ngoquytuan/DenDaChien/2019/catalgue DEN DA CHIEN/2.jpg

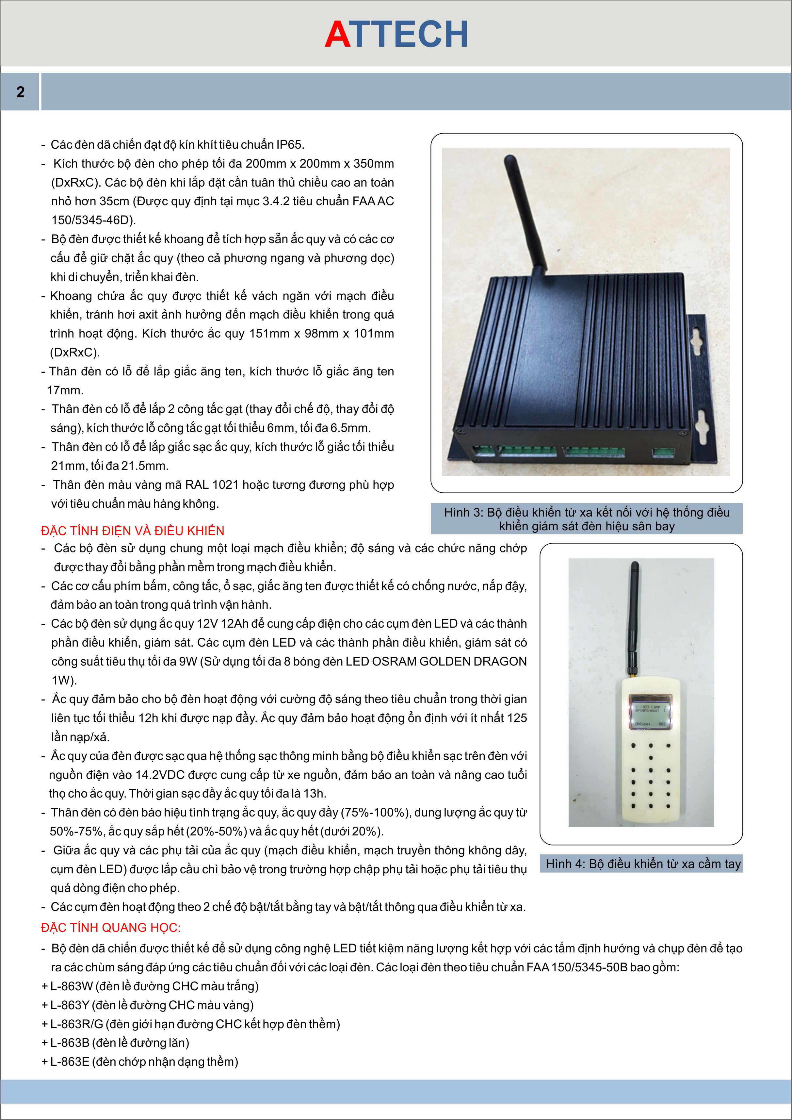
2019/catalgue DEN DA CHIEN/2.jpg
