ngoquytuan/DenDaChien/2019/catalgue DEN DA CHIEN/1.jpg

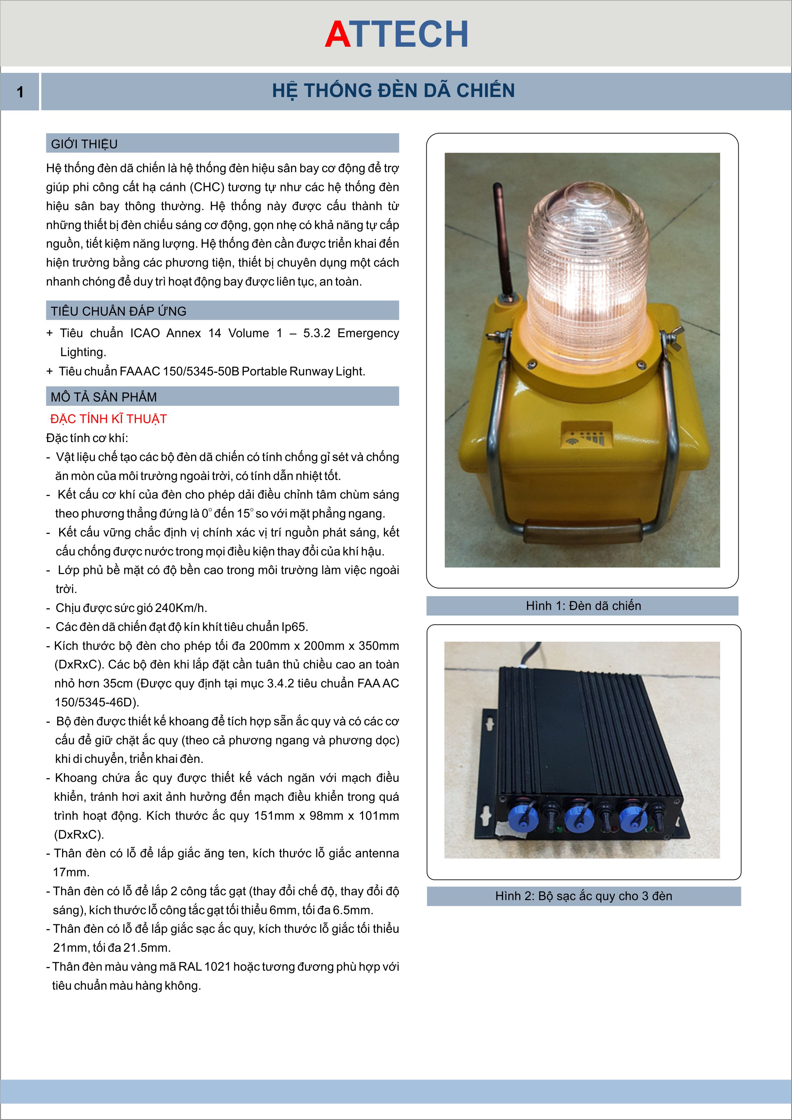
2019/catalgue DEN DA CHIEN/1.jpg
