ngoquytuan/DenDaChien/2019/20May19/BanVeDenDaChien2019 27.03.2019/Co khi/ban ve den da chien, Tien luong/Danh muc ban ve den da chien.docx

STT | Tên bản vẽ cũ | Tên bản vẽ mới | Lý do thay thế | Nội dung thay thế
01 | Đèn CHC (bản vẽ lắp). Mã bản vẽ PL-01-00 | Đèn CHC (bản vẽ lắp). Mã bản vẽ PL-03-00 | Thay đổi phù hợp với điện tử và quang học | Thay đổi chụp kính và điện tử
02 | Đèn CHC (bảng kê). Mã bản vẽ PL-01-00 | Đèn CHC (bảng kê). Mã bản vẽ PL-03-00 | Thay đổi phù hợp với điện tử và quang học | Thay đổi các chi tiết
03 | Tấm đế; gioăng 1; tấm che; bạc. Mã bản vẽ PL-01-01; 03; 09; 11 | Tấm đế; gioăng 1; tấm che; bạc. Mã bản vẽ PL-01-01; PL-01-03; PL-03-12; PL-03-14 | Thay đổi phù hợp với điện tử và cơ khí | Tấm che thay đổi độ dày, bạc thay đổi độ dài phù hợp với tay cầm
04 | Thân. Mã bản vẽ PL-01-02 | Thân. Mã bản vẽ PL-01-02
05 | Nắp. Mã bản vẽ PL-01-04 | Nắp. Mã bản vẽ PL-03-04 | Thay đổi phù hợp với quang học | Thay nắp mới
06 | Mạch báo hiệu. Mã bản vẽ M-01-01 | Mạch báo hiệu. Mã bản vẽ M-01-01
07 | Ống dẫn sáng; Tay cầm; Gioăng 2; Đai kẹp; Bọc tay cầm. . Mã bản vẽ PL-01-05; 06; 07; 10; 12 | Ống dẫn sáng; Tay cầm; Gioăng 2; Đai kẹp; Bọc tay cầm. . Mã bản vẽ PL-03-06; 07; PL-01-05; 13; 16 | Thay đổi phù hợp với quang học và cơ khí | Thay đổi kích thước tay cầm, gioăng 2
08 | Mạch điều khiển. Mã bản vẽ M-02-01 | Mạch điều khiển. Mã bản vẽ M-02-01
09 | | Thân trên. Mã bản vẽ PL-03-08 | Thay đổi phù hợp với quang học và cơ khí | Thiết kế thêm chi tiết thân trên
10 | | Tấm gá. Mã bản vẽ PL-03-09 | Thay đổi phù hợp với điện tử và cơ khí | Thiết kế thêm chi tiết tấm gá
11 | Thân LED; Chân đỡ. Mã bản vẽ M-03-03; PL-01-08 | Thân LED; Chân đỡ. Mã bản vẽ PL-03-11; PL-01-08 | Thay đổi phù hợp với điện tử và quang học | Thiết kế lại chi tiết thân LED
12 | Mạch điều khiển LED. Mã bản vẽ M-03-00 | Mạch điều khiển LED. Mã bản vẽ M-04-00
13 | | Màn che. Mã bản vẽ PL-03-15 | Thay đổi phù hợp với quang học | Thiết kế thêm chi tiết màn che
