ngoquytuan/DenDaChien/2019/20May19/BanVeDenDaChien2019 27.03.2019/Dien tu/PL-LMP-06.pdf

## MẠCH LED ĐƠN -

SƠ ĐỒ NGUYÊN LÝ,

## SƠ ĐỒ MẠCH IN, SƠ ĐỒ LINH KIỆN

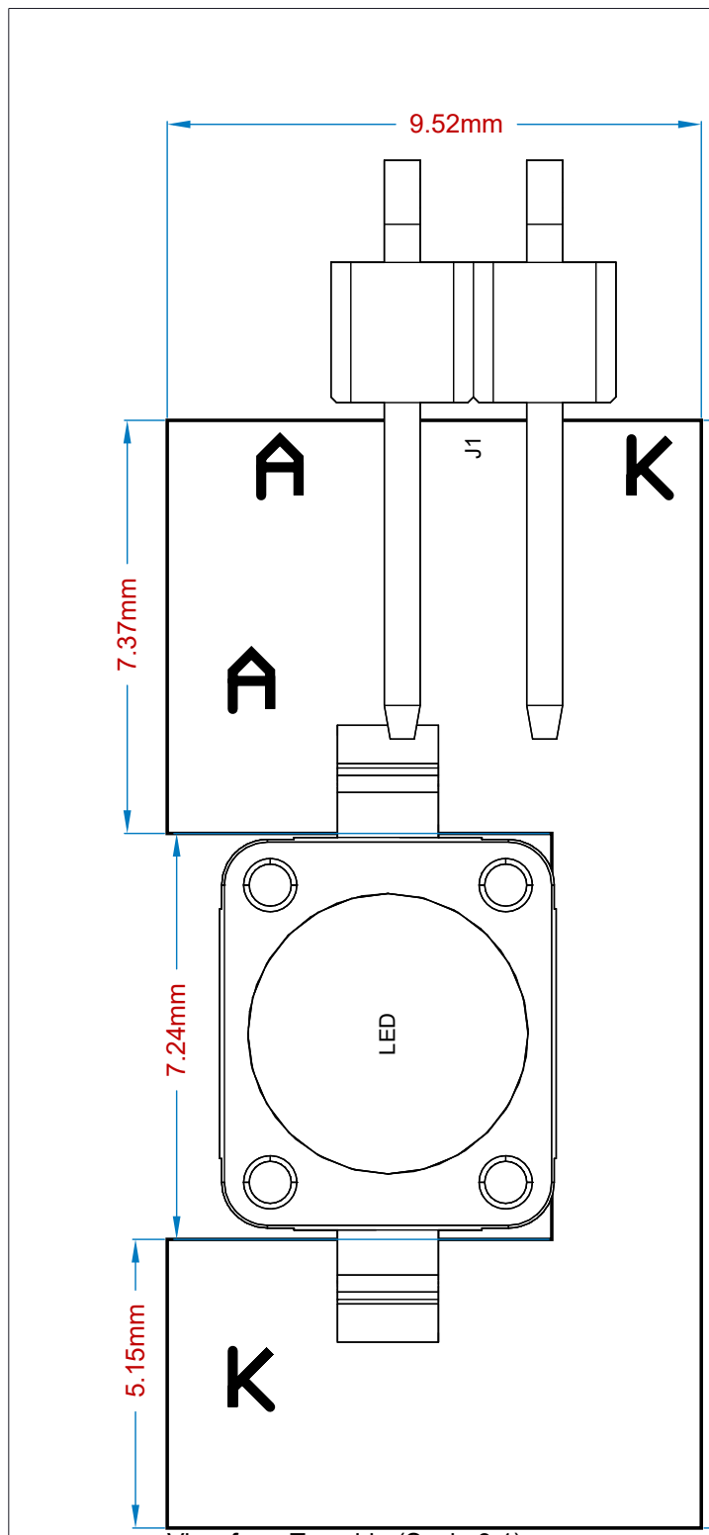
[picture p3: figure]
LED

### View from Top side (Scale 8:1)

### View from Top side (Scale 6)

19.75mm

### 1. Sử dụng phíp thủy tinh loại FR4 1.6mm Mạch in 1 mặt có mạ xuyên lỗ, mạ thiếc, hot air, phủ bảo vệ màu xanh dương (xanh lá, trắng, đen)

2.

### 3. Gia công phay, v-cut chính xác theo các đường bao

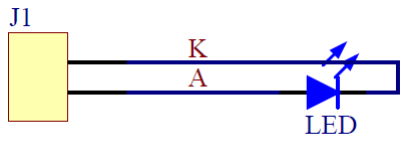
[picture p4: figure]

Màu | Mã LED | Thông tin cơ bản
Đỏ | LR W5SM | Golden DRAGON, red, 1.4 Watt LED, 1000 mA max. current
Trắng ấm | LCW W5SM | Golden DRAGON, warm white, ThinGaN, chip level conversion, 1000 mA max. current
Vàng | LCY W5SM | Golden DRAGON, enhanced thin film LED, yellow (CY), colorless clear silicone
Xanh lá | LT W5SM | Golden DRAGON, true green, 2.0 Watt LED, 1000 mA max. current
Xanh dương | LB W5SM | Golden DRAGON, blue, 2.0 Watt LED, 1000 mA max. current

### Thông tin đèn LED

STT | Ký hiệu linh kiện | Tên gọi, giá trị | Số lượng
1 | J1 | Jump đực loại cong, 2 chân 2.54mm, hàn dán như bản vẽ | 1
2 | LED | LED osram, hàn đúng mã, đúng cực, đáy LED dán silicon truyền nhiệt hoặc bôi keo tản nhiệt | 1

### Linh kiện

### Mạch in (Tỉ lệ 8:1)

### Mạch nguyên lý

| SLSĐ | Họ và tên | Ký | Ngày
Chủ trì | Ngô Quý Tuấn | | | | Số lượng | Khối lượng | Tỷ lệ
Kiểm tra | Ng.Tiến Hùng
Thiết kế | Ngô Quý Tuấn | | | | Tờ số: | Tổng số tờ:
QLKT | Ng.Tiến Hùng | | | Vật liệu: | Công Ty TNHH Kỹ Thuật Quản Lý Bay | | PHÒNG NCPT
Duyệt | Phạm.Q.Tuấn

## PL-LMP-06

Hệ thống Đèn dã chiến
