ngoquytuan/DenDaChien/2019/20May19/TMTK.docx

CÔNG TY TNHH KỸ THUẬT QUẢN LÝ BAY

ATTECH ISO 9001:2015

========= & =========

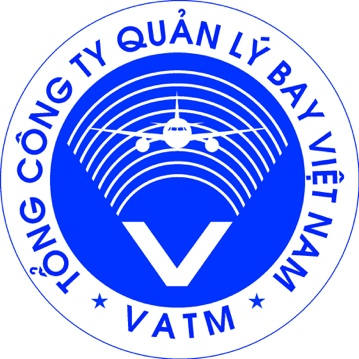
[picture p5: figure]
LOGO QUAN LY BAY MOI

THUYẾT MINH THIẾT KẾ

TÊN SẢN PHẨM: HỆ THỐNG ĐÈN DÃ CHIẾN

MÃ HỒ SƠ : CGCN -

ĐƠN VỊ THIẾT KẾ : PHÒNG NGHIÊN CỨU PHÁT TRIỂN

Hà nội, tháng /2019

CÔNG TY TNHH KỸ THUẬT QUẢN LÝ BAY

ATTECH ISO 9001:2015

========= & =========

THUYẾT MINH THIẾT KẾ

(Ban hành kèm theo Tờ trình số / Ttr- KTCL ngày tháng năm 2019 )

TÊN SẢN PHẨM: HỆ THỐNG ĐÈN DÃ CHIẾN

MÃ HỒ SƠ : CGCN-

ĐƠN VỊ THIẾT KẾ : PHÒNG NGHIÊN CỨU PHÁT TRIỂN

Phê đuyệt | Phòng NCPT | Cán bộ chủ trì

Mục lục

# 1. Căn cứ thiết kế

- Quyết định số 342/QĐ-HĐQLQ ngày 22/07/2016 của Chủ tịch Công ty – Chủ tịch hội đồng Quản lý quỹ về việc phê duyệt báo cáo đề tài nghiên cứu khoa học và công nghệ “ Nghiên cứu, thiết kế hệ thống đèn dã chiến ”.

- Các tài liệu của Hệ thống quản lý chất lượng theo tiêu chuẩn ISO 9001:2015.

- Các tiêu chuẩn kỹ thuật áp dụng:

- Tiêu chuẩn ICAO Annex 14 Volume 1 – 5.3.2 Emergency Lighting.
- Tiêu chuẩn FAA AC 150/5345-50B Portable Runway Light.

- Quyết định số 315/QĐ-CQĐHQ ngày 15/06/2017 về việc phê duyệt hồ sơ thiết kế đề tài “ Nghiên cứu thiết kế chế tạo hệ thống đèn dã chiến ”.

- Quyết định số 181/ QĐ-CQĐHQ ngày 01/03/2018 về việc phê duyệt hồ sơ thiết kế và quy trình sản xuất và hướng dẫn công nghệ chế tạo đề tài “Nghiên cứu thiết kế chế tạo hệ thống đèn dã chiến”.

# 2. Yêu cầu thiết kế

## 2.1 Công năng của sản phẩm

- Hệ thống đèn dã chiến là hệ thống đèn hiệu sân bay cơ động để trợ giúp phi công cất hạ cánh (CHC) tương tự như các hệ thống đèn hiệu sân bay thông thường. Hệ thống đèn hiệu sân bay dã chiến được thiết kế đặc biệt để sử dụng trong các trường hợp sau:

- Hệ thống đèn hiệu sân bay hiện tại không hoạt động do sự cố bất ngờ như thiên tai, sự cố nghiêm trọng với nhà nguồn, bảo dưỡng hệ thống chính…Hệ thống đèn hiệu dã chiến sẽ được triển khai để dự phòng cho hệ thống đèn hiệu chính giúp các phi công hạ cánh an toàn.
- Sử dụng trong các tình huống tác chiến chiến thuật, tìm kiếm, cứu nạn của quân đội để triển khai sân bay dã chiến trợ giúp phi công hạ cánh.

- Hệ thống đèn dã chiến bao gồm các thành phần phục vụ công tác cất hạ cánh cho tàu bay, thông thường, hệ thống này được cấu thành từ những thiết bị đèn chiếu sáng cơ động, gọn nhẹ có khả năng tự cấp nguồn, tiết kiệm năng lượng. Hệ thống đèn cần được triển khai đến hiện trường bằng các phương tiện, thiết bị chuyên dụng một cách nhanh chóng để duy trì hoạt động bay được liên tục, an toàn.

## 2.2 Yêu cầu về lắp đặt khai thác

- Hệ thống đèn dã chiến được thiết kế đơn giản, gọn nhẹ, thuận tiện cho quá trình triển khai, bảo trì, bảo dưỡng, sửa chữa, thời gian khôi phục hệ thống sau sự cố nhanh.

- Đèn dã chiến được vận chuyển và triển khai bởi xe nguồn để đảm bảo tính thuận tiện, nhanh chóng. Xe nguồn được thiết kế các cơ cấu để giữ chặt đèn khi sạc cũng như khi di chuyển. Xe nguồn được thiết kế các cơ cấu để có thể di chuyển bằng cách kéo bởi phương tiện khác hoặc người với vận tốc tối đa 30 Km/h.

- Các bộ đèn khi lắp đặt cần tuân thủ chiều cao an toàn nhỏ hơn 35cm (Được quy định tại mục 3.4.2 tiêu chuẩn FAA AC 150/5345-46D).

- Hệ thống đèn dã chiến được thiết kế để triển khai tại hiện trường và hoạt động trong các điều kiện sau:

- Nhiệt độ môi trường từ 0oC đến 55oC
- Độ ẩm môi trường đến 100% RH
- Chịu được sức gió 240km/h
- Tiêu chuẩn kín khít IP65
- Chịu được các điều kiện thời tiết bình thường, bức xạ mặt trời, sương muối dưới áp suất khí quyển, gió bụi, cát.

- Các thành phần điều khiển đèn dã chiến, điều khiển sạc, điều khiển từ xa có độ tin cậy cao, độ bền cao, đáp ứng nhanh đảm bảo hoạt động ổn định liên tục trong thời gian dài.

- Hệ thống đèn dã chiến được thiết kế có tính linh hoạt cao, có thể triển khai lắp đặt cho các sân bay với mô hình khác nhau.

## 2.3 Yêu cầu về công nghệ chế tạo sản phẩm

- Các vật liệu chế tạo cho hệ thống đèn dã chiến là các vật liệu tiêu chuẩn, có sẵn trên thị trường, phù hợp với các chỉ tiêu kinh tế kỹ thuật của sản phẩm, đảm bảo chi phí đã được phê duyệt.

- Hệ thống đèn dã chiến được thiết kế trên cơ sở ứng dụng các công nghệ mới, hiện đại nhất, phù hợp điều kiện sản xuất trong nước, kế thừa và tận dụng tối đa các chi tiết đã được thiết kế chế tạo cho các sản phẩm đèn hiệu sân bay hiện có của Công ty.

- Kết cấu khung vỏ đèn dã chiến và kết cấu xe nguồn đảm bảo độ cứng vững, an toàn trong suốt quá trình lắp đặt, khai thác và vận hành.

- Các vật tư lắp đặt để liên kết các chi tiết với nhau phải sử dụng các vật tư tiêu chuẩn như: gioăng cao su, bu lông, đệm phẳng, đai ốc, vít.

# 3. Các thông số và đặc tính của sản phẩm

## 3.1 Tiêu chuẩn áp dụng

- Tiêu chuẩn ICAO Annex 14 Volume 1 – 5.3.2 Emergency Lighting.

- Tiêu chuẩn FAA AC 150/5345-50B Portable Runway Light.

## 3.2 Các đặc tính của sản phẩm

- Hệ thống đèn dã chiến được chia thành hai phần riêng biệt bao gồm:

- Các bộ đèn dã chiến:
  - Phân hệ đèn CHC màu trắng và đèn CHC màu vàng
  - Phân hệ đèn lề đường lăn
  - Phân hệ đèn giới hạn đường CHC kết hợp đèn thềm
  - Phân hệ đèn chớp nhận dạng thềm
  - Thiết bị điều khiển từ xa cầm tay và thiết bị điều khiển từ xa kết nối với hệ thống điều khiển
- Xe nguồn phục vụ triển khai hệ thống trong khu bay, đồng thời có các bộ sạc với chức năng nạp điện cho các đèn

## 3.2.1 Đặc tính kĩ thuật của các bộ đèn dã chiến:

- Đặc tính cơ khí:

- Các bộ đèn dã chiến được thiết kế với vật liệu, kích thước, hình dáng thân đèn, cơ cấu gá lắp chụp đèn như nhau. Trong đó, các cơ cấu gá lắp chụp đèn được sử dụng từ vật tư sẵn có của sản phẩm đèn hiệu chế tạo bởi Công ty TNHH kỹ thuật Quản lý bay. Riêng đối với phần chụp kính, tập trung ánh sáng, lọc màu sẽ được sử dụng vật tư có sẵn tương ứng với các phân hệ đèn khác nhau (Xem kí mã hiệu chi tiết của các vật tư này trong hồ sơ bản vẽ thiết kế).

- Vật liệu chế tạo các bộ đèn dã chiến có tính chống gỉ sét và chống ăn mòn của môi trường ngoài trời, có tính dẫn nhiệt tốt.

- Kết cấu cơ khí của đèn cho phép dải điều chỉnh tâm chùm sáng theo phương thẳng đứng là 0o đến 15o so với mặt phẳng ngang.

- Kết cấu vững chắc định vị chính xác vị trí nguồn phát sáng, kết cấu chống được nước trong mọi điều kiện thay đổi của khí hậu.

- Lớp phủ bề mặt có độ bền cao trong môi trường làm việc ngoài trời.

- Chịu được sức gió 240Km/h.

- Các đèn dã chiến đạt độ kín khít tiêu chuẩn IP65.

- Kích thước bộ đèn cho phép tối đa 200mm x 200mm x 350mm (DxRxC). Các bộ đèn khi lắp đặt cần tuân thủ chiều cao an toàn nhỏ hơn 35cm (Được quy định tại mục 3.4.2 tiêu chuẩn FAA AC 150/5345-46D).

- Bộ đèn được thiết kế khoang để tích hợp sẵn ắc quy và có các cơ cấu để giữ chặt ắc quy (theo cả phương ngang và phương dọc) khi di chuyển, triển khai đèn.

- Khoang chứa ắc quy được thiết kế vách ngăn với mạch điều khiển, tránh hơi axit ảnh hưởng đến mạch điều khiển trong quá trình hoạt động. Kích thước ắc quy 151mm x 98mm x 101mm (DxRxC).

- Thân đèn có lỗ để lắp giắc antenna, kích thước lỗ giắc antenna tối thiểu 16mm, tối đa 17mm.

- Thân đèn có lỗ để lắp 2 công tắc gạt (thay đổi chế độ, thay đổi độ sáng), kích thước lỗ công tắc gạt tối thiểu 6mm, tối đa 6.5mm.

- Thân đèn có lỗ để lắp giắc sạc ắc quy, kích thước lỗ giắc tối thiểu 21mm, tối đa 21.5mm.

- Thân đèn màu vàng mã RAL 1021 hoặc tương đương phù hợp với tiêu

chuẩn màu hàng không.

- Đặc tính điện và điều khiển:

- Các bộ đèn sử dụng chung một loại mạch điều khiển; độ sáng và các chức năng chớp được thay đổi bằng phần mềm trong mạch điều khiển.

- Thân đèn được thiết kế vị trí gá lắp mạch điều khiển. Mạch điều khiển được cố định bằng các ốc tiêu chuẩn.

- Các cơ cấu phím bấm, công tắc, ổ sạc, giắc antenna được thiết kế có chống nước, nắp đậy, đảm bảo an toàn trong quá trình vận hành.

- Các bộ đèn sử dụng ắc quy 12V 12Ah để cung cấp điện cho các cụm đèn LED và các thành phần điều khiển, giám sát. Các cụm đèn LED và các thành phần điều khiển, giám sát có công suất tiêu thụ tối đa 9W (Sử dụng tối đa 8 bóng đèn LED OSRAM GOLDEN DRAGON 1W – Xem chi tiết phần thiết kế quang học cụm đèn LED).

- Ắc quy đảm bảo cho bộ đèn hoạt động với cường độ sáng theo tiêu chuẩn trong thời gian liên tục tối thiểu 12h khi được nạp đầy (Theo FAA AC 150/5345-50B mục 3.4.2.a). Ắc quy đảm bảo hoạt động ổn định với ít nhất 125 lần nạp/xả (Theo FAA AC 150/5345-50B mục 3.4.2.b).

- Ắc quy của đèn được sạc qua hệ thống sạc thông minh bằng bộ điều khiển sạc trên đèn với nguồn điện vào 14.2VDC được cung cấp từ xe nguồn, đảm bảo an toàn và nâng cao tuổi thọ cho ắc quy. Thời gian sạc đầy ắc quy tối đa là 13h (Theo FAA AC 150/5345-50B mục 3.4.2.1).

- Thân đèn có đèn báo hiệu tình trạng ắc quy, ắc quy đầy (75%-100%), dung lượng ắc quy từ 50%-75%, ắc quy sắp hết (20%-50%) và ắc quy hết (dưới 20%).

- 100% ắc quy: sáng 4 đèn
- 75% ắc quy: sáng 3 đèn
- 50% ắc quy: sáng 2 đèn
- 20% ắc quy: 1 đèn nhấp nháy

- Giữa ắc quy và các phụ tải của ắc quy (mạch điều khiển, mạch truyền thông không dây, cụm đèn LED) được lắp cầu chì bảo vệ trong trường hợp chập phụ tải hoặc phụ tải tiêu thụ quá dòng điện cho phép (Xem chi tiết vị trí lắp đặt cầu chì (kí hiệu 24) trong bản vẽ lắp của đèn dã chiến).

- Các cụm đèn hoạt động theo 2 chế độ bật/tắt bằng tay và bật/tắt thông qua điều khiển từ xa:

- Chế độ bằng tay (LOCAL) sử dụng các công tắc cơ học trên thân đèn giúp bật/tắt và thay đổi cường độ sáng.
- Chế độ điều khiển từ xa qua sóng vô tuyến (REMOTE) sử dụng bộ điều khiển từ xa cầm tay hoặc bộ điều khiển kết nối đến hệ thống điều khiển (ALCS) để bật/tắt và thay đổi cường độ sáng trên phạm vi bán kính quanh sân bay 3km trong điều kiện tầm nhìn thẳng.

- Các bộ điều khiển từ xa sử dụng sóng vô tuyến đều tuân thủ Luật tần số vô tuyến điện số 42/2009/QH12 và các văn bản hướng dẫn quy định về sử dụng sóng vô tuyến trong điều khiển hệ thống chiếu sáng đèn hiệu sân bay.

- Hệ thống đèn dã chiến sử dụng mô hình truyền thông không dây của đề tài “Nghiên cứu chế tạo bộ nguồn năng lượng mặt trời và bộ truyền thông không dây để ứng dụng cho các sản phẩm đèn hiệu sân bay của công ty”.

- Đặc tính quang học:

- Bộ đèn dã chiến được thiết kế để sử dụng công nghệ LED tiết kiệm năng lượng kết hợp với các tấm định hướng và chụp đèn để tạo ra các chùm sáng đáp ứng các tiêu chuẩn đối với các loại đèn. Các loại đèn theo tiêu chuẩn FAA 150/5345-50B bao gồm:

- L-863W (đèn lề đường CHC màu trắng)
- L-863Y (đèn lề đường CHC màu vàng)
- L-863R/G (đèn giới hạn đường CHC kết hợp đèn thềm)
- L-863B (đèn lề đường lăn)
- L-863E (đèn chớp nhận dạng thềm)

- Bộ đèn phát ra ánh sáng “White”, “Green”, “Yellow”, “Red”, “Blue” theo phương nằm ngang theo góc quay 360o và phương dọc từ góc 0o đến 15o.

- Đặc tính chiếu sáng phù hợp với tiêu chuẩn FAA AC 150/5345-50B (Tham chiếu tại mục 3.3.1 tài liệu AC No: 150/5345-50B đối với loại L-863), đặc tính màu sắc phù hợp với tiêu chuẩn ICAO Annex 14, Volume 1.

- Cường độ tối thiểu theo FAA AC 150/5345-50B 3.3.1 đối với các loại đèn L-863 theo bảng sau (Chú ý: Góc được đo theo chiều dọc):

Loại đèn | Màu sắc | Cường độ sáng tối thiểu (candela) 0-6o | Cường độ sáng tối thiểu (candela) 6-9o | Cường độ sáng tối thiểu (candela) 9-14o
L863 (ngoại trừ L863E) | White | 20 | 10 | 2
| Yellow | 6.2 | 3.1 | 0.62
| Green | 6.2 | 3.1 | 0.62
| Red | 1.8 | 0.9 | 0.18
| Blue | 1.4 | 0.7 | 0.14

Bảng 1: Cường độ chiếu sáng tối thiểu quy định cho các loại đèn L863

- Các bộ đèn có 3 mức sáng, mức sáng nhỏ nhất đáp ứng tiêu chuẩn FAA về cường độ sáng theo mô tả ở bảng 1.

- Đối với loại đèn L-863E phát ra ánh sáng màu trắng với chùm sáng có góc 10o đến 30o theo phương ngang với đèn một hướng hoặc 360o theo phương ngang với đèn đa hướng. Cường độ sáng tối thiểu cần đạt 20cd. Tốc độ chớp đạt từ 60 đến 80 lần mỗi phút (Được quy định tại FAA AC 150/5345-50B mục 3.3.2).

- Các bộ đèn sử dụng bóng đèn có tuổi thọ tối thiểu 1000 giờ (đối với các loại đèn L-863W, L-863W/Y, L-863R/G, L-863Y, L-863R, L-863G, L-863B) và tối thiểu 1500 giờ (đối với loại đèn L-863E hoạt động với tốc độ chớp 60 đến 80 lần mỗi phút), trong điều kiện các đèn đều hoạt động tại điện áp, dòng điện định mức với cường độ sáng vẫn đáp ứng theo các tiêu chuẩn đã nêu trong Bảng 1.

## 3.2.2 Đặc tính kĩ thuật của xe nguồn:

- Đặc tính cơ khí:

- Kết cấu xe nguồn được thiết kế để lắp đặt đơn giản thuận tiện cho quá trình bảo trì, bảo dưỡng, sửa chữa.

- Xe nguồn có khả năng vận chuyển và triển khai được 60 đèn dã chiến, được phân bố đều ở cả hai bên thân xe, mỗi bên chứa 30 đèn được chia làm 3 dãy, mỗi dãy 10 đèn, các đèn được bố trí theo bậc thang.

- Xe nguồn được thiết kế kết cấu cơ khí để đảm bảo tải trọng phù hợp, tối thiểu 1500Kg, đảm bảo vận chuyển đầy đủ 60 đèn dã chiến và các thiết bị phụ trợ đi kèm.

- Bên trong xe nguồn thiết kế các hốc chứa đèn phù hợp với kích thước tối đa của đèn (DxRxC: 200mm x 200mm x 250mm), đảm bảo vững chắc không bị rơi đèn khi xe di chuyển ở vận tốc tối đa 30 Km/h.

- Trên xe nguồn được thiết kế vị trí để gắn 20 bộ sạc ắc quy, mỗi bộ có nhiệm vụ sạc điện cho 3 bộ đèn, các bộ sạc được cố định vào thân xe nguồn bằng các ốc, vít tiêu chuẩn. Kích thước cho 1 bộ sạc tối thiểu 150mm x 87mm x 33mm (DxRxC). Các đèn dã chiến được nối cáp đến các bộ sạc, vị trí lắp các bộ sạc được thiết kế với khoảng cách đến đèn gần nhất.

- Trên xe nguồn thiết kế các hộp kĩ thuật để đặt cáp sạc đèn và tủ điện phân phối đến các bộ sạc ắc quy. Các máng đi dây, hốc, dây cáp được thiết kế đảm bảo tiêu chuẩn an toàn khi sử dụng với điện nguồn 220VAC, 50/60 Hz.

- Trên xe nguồn bố trí các ổ điện đầu vào để lấy nguồn điện 220VAC, 50/60Hz từ bên ngoài cấp vào tủ điện phân phối, từ đó cung cấp điện đến các bộ sạc ắc quy.

- Xe nguồn được trang bị hệ thống giảm xóc để đảm bảo an toàn cho người và thiết bị trên xe trong quá trình di chuyển, triển khai hệ thống tại sân bay.

- Hệ thống di chuyển của xe nguồn là 02 bánh lốp đặt dưới thùng xe (kích thước bánh lốp được lựa chọn, thiết kế phù hợp với tải trọng và tốc độ di chuyển tối đa của xe nguồn), xe nguồn có hệ thống càng (để móc kéo) kết hợp với bánh phụ và phanh tay để cố định xe khi triển khai lắp đặt hệ thống đèn dã chiến tại hiện trường.

- Kích thước xe nguồn phù hợp với các thiết bị lắp trên xe, xe nguồn có thiết kế dạng thùng, kích thước tối đa (DxRxC) 3m x 1.8m x 1.5m (chưa bao gồm càng xe). Chiều cao xe nguồn cũng được thiết kế để đảm bảo phù hợp với chiều cao trung bình của người Việt Nam, đảm bảo khoảng cách để người khai thác lấy đèn trong quá trình triển khai hệ thống.

- Màu sơn của xe nguồn sử dụng các màu sắc phù hợp với tiêu chuẩn hàng không, tương đương mẫu màu RAL 1021.

- Đặc tính điện:

- Xe nguồn thiết kế vị trí lắp đặt tủ điện phân phối điện từ đầu vào đến các đầu ra là các bộ sạc ắc quy. Tủ điện phân phối được lắp đặt attomat tổng và qua các cầu chì (được gắn vào các đế có khả năng cách ly khi cần thiết) phân phối điện đến các bộ sạc ắc quy. Trong các trường hợp một vài bộ sặc ắc quy bị hỏng chỉ cần cách ly cầu chì để sửa chữa mà không làm ảnh hưởng đến hoạt động của các bộ sạc ắc quy khác.

- Tủ điện phân phối được thiết kế để cấp nguồn 220VAC, 50/60Hz cho các bộ sạc, vị trí lắp đặt, dây cáp dẫn điện được thiết kế đảm bảo an toàn cho xe và người sử dụng.

- Xe nguồn cần thiết kế vị trí để đặt được tối thiểu 20 bộ sạc cho đèn, mỗi bộ sạc được cấp nguồn 220VAC từ tủ phân phối và sạc cho 3 đèn cùng lúc. Mỗi bộ sạc được thiết kế bao gồm 3 bộ nguồn 14.2 VDC, dòng điện tối đa 1.5A để sạc điện cho ắc quy trong các bộ đèn.

- Xe nguồn được trang bị các đèn báo phía sau và hai bên thân xe để nhận diện vào cảnh báo nguy hiểm trong quá trình di chuyển, triển khai hệ thống đèn dã chiến. Các đèn báo này được cấp nguồn bằng ắc quy lắp trong tủ điện phân phối trên xe.

# 4. Giải pháp thiết kế

## 4.1 Lựa chọn giải pháp công nghệ

- Hệ thống đèn dã chiến được chế tạo bằng các công nghệ gia công CNC nhằm đảm bảo độ chính xác cao, tính thẩm mỹ cũng như độ bền của sản phẩm.

- Hệ thống đèn dã chiến được thiết kế chế tạo trên cơ sở tích hợp các module chức năng (Được thiết kế chế tạo độc lập) thành một sản phẩm hoàn chỉnh. Các module chức năng chính của hệ thống bao gồm:

- Module điện, điện tử và các thành phần phụ trợ:
    - Cụm đèn sử dụng công nghệ LED tiết kiệm năng lượng.
    - Bộ điều khiển đèn sử dụng công nghệ vi xử lý.
    - Bộ điều khiển sạc ắc quy sử dụng công nghệ nguồn switching hiệu suất cao.
    - Bộ điều khiển từ xa cầm tay và bộ kết nối hệ thống điều khiển xa sử dụng công nghệ truyền thông không dây RF.
- Thân đèn sử dụng công nghệ phay CNC.
- Chụp đèn sử dụng các cơ cấu gá và chụp kính của hệ thống đèn hiệu hiện có chế tạo bởi Công ty TNHH kỹ thuật Quản lý bay.
    - Đối với các loại đèn CHC trắng – trắng, đèn CHC trắng – vàng, đèn giới hạn kết hợp đèn thềm, đèn chớp nhận dạng thềm sử dụng các cơ cấu gá, chụp kính của đèn lề đường CHC hai hướng lắp nổi.
    - Đối với đèn lề đường lăn sử dụng các cơ cấu gá của đèn lề đường CHC hai hướng lắp nổi, riêng đối với chụp kính sử dụng của đèn lề đường lăn lắp nổi màu xanh blue.
- Xe nguồn phục vụ triển khai hệ thống sử dụng các công nghệ phay CNC các chi tiết phi kim loại và các vật tư tiêu chuẩn hiện có trên thị trường.

## 4.2 Giải pháp thiết kế

## 4.2.1 Giải pháp thiết kế các bộ đèn dã chiến:

- Giải pháp thiết kế phần cơ khí:

- Trên cơ sở tham khảo một số kết cấu đèn dã chiến của các hãng sản xuất như Metalite, Holland Aviation, YouYang… để lựa chọn thiết kế kết cấu thân đèn, chụp đèn cho đèn dã chiến. Cụ thể một số kết cấu được thiết kế như sau:

- Thân đèn có kết cấu hình chóp 4 mặt được thiết kế gân tăng cứng và các vách định vị cố định ắc quy. Mặt trên có bậc lắp tấm che tránh hơi axit bốc lên ảnh hưởng tới mạch điều khiển.
- Gia công phay CNC trong trường hợp sản xuất số lượng nhỏ, sản phẩm mẫu, sản phẩm thử nghiệm.
- Thân đèn được lắp kín khít với nắp đèn bằng các vít M4x16, giữa thân và nắp đèn có gioăng cao su làm kín.
- Nắp đèn được thiết kế phù hợp với công nghệ phay CNC, trên nắp đèn được thiết kế các vị trí bắt mạch điều khiển, antenna, các công tắc gạt và giắc sạc. Trên nắp đèn có vị trí lắp tay cầm đảm bảo thao tác thuận tiện.
- Chụp đèn được thiết kế với các cơ cấu gá lắp phụ để sử dụng các chi tiết hiện có của các loại đèn hiệu sẵn có do Công ty TNHH Kỹ thuật Quản lý bay sản xuất, mặt lắp chụp đèn với nắp đèn có rãnh gắn gioăng làm kín.
- Tay cầm được chấn uốn bằng thép không gỉ để đảm bảo độ bền cũng như tính thẩm mỹ cho sản phẩm, có vị trí lắp vào nắp đèn.

- Thân đèn màu vàng mã RAL 1021 hoặc tương đương phù hợp với tiêu chuẩn màu hàng không.

- Đèn dã chiến trong quá trình khai thác chịu tải trọng gió với tốc độ lên đến 240km/h gây ra khả năng trượt và lật quanh cạnh đèn. Do đó, để đảm bảo an toàn trong quá trình khai thác cần thực hiện tính toán chống trượt, lật cho đèn.

a. Tính toán khả năng lật của đèn:

- Đặt vấn đề:

- Đèn trong quá trình làm việc chịu tác dụng của gió bão với tốc độ gió cao, kết cấu đèn có dạng hộp, lực tác dụng vào thành hộp sẽ làm lật đèn nên mô hình bài toán có dạng vật rắn lật như hình 1.

Hình 1: Mô hình tính toán bài toán lật cho đèn

- Lực tác dụng lên đèn trong quá trình khai thác chủ yếu là áp lực gió tại khu vực, hướng và phương của lực tác dụng lên mỗi bề mặt của đèn là khác nhau và trị số chênh lệch là rất lớn, do đó để tính toán kiểm tra lật cho từng vị trí rất phức tạp, vì vậy dưới đây chọn mô hình tính toán với điều kiện nguy hiểm nhất.
- Lực tác dụng lên mặt đèn chính là lực tác dụng lên mặt phẳng vuông góc với mặt đáy (gọi là mặt phẳng C) là nguy hiểm nhất nên việc tính toán ta tập trung tính toán khả năng vật lật tại mặt này. Ta có phương của lực tác dụng vuông góc với mặt phẳng (C), chiều của lực hướng vào bề mặt đó, điểm đặt lực là trọng tâm của vật (điểm B).

- Nội dung tính toán:

- Theo sách giáo trình Cơ học tập 1 của GS.TSKH. Đỗ Sanh (chủ biên) Tĩnh học và động học nhà xuất bản giáo dục năm 2005.
- Điều kiện cân bằng của vật rắn là:

>

Trong đó: : Momen giữ

: Momen lật

- Đèn chịu tác dụng của các lực sau: Lực gió làm lật đèn Fgió ; Trọng lực giữ đèn không lật P
- Công thức mômen giữ là:

= P x R

Trong đó: P: Trọng lực của vật (N)

R: Khoảng cách từ trọng tâm (điểm B) của vật đến điểm lật (điểm A) (m)

- Ta có:

P = m x g

Trong đó: m: Khối lượng của vật (Kg)

g: gia tốc trọng trường (m/s²); g =10 m/s²

- Sử dụng phần mềm Solidwork để đo cân nặng; các kích thước L và R của đèn.

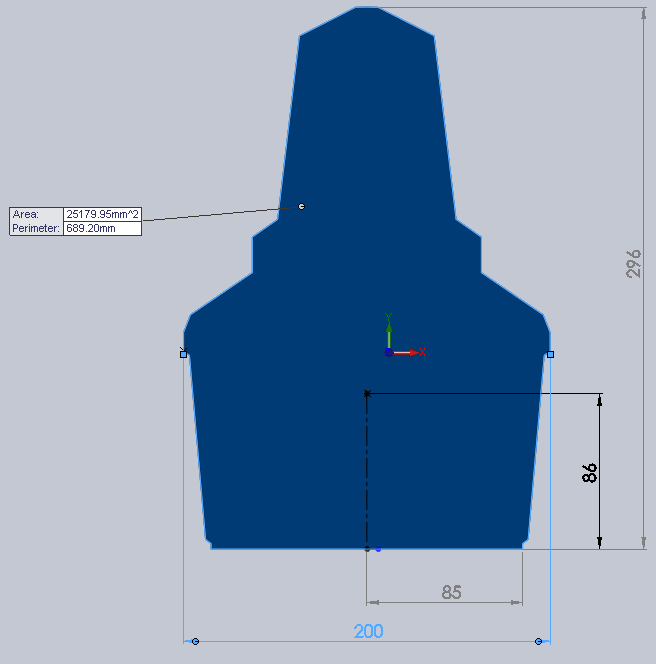
[picture p6: figure]

Hình 2: Tọa độ trọng tâm và điểm lật của đèn

- Ta có:

m = 7.5kg; R = 85mm = 0.085m; L = 86mm = 0.086m; S=0.025m²

- Từ đó suy ra:

= P x R = m x g x R = 7.5 x 10 x 0.085 = 6.375 (N.m)

- Công thức mômen lật là:

= F x L

Trong đó: F: Lực gió (N)

L: Khoảng cách từ trọng tâm (điểm B) của vật đến điểm lật (điểm A) (m)

- Tra bảng với sức gió 240 (km/h)

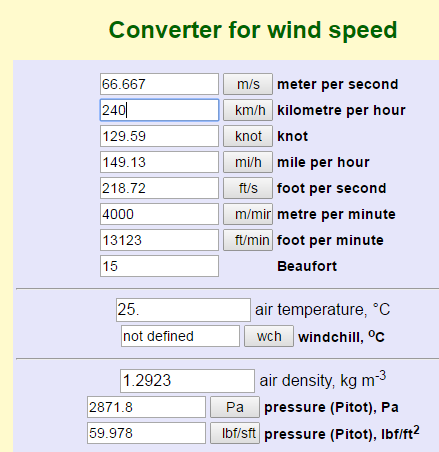
[picture p7: figure]
Anh toc do gio

Hình 3: Bảng thông số sức gió 240km/h

- Ta có:

Pgió = 2871.8 (Pa) = 2871.8 (N/m²)

- Từ đó suy ra:

Fgió = Pgió x S = 2871.8 x 0.025 = 71.80 (N)

- Từ đó suy ra:

= Fgió x L = 71.80 x 0.086 = 6.18 (N.m)

- Ta thấy:

= 6.375 (N.m) > = 6.18 (N.m)

- Kết luận:

- Đèn không bị lật dưới tải trọng gió trong điều kiện khai thác.

b. Tính toán khả năng trượt của đèn:

- Đặt vấn đề:

- Đèn trong quá trình làm việc chịu tác dụng của gió bão với tốc độ gió cao, kết cấu đèn có dạng hộp, lực tác dụng vào thành hộp sẽ làm đèn trượt nên mô hình bài toán có dạng vật rắn trượt như hình 4.

Hình 4: Mô hình tính toán bài toán trượt cho đèn

- Lực tác dụng lên đèn trong quá trình khai thác chủ yếu là áp lực gió tại khu vực, hướng và phương của lực tác dụng lên mỗi bề mặt của đèn là khác nhau và trị số chênh lệch là rất lớn, do đó để tính toán kiểm tra trượt cho từng vị trí rất phức tạp, vì vậy dưới đây chọn mô hình tính toán với điều kiện nguy hiểm nhất.
- Lực tác dụng lên mặt đèn chính là lực tác dụng lên mặt phẳng vuông góc với mặt đáy (gọi là mặt phẳng C) là nguy hiểm nhất. Do đó, việc tính toán tập trung tính toán khả năng vật trượt khi lực gió tác động tại mặt này. Ta có phương của lực tác dụng vuông góc với mặt phẳng (C), chiều của lực hướng vào bề mặt đó, điểm đặt lực là trọng tâm của vật (điểm B).

- Nội dung tính toán:

- Đèn trong quá trình khai thác sử dụng chịu tác dụng của gió tốc độ 240km/h. Điều kiện để đèn không bị trượt khi Fms ≥ Fgió
- Trong đó:

Fms: là lực ma sát giữa đế đèn và mặt sàn (N)

Fgió: là Lực gió làm trượt đèn (N); Fgió = 86.1 (N)

- Ta có:

Fms = P x k

- Trong đó:

P: Trọng lực của vật (N)

k: hệ số ma sát giữa vật và mặt sàn; lấy k=0.9

- Ta có:

Fms = P x k = m x g x k = 10 x 10 x 0.9 = 90 (N)

- Kết luận:

- Ta thấy, Fms = 90 (N) > Fgió = 86.1 (N) nên đèn không bị trượt dưới tác động của gió trong điều kiện khai thác.
- Giải pháp thiết kế phần điện và điều khiển:

- Hệ thống điện và điều khiển đèn dã chiến bao gồm các mạch điện với các chức năng riêng biệt được kết nối với nhau và kết nối với các thành phần điều khiển ngoại vi thông qua các chuẩn truyền thông nối tiếp, song song phổ biến.

- Phần điện của mỗi đèn dã chiến được tích hợp từ: Mạch điều khiển đèn dã chiến, mạch truyền thông không dây, mạch cụm đèn LED.

- Các thành phần phụ trợ hỗ trợ điều khiển và giám sát từ xa, triển khai hệ thống đèn dã chiến bao gồm:

+ Bộ điều khiển từ xa cầm tay được cấu thành từ: 01 mạch điều khiển từ xa cầm tay và 01 mạch truyền thông không dây.

+ Bộ kết nối với hệ thống điều khiển đèn hiệu được tích hợp từ: 01 mạch kết nối hệ thống điều khiển xa, 01 mạch truyền thông không dây và 01 mạch cấp nguồn AC-DC 14.2V/1.5A.

+ Bộ sạc ắc quy lắp đặt tại xe nguồn được tích hợp từ: 03 mạch giám sát trạng thái sạc ắc quy, 03 mạch cấp nguồn AC-DC 14.2V/1.5A.

- Hệ thống đèn dã chiến và các thành phần phụ trợ được kết nối, truyền thông, điều khiển, giám sát theo sơ đồ khối dưới đây:

Đèn dã chiến

Hệ thống điều khiển xa

Mạch điều khiển đèn dã chiến

Bộ kết nối hệ thống điều khiển xa tích hợp bộ thu phát RF

Bộ điều khiển từ xa cầm tay tích hợp bộ thu phát RF

Xe nguồn

Đèn CHC trắng – trắng

Đèn CHC trắng – vàng

Đèn Taxiway

Đèn giới hạn kết hợp thềm

Đèn chớp nhận dạng thềm

Bộ sạc ắc quy lắp trên xe nguồn

Bộ thu phát RF

Hình 5: Sơ đồ khối tổng thể hệ thống đèn dã chiến

- Giải pháp thiết kế các mạch điện và các thành phần điều khiển được thể hiện chi tiết trong các mục dưới đây:

a) Mạch điều khiển đèn dã chiến:

Vi xử lý trung tâm

ATMEL

Ắc quy 12V

Bộ biến đổi điện áp 5V, 3V3

Module truyền thông không dây RF

Bộ bảo vệ điện áp

Bộ giám sát điện áp, dòng điện

Cụm đèn LED

Điều khiển PWM

Giao diện sử dụng: nút bấm, LED báo

Hình 6: Sơ đồ khối mạch điều khiển đèn dã chiến

* Chức năng:

- Mạch điều khiển đèn được thiết kế để thực hiện các chức năng sau:

- Lựa chọn chế độ hoạt động của đèn: bật/tắt bằng điều khiển tại chỗ (LOCAL) hoặc bật/tắt bằng điều khiển từ xa (REMOTE) bằng cách sử dụng công tắc chuyển mạch 3 trạng thái LOCAL/OFF/REMOTE.
- Thay đổi các mức sáng của đèn trong chế độ điều khiển tại chỗ: thấp (LOW), trung bình (MED), cao (HIGH) bằng cách sử dụng công tắc chuyển mạch 3 trạng thái LOW/MID/HIGH.

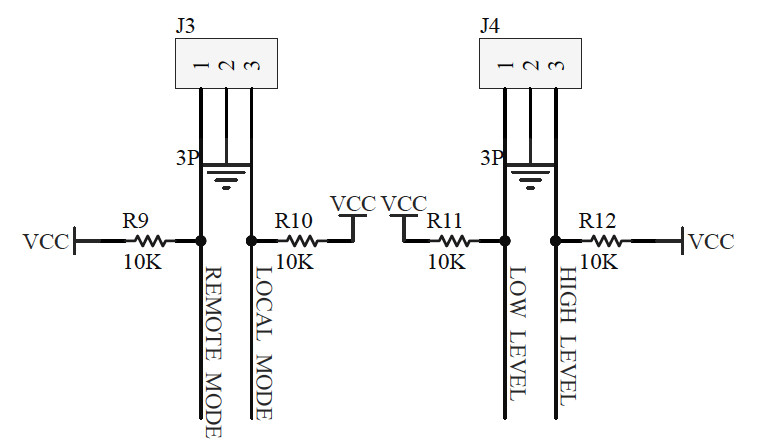
[picture p8: figure]

Hình 7: Công tắc chuyển mạch chế độ hoạt động và mức sáng

- Độ sáng của cụm đèn được điều khiển PWM bằng MOSFET cấp nguồn đến cụm đèn.
- Điều khiển sạc ắc quy, giám sát trạng thái sạc ắc quy, tự ngắt khi ắc quy đầy, bảo vệ quá điện áp và dòng nạp ắc quy sử dụng rơ le chuyển mạch.
- Hiển thị các trạng thái hoạt động, trạng thái sạc ắc quy, dung lượng ắc quy còn lại bằng cách sử dụng các đèn LED:
  - Đèn LED xanh dương báo chế độ hoạt động của bộ đèn (LOCAL (đèn tắt) hoặc REMOTE (đèn sáng)).
  - Đèn LED xanh lá cây báo trạng thái đầy dung lượng của ắc quy 75% - 100%.
  - Đèn LED vàng báo trạng thái dung lượng trung bình của ắc quy 50%-75%.
  - Đèn LED đỏ báo trạng thái dung lượng thấp của ắc quy 20% - 50%.
  - Các đèn LED báo trạng thái ắc quy tắt toàn bộ khi dung lượng ắc quy thấp dưới 20%.

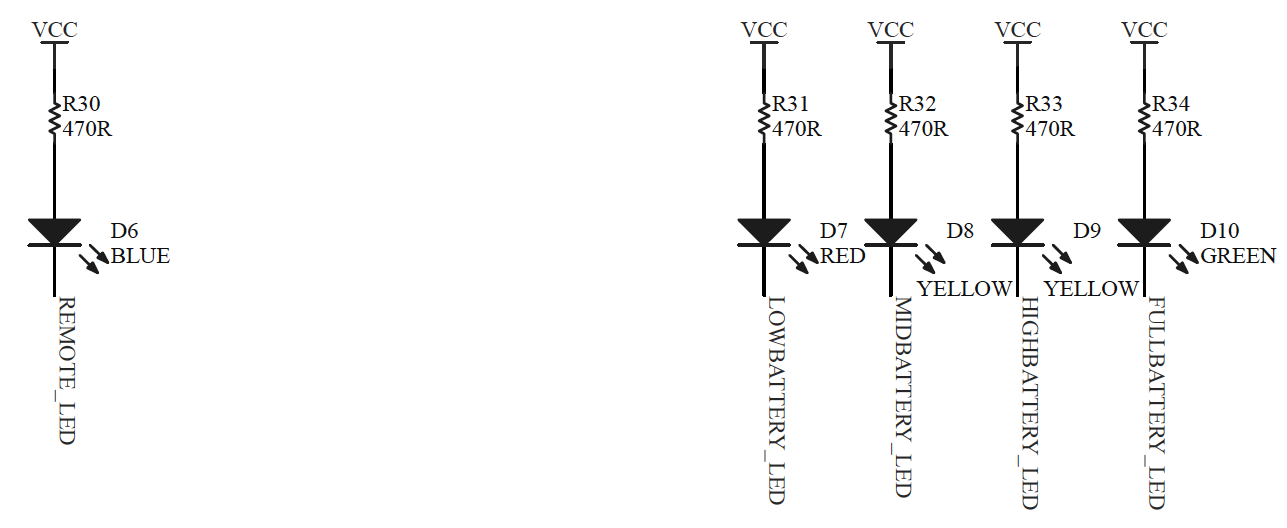
[picture p9: figure]

Hình 8: LED báo trạng thái đèn và ắc quy

* Nguyên lý hoạt động:

- Mạch điều khiển đèn được thiết kế sử dụng vi xử lý của ATMEL bởi ưu điểm hỗ trợ nhiều kết nối với các thiết bị ngoại vi, hỗ trợ biến đổi tương tự - số, hỗ trợ nhiều chuẩn truyền thông (I2C, SPI, UART).

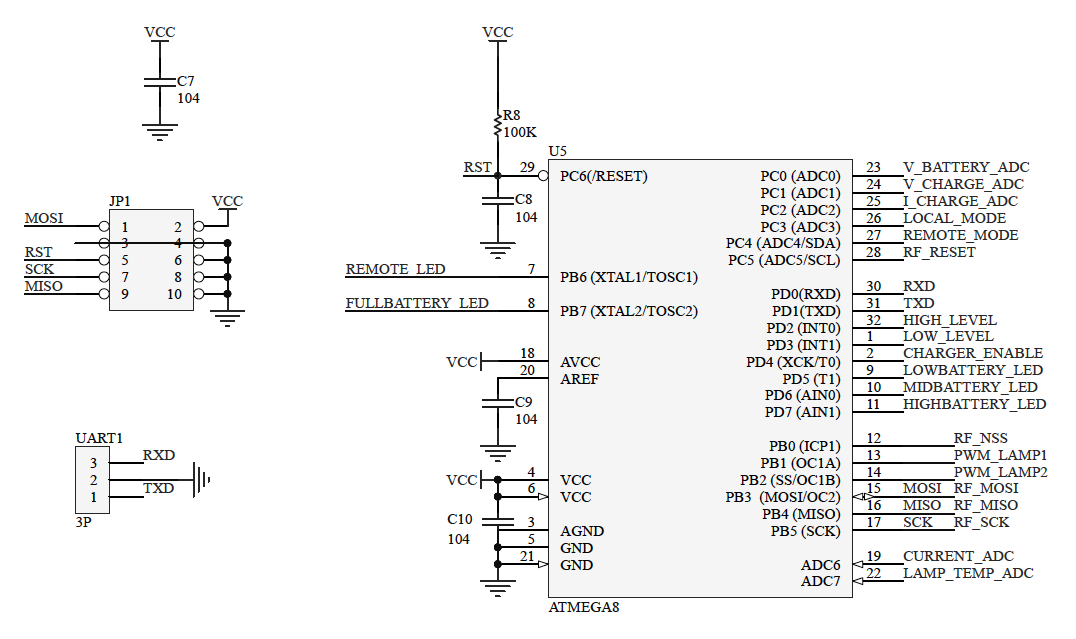
[picture p10: figure]

Hình 9: Chip điều khiển trung tâm cho đèn dã chiến

- Nguồn cấp cho mạch điều khiển đèn được lấy trực tiếp từ ắc quy 12VDC gắn trong đèn, sau khi được đưa qua bộ bảo vệ điện áp (nhỏ nhất 10VDC, lớn nhất 24VDC) được đưa qua các bộ hạ áp là các IC cấp nguồn U1 LM2576 ADJ để cung cấp nguồn điện 5VDC cho các linh kiện trong mạch điều khiển.

- Các cụm đèn LED được cấp nguồn và điều khiển bật/tắt, thay đổi mức sáng trực tiếp từ vi xử lý ATMEGA8 thông qua các transistor trường MOSFET IRFR3709 Q6, Q7. Các cụm đèn LED sẽ được cấp nguồn dòng ổn định để đảm bảo độ sáng không đổi trong suốt thời gian hoạt động. Dòng điện chạy qua các cụm đèn LED được đo đạc và giám sát thông qua các điện trở công suất R23, R26 đưa tới lối CURRENT_ADC của vi xử lý ATMEGA8. Căn cứ theo dòng điện đo được và mức sáng được yêu cầu, vi xử lý sẽ điều chỉnh độ rộng xung mở các transistor trường MOSFET Q6, Q7 để cung cấp dòng điện tương ứng tới các cụm đèn LED.

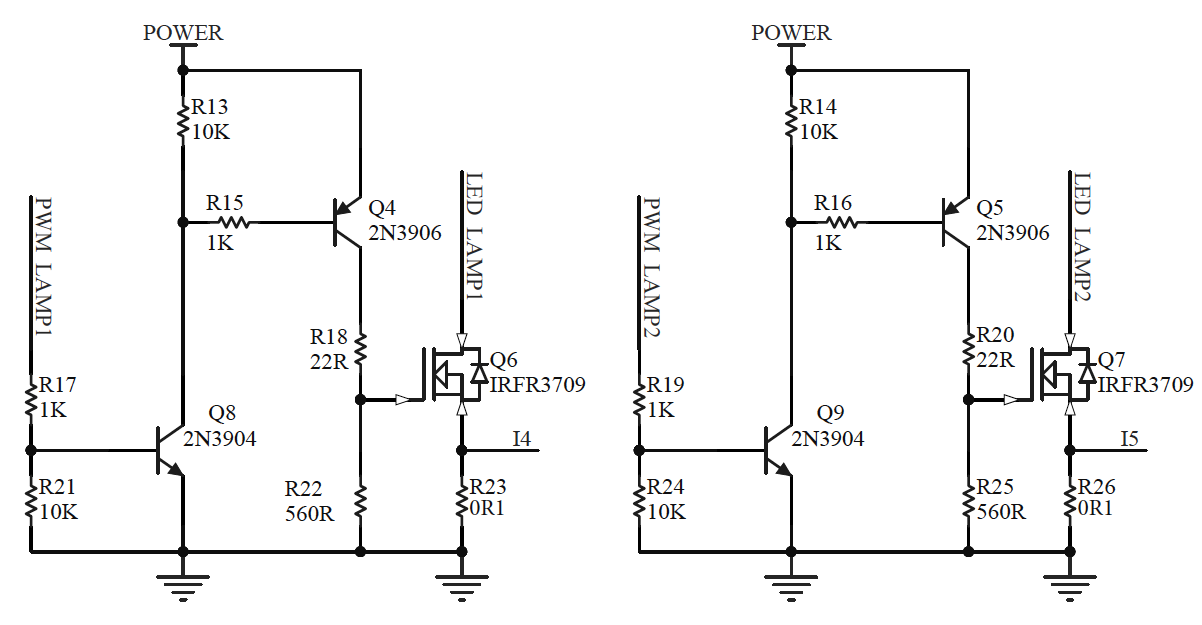
[picture p11: figure]

Hình 10: Khóa điều khiển bật/tắt và mức sáng cho đèn dã chiến

- Mạch điều khiển đèn cho phép giám sát các trạng thái của ắc quy lắp trong đèn dã chiến bằng cách sử dụng các bộ biến đổi tương tự - số ADC, các thông số giám sát bao gồm:

* Chức năng giám sát:

  - Điện áp hiện tại của ắc quy, điện áp sử dụng để sạc ắc quy (được đo bằng các cầu chia điện áp sử dụng các điện trở).
  - Dòng điện tiêu thụ trong quá trình nạp ắc quy (được đo bằng các điện trở công suất).
  - Dòng điện cung cấp cho các đèn LED hoạt động (được đo bằng các điện trở công suất như trình bày ở trên), dòng tiêu thụ cho phép bộ điều khiển giám sát được hoạt động các bóng đèn của cụm đèn, trong trường hợp một vài bóng đèn bị cháy, hỏng (vượt quá 25% tổng số bóng đèn LED của cụm đèn) bộ đèn dã chiến được tắt để đảm bảo an toàn khi vận hành, khai thác.
  - Trạng thái của đèn hiện tại được đồng bộ liên tục thông qua các bộ truyền thông không dây đến các bộ điều khiển từ xa cầm tay và bộ kết nối hệ thống điều khiển đèn hiệu. Do đó, trong quá trình hoạt động nếu đèn gặp sự cố (không sáng đèn, hết ắc quy, mất kết nối hoàn toàn), các bộ điều khiển từ xa cầm tay và bộ kết nối hệ thống điều khiển đèn hiệu sẽ đưa các cảnh báo đến người vận hành, khai thác để đưa ra các quyết định xử lý kịp thời, đảm bảo tính tin cậy của hệ thống.

* Chức năng điều khiển:

- Mạch điều khiển thông qua các bộ đo và giám sát điện áp, dòng điện vào, ra ắc quy để đưa ra các lệnh điều khiển nạp, xả ắc quy theo các trạng thái thực tế của ắc quy và bảo vệ quá áp, quá dòng, chập tải, cụ thể như sau:

- Chức năng điều khiển chế độ nạp: Điện áp thực tế của ắc quy sẽ được chia qua cầu điện trở R35, R40 và được đo bằng cổng vào tín hiệu V_BATTERY_ADC của vi xử lý ATMEGA8. Từ điện áp đo được này vi xử lý sẽ quyết định lựa chọn chế độ nạp giới hạn điện áp hay giới hạn dòng điện cho ắc quy. Việc cho phép hoặc không cho phép nạp ắc quy được điều khiển thông qua rơ le K1.

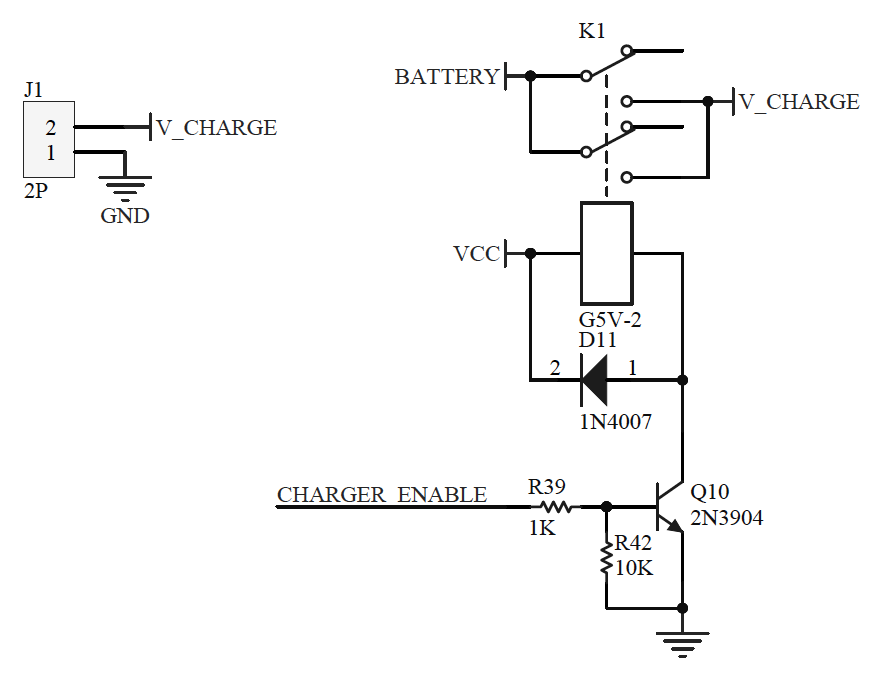
[picture p12: figure]

Hình 11: Khóa điều khiển sạc ắc quy

    - Khi điện áp ắc quy từ 10.6VDC – 13.6VDC, vi xử lý điều khiển nạp ắc quy theo chế độ giới hạn dòng tối đa 1.5A (±20%).
    - Khi điện áp ắc quy từ 13.6VDC – 14.2VDC, vi xử lý điều khiển nạp ắc quy theo chế độ thả nổi giới hạn điện áp 14.2VDC, dòng điện giảm dần từ 1.5A đến vài chục mA khi ắc quy đầy dần lên.
  - Chức năng bảo vệ quá điện áp, quá dòng điện, chập tải: Điện áp từ bộ nguồn được chia qua cầu điện trở R36, R41 và được đo bằng cổng vào tín hiệu V_CHARGE_ADC của vi xử lý ATMEGA8. Trong các trường hợp điện áp này quá thấp (<13.6VDC) hoặc quá cao (>14.2VDC), vi xử lý sẽ ngắt rơ le ngăn không cho nạp ắc quy và đưa ra cảnh báo lỗi nguồn nạp ắc quy.

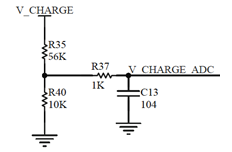
[picture p13: figure]

Hình 12: Mạch giám sát trạng thái điện áp sạc ắc quy

  - Dòng điện nạp, xả ắc quy được biến đổi thành điện áp thông qua điện trở R29 và được đo bằng cổng vào tín hiệu I_CHARGE_ADC của vi xử lý ATMEGA8. Trong các trường hợp vượt quá dòng điện cho phép (hoặc chập tải) vi xử lý sẽ ngắt rơ le để bảo vệ ắc quy và đưa ra cảnh báo lỗi nạp ắc quy. Trong trường hợp nạp ắc quy ở chế độ thả nổi, khi dòng điện nạp ắc quy xuống đến vài chục mA, vi xử lý sẽ ngắt rơ le và báo ắc quy đã được nạp đầy.

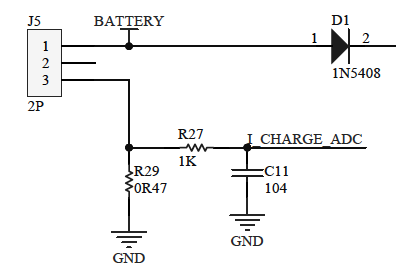
[picture p14: figure]

Hình 13: Mạch giám sát trạng thái dòng điện sạc ắc quy

- Mạch điều khiển đối với các loại đèn CHC trắng – trắng, đèn CHC trắng – vàng, đèn giới hạn kết hợp đèn thềm, đèn lề đường lăn sử dụng chung phần mềm nhúng, riêng đối với đèn chớp nhận dạng thềm sử dụng phần mềm riêng với các chức năng thay đổi tần số chớp cũng như độ sáng của đèn chớp.

* Chức năng báo hiệu tình trạng ắc quy:

MCU dùng bộ đo ADC để xác định điện áp của acquy từ đó xác định được mức độ đầy của acquy và đưa ra tín hiệu báo trên thân đèn qua các đèn chỉ thị.

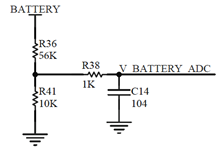
[picture p15: figure]

Hình 14: Mạch đo điện áp ắc quy

b) Mạch truyền thông không dây:

- Bộ truyền thông không dây được thiết kế chế tạo trên cơ sở sử dụng kết quả của một đề tài NCKH cấp Công ty. Tuy nhiên, để đáp ứng yêu cầu độ chính xác và tin cậy của hệ thống, đèn dã chiến sử dụng chip thế hệ mới hơn được thiết kế để truyền tín hiệu không dây với khoảng cách xa hơn và tốc độ cao hơn.

- Cấu trúc một hệ thống truyền thông không dây RF bao gồm các thành phần:

Bộ phát > Antenna phát > Môi trường > Antenna thu > Bộ thu

- Khoảng cách truyền phụ thuộc vào các thông số kỹ thuật của các bộ thu, phát và các tổn hao trên môi trường.
- Ta sử dụng công thức Link budget để tính toán mối liên hệ giữa khoảng cách và các đại lượng khác:

PRX = PTX + GTX – LTX – LFS – LM + GRX - LRX (1)

Trong đó:

+ PRX (dBm) Năng lượng nhận được tại bộ thu

+ PTX (dBm) Năng lượng phát đi của bộ phát

+ GTX (dBi) Độ lợi của antenna phát, PA

+ LTX (dB) Tổn hao trên dây cáp, giắc nối… tại bộ phát

+ LFS (dB) Tổn hao trên đường truyền, suy hao do khoảng cách

+ LM (dB) Tổn hao do phân cực, nhiễu, vật cản, Fresnel zone…

+ GRX (dBi) Độ lợi của antenna thu, LNA

+ LRX (dB) Tổn hao trên dây cáp, giắc nối… tại bộ thu

- Các yếu tố đã được xác định bao gồm: công suất phát, độ lợi anten, độ nhạy thu đã được cung cấp bởi nhà sản xuất.
- Tổn hao trên đường truyền có thể tính toán theo công thức sau:

L_(FS) (dB) = 20log10 4 π(Distance)/(Wavelength) (2)

- Tùy theo đơn vị, ta có các công thức tương đương như sau:

LFS (dB) = 32.45 (dB) + 20log[frequency(MHz)] + 20log[distance(km)]

LFS (dB) = -27.55 (dB) + 20log[frequency(MHz)] + 20log[distance(km)]

LFS (dB) = 36.6 (dB) + 20log[frequency(MHz)] + 20log[distance(miles)]

- Tổn hao trong môi trường không gian là thông số phụ thuộc môi trường truyền sóng, do đó cần thực hiện khảo sát để xác định giá trị tổn hao trong môi trường.
- PNCPT đã khảo sát thực tế trên bộ thu phát RFM98W được sử dụng trong thiết kế cũ của đề tài với các môi trường khác nhau.
- Thông tin bộ thu phát:
  - Công suất phát: 20dBm
  - Tần số: 433MHz
  - Anten phát: 3dBi
  - Anten thu: 3dBi
  - Độ nhạy thu: -130dBm
  - Module phát kết nối trực tiếp với anten không thông qua dây dẫn, tổn hao phát 1dBi
  - Module thu kết nối trực tiếp với anten thu, do đó tổn hao thu không đáng kể.
- Kết quả khảo sát:

Yếu tố ảnh hưởng | Môi trường thoáng | Môi trường đô thị
Tổn hao bộ phát (dB) | 1 | 1
Tổn hao bộ thu (dB) | 1 | 1
Năng lượng nhận được (dBm) | -129.8 | -129.8
Khoảng cách truyền (km) | 2.7 | 1.2

- Từ các kết quả trên, tính toán được tổn hao môi trường trong các trường hợp như sau:
  - Môi trường đô thị nhiều vật cản: 67 (dB)
  - Môi trường ngoại thành ít vật cản, tầm nhìn thẳng: 60 (dB)
- Để đảm bảo khả thi đối với việc chọn lựa module truyền thông, việc tính toán sẽ sử dụng thông số tổn hao môi trường trong trường hợp có nhiều vật cản (67dB).
- Dựa trên công thức tính toán và các kết quả khảo sát, để tăng khoảng cách truyền thông, cần tăng các thông số: công suất của bộ phát, độ lợi của antenna, độ nhạy của bộ thu.
- Trên thực tế, các module thu phát ở tần số 433MHz thường giới hạn độ nhạy thu ở mức -130dBm, do đó việc lựa chọn module có độ nhạy tốt hơn rất khó khăn.
- Để nâng cao độ lợi của antenna, cần sử dụng anten có kích thước lớn hơn nhưng việc áp dụng các loại antenna này cho các sản phẩm hàng không bị hạn chế bởi các tiêu chuẩn (kích thước, độ cao sản phẩm).
- Qua tìm hiểu trên thị trường, hiện tại có thể lựa chọn module truyền thông có công suất lớn hơn (từ 30dBm đến 36dBm). Khoảng cách truyền thông tương ứng với công suất phát được mô tả trong bảng sau:

STT | Công suất bộ phát | Độ nhạy bộ thu | Khoảng cách truyền thông
1 | 20dBm (100mW) | -130 dBm | 1.1 km
2 | 23dBm (200mW) | -130 dBm | 1.6 km
3 | 26dBm (400mW) | -130 dBm | 2.3 km
4 | 30dBm (1W) | -130 dBm | 3.7km
5 | 33dBm (2W) | -130 dBm | 5.2 km
6 | 36 dBm (4W) | -130 dBm | 7.5 km

- Như vậy, để đảm bảo khoảng cách truyền thông 3km ta cần lựa chọn các bộ truyền thông không dây có công suất phát ít nhất là 30dBm và độ nhạy thu -130dBm.
- Module truyền thông không dây theo thiết kế cũ thiết kế dạng IC hàn trên mạch in, trong khi đó, module truyền thông không dây E32-TTL-1W với công suất phát 30dBM hiện có trên thị trường được thiết kế dưới dạng chân cắm lên các giắc hàn trên mạch in.

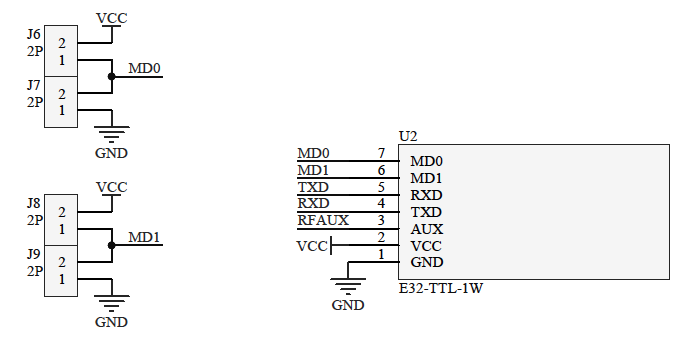
[picture p16: figure]

Hình 15: Module truyền thông không dây RF

- Bộ truyền thông không dây được thiết kế đảm bảo tích hợp được vào cả 3 mạch: mạch điều khiển đèn, mạch điều khiển từ xa cầm tay và mạch kết nối với hệ thống điều khiển đèn hiệu.

- Chip truyền thông không dây kết nối đến vi xử lý bằng chuẩn truyền thông nối tiếp UART.

- Chip truyền thông không dây được cấp nguồn 5VDC hoặc 3.6-4.2VDC từ IC nguồn LM2576 hoặc nguồn pin.

- Để đảm bảo khoảng cách và độ tin cậy của dữ liệu truyền thông không dây, chip truyền thông sử dụng antenna gắn ngoài, độ dài antenna tối đa 12cm vẫn đảm bảo tính thuận tiện và thẩm mỹ cho sản phẩm. Antenna này là loại gập, xoay linh động được kết nối đến các giắc SMA gắn trên vỏ hộp (vỏ đèn dã chiến, vỏ bộ điều khiển từ xa cầm tay, vỏ bộ kết nối hệ thống điều khiển đèn hiệu), với các gioăng chống nước tiêu chuẩn khi sử dụng ngoài trời.

Một số thông số kỹ thuật của IC truyền thông không dây E32-TTL-1W tham khảo:

+ Sử dụng công nghệ truyền thông hiện đại LoRa với khoảng cách truyền nhận thông tin lên đến 8km.

+ Thiết kế dạng module có khả năng truyền nhận thông tin 2 chiều qua sóng vô tuyến, kích thước nhỏ gọn (Dài x Rộng) 43x24mm.

+ Tần số sóng vô tuyến sử dụng: (410 – 441MHz) Mặc định 433MHz

+ Độ nhạy thu: -130dBm

+ Tốc độ truyền thông tối đa: 115.2 kbps

+ Điện áp, dòng điện hoạt động: 2.8V – 5.5V, 670mA

+ Điều kiện làm việc: -40oC đến 85oC

c) Mạch cấp nguồn AC-DC 14.2V/1.5A:

Điện lưới 220VAC/50Hz

Cầu chì, tụ lọc, EMI Filter

Cầu chỉnh lưu Diode

Biến áp Flyback

IC điều khiển KA3843

Transitor MOSFET 7N60B

Bảo vệ quá áp, quá dòng, chập tải

Đầu ra 14.2VDC/1.5A

Cách ly quang TLP521-1

Hình 16: Sơ đồ khối mạch cấp nguồn AC-DC 14.2V/1.5A

* Chức năng:

- Mạch cấp nguồn AC-DC 14.2V/1.5A cho hệ thống đèn dã chiến được thiết kế để thực hiện 2 chức năng chính:

+ Chức năng cấp nguồn cho bộ kết nối với hệ thống điều khiển đèn hiệu.

+ Chức năng cấp nguồn cho các bộ nạp ắc quy lắp trên xe nguồn.

* Nguyên lý hoạt động:

- Bộ nguồn được thiết kế theo nguyên lý Flyback là kiểu nguồn có điện áp đầu ra được cách ly so với điện áp đầu vào. Công suất được truyền gián tiếp thông qua các cuộn dây của biến áp. Điện áp đầu ra có thể cao hơn hoặc thấp hơn điện áp đầu vào tùy thuộc vào tỉ lệ các cuộn dây và tỉ số truyền của lõi biến áp.

        - Điện áp xoay chiều 220VAC sau khi được chỉnh lưu thành điện một chiều bằng cầu diode D1 sẽ được điều khiển để hạ xuống điện áp 14.2VDC bằng IC điều khiển JP1 KA3843.

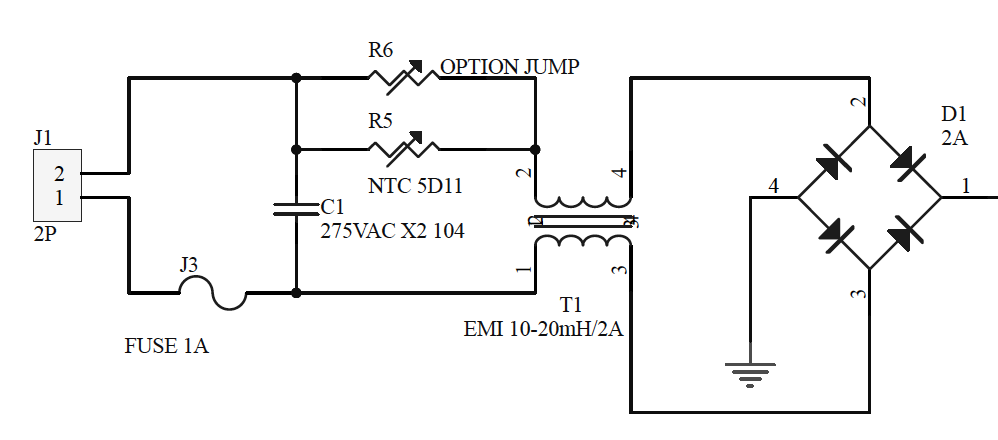
[picture p17: figure]

Hình 17: Mạch cấp nguồn đầu vào cho bộ nguồn

        - Thông qua transistor trường MOSFET Q1 7N60B đóng vai trò như một khóa đóng mở tạo ra dòng điện biến thiên trên cuộn sơ cấp của biến áp Flyback Transformer T2. Năng lượng biến thiên này được truyền đến cuộn thứ cấp của biến áp T2 và được chỉnh lưu thành điện áp một chiều bằng diode xung D4 FR307 và tụ điện C10.

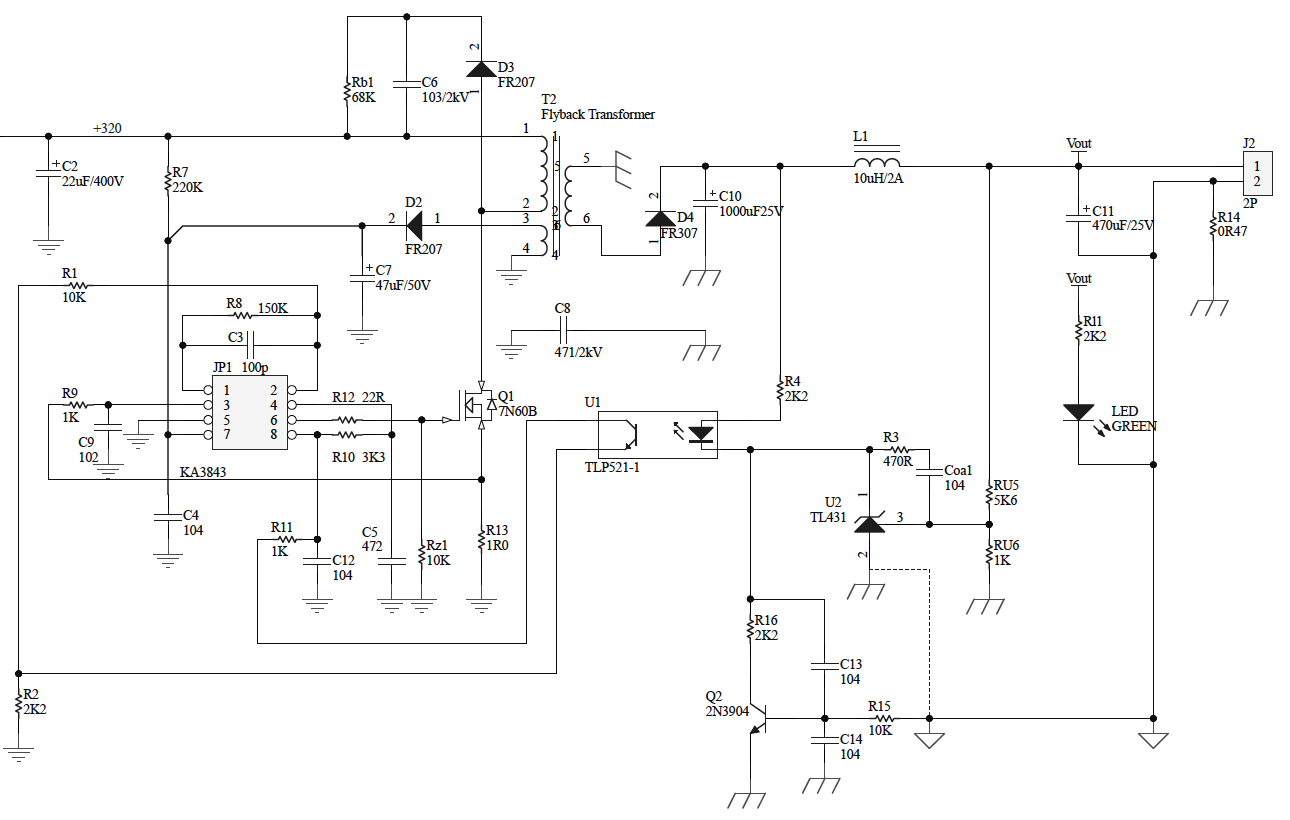
[picture p18: figure]

Hình 18: Mạch điều khiển ổn áp, ổn dòng, bảo vệ bộ nguồn

        - Các bộ bảo vệ quá điện áp, bảo vệ quá dòng điện, chập tải đầu ra sẽ được phản hồi tín hiệu bảo vệ qua cách ly quang U1 TLP521-1 bằng các cầu chia điện áp RU5, RU6, điện trở phản hồi dòng R14 về IC điều khiển KA3843 để ngắt hoạt động của bộ nguồn khi có bất cứ sự cố nào kể trên xảy ra.
        - Các điện trở chia điện áp RU5, RU6 đảm bảo điện áp ra ổn định ở 14.2VDC (±5%).
        - Điện trở phản hồi dòng R14 được tính toán để đảm bảo dòng điện đầu ra tối đa 1.5A (±20%). Transistor Q2 2N3904 đóng vai trò như tín hiệu cảnh báo vượt quá dòng điện. Như ta đã biết điện áp nhỏ nhất để transistor mở là Utr = 0.7V, bằng cách chọn R14 = 0.47 Ohm, ta tính được dòng điện tối đa của đầu ra là:

Ir = Utr/R14 = 0.7/0.47 ≈ 1.49 (A)

- Căn cứ vào yêu cầu của bộ nguồn có thể tính toán được các thông số hoạt động của mạch nguồn và lựa chọn các linh kiện công suất cho mạch nguồn như sau:

- Dải điện áp đầu vào: Vin = 85 (VAC) đến 250 (VAC)
- Tần số điện áp đầu vào: f = 50 (Hz)
- Điện áp đầu ra yêu cầu: Ur = 14.2 (VDC)
- Dòng điện đầu ra tối đa: Ir = 1.5 (A)
- Hiệu suất chuyển đổi yêu cầu: 80% (ŋ = 0.8)

- Từ các thông số trên ta tính được các tham số hoạt động của mạch nguồn như sau:

        - Điện áp sau chỉnh lưu nhỏ nhất:

Vmin = Vin_min*1.4142 = 120(VDC)

        - Điện áp sau chỉnh lưu lớn nhất:

Vmax = Vin_max*1.4142 = 354(VDC)

        - Công suất đầu ra tối đa:

Po = Ur*Ir = 14.2*1.5 = 21.3(W)

        - Công suất đầu vào tối đa:

Pin_max = Po/ ŋ = 21.3/0.8 = 26.6(W)

        - Dòng điện đầu vào tối đa:

Iin_max = Pin_max/Vin_min = 26.6/120 = 0.22(A)

        - Dòng đỉnh đầu vào theo cấu hình của nhà sản xuất IC KA3843:

Ipk = 5.5*(Po/Vin_min) = 5.5*(21.3/120) = 0.98(A)

        - Độ tự cảm yêu cầu đối với cuộn sơ cấp của biến áp Flyback, với δmax = 0.45 là độ rộng xung tối đa mà IC KA3843 có thể ra điều khiển và tần số điều khiển fPWM = 50kHz:

Lp = (Vin_min*δmax)/(Ipk*fPWM)

= (120*0.45)/(0.98*50000)

= 1.1(mH) = 1100(μH)

        - Với hệ số điện cảm tiêu chuẩn của lõi biến áp Flyback:

AL = 1012 (nH/N²)

        - Ta tính được số vòng dây tương ứng với các cuộn sơ cấp (Np) và hai cuộn thứ cấp (Ns) của biến áp Flyback như sau:

Np = 3*Sqrt(Lp/AL)

= Sqrt(1100*10³/1012) = 100 (vòng)

Ns = Np*(Ur-Ud)*(1-δmax)/(Vin_min*δmax)

= 100*(14.2-1)*(1-0.45)/(120*0.45) = 15 (vòng)

        - Trong đo: Ud = 1 (VDC) là điện áp rơi lớn nhất trên diode đầu ra của mạch nguồn
        - Căn cứ vào dòng điện đầu vào tối đa và đầu ra tối đa đã tính toán ở trên kết hợp với hệ số an toàn (ϭ = 1.2) ta lựa chọn đường kính dây đầu vào là 0.4mm và dây đầu ra là 0.8mm.
d) Mạch giám sát trạng thái sạc ắc quy:

- Mạch giám sát trạng thái ắc quy sử dụng IC tạo điện áp chuẩn TL431 để giám sát mức điện áp thực tế của ắc quy và thông báo khi ắc quy đang được nạp điện hoặc khi ắc quy đầy bằng các đèn LED.

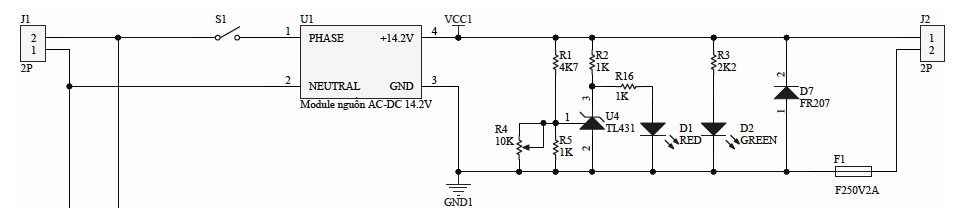
[picture p19: figure]

Hình 19A: Mạch hiển thị trạng thái sạc ắc quy

- Mạch giám sát trạng thái ắc quy được lắp ráp, đóng gói trong vỏ nhôm đúc định hình sẵn có trên thị trường thành dạng module hoàn chỉnh để đảm bảo tính thẩm mỹ và độ đồng đều cho sản phẩm. Module sạc ắc quy được thiết kế để có thể lắp đặt trực tiếp lên xe nguồn bằng các ốc, vít tiêu chuẩn, mỗi module sạc ắc quy cho phép sạc cùng lúc 3 đèn dã chiến.

- Phần bảo vệ các mạch nguồn trong bộ sạc ắc quy trong trường hợp chập tải, ngược tải sử dụng các diode, cầu chì được lắp theo sơ đồ sau:

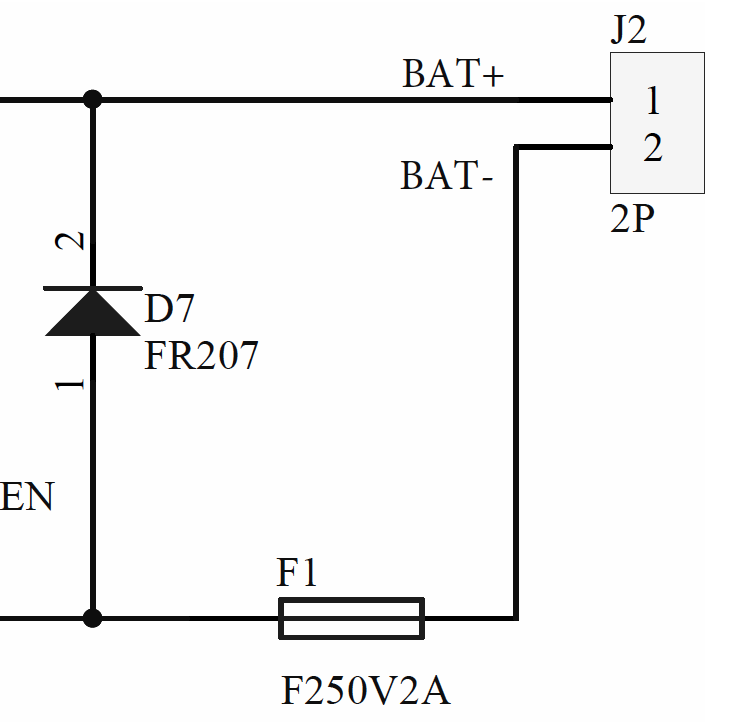
[picture p20: figure]

Hình 19B: Mạch bảo vệ sạc ắc quy

- Trong đó, cầu chì F1 đóng vai trò bảo vệ mạch nguồn trong trường hợp chập tải ắc quy, khi chập tải đầu ra J2 gây ra dòng điện tăng đột ngột sẽ làm đứt cầu chì F1 để cách ly mạch nguồn khỏi tải, tránh hỏng hóc cho mạch nguồn.

- Bên cạnh đó, cầu chì F1 khi kết hợp với diode D7 còn đóng vai trò như một bộ bảo vệ ngược tải:

+ Trong trường hợp đầu ra J2 được mắc đúng cực, đầu ra BAT+ đấu với cực dương ắc quy, đầu ra BAT- đấu với cực âm ắc quy, mạch nguồn sẽ cung cấp điện áp dương BAT+ cho cực dương của ắc quy và điện áp âm BAT- cho cực âm của ắc quy, diode D7 phân cực ngược nên không dẫn dòng điện chạy qua, mạch nguồn hoạt động bình thường.

+ Trong trường hợp đầu ra J2 bị mắc ngược cực (vô tình khi lắp ráp hoặc thi công), đầu ra BAT+ đấu với âm của ắc quy và đầu ra BAT- đấu với dương ắc quy, nếu không được bảo vệ mạch nguồn sẽ bị đánh thủng các linh kiện bán dẫn do các điện áp và dòng điện ngược gây ra. Lúc này diode D7 bị phân cực thuận và nhanh chóng mở cho dòng điện chạy qua làm dòng điện tăng đột ngột làm đứt cầu chì F1 cách ly mạch nguồn khỏi tải, bảo vệ mạch nguồn khỏi các hỏng hóc.

- Module sạc ắc quy được kết nối đến đèn dã chiến bằng các dây cáp và giắc nối chống nước.

- Module sạc ắc quy thiết kế để sử dụng 3 mạch cấp nguồn AC-DC theo thiết kế đã nêu ở trên kết hợp với các công tắc bật tắt từng bộ nguồn và các đèn LED báo trạng thái (đang sạc màu đỏ và đã sạc đầy màu xanh).

- Với điện áp ra và dòng điện của mạch cấp nguồn AC-DC đã nêu ở trên, điện áp đầu ra 14.2VDC (±5%), dòng điện đầu ra tối đa 1.5A (±20%) khi sử dụng để nạp điện cho ắc quy 12V12Ah ta có thể tính toán thời gian nạp đầy cho ắc quy theo lý thuyết như sau:

        - Dòng điện nạp cho ắc quy ở chế độ nạp giới hạn dòng điện:

Ic_max = 1.8A, Ic_min = 1.2A

        - Thời gian nạp đầy cho ắc quy 12Ah ở chế độ giới hạn dòng điện:

Tf_avg = 12Ah/1.5A = 8h

Tf_max = 12Ah/1.2A = 10h

Tf_min = 12Ah/1.8A = 6.7h

        - Tuy nhiên chế độ giới hạn dòng điện không duy trì liên tục trong suốt quá trình nạp ắc quy, khi ắc quy đầy dần, điện áp ắc quy tăng lên, dòng điện nạp vào ắc quy giảm đi, lúc này, ắc quy được nạp ở chế độ thả nổi ổn định điện áp 14.2VDC. Tùy thuộc vào chất lượng ắc quy và tuổi thọ của ắc quy mà quá trình này chiếm từ 10-20% cả quá trình nạp ắc quy. Ắc quy càng tốt, càng mới thì quá trình này chiếm tỉ lệ càng ít trong cả quá trình nạp ắc quy. Với các ắc quy có quá trình này lớn hơn 20% cả quá trình nạp cần phải thay thế mới. Khi đó, thời gian tối đa để nạp ắc quy có thể tính như sau:

Tmax = Tf_max * 120% = 12h

- Thời gian tối đa để nạp đầy ắc quy theo tính toán như trên (12h) hoàn toàn đáp ứng được tiêu chuẩn được quy định trong FAA AC150/5345-50B về thời gian tối đa cho việc nạp ắc quy (13h).

- Một số thông số cơ bản của ắc quy (tham khảo loại ắc quy Vision mã CP12120, có thể sử dụng các loại ắc quy có thông số tương đương):

+ Chủng loại: Ắc quy chì kín khí, vỏ nhựa

+ Điện áp danh định, dung lượng: 12V, 12Ah

+ Kích thước (Dài x Rộng x Cao): 151x98x95(101) mm.

+ Khối lượng (sai số cho phép 5%): 3.67 Kg

+ Số cell thiết kế: 6 cell

+ Nội trở khi sạc đầy (đo tại 25oC): Nhỏ hơn 19 mOhms

+ Dòng xả lớn nhất (thời gian 5s): 180A

+ Dòng ngắn mạch lớn nhất: 600A

+ Dòng nạp lớn nhất (Sạc ổn định điện áp, tại 25oC): 4.8A

+ Khả năng tự xả trung bình (tại 20oC): 3% dung lượng mỗi tháng

+ Điều kiện hoạt động (Sạc, Xả, Bảo quản): -20oC đến 60oC

+ Thời gian sử dụng theo thiết kế: 5 năm

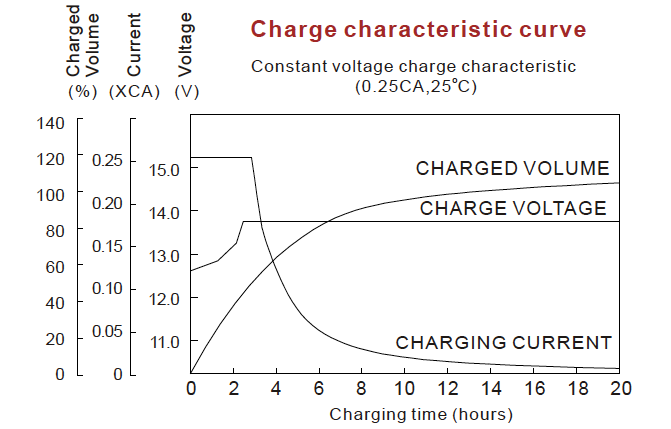
[picture p21: figure]

Lược đồ 1: Đặc tính nạp của ắc quy Vision CP12120

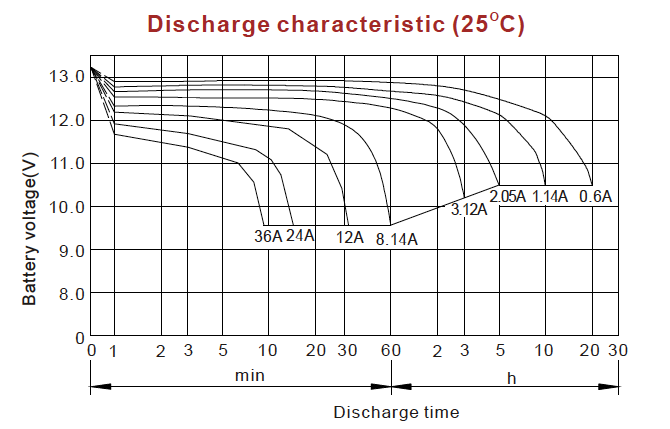
[picture p22: figure]

Lược đồ 2: Đặc tính xả của ắc quy Vision CP12120

e) Mạch điều khiển từ xa cầm tay:

Pin Lithium-ion 3.6VDC

IC nguồn LM1117-3.3

Module truyền thông không dây RF

Vi xử lý ATMEL ATMEGA8

Graphic LCD 84x48 pixel

Nút bấm

Hình 20: Sơ đồ khối mạch điều khiển từ xa cầm tay

- Bộ điều khiển từ xa cầm tay được thiết kế trên cơ sở sử dụng chip vi xử lý của ATMEL kết hợp với module truyền thông không dây để truyền các tín hiệu bật tắt, thay đổi trạng thái đèn dã chiến ở khoảng cách xa từ bất kì vị trí nào ở sân bay.

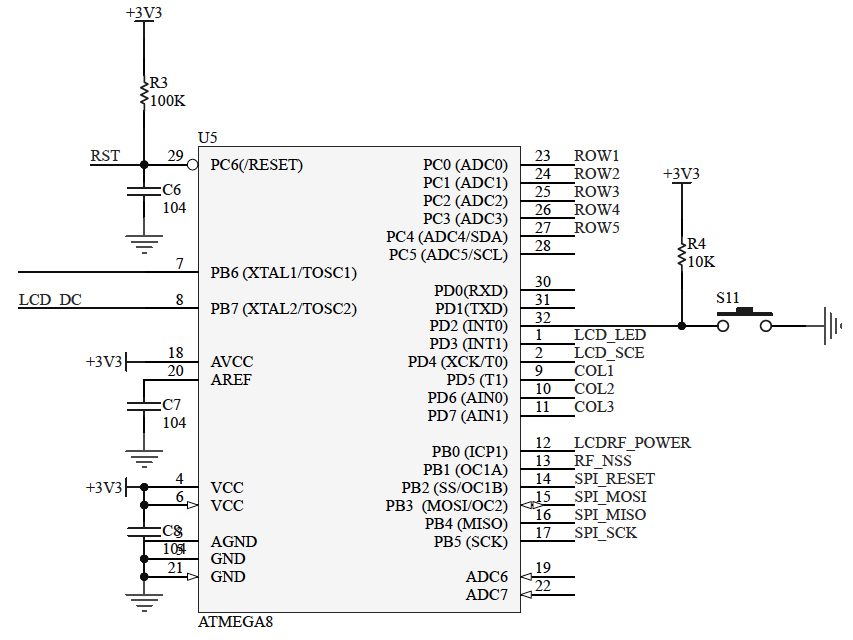
[picture p23: figure]

Hình 21: Chip vi xử lý trung tâm mạch điều khiển từ xa cầm tay

- Mạch điều khiển từ xa cầm tay được cấp nguồn từ các pin lithium-ion 3.6VDC.

- Chíp vi xử lý U5 ATMEL ATMEGA8 được kết nối đến module truyền thông không dây U1 E32-TTL-1W bằng chuẩn truyền thông nối tiếp UART.

- Bộ điều khiển từ xa cầm tay được thiết kế với các nút bấm thuận tiện cho phép thao tác các lệnh điều khiển nhanh chóng.

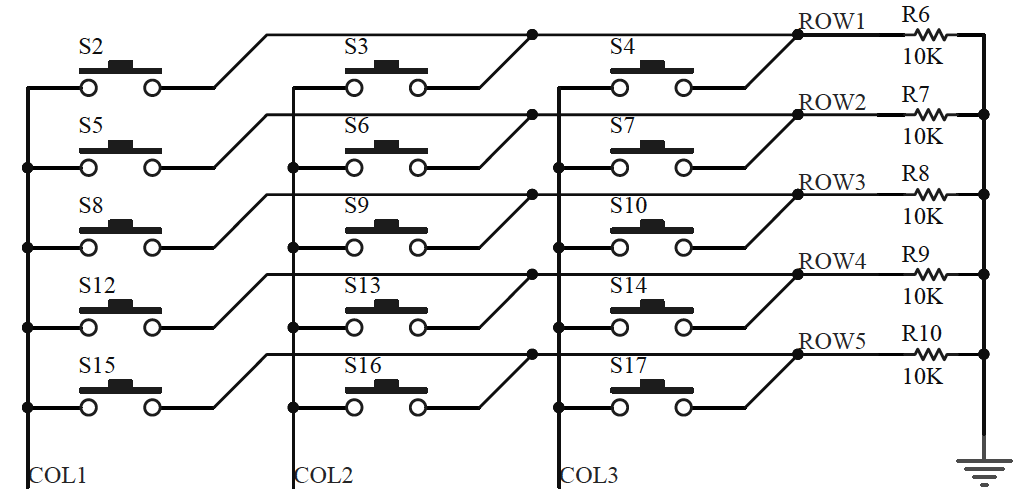
[picture p24: figure]

Hình 22: Mạch nút bấm bộ điều khiển từ xa cầm tay

- Màn hình đồ họa LCD U4 84x48 pixel lắp trên điều khiển cho phép người sử dụng lựa chọn các chế độ hoạt động, mức sáng cho đèn, lựa chọn mạch đèn một cách trực quan.

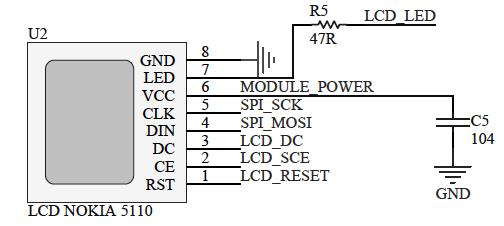
[picture p25: figure]

Hình 23: Mạch hiển thị bộ điều khiển từ xa cầm tay

- Bộ điều khiển từ xa cầm tay được đóng gói sử dụng vỏ hộp mua sẵn trên thị trường để đảm bảo tính thẩm mỹ cho sản phẩm.

f) Mạch kết nối hệ thống điều khiển xa:

Vi xử lý trung tâm ATMEL

Module cấp nguồn 220VAC – 14.2VDC

Bộ truyền thông không dây RF

Kết nối MULTIWIRE

Kết nối MODBUS

Bộ tạo nguồn 5V, 3V3

Hệ thống điều khiển

Hình 24: Sơ đồ khối bộ kết nối hệ thống điều khiển

- Mạch kết nối hệ thống điều khiển xa được thiết kế sử dụng vi xử lý của ATMEL U6 ATMEGA128 cho phép truyền nhận tín hiệu điều khiển, giám sát từ hệ thống điều khiển đèn hiệu thông qua giao thức truyền thông song song (MULTIWIRE) hoặc giao thức truyền thông nối tiếp (MODBUS). Các tín hiệu này sau khi được xử lý sẽ được truyền thông đến các bộ đèn thông qua module truyền thông không dây RF.

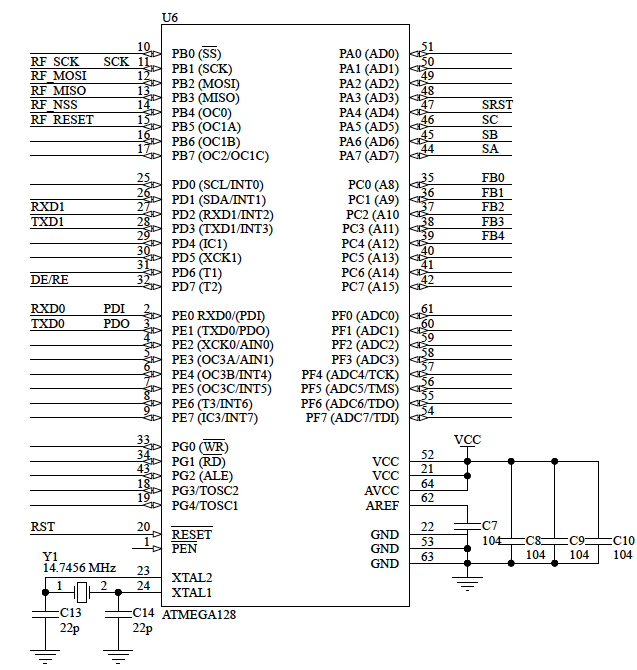
[picture p26: figure]

Hình 25: Chip vi xử lý trung tâm bộ kết nối hệ thống điều khiển từ xa

- Mạch kết nối hệ thống điều khiển xa được cấp nguồn bằng mạch cấp nguồn AC-DC theo thiết kế đã nêu ở trên, kết hợp với các bộ hạ áp U2 LM2576 tạo ra các điện áp 5VDC cung cấp cho các linh kiện của mạch.

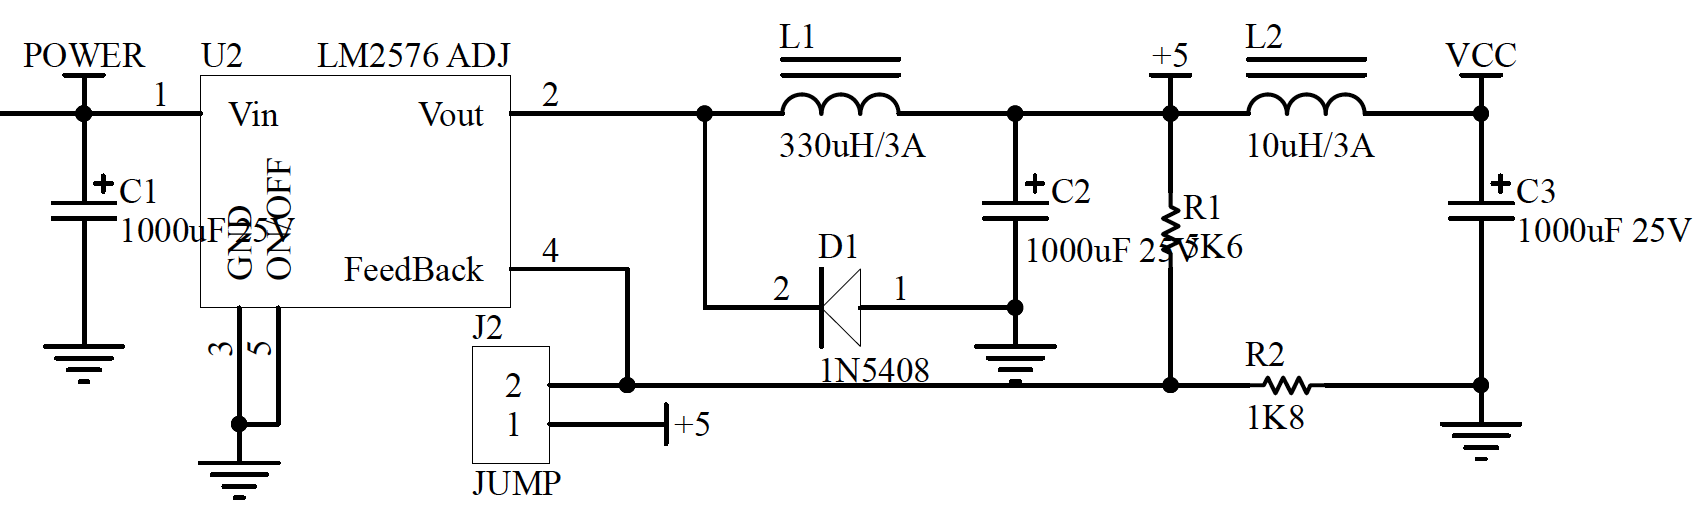
[picture p27: figure]

Hình 26: Mạch cấp nguồn bộ kết nối hệ thống điều khiển từ xa

- Mạch kết nối hệ thống điều khiển xa khi hoạt động ở chế độ MULTIWIRE nhận các tín hiệu điều khiển từ hệ thống điều khiển (ALCS) thông qua các IC cách ly quang TLP521-1 U7, U8, U9, U10 và truyền các tín hiệu trạng thái giám sát với hệ thống điều khiển (ALCS) thông qua các rơ le K1, K2, K3, K4, K5.

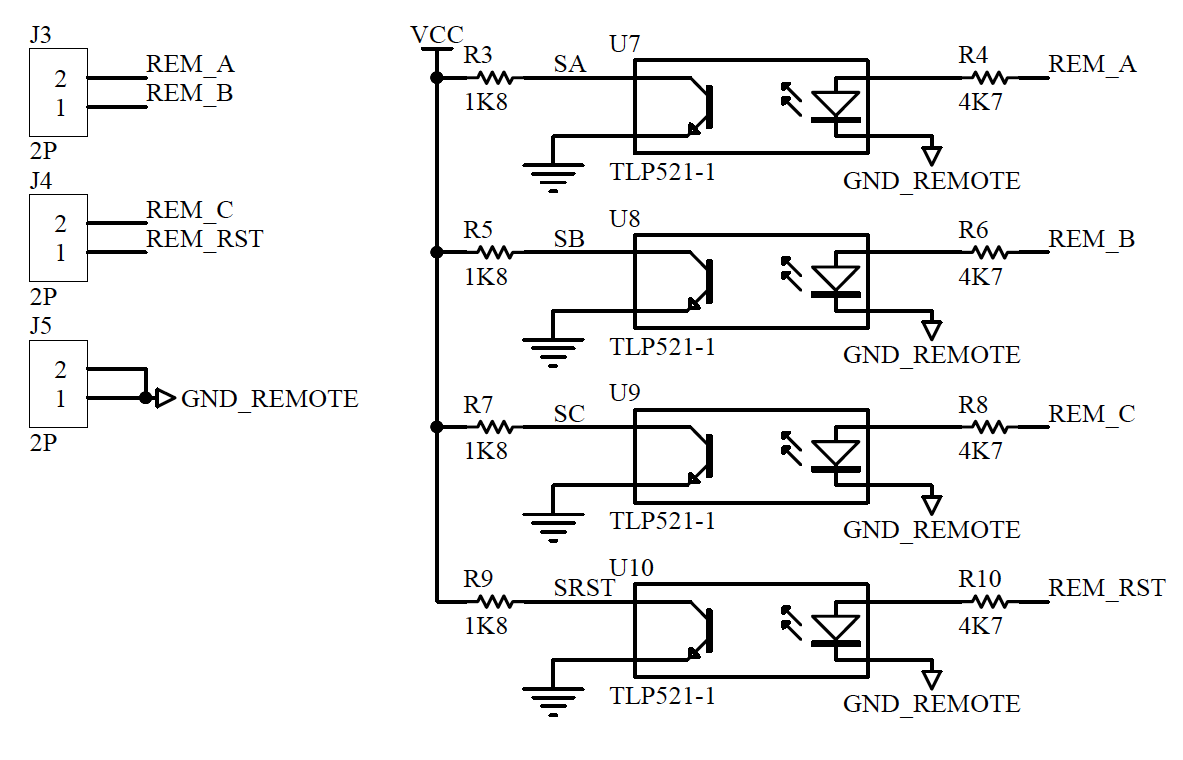
[picture p28: figure]

Hình 27: Mạch nhận tín hiệu điều khiển dùng cách ly quang

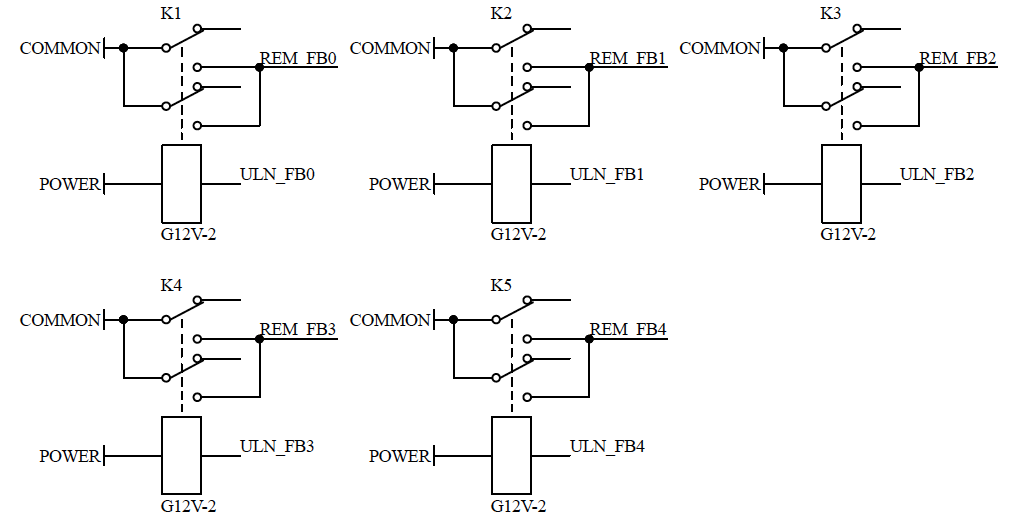
[picture p29: figure]

Hình 28: Mạch phản hồi trạng thái dùng rơ le

- Mạch kết nối hệ thống điều khiển xa khi hoạt động ở chế độ MODBUS nhận các tín hiệu điều khiển và truyền thông các trạng thái giám sát với hệ thống điều khiển (ALCS) thông qua chuẩn truyền thông nối tiếp RS485 sử dụng IC truyền thông MAX485 U12.

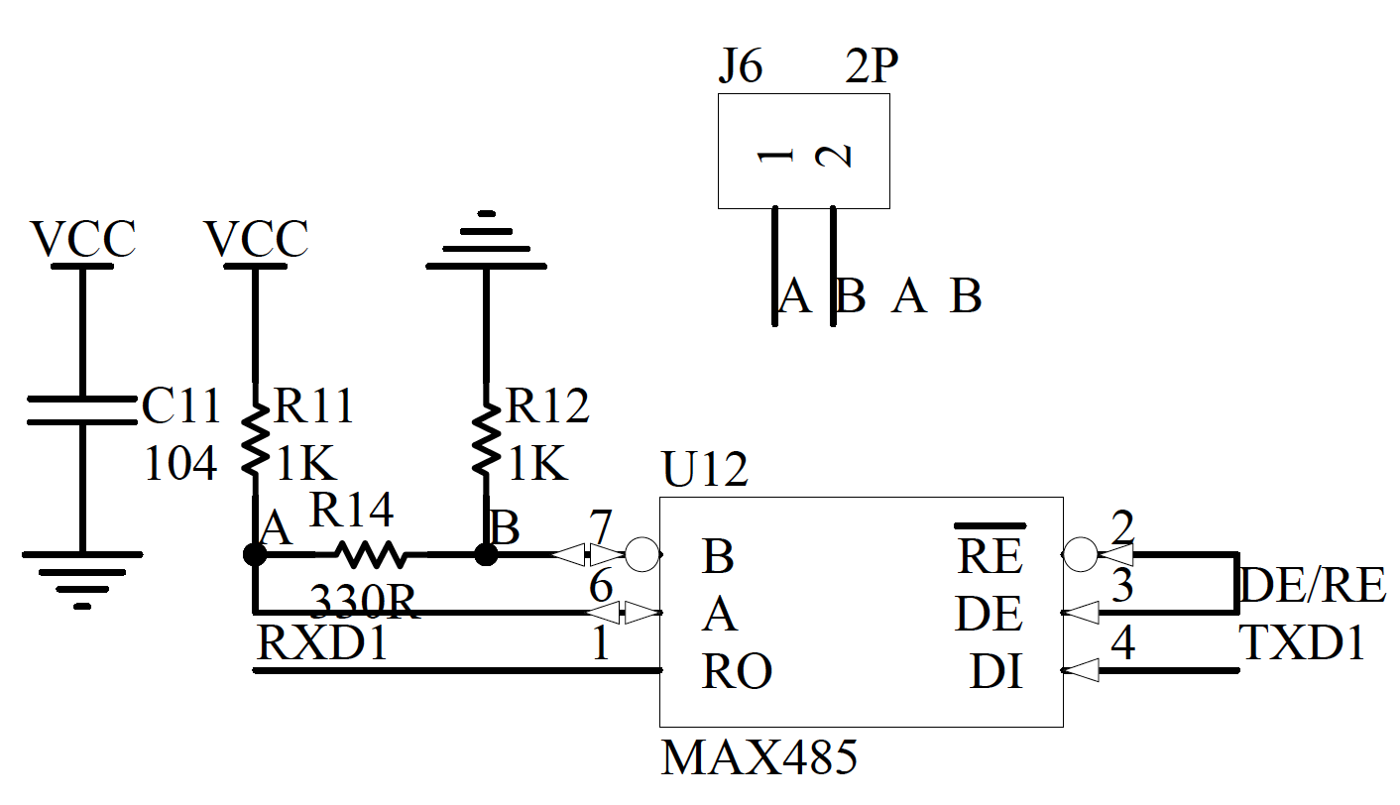
[picture p30: figure]

Hình 29: Mạch truyền thông MODBUS sử dụng MAX485

- Mạch kết nối hệ thống điều khiển xa được đóng gói trong vỏ nhôm đúc định hình sẵn có trên thị trường để đảm bảo tính thẩm mỹ và độ đồng đều cho sản phẩm.

- Phần quang học:

- Phần cụm đèn dã chiến được thiết kế trên cơ sở công nghệ LED tiết kiệm điện và sử dụng chung thiết kế áp dụng cho tất cả các chủng loại đèn bao gồm: đèn CHC trắng-trắng, đèn CHC trắng-vàng, đèn Taxiway, đèn giới hạn kết hợp đèn thềm, đèn chớp nhận dạng thềm.

- Thiết kế quang học của các bộ đèn dã chiến được xây dựng dựa trên bộ hồ sơ thiết kế đèn dã chiến được phê duyệt theo Quyết định số 315/QĐ-CQĐHQ ngày 15/06/2017, bộ hồ sơ thiết kế cải tiến đèn dã chiến được phê duyệt theo Quyết định số 181/QĐ-CQĐHQ ngày 01/03/2018 và các kết quả đo đạc, thử nghiệm các đèn lề đường lăn led lắp nổi và đèn cao không cấu trúc kép trong hệ thống đèn hiệu sân bay của công ty.

- Các cụm LED theo thiết kế của đề tài được khảo sát với chụp kính GB6625 đang được sử dụng cho đèn cao không cấu trúc kép và chụp kính GB6565 đang được sử dụng cho đèn lề đường lăn để đánh giá độ đồng đều ánh sáng theo phương ngang. Các cụm LED đều được khảo sát tại góc đứng 0⁰ và góc ngang ±90⁰, đối với các đèn dã chiến kết hợp 2 màu được ngăn cách bằng một tấm nhôm phản quang và che sáng khi đo từng màu riêng biệt. Kết quả đo đạc được so sánh với cụm LED đang được sử dụng cho đèn lề đường lăn LED lắp nổi. Độ đồng đều ánh sáng và cường độ ánh sáng tương ứng cới các màu sắc riêng biệt đều đạt các tiêu chuẩn.

- Sau khi xem xét kết quả đo, đánh giá sự phù hợp của cấu trúc quang học đèn cao không LED và đèn lề đường lăn LED của công ty, căn cứ đặc tính kĩ thuật của các loại LED OSRAM W5SM, đánh giá yếu tố sử dụng lẫn nhau của các cụm LED, chụp kính, cần cải tiến thiết kế phần quang học như sau:

* Cấu trúc quang học:

- Giải pháp cải tiến thiết kế cấu trúc quang học căn cứ trên đánh giá Đèn cao không LED ánh sáng đỏ và đèn lề đường lăn LED ánh sáng xanh dương của công ty, các đèn này có các đặc tính ánh sáng tương tự như đèn dã chiến ánh sáng đỏ và đèn dã chiến ánh sáng xanh dương. Các kết quả đánh giá cho thấy đặc tính góc chiếu sáng, cường độ ánh sáng và độ đồng đều ánh sáng đều phù hợp với yêu cầu được nêu trong tiêu chuẩn. Qua đó có thể thấy cấu trúc quang học và các đặc tính quang học của đèn cao không LED và đèn lề đường lăn LED của công ty phù hợp để ứng dụng vào đèn dã chiến.

- Để đảm bảo giữ nguyên các đặc tính quang học của đèn cao không LED và đèn lề đường lăn LED, khi thiết kế các bộ đèn dã chiến ta sử dụng toàn bộ cơ cấu gá LED, chủng loại chụp kính GB6625, chủng loại LED, kích thước cụm tản nhiệt, vị trí đặt LED, mạch hàn LED, tâm chụp kính lọc sáng được giữ nguyên như thiết kế của đèn cao không cấu trúc kép LED. Chi tiết đặc tính kĩ thuật của LED sử dụng trong thiết kế các bộ đèn dã chiến được mô tả trong bảng dưới đây:

STT | Màu sắc ánh sáng | Ký mã hiệu linh kiện | Bước sóng ánh sáng (nm) | Tọa độ màu | | Công suất (W) | Hiệu suất phát quang (lm/W) | Góc mở (độ)
| | | | x | y
1 | Red | OSRAM LR W5SM | 624-632 | - | - | 1 | 65 | 120
2 | White | OSRAM LCW W5SM | - | 0,42 | 0,40 | 1 | 87 | 120
3 | Yellow | OSRAM LCY W5SM | - | 0,56 | 0,42 | 1 | 50 | 120
4 | Green | OSRAM LT W5SM | 513-527 | - | - | 1 | 129 | 120
5 | Blue | OSRAM LB W5SM | 464-475 | - | - | 1 | 28 | 120

* Thiết kế cấp nguồn, điều khiển công suất:

- Theo kết quả thử nghiệm quang học của đèn cao không LED cấu trúc kép được thể hiện trong bảng sau:

Màu sắc, chủng loại LED | Dòng điện tiêu thụ (mA) | Hiệu suất quang (lm/W) | Quang thông (lm) | Độ đồng đều nhỏ nhất thiết kế (%) | Cường độ sáng nhỏ nhất 0⁰-6⁰ (cd) | Cường độ sáng yêu cầu 0⁰-6⁰ (cd) | Công suất tiêu thụ (W)
Đỏ (OSRAM LR W5SM) | 300 | 68 | 342,72 | 85% | 33,3 | 32 | 5,04

- Dựa trên thông số kĩ thuật của các loại LED OSRAM, tính chất tương đồng, tỉ lệ thuận của các đại lượng quang học bao gồm quang thông, cường độ sáng, độ đồng đều ánh sáng, có thể xây dựng các thành phần điều khiển công suất và thiết kế cấp nguồn cho các bộ đèn dã chiến.

- Dựa trên màu sắc ánh sáng của các bộ đèn dã chiến có thể phân chia thành hai loại:

  - Đèn dã chiến một màu: Đèn lề đường lăn, đèn lề đường CHC trắng – trắng
  - Đèn dã chiến hai màu: Đèn lề đường CHC trắng – vàng, đèn giới hạn đường CHC kết hợp đèn thềm.

Đèn dã chiến một màu:

- Đối với đèn dã chiến có ánh sáng góc ngang 360⁰, cùng màu, cường độ sáng tỷ lệ thuận với quang thông sử dụng của LED.
- Do cường độ sáng tỷ lệ thuận với quang thông:

(Ii)/(I1)=(Qi)/(Q1)hayQi=Q1(Ii)/(I1)(1)

- Trong đó:

+ Q1 = 342.72 (lm) và I1 = 33.3 (cd) lần lượt là quang thông và cường độ sáng nhỏ nhất của đèn cao không cấu trúc kép LED

+ Qi, Ii lần lượt là quang thông và cường độ sáng yêu cầu của đèn dã chiến.

- Theo công thức (1):
  - Quang thông cần thiết cho đèn lề đường CHC dã chiến trắng – trắng với cường độ sáng yêu cầu nhỏ nhất 20cd (Theo tiêu chuẩn FAA AC150/5345-50B) là:

Qi=342.72(20/33.3)=205.32(lm)(1')

  - Công suất cần thiết của cụm LED cho đèn dã chiến trắng – trắng với hiệu suất quang 87 (lm/W) là:

P_W =205.32/87=2.36(W)(1'')

  - Quang thông cần thiết cho đèn lề đường lăn dã chiến với cường độ sáng yêu cầu nhỏ nhất 1.4cd (Theo tiêu chuẩn FAA AC150/5345-50B) tính theo công thức (1’) là:

Qi=342.72(1.4/33.3)=14.28(lm)

  - Công suất cần thiết của cụm LED cho đèn dã chiến với hiệu suất quang 87 (lm/W) tính theo công thức (1’’) là:

P_B =14.28/28=0.51(W)

- Căn cứ vào hiệu suất quang được nêu trong tài liệu kỹ thuật của từng loại LED OSRAM W5SM, ta tính được công suất cần dùng của đèn lề đường CHC dã chiến trắng – trắng và đèn lề đường lăn dã chiến như bảng sau:

TT | Loại Đèn dã chiến | Hiệu suất LED (lm/W) | Quang thông (lm) | Độ đồng đều thiết kế (%) | Cường độ sáng nhỏ nhất thiết kế 0⁰-6⁰ (cd) | Cường độ sáng nhỏ nhất 0⁰-6⁰ (cd) | Cường độ sáng yêu cầu 0⁰-6⁰ (cd) | Công suất LED (W)
1 | Đèn cao không LED | 68 | 342,72 | 85,0% | 39,20 | 33,3 | 32 | 5,04
2 | Đèn lề đường lăn dã chiến | 28 | 14,28 | 85% | | 1,4 | 1,4 | 0,51
3 | Đèn lề đường cất hạ cánh trắng – trắng | 87 | 205,32 | 85% | | 20 | 20 | 2,36

Đèn dã chiến hai màu:

- Đối với đèn dã chiến có hai màu ánh sáng, cường độ sáng tỷ lệ thuận với quang thông sử dụng của LED và tỷ lệ thuận với độ đồng đều của chụp kính, do đó:

Ii=I1((Qi)/(Q1))((Hi)/(H1))hayQi=Q1((Ii)/(I1))((H1)/(Hi))(2)

- Trong đó:

Q1, I1 là quang thông và cường độ sáng đèn cao không cấu trúc kép LED.

Qi, Ii lần lượt là quang thông và cường độ sáng yêu cầu của đèn dã chiến.

Hi là độ đồng đều ánh sáng theo thiết kế cho đèn dã chiến.

H1 là độ đồng đều ánh áng của đèn cao không cấu trúc kép LED.

- Như ta đã biết, cường độ sáng của mỗi góc sẽ được cộng đại số từ cường độ sáng của các nguồn sáng trong cụm LED. Với cụm LED có 8 đèn (360⁰), độ đồng đều là 85% theo các kết quả thực nghiệm.
- Tức là: I(min)/Itb = 85%
- Với cụm LED có 8 đèn được chia làm 2 màu (mỗi màu có góc phát sáng ngang 180⁰ và được thiết kế thêm vách ngăn giữa hai màu) thì cường độ sáng nhỏ nhất sẽ ở vùng giao giữa hai màu ánh sáng. Tại khu vực này, cường độ sáng sẽ giảm xuống 1/2 so với loại không vách ngăn. Khi đó cường độ sáng nhỏ nhất sẽ giảm và kéo theo độ đồng đều của cả vùng 180⁰ cũng sẽ giảm đi 42,5% (1/2 của 85%). Với sai số của đầu đo độ rọi cho phép 10% (TCVN 5176-1990) thì độ đồng đều tối thiểu phải đạt 32,5%.
- Áp dụng công thức (1) ta tính được quang thông cần thiết cho các đèn dã chiến màu đỏ, trắng, vàng và xanh lá cây lần lượt là: 50.7lm, 562.02lm, 174lm và 175.44lm.
- Áp dụng công thức (1’) và (1’’) ta tính được công suất của các cụm đèn LED tương ứng với các LED màu đỏ, trắng, vàng và xanh lá cây lần lượt là: 0.78W, 6.46W, 3.48W và 1.36W.
- Áp dụng công thức (2) với các tham số:

H1 = 85% (độ đồng đều ánh áng của đèn cao không cấu trúc kép LED).

Hi = 32,5% (độ đồng đều tối thiểu của đèn dã chiến theo thiết kế).

I2 = 1.9 (cd) (đèn dã chiến màu đỏ).

I3 = 20.9 (cd) (với đèn dã chiến màu trắng).

I4 = 6.5 (cd) (với đèn dã chiến màu vàng).

I5 = 6,5 (cd) (với đèn dã chiến màu xanh lá cây)

Hiệu suất của các đèn LED màu đỏ, trắng, vàng, xanh lá cây được nêu trong tài liệu kĩ thuật của các loại LED.

- Ta được bảng giá trị cường độ sáng tương ứng với công suất đèn LED đối với các màu đèn dã chiến khác nhau như sau:

TT | Loại Đèn dã chiến | Hiệu suất LED (lm/W) | Quang thông (lm) | Độ đồng đều thiết kế (%) | Cường độ sáng nhỏ nhất thiết kế 0⁰-6⁰ (cd) | Cường độ sáng nhỏ nhất 0⁰-6⁰ (cd) | Cường độ sáng yêu cầu 0⁰-6⁰ (cd) | Công suất LED (W)
1 | Đèn cao không LED | 68 | 342,72 | 85,0% | 39,20 | 33,3 | 32 | 5,04
2 | Đèn dã chiến màu đỏ | 65 | 50,70 | 32,5% | | 1,9 | 1,8 | 0,78
3 | Đèn dã chiến màu trắng | 87 | 562,02 | 32,5% | | 20,9 | 20 | 6,46
4 | Đèn dã chiến màu vàng | 50 | 174,00 | 32,5% | | 6,5 | 6,2 | 3,48
5 | Đèn dã chiến màu xanh lá cây | 129 | 175,44 | 32,5% | | 6,5 | 6,2 | 1,36

- Đối với các đèn dã chiến hai màu, công suất tổng cộng của đèn sẽ là tổng công suất của từng màu, do đó công suất cụm LED của từng màu tương ứng sẽ bằng một nửa công suất trong bảng trên, cụ thể như sau:

TT | Loại đèn dã chiến | Màu sắc | Độ đồng đều nhỏ nhất thiết kế (%) | Cường độ sáng thiết kế (cd) | Cường độ sáng yêu cầu (cd) | Công suất cụm LED (W)
1 | Đèn lề đường CHC Trắng - Vàng | White | 32.5% | 20.9 | 20 | 3.23
| | Yellow | 32.5% | 6.5 | 6.2 | 1.74
2 | Đèn giới hạn đường CHC kết hợp đèn thềm | Red | 32.5% | 1.9 | 1.8 | 0.39
| | Green | 32.5% | 6.5 | 6.2 | 0.68

- Từ những tính toán ở trên, ta thấy việc sử dụng cấu trúc quang học của đèn cao không cấu trúc kép LED (màu đỏ) khi thay thế bằng các chủng loại LED với các màu sắc khác (trắng, vàng, xanh lá, xanh dương) kết hợp với việc điều chỉnh công suất mỗi loại sẽ cho cường độ sáng của từng loại đèn dã chiến phù hợp với yêu cầu.

- Cụm đèn LED cũng được thiết kế để lắp vào khối tản nhiệt nhôm (được chế tạo và lắp trực tiếp với mạch điều khiển theo bản vẽ thiết kế) nhằm nâng cao hiệu suất, tuổi thọ cho LED.

- Với việc sử dụng các chụp kính hiện có được thiết kế với các kết cấu quang học giúp hội tụ chùm sáng, cường độ ánh sáng trong các góc -15o đến 15o theo phương dọc và ngang được tăng lên đáng kể từ 2-3 lần so với cường độ sáng danh định của các cụm đèn. Do đó, thiết kế các cụm đèn LED như trên sẽ đáp ứng hoàn toàn các tiêu chuẩn của ICAO, FAA.

- Với thiết kế cụm LED như trên ta dễ dàng tính được công suất tối đa của mỗi cụm LED khoảng 8W (8 bóng LED 1W), khi sử dụng với ắc quy 12V12Ah thời gian sử dụng liên tục theo lý thuyết được tính như sau (Coi các mạch điều khiển, mạch truyền thông không dây và các mạch phụ trợ chỉ là các mạch tín hiệu nhỏ, năng lượng tiêu tán không đáng kể):

t = (12V*12Ah)/8W = 18 (h)

- Với các mức sáng thấp hơn, công suất tiêu thụ của mỗi cụm LED giảm đi, thời gian sử dụng tăng lên, do đó, thời gian sử dụng ắc quy hoàn toàn đáp ứng thời gian sáng tiêu chuẩn 12h đã quy định trong FAA AC150/5345-50B.

## 4.2.2 Giải pháp thiết kế xe nguồn:

- Phần cơ khí:

- Trên cơ sở tham khảo một số kết cấu xe rơ mooc loại nhỏ tải trọng từ 750kg – 1500kg và các loại xe dã chiến của các hãng sản xuất như Metalite, Holland Aviation, YouYang… để lựa chọn thiết kế kết cấu xe nguồn cho đèn dã chiến. Xe nguồn được thiết kế trên cơ sở tận dụng tối đa các chi tiết, vật tư tiêu chuẩn có sẵn trên thị trường (lốp, nhíp, phanh, bánh dẫn hướng…) kết hợp với các kết cấu khung sàn, giá, thùng… do Công ty TNHH kỹ thuật Quản lý bay sản xuất.

- Cụ thể một số kết cấu chịu lực được thiết kế như sau:

- Khung xe được làm bằng thép U120, U80, thép hộp 120x60 hàn liên kết thành khung cứng vững, mạ kẽm nhúng nóng bảo vệ bề mặt.
- Thùng xe làm bằng thép tấm chấn tạo hình, hàn liên kết; sơn hoàn thiện màu vàng hàng không.
- Giá để đèn được thiết kế bậc thang thuận tiện cho việc triển khai đèn tại hiện trường.
- Thùng xe thiết kế mở theo kiểu cánh dơi, có tay đẩy hơi trợ lực khi mở thùng xe thao tác với các đèn. Sử dụng các loại ty nâng nắp thùng kết hợp với các phụ kiện gá lắp (Gas Spring, Lmax = 281mm; Lmin = 181mm; tải trọng ≥20kg; Misumi hoặc tương đương). Để tiện cho việc đóng mở, nắp thùng xe được lắp các tay nắm (USAN 160, Misumi hoặc tương đương), khóa nắp thùng (mã PKWSAJ1 hoặc tương đương).
- Thùng xe được bắt chặt vào khung sàn xe bằng liên kết bulông, đai ốc, đệm.
- Tủ nguồn và tủ đựng cáp sạc được đặt phía sau xe, cung cấp nguồn từ tủ nguồn qua hệ thống hộp chứa cáp đến các sạc. Tủ nguồn và tủ đựng cáp có kích thước 600x200x200mm, dày 1mm, sơn tĩnh điện màu ghi.
- Xe nguồn được thiết kế với 2 bánh lốp đặt dưới thùng xe, liên kết với khung sàn xe bằng hệ thống nhíp giảm sóc. Bánh xe sử dụng loại 5.00-13 (đường kính lốp 596mm; chiều rộng lốp 157mm) kết hợp với vành xe 4.00BX13.
- Trục xe bao gồm cả hệ thống may ơ, kết hợp hệ thống phanh kiểu tang trống. Trục xe có tải trọng 1500 Kg sử dụng trục RIGID GBR PLUS BS 1500, OHF 150mm, Rear axle (20058160) hoặc tương đương.
- Chọn bộ đôi nhíp kết cấu ba lá có tải trọng mỗi bên 750 kg (Leaf spring for Rigid axle 750 Kg – Part No. 1368092) hoặc tương đương, bao gồm cả các phụ kiện lắp đặt nhíp (Mounting material for leaf spring 750 kg – Part No. 1225345).
- Bánh phụ dẫn hướng được thiết kế lắp đặt tại càng xe đường kính bánh xe 200mm (Plus Jockey wheel – Part No. 1222437) kết hợp với bộ kẹp bánh dẫn hướng (Clamp Ø48 rigid T Bar - Part No. 20531810).
- Bộ khóa móc với xe kéo được đặt tại vị trí cuối của càng kết hợp với tay phanh (Overrun hitch V with AK 160 - Part No. 1250 147).
- Hệ thống phanh hãm tác động đồng thời lên hai bánh sau để đảm bảo an toàn khi khai thác, tay phanh được đặt tại càng xe.
- Các đèn báo được bố trí phía sau thân xe, hai bên thành xe bố trí các đèn phản quang để dễ nhận biết vào ban đêm.

- Màu sơn của xe nguồn sử dụng các màu sắc phù hợp với tiêu chuẩn hàng không, tương đương mẫu màu RAL 1021.

- Xe nguồn trong quá trình làm việc chủ yếu chịu tải trọng của Thùng xe và hệ thống đèn nên ta tính toán độ bền của khung sàn. Mặt khác trên xe, đèn được đặt vào hốc trên thùng xe, tại hai mặt của hốc chặn đèn theo chiều chuyển động của xe nguồn có chiều cao lớn hơn trọng tâm của đèn, nên đảm bảo đèn không bị lật do tác động của lực quán tính khi dừng xe. Xe nguồn di chuyển với vận tốc nhỏ, tuy nhiên, trong quá trình khai thác xe nguồn di chuyển không tránh được các rung xóc, nên tại các mặt xung quanh của hốc đặt đèn và mặt trong của cánh khoang chứa đèn được gắn các xốp, mút để giảm xóc và đảm bảo an toàn cho đèn.

- Tính toán kiểm tra độ bền của khung sàn:
a. Đặt vấn đề:

- Tổng tải trọng của thùng xe và các đèn dã chiến khoảng 900kg. Lấy hệ số an toàn k=1,3 ta có tải trọng tính toán cho hệ khung sàn là 1200kg. Vì vậy khung sàn chịu được tải trọng là 1200 Kg, kết cấu của khung sàn có dạng tấm bắt với khung, lực tác dụng vào tấm sẽ làm uốn cong, vì vậy bài toán có dạng uốn cong thuần túy .

Hình 32: Dạng bài toán uốn cong

- Tải trọng tác dụng lên sàn trong quá trình khai thác chủ yếu là khối lượng của xe và đèn, hướng và phương của lực tác dụng vuông góc lên mặt sàn của xe nguồn. Ta tập chung tính độ uốn của tấm sàn này.

b. Nội dung tính toán:

- Theo sách Sức bền vật liệu của các tác giả Thái Thế Hùng, Đặng Việt Cương, Nguyễn Nhật Thăng, Nhữ Phương Mai, Hoàng Thị Bích Thủy và Trần Đình Long - Nhà xuất bản khoa học kỹ thuật - Hà Nội 2005.

- Ta có điều kiện bền như sau:

- Trong đó:

σmax - là ứng suất sinh ra trong sàn xe (N/mm²)

| σ | - là ứng suất cho phép của vật liệu chế tạo sàn xe (N/mm²);

- Tra sách sổ tay thiết kế cơ khí tập 1 của PGS. Hà Văn Vui, Nhà xuất bản khoa học và kỹ thuật năm 2006. Tra bảng ứng suất cho phép của thép cacbon SS400 ta có: | σ | = 2400 (kg/cm2) = 235 (Mpa).

- Sử dụng phần mềm Solidwork tính toán ứng suất sinh ra trong sàn xe khi chịu tải trọng P = 1200kg ta được giá trị như hình 33:

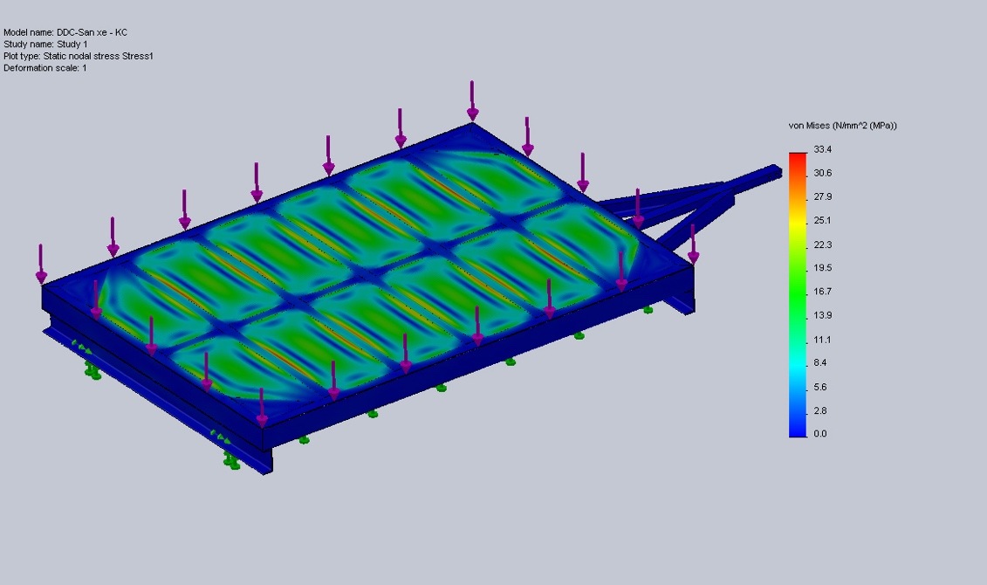
[picture p31: figure]
DDC-San xe - KC-Study 1-Stress-Stress1

Hình 33: Ứng suất sinh ra trong khung sàn xe

- Ta thu được kết quả:

σmax = 30.4 (Mpa)

c. Kết luận:

- Ta có σmax = 30.4 (Mpa) < | σ |= 235 (N/mm² ) như vậy khung sàn xe đảm bảo bền trong quá trình khai thác.

- Phần điện:

- Xe nguồn thiết kế vị trí lắp đặt tủ điện phân phối điện từ đầu vào 220VAC, 50/60Hz đến các bộ sạc ắc quy, vị trí lắp đặt tủ điện, dây cáp dẫn điện đảm bảo an toàn cho xe và người sử dụng khi cung cấp nguồn 220VAC, 50/60 Hz. Tủ điện phân phối được lắp đặt attomat tổng và qua các cầu chì (được gắn vào các đế có khả năng cách ly khi cần thiết) phân phối điện đến các bộ sạc ắc quy. Trong các trường hợp một vài bộ sặc ắc quy bị hỏng chỉ cần cách ly cầu chì để sửa chữa mà không làm ảnh hưởng đến hoạt động của các bộ sạc ắc quy khác.

- Xe nguồn thiết kế vị trí để đặt được tối thiểu 20 bộ sạc cho đèn, mỗi bộ sạc được cấp nguồn 220VAC từ tủ phân phối và sạc cho 3 đèn cùng lúc. Mỗi bộ sạc được thiết kế bao gồm 3 bộ nguồn 14.2 VDC, dòng điện tối đa 1.5A để sạc điện cho ắc quy trong các bộ đèn.

- Công suất tối đa theo lý thuyết đối với các thiết bị điện (ổ cắm, dây điện, attomat) được tính toán theo lý thuyết dựa trên công suất tối đa của các bộ sạc ắc quy:

- Công suất tối đa mỗi bộ sạc ắc quy (Hiệu suất các bộ sạc là 80%, mỗi bộ sạc ắc quy cho 3 đèn):

Pcharge_max = 3 * (14.2VDC * 1.5A) / 80% = 79.875 (W)

- Tổng công suất tối đa khi sử dụng 20 bộ sạc ắc quy đồng thời:

Ptotal = 79.875W * 20 = 1597.5 (W)

- Xe nguồn được trang bị các đèn báo phía sau và hai bên thân xe để nhận diện vào cảnh báo nguy hiểm trong quá trình di chuyển, triển khai hệ thống đèn dã chiến. Các đèn báo này được cấp nguồn bằng ắc quy lắp trong tủ điện phân phối trên xe nguồn.

# 5. Giải pháp công nghệ chế tạo

- Thực hiện chế tạo sản phẩm theo phương án chế tạo độc lập các module cấu thành hệ thống.

- Phương án chế tạo phần điện, điện tử và các thành phần phụ trợ:

- Mua các thiết bị, vật tư phần cứng.
- Lắp ráp cụm đèn, bộ điều khiển đèn, bộ điều khiển sạc ắc quy, bộ điều khiển từ xa cầm tay và bộ kết nối hệ thống điều khiển xa.
- Viết, Nạp phần mềm nhúng
- Chạy thử và hiệu chỉnh thông số kỹ thuật.

- Phương án chế tạo phần thân và chụp đèn:

- Mua các thiết bị, vật tư phần cứng.
- Sản xuất các bộ phận cơ khí
- Gia công khuôn thép phục vụ đúc áp lực các chi tiết gioăng
- Đúc áp lực các chi tiết gioăng phục vụ lắp ráp thân và chụp đèn
- Lắp ráp các chi tiết chế tạo với các chi tiết sẵn có (chụp kính, bộ gá…)

- Phương án chế tạo phần xe nguồn:

- Mua các thiết bị, vật tư phần cứng.
- Sản xuất các bộ phận cơ khí
- Lắp ráp các chi tiết

- Các module sau khi được chế tạo sẽ được tích hợp thành một sản phẩm hoàn chỉnh.

- Lắp ráp các chi tiết phần điện, phần thân và chụp đèn, phần xe nguồn.
- Hiệu chỉnh các thành phần và thử nghiệm sản phẩm
- Hoàn thiện sản phẩm.

# 6. Danh mục bản vẽ thiết kế

TT | Tên bản vẽ | Kí hiệu bản vẽ
I | PHẦN ĐIỆN TỬ
1 | Danh mục bản vẽ hệ thống | PL-00
2 | Sơ đồ khối hệ thống | PL-01
3 | Sơ đồ khối đèn dã chiến | PL-LMP-01
4 | Cụm đèn LED - Sơ đồ nguyên lý | PL-LMP-04
5 | Cụm đèn LED - Sơ đồ mạch in | PL-LMP-05
6 | Cụm đèn LED - Sơ đồ linh kiện | PL-LMP-03
7 | Mạch LED đơn - Sơ đồ nguyên lý, mạch in, linh kiện | PL-LMP-06
8 | Mạch hiển thị trạng thái - Sơ đồ nguyên lý | PL-LMP-07
9 | Mạch hiển thị trạng thái - Sơ đồ mạch in | PL-LMP-08
10 | Mạch hiển thị trạng thái - Sơ đồ linh kiện | PL-LMP-09
11 | Mạch điều khiển - Sơ đồ nguyên lý | PL-LMP-10
12 | Mạch điều khiển - Sơ đồ mạch in | PL-LMP-11
13 | Mạch điều khiển - Sơ đồ linh kiện | PL-LMP-12
14 | Bộ điều khiển cầm tay - Sơ đồ khối | PL-HRU-01
15 | Bộ điều khiển cầm tay - Sơ đồ nguyên lý | PL-HRU-02
16 | Bộ điều khiển cầm tay - Sơ đồ mạch in | PL-HRU-03
17 | Bộ điều khiển cầm tay - Sơ đồ linh kiện | PL-HRU-04
18 | Bộ kết nối hệ thống điều khiển đèn hiệu - Sơ đồ khối | PL-RU-01
19 | Bộ kết nối hệ thống điều khiển đèn hiệu - Sơ đồ nguyên lý | PL-RU-02
20 | Bộ kết nối hệ thống điều khiển đèn hiệu - Sơ đồ mạch in | PL-RU-03
21 | Bộ kết nối hệ thống điều khiển đèn hiệu - Sơ đồ linh kiện | PL-RU-04
22 | Mạch main bộ sạc ắc quy - Sơ đồ nguyên lý | PL-CU-01
23 | Mạch main bộ sạc ắc quy - Sơ đồ mạch in | PL-CU-02
24 | Mạch main bộ sạc ắc quy - Sơ đồ linh kiện | PL-CU-03
25 | Mạch module cấp nguồn 14V - Sơ đồ nguyên lý | PL-CU-04
26 | Mạch module cấp nguồn 14V - Sơ đồ mạch in | PL-CU-05
27 | Mạch module cấp nguồn 14V - Sơ đồ linh kiện | PL-CU-06
II | PHẦN CƠ KHÍ ĐÈN DÃ CHIẾN
1 | Đèn dã chiến (bản vẽ lắp) | PL-LMP-12-00
2 | Đèn dã chiến (bản vẽ lắp) | PL-LMP-12-00
3 | Tấm đế, gioăng 1, tấm che, bạc | PL-LMP-12-01; PL-LMP-12-03; PL-LMP-12-12; PL-LMP-12-14
4 | Thân | PL-LMP-12-02
5 | Nắp | PL-LMP-12-04
6 | Bọc tay cầm, tay cầm, gioăng 2, đai kẹp | PL-LMP-12-05; PL-LMP-12-06; PL-LMP-12-07; PL-LMP-12-13
7 | Thân trên | PL-LMP-12-08
8 | Tấm gá | PL-LMP-12-09
9 | Chân đỡ | PL-LMP-12-10
10 | Cụm LED | PL-LMP-12-11
11 | Thân cụm LED | PL-LMP-12-11
12 | Màn che | PL-LMP-12-15
13 | Bộ điều khiển cầm tay - Hộp chứa | PL-HRU-05-00
14 | Bộ điều khiển cầm tay - Thân | PL-HRU-05-01
15 | Bộ điều khiển cầm tay - Nắp sau | PL-HRU-05-02
16 | Bộ kết nối hệ thống điều khiển đèn hiệu - Hộp chứa | PL-RU-05-00
17 | Bộ kết nối hệ thống điều khiển đèn hiệu - Thân | PL-RU-05-01
18 | Bộ kết nối hệ thống điều khiển đèn hiệu - Nắp dưới, nắp trên | PL-RU-05-02, PL-RU-05-03
19 | Bộ kết nối hệ thống điều khiển đèn hiệu - Tem thông số | PL-RU-05-04
20 | Bộ sạc ắc quy - Hộp chứa | PL-CU-07-00
21 | Bộ sạc ắc quy - Thân | PL-CU-07-01
22 | Bộ sạc ắc quy - Nắp dưới, nắp trước | PL-CU-07-02, PL-CU-07-03
23 | Bộ sạc ắc quy - Tem thông số | PL-CU-07-04
III | PHẦN CƠ KHÍ XE NGUỒN
1 | Xe nguồn (Bản vẽ 3D) | PL-XN-01-00
2 | Xe nguồn (hình chiếu đứng) | PL-XN-01-00
3 | Xe nguồn (Mặt cắt A-A) | PL-XN-01-00
4 | Xe nguồn (hình chiếu bằng) | PL-XN-01-00
5 | Xe nguồn (bảng kê) | PL-XN-01-00
6 | Khung | PL-XN-01-01
7 | Cánh | PL-XN-01-02
8 | Chắn bùn | PL-XN-01-03
9 | Thùng xe (hình chiếu đứng) | PL-XN-01-04
10 | Thùng xe (mặt cắt A-A) | PL-XN-01-04
11 | Thùng xe (mặt cắt B-B) | PL-XN-01-04
12 | Thùng xe (mặt cắt C-C) | PL-XN-01-04
13 | Thùng xe (Bảng kê) | PL-XN-01-04
14 | Tủ nguồn, tủ đựng cáp | PL-XN-01-05, PL-XN-01-06
15 | Bộ sạc | PL-XN-01-07
16 | Sơ đồ đấu nối hệ thống điện trên xe nguồn | PL-XN-02
IV | PHẦN ĐÓNG GÓI
1 | Hộp đèn dã chiến | DG-PL-LMP-12-00
2 | Hộp carton | DG-PL-LMP-12-01
3 | Tem thông số | DG-PL-LMP-12-02

# 7. Tiêu chí lựa chọn nhà cung ứng sản phẩm dịch vụ để mua linh kiện, thiết bị

- Đảm bảo tính pháp lý.

- Đảm bảo chất lượng sản phẩm.

- Có khả năng cung ứng lâu dài, ổn định.

- Có kinh nghiệm trong lĩnh vực điện, điện tử, tự động hóa.

- Có dịch vụ sau bán hàng tốt.

- Nhà cung ứng có áp dụng hệ thống quản lý chất lượng ISO 9001:2015 là một yếu tố ưu tiên.

Hà nội, ngày tháng năm

Người lập

Ngô Quý Tuấn
