ngoquytuan/DenDaChien/2019/20May19/BanVeDenDaChien2019 27.03.2019/Dien tu/PL-HRU-01.pdf

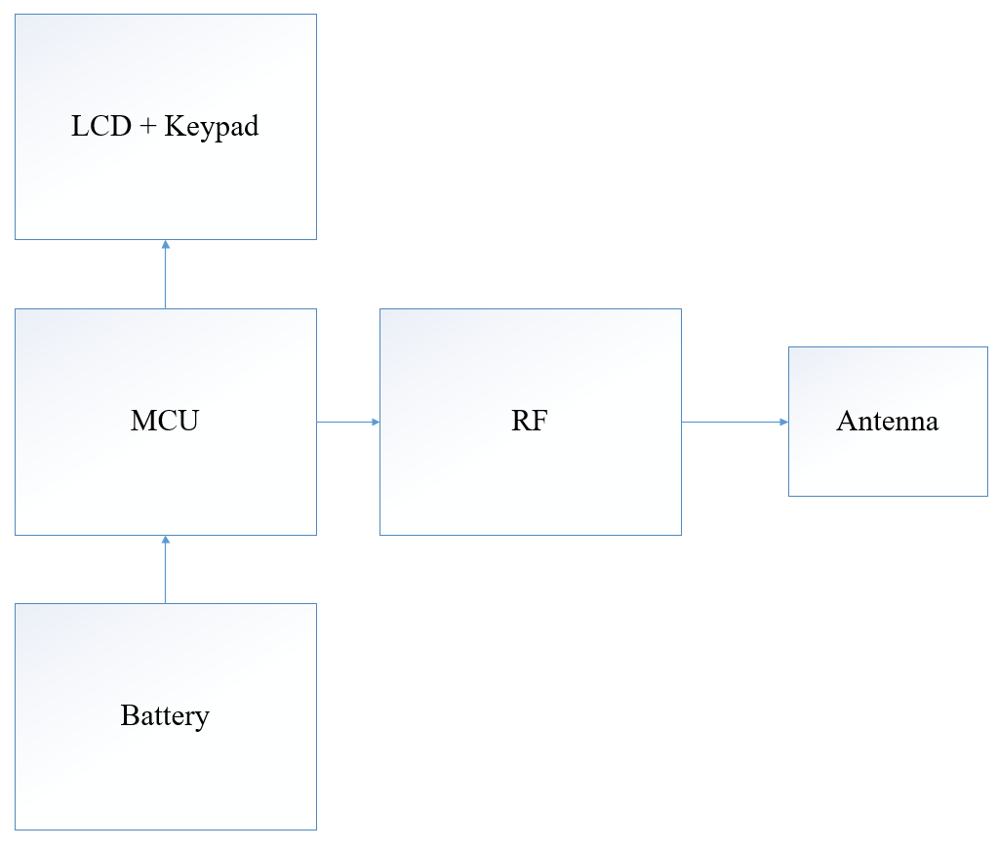
[picture p67: figure]

## SƠ ĐỒ KHỐI BỘ ĐIỀU KHIỂN CẦM TAY

| SLSĐ | Họ và tên | Ký | Ngà y
Chủ trì | Ngô Quý Tuấn | | | | Số lượng | Khối lượng | Tỷ lệ
Kiểm tra | Ng.Tiến Hùng
Thiết kế | Ngô Quý Tuấn | | | | Tờ số: | Tổng số tờ:
QLKT | Ng.Tiến Hùng | | | | Công Ty TNHH Kỹ Thuật Quản Lý Bay Vật liệu: | | PHÒNG NCPT
Duyệt | Phạm.Q.Tuấn

## PL-HRU-01

Hệ thống Đèn dã chiến
