ngoquytuan/DenDaChien/2019/20May19/BanVeDenDaChien2019 27.03.2019/Co khi/ban ve den da chien, Tien luong/02 PL-LMP-12-00 Den CHC (bang ke).pdf

37 | PL-LMP-12-05 | Bọc tay cầm | Cái | 1 | Cao su silicon | TK chế tạo | Loại trong suốt
36 | | Giắc sạc | Bộ | 1
35 | | Công tắc | Bộ | 2
34 | | Vít M4x16 | Bộ | 2 | | Mua TC | Vít (ISO 7045) + Đệm vênh (DIN 128) + Đệm phẳng (DIN 125)
33 | | Vít M4x25 | Bộ | 4 | | Mua TC | Vít (ISO 7045) + Đệm vênh (DIN 128)
32 | PL-LMP-12-15 | Màn che | Cái | 1 | A1100 | TK chế tạo | Anodizing màu trắng
31 | | Vít tai chuồn M6x20 | Bộ | 2 | | Mua TC | Vít (DIN 316) + Đệm vuông (DIN 557)
30 | PL-LMP-12-14 | Bạc | Cái | 2 | SUS304 | TK chế tạo
29 | | Đệm phẳng 6.3 | Cái | 2 | SUS304 | Mua TC | DIN 125
28 | | Vít M4x10 | Cái | 4 | | Mua TC | Vít (ISO 7046)
27 | | Vít M4x16 | Cái | 4 | | Mua TC | Vít (ISO 7046)
26 | | Vít M4x10 | Bộ | 4 | | Mua TC | Vít (ISO 7045) + Đệm vênh (DIN 125)
25 | PL-LMP-12-13 | Đai kẹp | Cái | 1 | SUS304 | TK chế tạo
24 | | Vít M3x10 | Bộ | 4 | | Mua TC | Vít (ISO 7045) + Đệm phẳng (DIN 125)
23 | | Ống luồn dây | Bộ | 1 | | Mua TC | PG7
22 | PL-LMP-12-12 | Tấm che | Cái | 1 | PC | TK chế tạo | Loại màu trong
21 | | Cầu chì | Cái | 1
20 | | Ăng ten | Cái | 1
19 | | Đệm phẳng 6.3 | Cái | 1 | | Mua TC | DIN 125
18 | | Đệm vênh 6 | Cái | 1 | | Mua TC | DIN 128
17 | | Vít M6x16 | Cái | 1 | | Mua TC | Vít (ISO 7045)
16 | PL-LMP-12-11 | Cụm LED | Cái | 1 | A6063 | TK chế tạo | Anodizing màu trắng
15 | PL-LMP-12-10 | Chân đỡ | Cái | 1 | A6063 | TK chế tạo | Anodizing màu trắng
14 | | Kính chụp ngoài | Cái | 1 | Thuỷ tinh | Mua TC | G6625, màu xanh dương (blue) cho đèn lề đường lăn dã chiến
14 | | Kính chụp ngoài | Cái | 1 | Thuỷ tinh | Mua TC | G6625, trong suốt (clear) cho các loại đèn dã chiến trừ đèn lề đường lăn dã chiến
13 | PL-LMP-12-09 | Tấm gá | Cái | 1 | A5052 | TK chế tạo | Anodizing màu trắng
12 | PL-LMP-12-08 | Thân trên | Cái | 1 | A5052 | TK chế tạo | Sơn tĩnh điện mã màu RAL1021
11 | PL-LMP-12-07 | Gioăng 2 | Cái | 1 | EPDM | TK chế tạo | Cao su màu trắng
10 | PL-LMP-12-06 | Tay cầm | Cái | 1 | SUS304 | TK chế tạo
9 | | Mạch điều khiển | Cái | 1
8 | | Vít M3x6 | Bộ | 12 | SUS304 | Mua TC | Vít (ISO 7045) + Đệm vênh (DIN 128) + Đệm phẳng (DIN 125) | ĐÈN DÃ CHIẾN (bảng kê) | HỆ THỐNG ĐÈN DÃ CHIẾN
7 | | Ống dẫn sáng | Cái | 5 | Silicon | | Mua TC | Silicon loại trong mã SN-501
6 | | Mạch báo hiệu | Cái | 1 | | | | | DH | SL | Họ và tên | Ký | Ngày
5 | PL-LMP-12-04 | Nắp | Cái | 1 | PP | | TK chế tạo | Nhựa màu vàng mã RAL1021 | Duyệt | Phạm.Q.Tuấn | | | | Số lượng | Khối lượng | Tỷ lệ
4 | PL-LMP-12-03 | Gioăng 1 | Cái | 1 | EPDM | | TK chế tạo | Cao su màu trắng
3 | | Ắc quy | Cái | 1 | | | Mua TC | mã VT1212
2 | PL-LMP-12-02 | Thân | Cái | 1 | PA | | TK chế tạo | Nhựa màu vàng mã RAL1021
1 | PL-LMP-12-01 | Tấm đế | Cái | 1 | SS400 | | TK chế tạo | Sơn tĩnh điện mã màu RAL1021
| | | | | | | | | Vẽ | Phạm M. Linh
Stt | Mã hiệu | Tên gọi | Đ.Vị | Số lượng | Vật liệu | Kích thước | PA đáp ứng | Ghi chú
Chủ trì | Ngô Quý Tuấn | | | | 1:3
Kiểm tra | Ng.Tiến Hùng | | Tờ số: 02 | Tổng số tờ: 02
Thiết kế | Phạm M. Linh | Vật liệu: | Công Ty TNHH Kỹ Thuật Quản Lý Bay | | Xí nghiệp CTTBHK

# PL-LMP-12-00
