ngoquytuan/DenDaChien/2019/20May19/BanVeDenDaChien2019 27.03.2019/Co khi/ban ve dong goi/03 DG-PL-LMP-12-02 Tem thong so.pdf

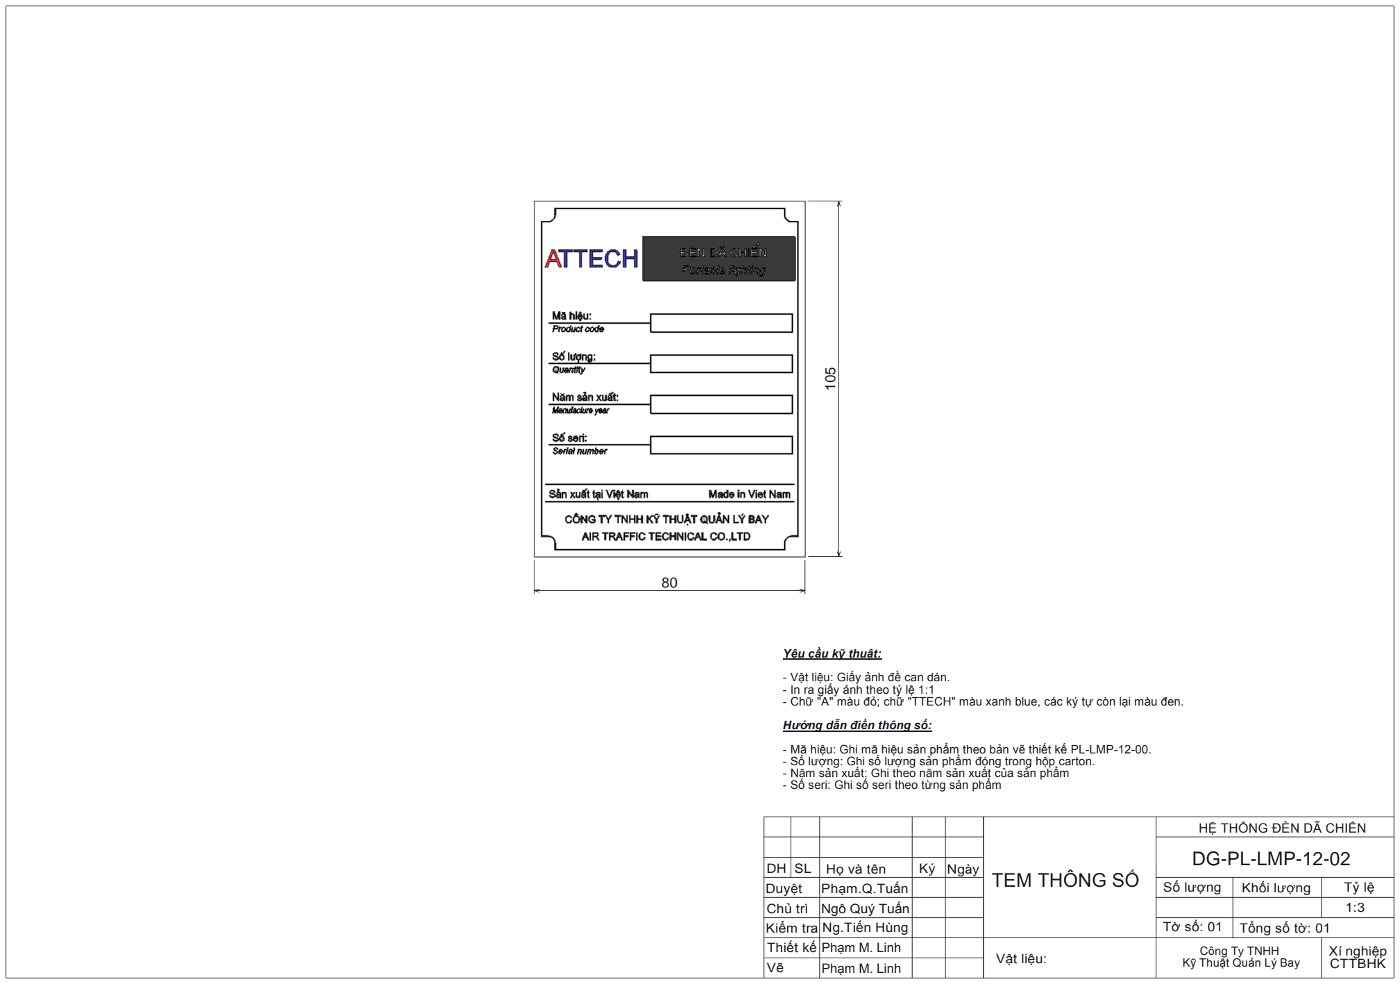
[picture p68: page 1]

80

105

Yêu cầu kỹ thuật:

- Vật liệu: Giấy ảnh đề can dán.
- In ra giấy ảnh theo tỷ lệ 1:1
- Chữ "A" màu đỏ; chữ "TTECH" màu xanh blue, các ký tự còn lại màu đen.

Hướng dẫn điền thông số:

- Mã hiệu: Ghi mã hiệu sản phẩm theo bản vẽ thiết kế PL-LMP-12-00.
- Số lượng: Ghi số lượng sản phẩm đóng trong hộp carton.
- Năm sản xuất: Ghi theo năm sản xuất của sản phẩm
- Số seri: Ghi số seri theo từng sản phẩm

## TEM THÔNG SỐ

## DG-PL-LMP-12-02

DH | SL | Họ và tên | Ký | Ngày
Duyệt | Phạm.Q.Tuấn | | | | Số lượng | Khối lượng | Tỷ lệ
Chủ trì | Ngô Quý Tuấn | | | | | | 1:3
Kiểm tra | Ng.Tiến Hùng | | | | Tờ số: 01 | Tổng số tờ: 01
Thiết kế | Phạm M. Linh | | | Vật liệu: | Công Ty TNHH Kỹ Thuật Quản Lý Bay | | Xí nghiệp CTTBHK
Vẽ | Phạm M. Linh

HỆ THỐNG ĐÈN DÃ CHIẾN
