ngoquytuan/DenDaChien/2019/20May19/BanVeDenDaChien2019 27.03.2019/Co khi/ban ve dong goi/danh muc DG.pdf

3 | DG-PL-LMP-12-02 | Tem thông số | Cái | 1 | | | TK chế tạo
2 | DG-PL-CK-03-01 | Hộp carton | Cái | 1 | | | Mua tiêu chuẩn
1 | DG-PL-LMP-12-00 | Hộp đèn dã chiến | Cái | 1 | | | TK chế tạo
Stt | Mã hiệu | Tên gọi | Đơn vị | Số lượng | Vật liệu | Kích thước | PA đáp ứng | Ghi chú
| | | | | DANH MỤC BẢN VẼ ĐÓNG GÓI | HỆ THỐNG ĐÈN DÃ CHIẾN

# DMDGPLCK-03-00

| SLDH | Họ và tên | Ký | Ngày
Duyệt | Phạm.Q.Tuấn | | | | Số lượng | Khối lượng | Tỷ lệ
Chủ trì | Ngô Quý Tuấn
Kiểm tra | Ng.Tiến Hùng | | | | Tờ số: 01 | Tổng số tờ: 01
Thiết kế | Phạm M. Linh | | | Vật liệu: | Công Ty TNHH Kỹ Thuật Quản Lý Bay | | Phòng NCPT
Vẽ | Phạm M. Linh
