ngoquytuan/DenDaChien/2019/20May19/BanVeDenDaChien2019 27.03.2019/Co khi/ban ve xe nguon/XN-LR-01.pdf

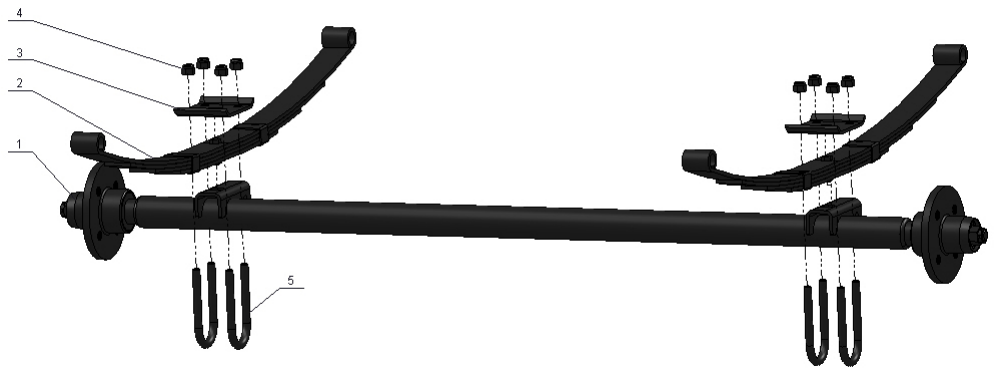
[picture p69: figure]

4 | XN-LR-01-04 | Bulông+ Đai ốc M12 | Bộ | 8 | | | Mua TC
3 | XN-LR-01-03 | Tấm kẹp | Cái | 2 | | | Mua TC
2 | XN-LR-01-02 | Bộ Nhíp | Cái | 2 | | | Mua TC
1 | XN-LR-01-01 | Trục xe và may rơ | Cái | 1 | | | Mua TC
Stt | Mã hiệu | Tên gọi | Đ.Vị | Số lượng | Vật liệu | Kích thước | PA đáp ứng | Ghi chú
| | | | | CỤM LẮP RÁP SỐ 1 | HỆ THỐNG ĐÈN DÃ CHIẾN
DH | SL | Họ và tên | Ký | Ngày
Duyệt | Phạm.Q.Tuấn | | | | Số lượng | Khối lượng | Tỷ lệ
Chủ trì | Ngô Quý Tuấn | | | | | | 1:10
Kiểm tra | Ng.Tiến Hùng | | | | Tờ số: | Tổng số tờ:
Thiết kế | Phạm M. Linh | | | Vật liệu: | Công Ty TNHH Kỹ Thuật Quản Lý Bay | | NCPT
Vẽ | Phạm M. Linh

# XN-LR-01
