ngoquytuan/DenDaChien/2019/20May19/BanVeDenDaChien2019 27.03.2019/Co khi/ban ve xe nguon/XN-LR-02.pdf

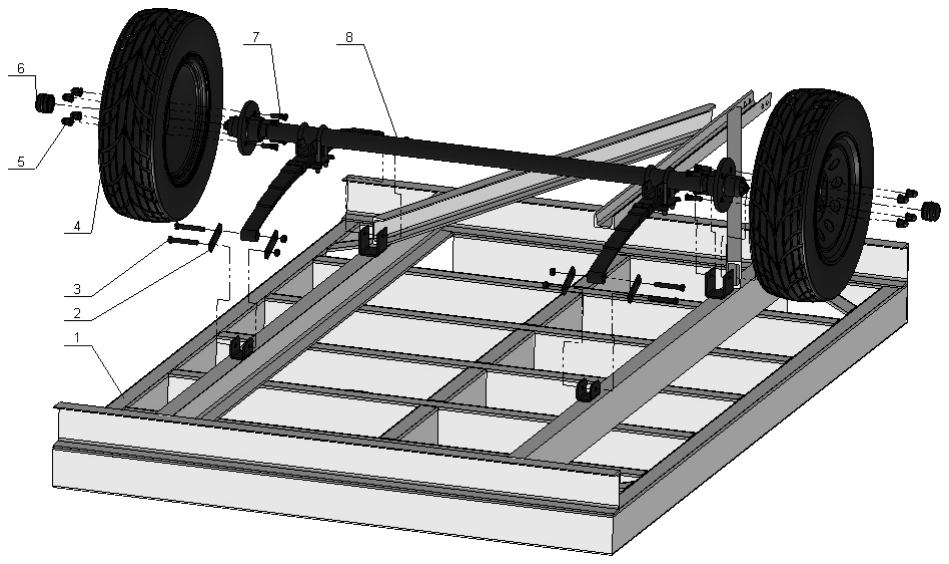
[picture p70: figure]

8 | XN-LR-01 | Cụm lắp ráp số 1 | Bộ | 1 | | | Mua TC
7 | XN-LR-02-07 | Bulông M12x50 | Bộ | 8 | | | Mua TC
6 | XN-LR-02-06 | Nắp trục | Cái | 2 | | | Mua TC
5 | XN-LR-02-05 | Đai ốc mũ | Cái | 8 | | | Mua TC
4 | XN-LR-02-04 | Bánh xe + vành | Bộ | 2 | | | Mua TC
3 | XN-LR-02-03 | Bulông M12x80 | Bộ | 6 | | | Mua TC
2 | XN-LR-02-02 | Khẹp nhíp | Cái | 4 | | | Mua TC
1 | XN-LR-02-01 | Khung xe | Bộ | 1 | | | TK chế tạo
Stt | Mã hiệu | Tên gọi | Đ.Vị | Số lượng | Vật liệu | Kích thước | PA đáp ứng | Ghi chú
| | | | | CỤM LẮP RÁP SỐ 2 | HỆ THỐNG ĐÈN DÃ CHIẾN
DH | SL | Họ và tên | Ký | Ngày
Duyệt | Phạm.Q.Tuấn | | | | Số lượng | Khối lượng | Tỷ lệ
Chủ trì | Ngô Quý Tuấn | | | | | | 1:10
Kiểm tra | Ng.Tiến Hùng | | | | Tờ số: | Tổng số tờ:
Thiết kế | Phạm M. Linh | | | Vật liệu: | Công Ty TNHH Kỹ Thuật Quản Lý Bay | | NCPT
Vẽ | Phạm M. Linh

# XN-LR-02
