ngoquytuan/DenDaChien/2019/20May19/BanVeDenDaChien2019 27.03.2019/Co khi/ban ve xe nguon/XN-LR-03.pdf

3 | PL-XN-01-02 | Chốt khóa | Cái | 1 | | | Mua TC
2 | PL-XN-01-02 | Bộ bánh dẫn hướng | Bộ | 1 | | | Mua TC
1 | PL-XN-01-01 | Cụm 2 | Bộ | 1 | | | TK chế tạo
Stt | Mã hiệu | Tên gọi | Đ.Vị | Số lượng | Vật liệu | Kích thước | PA đáp ứng | Ghi chú
| | | | | CỤM LẮP RÁP SỐ 3 | HỆ THỐNG ĐÈN DÃ CHIẾN
DH | SL | Họ và tên | Ký | Ngày
Duyệt | Phạm.Q.Tuấn | | | | Số lượng | Khối lượng | Tỷ lệ
Chủ trì | Ngô Quý Tuấn | | | | | | 1:10
Kiểm tra | Ng.Tiến Hùng | | | | Tờ số: | Tổng số tờ:
Thiết kế | Phạm M. Linh | | | Vật liệu: | Công Ty TNHH Kỹ Thuật Quản Lý Bay | | NCPT
Vẽ | Phạm M. Linh

# XN-LR-03
