ngoquytuan/DenDaChien/2019/20May19/BanVeDenDaChien2019 27.03.2019/Co khi/ban ve xe nguon/XN-LR-04.pdf

3 | XN-LR-04-02 | Bulông 10x30 | Bộ | 6 | | | Mua TC
2 | XN-LR-04-01 | Thùng xe | Bộ | 1 | | | TK chế tạo
1 | XN-LR-03 | Cụm 3 | Bộ | 1 | | | TK chế tạo
Stt | Mã hiệu | Tên gọi | Đ.Vị | Số lượng | Vật liệu | Kích thước | PA đáp ứng | Ghi chú
| | | | | CỤM LẮP RÁP SỐ 4 | HỆ THỐNG ĐÈN DÃ CHIẾN
DH | SL | Họ và tên | Ký | Ngày
Duyệt | Phạm.Q.Tuấn | | | | Số lượng | Khối lượng | Tỷ lệ
Chủ trì | Ngô Quý Tuấn | | | | | | 1:10
Kiểm tra | Ng.Tiến Hùng | | | | Tờ số: | Tổng số tờ:
Thiết kế | Phạm M. Linh | | | Vật liệu: | Công Ty TNHH Kỹ Thuật Quản Lý Bay | | NCPT
Vẽ | Phạm M. Linh

# XN-LR-04
