ngoquytuan/DenDaChien/2019/20May19/BanVeDenDaChien2019 27.03.2019/Co khi/ban ve xe nguon/XN-LR-05.pdf

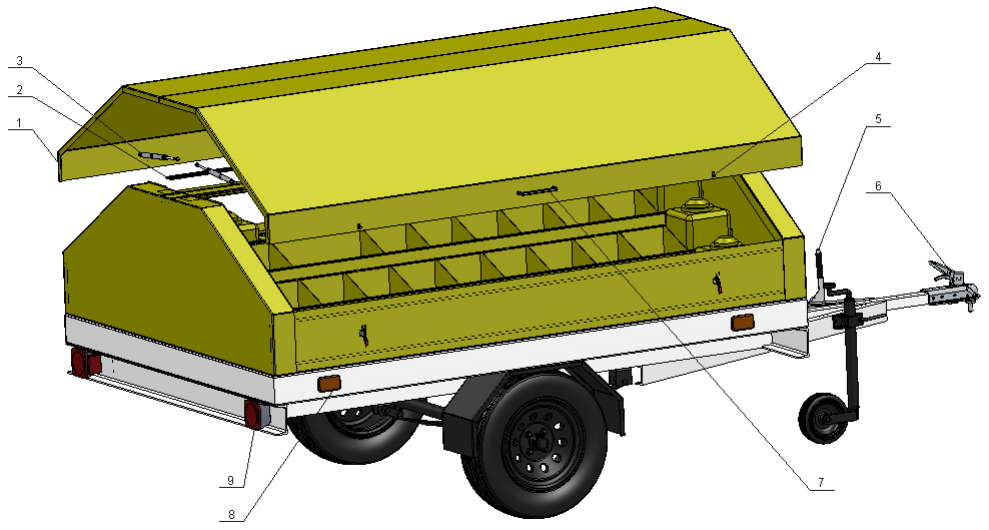
[picture p71: figure]

9 | XN-LR-05-09 | Đèn signal | Bộ | 2 | | | Mua TC
8 | XN-LR-05-08 | Đèn phản quang | Cái | 4 | | | Mua TC
7 | XN-LR-05-07 | Tay cầm | Bộ | 2 | | | Mua TC
6 | XN-LR-05-06 | Bộ khớp nối | Bộ | 1 | | | Mua TC
5 | XN-LR-05-05 | Tay phanh | Bộ | 1 | | | Mua TC
4 | XN-LR-05-04 | Khóa nắp thùng | Bộ | 4 | | | Mua TC
3 | XN-LR-05-03 | Ty nâng | Bộ | 4 | | | Mua TC | mã USAN160 hoặc tương đương
2 | XN-LR-05-02 | Bản lề | Bộ | 2 | | | TK chế tạo | Sơn tĩnh điện mã màu RAL1021
1 | XN-LR-05-01 | Nắp | Bộ | 2 | | | TK chế tạo | Mạ kẽm nhúng nóng ASTM123A
Stt | Mã hiệu | Tên gọi | Đ.Vị | Số lượng | Vật liệu | Kích thước | PA đáp ứng | Ghi chú
| | | | | CỤM LẮP RÁP SỐ 5 | HỆ THỐNG ĐÈN DÃ CHIẾN
DH | SL | Họ và tên | Ký | Ngày
Duyệt | Phạm.Q.Tuấn | | | | Số lượng | Khối lượng | Tỷ lệ
Chủ trì | Ngô Quý Tuấn | | | | | | 1:10
Kiểm tra | Ng.Tiến Hùng | | | | Tờ số: | Tổng số tờ:
Thiết kế | Phạm M. Linh | | | Vật liệu: | Công Ty TNHH Kỹ Thuật Quản Lý Bay | | NCPT
Vẽ | Phạm M. Linh

# XN-LR-05
