ngoquytuan/DenDaChien/2019/20May19/BanVeDenDaChien2019 27.03.2019/Co khi/Cac hop dieu khien/Hop DK DDC/Mach KN HTDH/PL-RU-05-04.pdf

Yêu cầu kỹ thuật

- Chữ "ATTECH" có chữ "A" màu đỏ, chữ "TTECH" màu xanh Blue font arial 20 thường (chiều cao chữ 5.1).
- Chữ "BỘ KẾT NỐI HTĐKGS" font arial 11 hoa (chiều cao chữ 2.75) và "Remote unit" font arial 10 nghiêng (chiều cao chữ 2.5) chữ sơnmàu trắng, nền màu đen.
- Chữ "Mã hiệu:"; "Nguồn vào:"; "Tín hiệu điều khiển:"; "Số xuất xưởng:";"Năm sản xuất:"; "Sản xuất tại Việt Nam"; "Made in Viet Nam" chữ màu đen font arial 10 thường (chiều cao chữ 2.5).
- Các ký tự chữ,số khác màu đen font arial 8 nghiêng (chiều cao chữ 2.2).

Hướng dẫn đóng số

- Điền các thông số Số xuất xưởng, Năm sản xuất Xí nghiệp CTTBHK cung cấp.

HỆ THỐNG ĐÈN DÃ CHIẾN

## PL-RU-05-04 BỘ KẾT NỐI HỆ

# THỐNG ĐIỀU KHIỂN ĐÈN HIỆU-TEM

## THÔNG SỐ

| SLDH | Họ và tên | Ký | Ngày
Duyệt | Phạm.Q.Tuấn | | | | Số lượng | Khối lượng | Tỷ lệ
Chủ trì | Ngô Quý Tuấn | | | | | | 1:1
Kiểm tra | Ng.Tiến Hùng | | | | Tờ số: 01 | Tổng số tờ: 01
Thiết kế | Phạm M. Linh | | | Nhôm mặt xước Vật liệu: dày 0.3 | Công Ty TNHH Kỹ Thuật Quản Lý Bay | | Xí nghiệp CTTBHK
Vẽ | Phạm M. Linh

67

72

80

75
