ngoquytuan/DenDaChien/2019/20May19/BanVeDenDaChien2019 27.03.2019/Co khi/Tem den da chien/catalogue den da chien/2.jpg

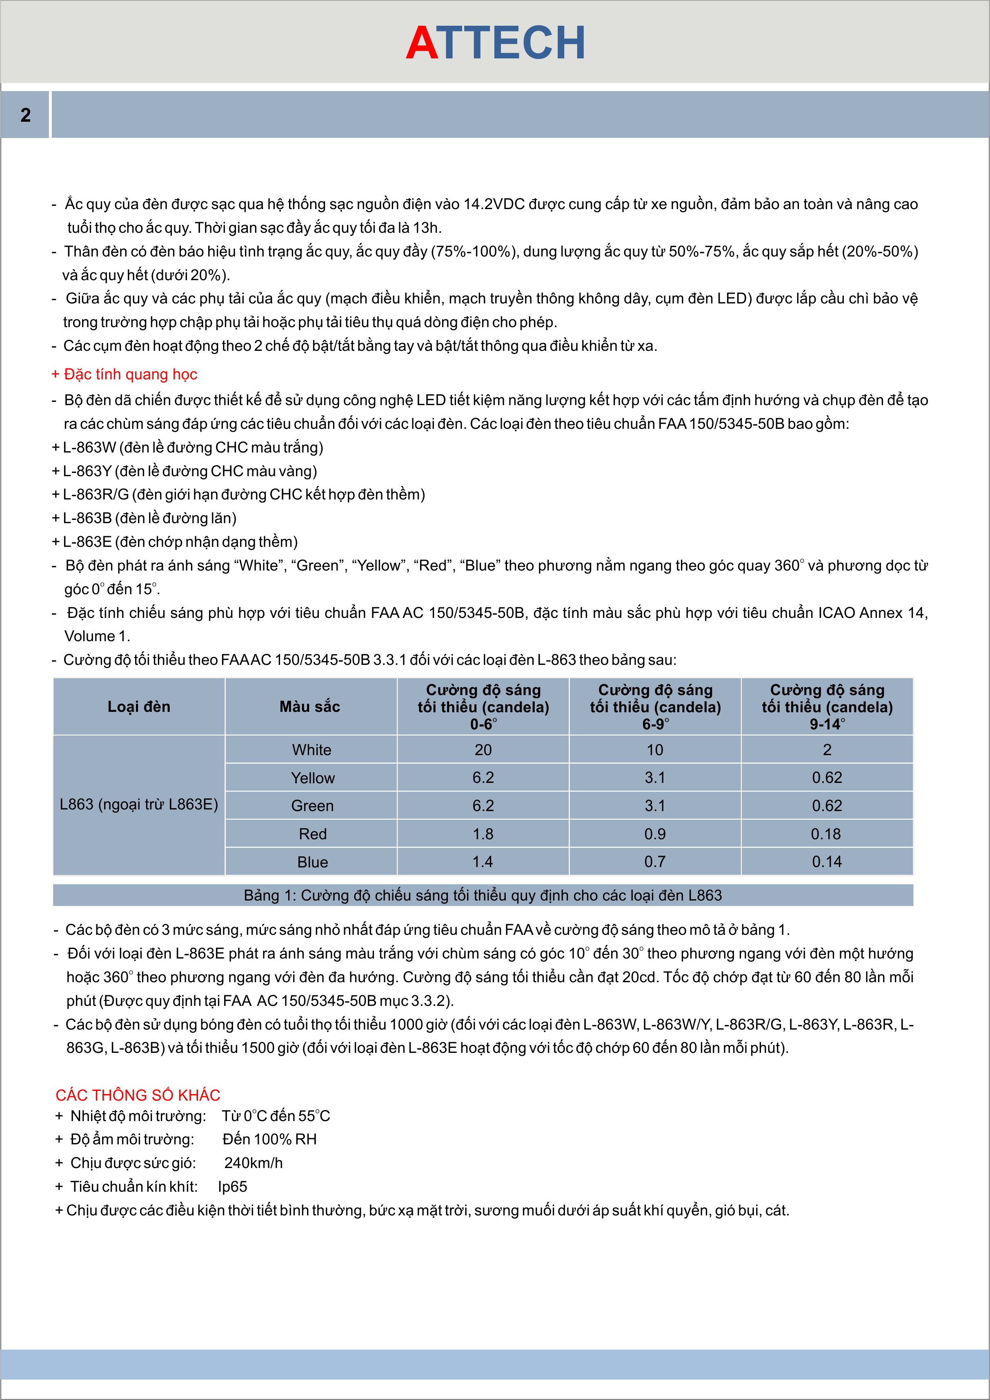
2019/20May19/BanVeDenDaChien2019 27.03.2019/Co khi/Tem den da chien/catalogue den da chien/2.jpg
