ngoquytuan/DenDaChien/2019/catalgue DEN DA CHIEN/3.jpg

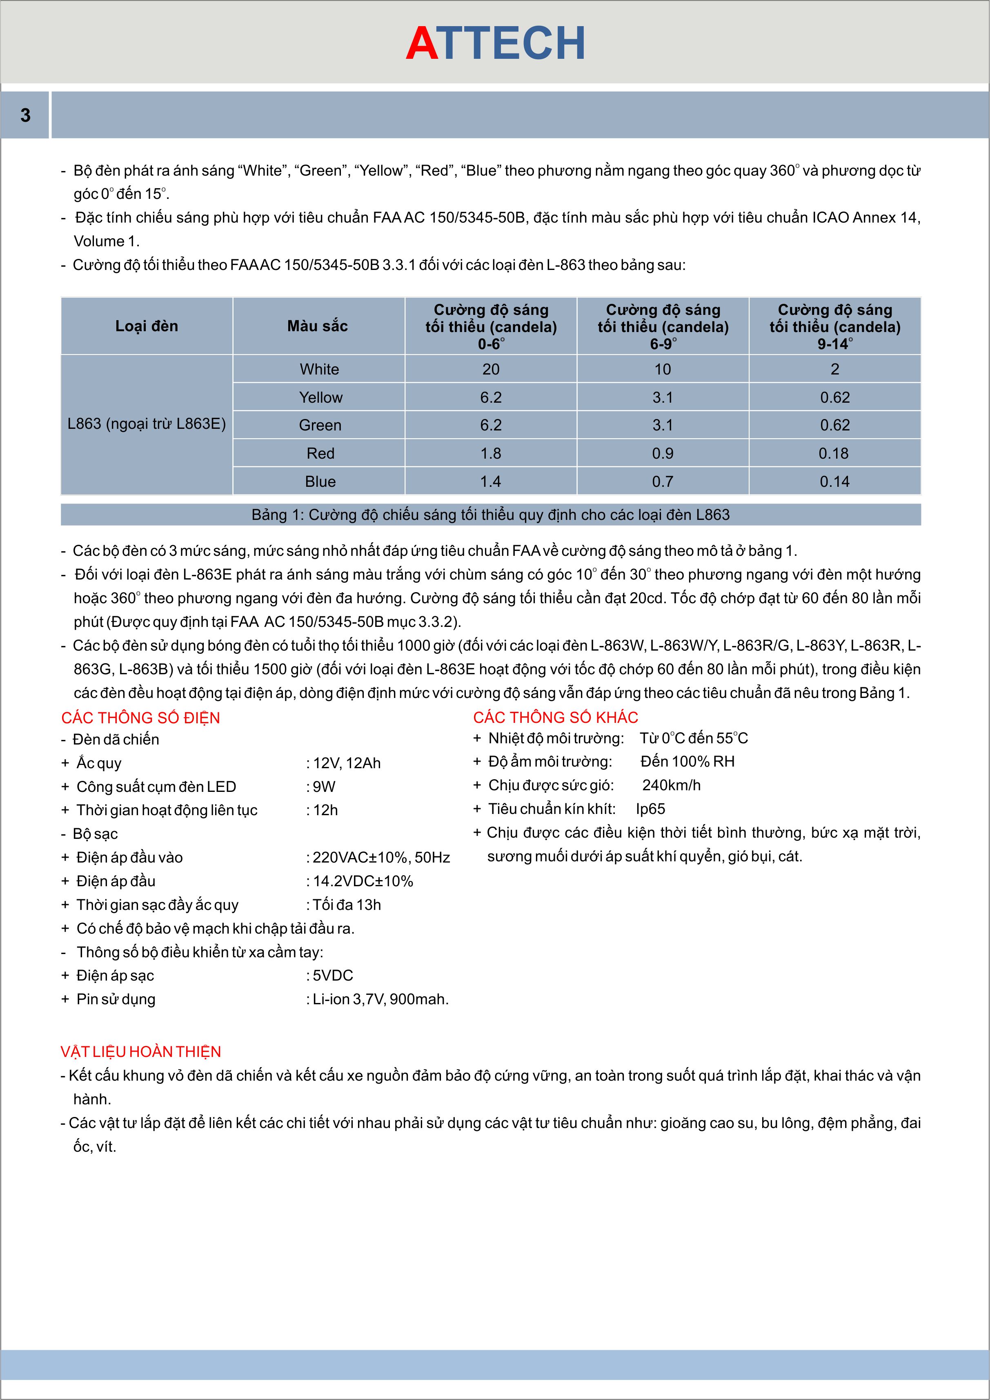
2019/catalgue DEN DA CHIEN/3.jpg
