ngoquytuan/DenDaChien/2019/catalgue DEN DA CHIEN/4.jpg

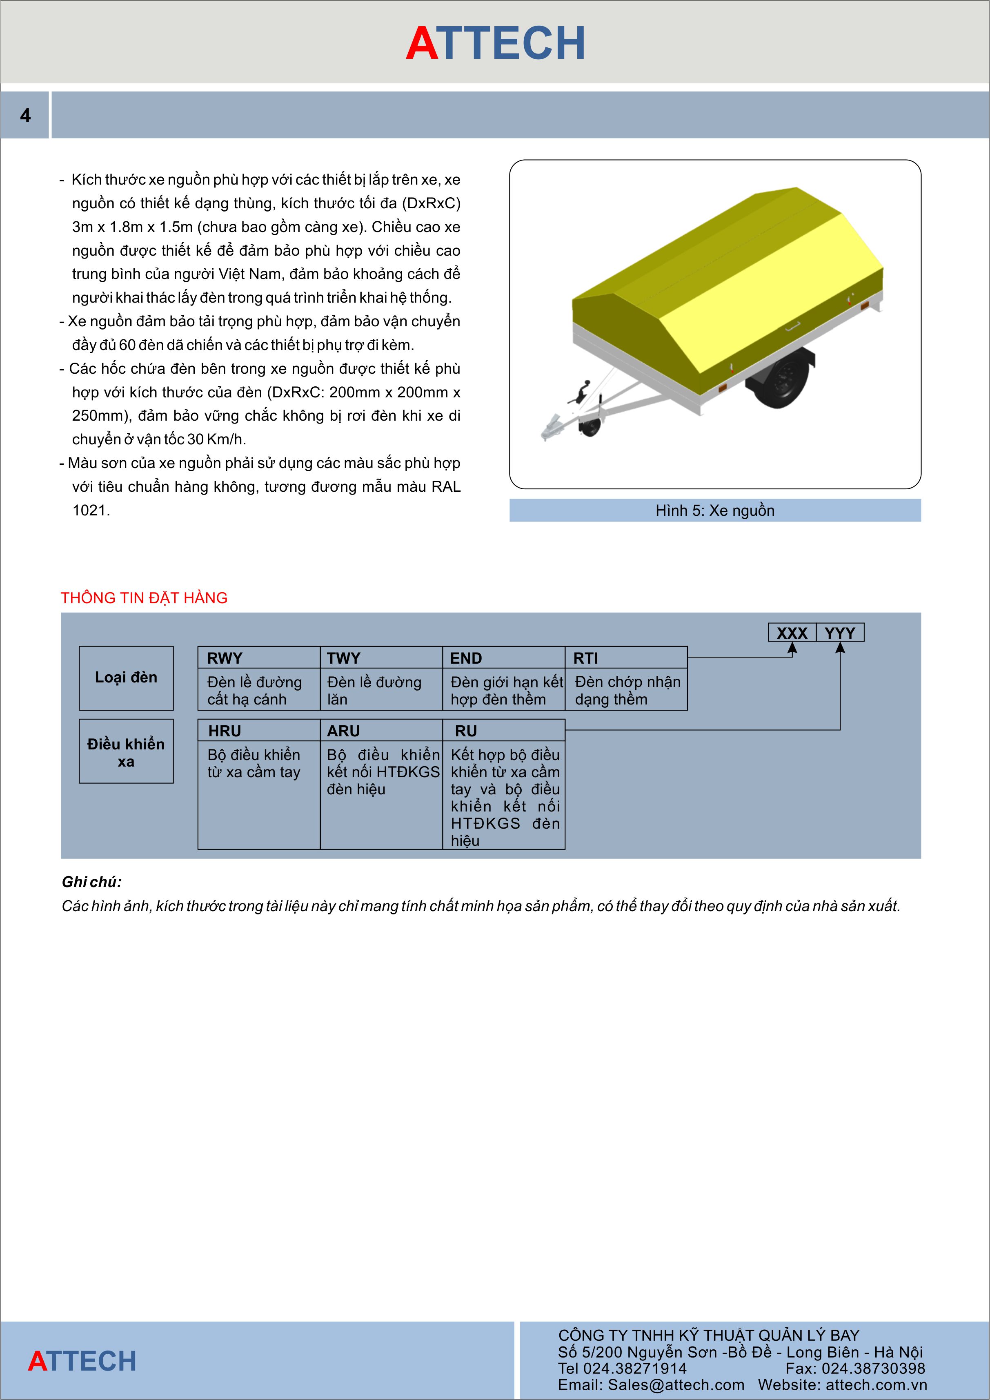
2019/catalgue DEN DA CHIEN/4.jpg
