ngoquytuan/DenDaChien/Code/PL_REMOTE/PL_REMOTE/Fonts/519527626.bmp

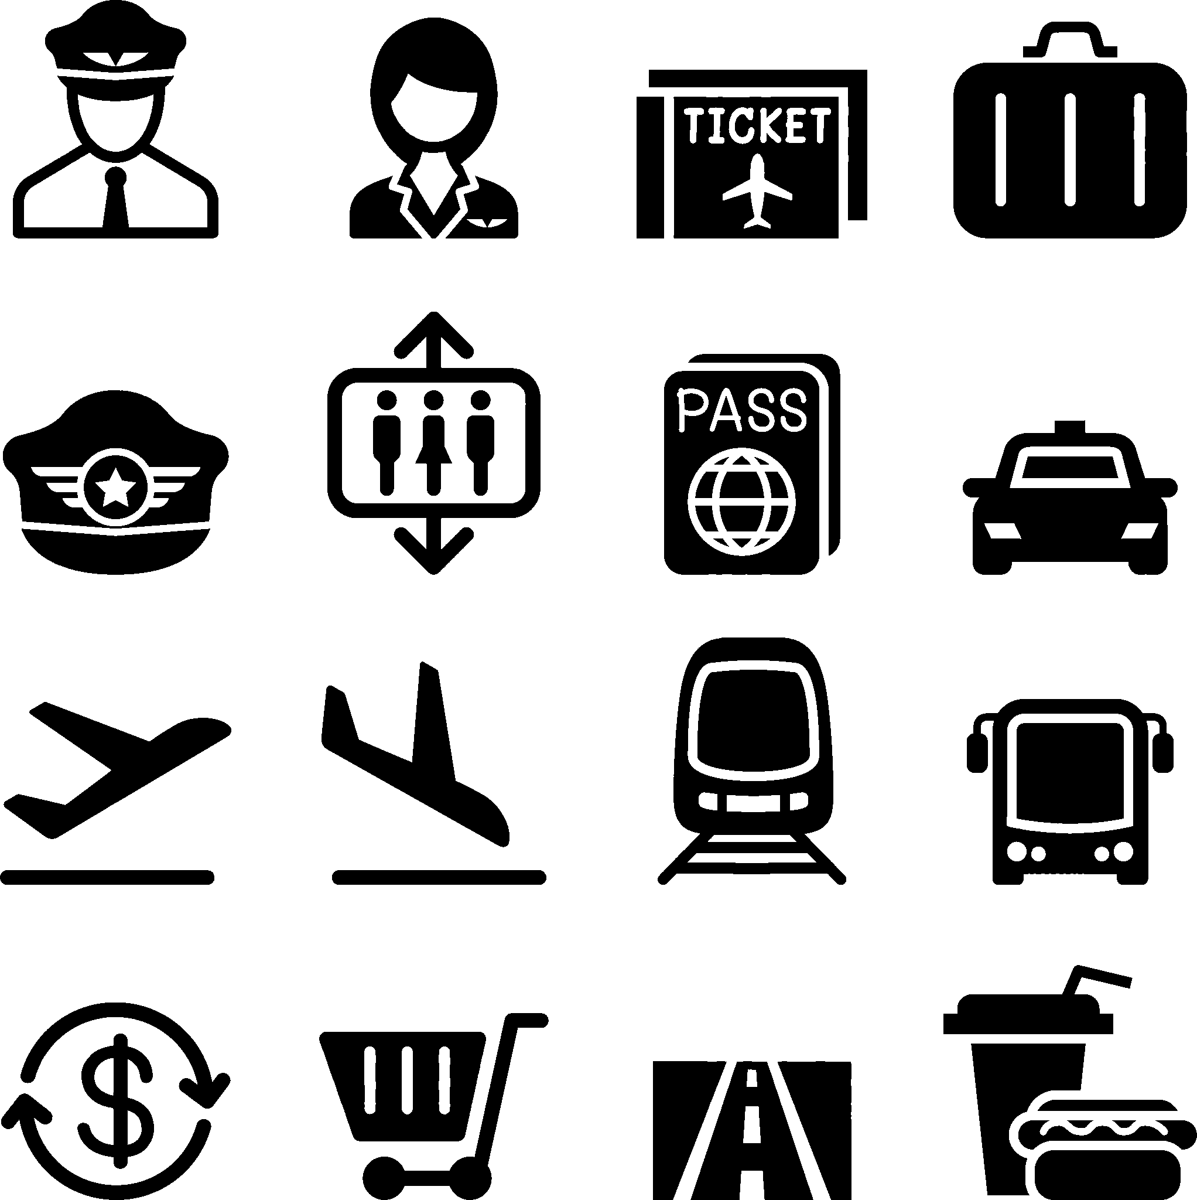
Code/PL_REMOTE/PL_REMOTE/Fonts/519527626.bmp
