ngoquytuan/DenDaChien/Code/PL_REMOTE/PL_REMOTE/Fonts/698153396.bmp

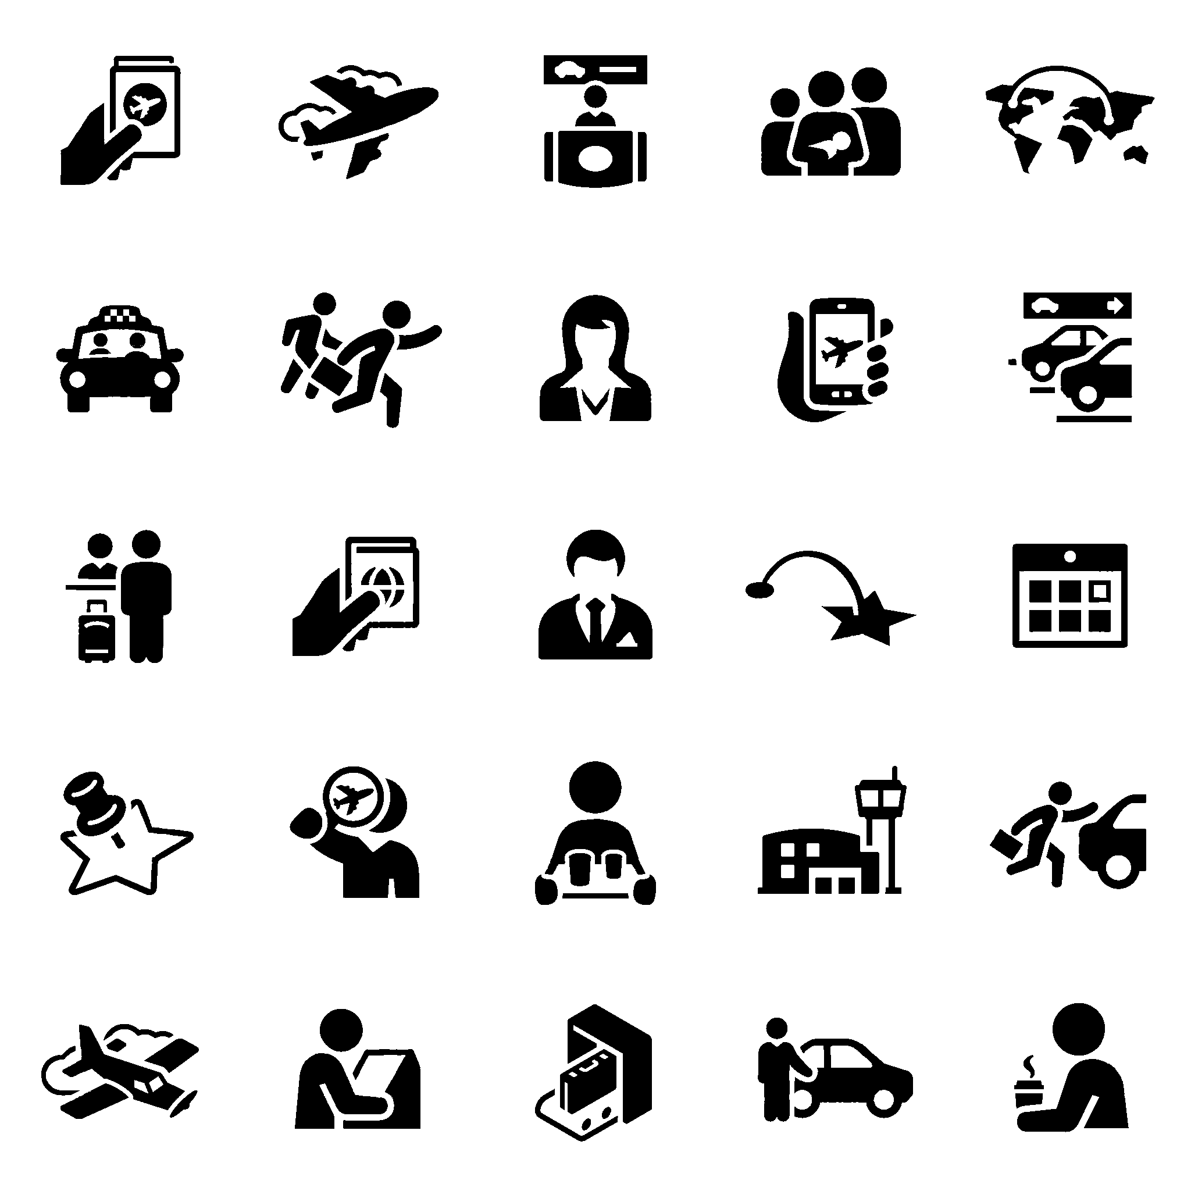
Code/PL_REMOTE/PL_REMOTE/Fonts/698153396.bmp
