ngoquytuan/DenDaChien/Code/PL_REMOTE/PL_REMOTE/Fonts/images.png

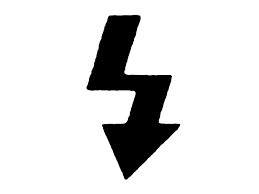
Code/PL_REMOTE/PL_REMOTE/Fonts/images.png
