ngoquytuan/DenDaChien/Code/PL_REMOTE/PL_REMOTE/Fonts/light_automation1600.bmp

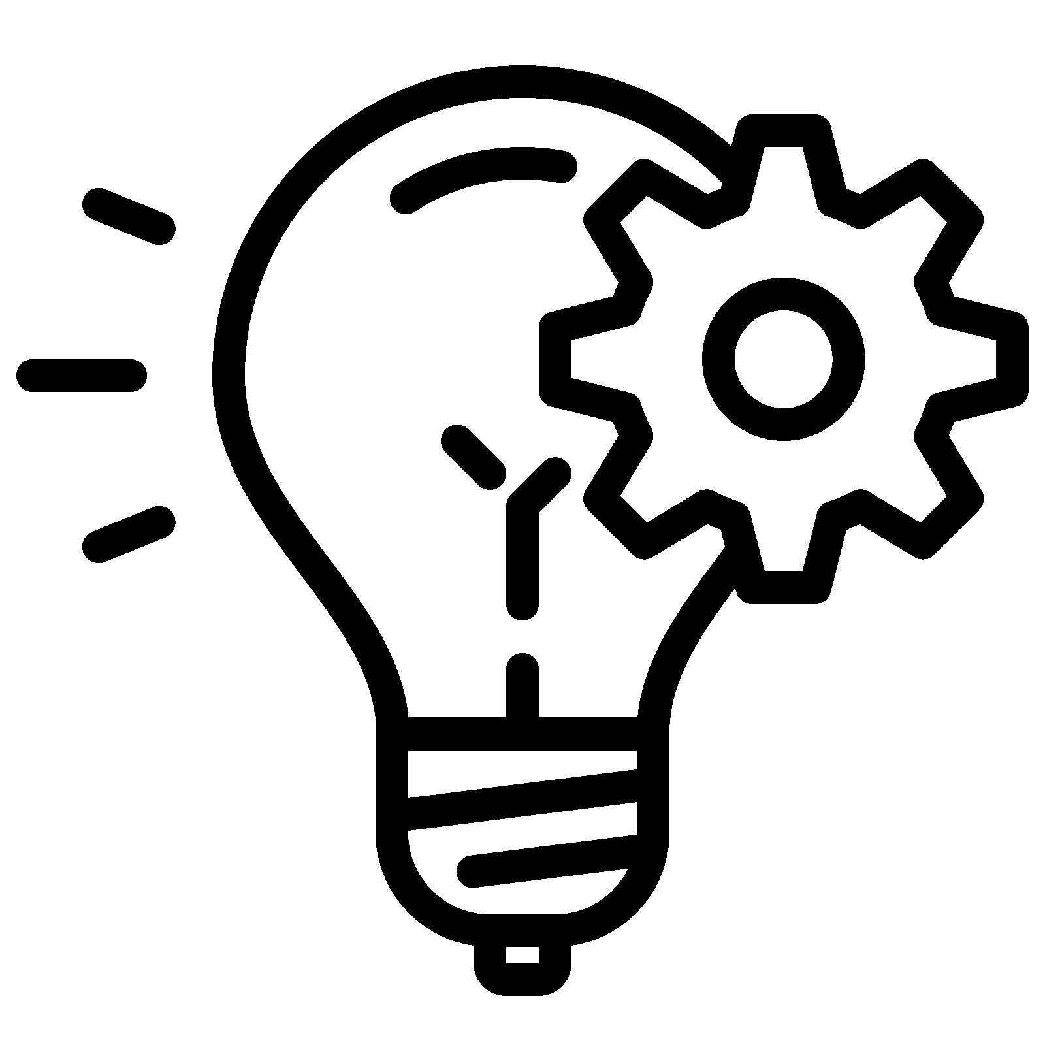
Code/PL_REMOTE/PL_REMOTE/Fonts/light_automation1600.bmp
