ngoquytuan/DenDaChien/2019/todo.docx

- BM 07 : có lỗi chính tả đầu và cuối
- HDKT lắp đặt : Chưa làm theo yêu cầu của biên bản : Đề nghị nêu chi tiết các bước hướng dẫn khai thác, lắp đặt và bảo dưỡng với từng mục thiết bị cụ thể như: đèn, bộ sạc, xe nguồn, bộ điều khiển đèn, bộ điều khiển sạc ac-quy, bộ điều khiển từ xa cầm tay, từng loại đèn như đèn CHC, đèn đường lăn, đèn giới hạn, đèn chớp thềm…
- SX và HD công nghệ : Bậc nhân viên K2, I2
- BV điện ok
- BV cơ khí ok
- TL điện tử ok
- TL cơ khí ok

TMTK : chưa chỉnh : Phần Giải pháp thiết kế nêu cụ thể kết cấu thân đèn, nắp đèn dùng công nghệ đúc nhựa hay gia công phay CNC. Trong trường hợp nêu cả 2 cách thì phần QTSX và HDCNCT phải nêu chi tiết cả 2 công nghệ.

Và danh mục bản vẽ chưa cập nhật tên mới
