ngoquytuan/DenDaChien/2019/20May19/BanVeDenDaChien2019 27.03.2019/Dien tu/PL-CU-04,05,06.pdf

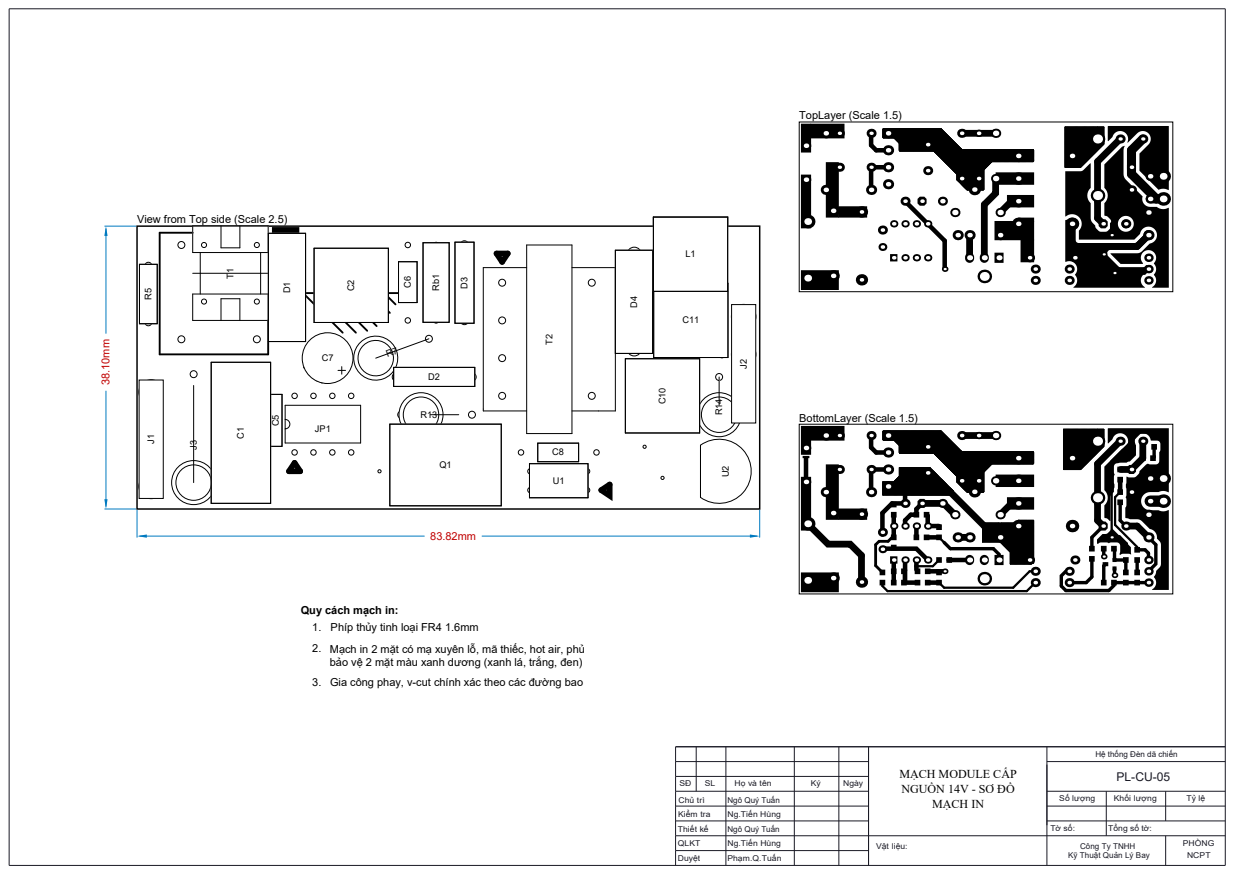
[picture p82: page 1]

View from Top side (Scale 2.5)

Quy cách mạch in:
1. Phíp thủy tinh loại FR4 1.6mm
Mạch in 2 mặt có mạ xuyên lỗ, mã thiếc, hot air, phủ
bảo vệ 2 mặt màu xanh dương (xanh lá, trắng, đen)
3. Gia công phay, v-cut chính xác theo các đường bao

Hệ thống Đèn dã chiến

SLSĐ | Họ và tên | Ký | Ngày
Chủ trì | Ngô Quý Tuấn | | | | Số lượng | Khối lượng | Tỷ lệ
Kiểm tra
Thiết kế | Ngô Quý Tuấn | | | | Tờ số: | Tổng số tờ:
QLKT | Ng.Tiến Hùng | | | | Công Ty TNHH Kỹ Thuật Quản Lý Bay | | PHÒNG NCPT
Duyệt | Phạm.Q.Tuấn

STT 23456789 | C10 | Tụ hóa chân cắm 1000uF25V

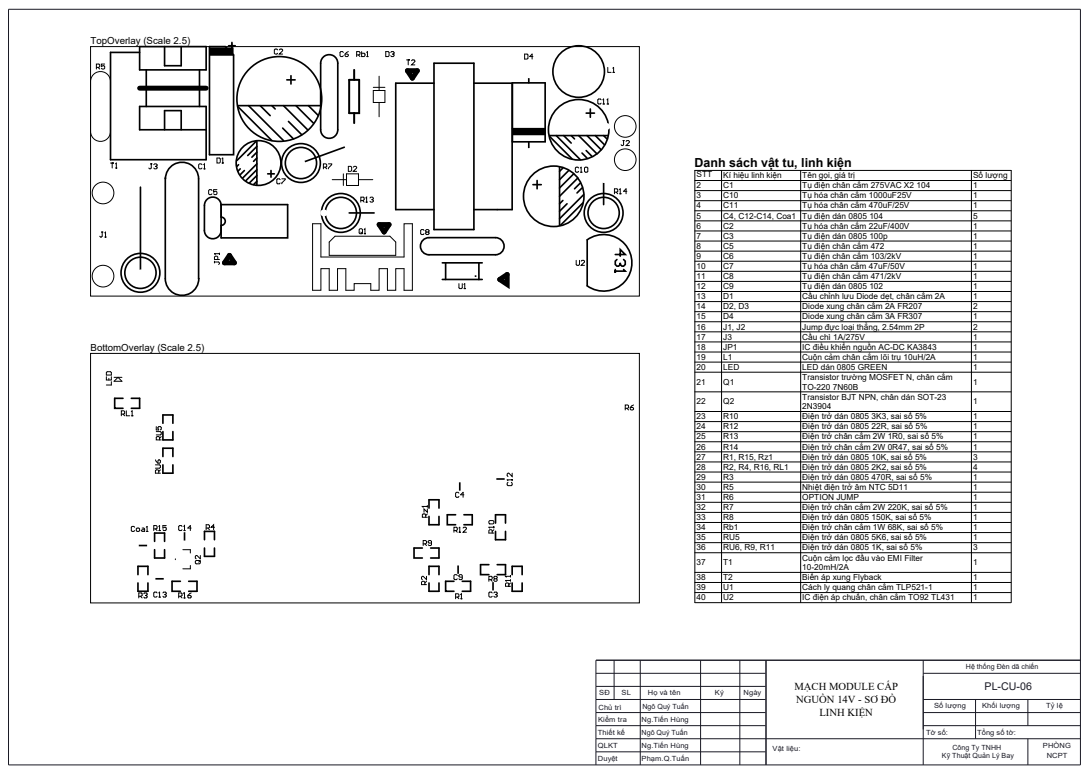
[picture p83: page 2]

Danh sách vật tu, linh kiện

Kí hiệu linh kiện | Tên gọi, giá trị
15 | D4 | Diode xung chân cắm 3A FR307 | Số lượng 111511111111212111111111134111111131111
C1 | Tụ điện chân cắm 275VAC X2 104
C11 | Tụ hóa chân cắm 470uF/25V
C4, C12-C14, Coa1 | Tụ điện dán 0805 104
C2 | Tụ hóa chân cắm 22uF/400V
C3 | Tụ điện dán 0805 100p
C5 | Tụ điện chân cắm 472
C6 | Tụ điện chân cắm 103/2kV
10 | C7 | Tụ hóa chân cắm 47uF/50V
11 | C8 | Tụ điện chân cắm 471/2kV
12 | C9 | Tụ điện dán 0805 102
13 | D1 | Cầu chỉnh lưu Diode dẹt, chân cắm 2A
14 | D2, D3 | Diode xung chân cắm 2A FR207
16 | J1, J2 | Jump đực loại thẳng, 2.54mm 2P
17 | J3 | Cầu chì 1A/275V
18 | JP1 | IC điều khiển nguồn AC-DC KA3843
19 | L1 | Cuộn cảm chân cắm lõi trụ 10uH/2A
20 | LED | LED dán 0805 GREEN
21 | Q1 | Transistor trường MOSFET N, chân cắm TO-220 7N60B
22 | Q2 | Transistor BJT NPN, chân dán SOT-23 2N3904
23 | R10 | Điện trở dán 0805 3K3, sai số 5%
24 | R12 | Điện trở dán 0805 22R, sai số 5%
25 | R13 | Điện trở chân cắm 2W 1R0, sai số 5%
26 | R14 | Điện trở chân cắm 2W 0R47, sai số 5%
27 | R1, R15, Rz1 | Điện trở dán 0805 10K, sai số 5%
28 | R2, R4, R16, RL1 | Điện trở dán 0805 2K2, sai số 5%
29 | R3 | Điện trở dán 0805 470R, sai số 5%
30 | R5 | Nhiệt điện trở âm NTC 5D11
31 | R6 | OPTION JUMP
32 | R7 | Điện trở chân cắm 2W 220K, sai số 5%
33 | R8 | Điện trở dán 0805 150K, sai số 5%
34 | Rb1 | Điện trở chân cắm 1W 68K, sai số 5%
35 | RU5 | Điện trở dán 0805 5K6, sai số 5%
36 | RU6, R9, R11 | Điện trở dán 0805 1K, sai số 5%
37 | T1 | Cuộn cảm lọc đầu vào EMI Filter 10-20mH/2A
38 | T2 | Biến áp xung Flyback
39 | U1 | Cách ly quang chân cắm TLP521-1
40 | U2 | IC điện áp chuẩn, chân cắm TO92 TL431

Hệ thống Đèn dã chiến

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

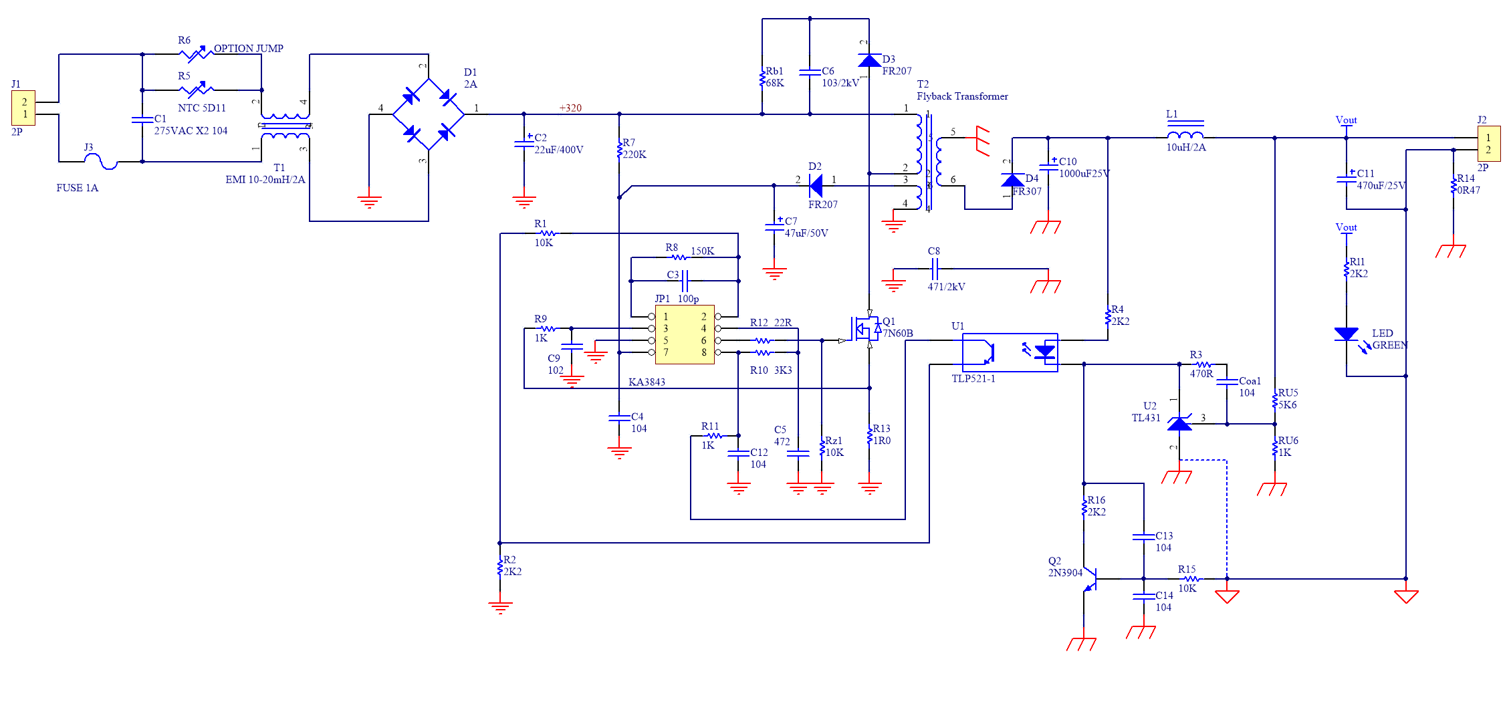
[picture p84: figure]

### MẠCH MODULE CẤP NGUỒN 14V - SƠ ĐỒ NGUYÊN LÝ

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

### PL-CU-04

Hệ thống Đèn dã chiến
