ngoquytuan/DenDaChien/2019/20May19/BanVeDenDaChien2019 27.03.2019/Dien tu/PL-LMP-03,04,05.pdf

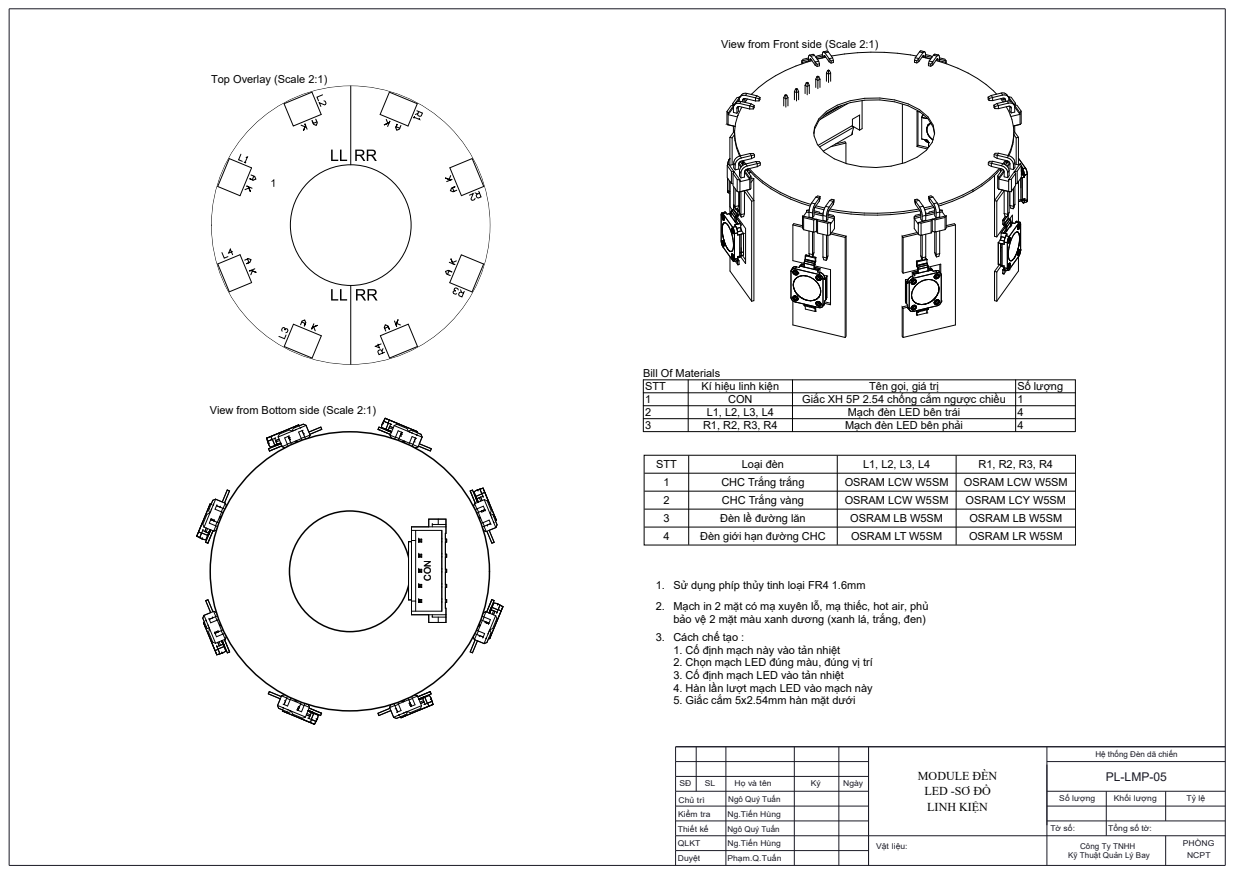
[picture p85: page 1]
CON; STT 1 2 3; Kí hiệu linh kiện CON L1, L2, L3, L4 R1, R2, R3, R4; Số lượng 1 4 4; Bill Of Materials; STT; Loại đèn; CHC Trắng trắng; OSRAM LCW W5SM; CHC Trắng vàng; OSRAM LCY W5SM; Đèn lề đường lăn; OSRAM LB W5SM; Đèn giới hạn đường CHC; OSRAM LT W5SM; OSRAM LR W5SM; Số lượng; Chủ trì Kiểm tra; NCPT; PHÒNG; Vật liệu:; Ngày; Thiết kế QLKT; SLSĐ; Họ và tên; Khối lượng; Duyệt

View from Front side (Scale 2:1)

Top Overlay (Scale 2:1)

Tên gọi, giá trị
Mạch đèn LED bên trái
Mạch đèn LED bên phải

Giắc XH 5P 2.54 chống cắm ngược chiều

View from Bottom side (Scale 2:1)

1. Sử dụng phíp thủy tinh loại FR4 1.6mm
2. Mạch in 2 mặt có mạ xuyên lỗ, mạ thiếc, hot air, phủ
bảo vệ 2 mặt màu xanh dương (xanh lá, trắng, đen)
Cách chế tạo :
1. Cố định mạch này vào tản nhiệt
2. Chọn mạch LED đúng màu, đúng vị trí
3. Cố định mạch LED vào tản nhiệt
4. Hàn lần lượt mạch LED vào mạch này
5. Giắc cắm 5x2.54mm hàn mặt dưới

Hệ thống Đèn dã chiến
PL-LMP-05

MODULE ĐÈN
LED -SƠ ĐỒ
LINH KIỆN

Ngô Quý Tuấn

Ng.Tiến Hùng
Phạm.Q.Tuấn

Tổng số tờ:
Công Ty TNHH
Kỹ Thuật Quản Lý Bay

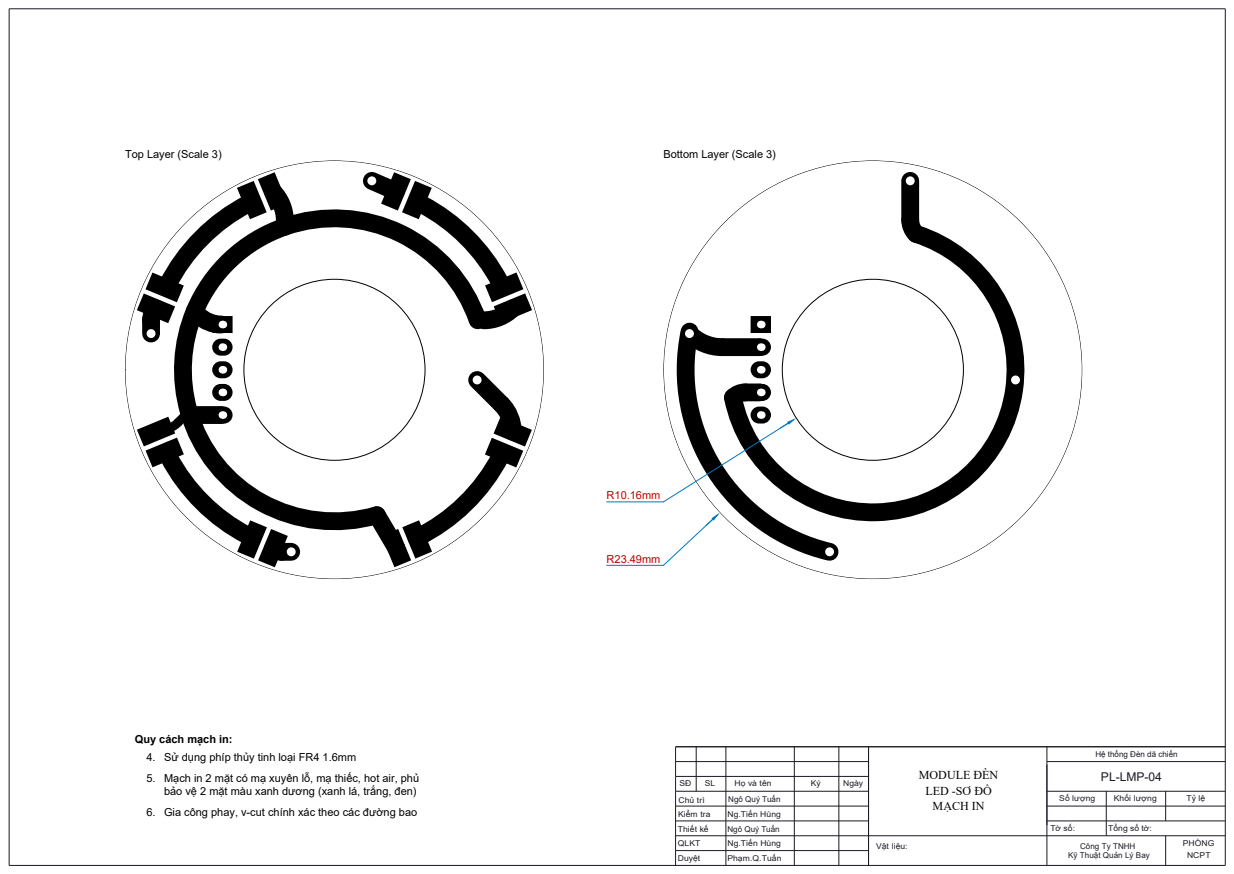
[picture p86: page 2]
Top Layer (Scale 3); Bottom Layer (Scale 3)

Quy cách mạch in:
4. Sử dụng phíp thủy tinh loại FR4 1.6mm
Mạch in 2 mặt có mạ xuyên lỗ, mạ thiếc, hot air, phủ
bảo vệ 2 mặt màu xanh dương (xanh lá, trắng, đen)
6. Gia công phay, v-cut chính xác theo các đường bao

Hệ thống Đèn dã chiến
PL-LMP-04

MODULE ĐÈN
LED -SƠ ĐỒ
MẠCH IN

SLSĐ | Họ và tên | Ký | Ngày
Chủ trì | Ngô Quý Tuấn | | | | Số lượng | Khối lượng | Tỷ lệ

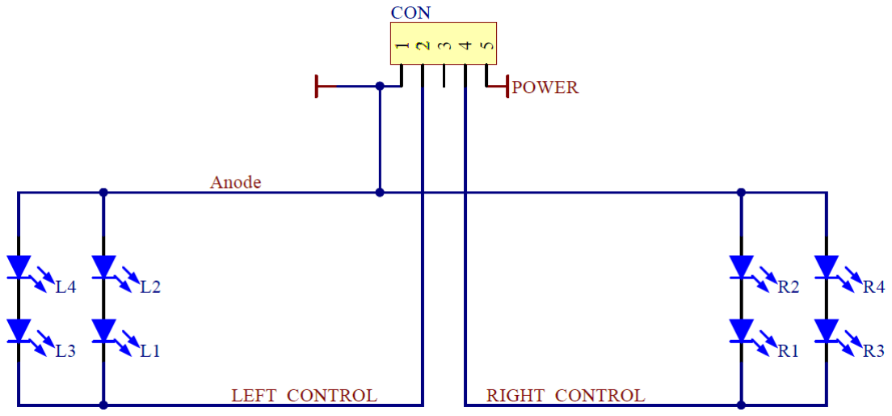
[picture p87: figure]

MODULE ĐÈN
LED -SƠ ĐỒ
NGUYÊN LÝ
| SLSĐ | Họ và tên | Ký | Ngày
Chủ trì | Ngô Quý Tuấn | | | | Số lượng | Khối lượng | Tỷ lệ

PL-LMP-03

Hệ thống Đèn dã chiến
