ngoquytuan/DenDaChien/2019/20May19/BanVeDenDaChien2019 27.03.2019/Dien tu/PL-LMP-07,08,09.pdf

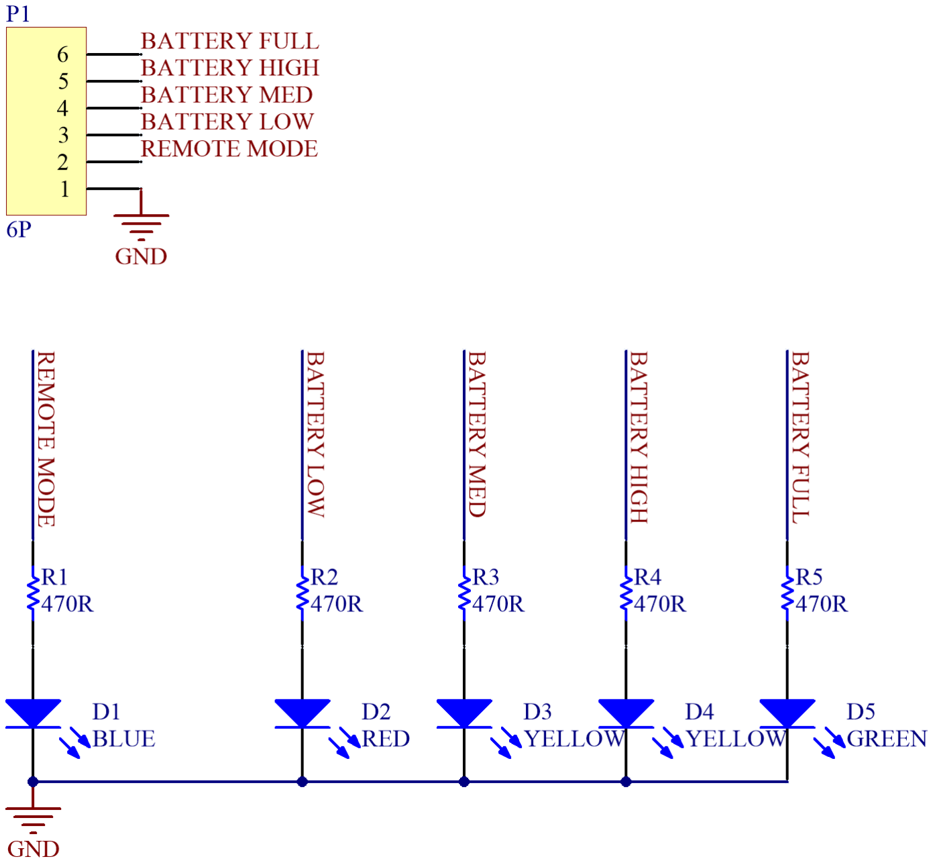
[picture p88: figure]

## MẠCH HIỂN THỊ TRẠNG THÁI - SƠ

### ĐỒ NGUYÊN LÝ

| SLSĐ | Họ và tên | Ký | Ngày
Chủ trì | Ngô Quý Tuấn | | | | Số lượng | Khối lượng | Tỷ lệ
Kiểm tra
Thiết kế | Ngô Quý Tuấn | | | | Tờ số: | Tổng số tờ:
QLKT | Ng.Tiến Hùng | | | Vật liệu: | Công Ty TNHH Kỹ Thuật Quản Lý Bay | | PHÒNG NCPT
Duyệt | Phạm.Q.Tuấn

## PL-LMP-07

Hệ thống Đèn dã chiến

## Top Layer (Scale 3)

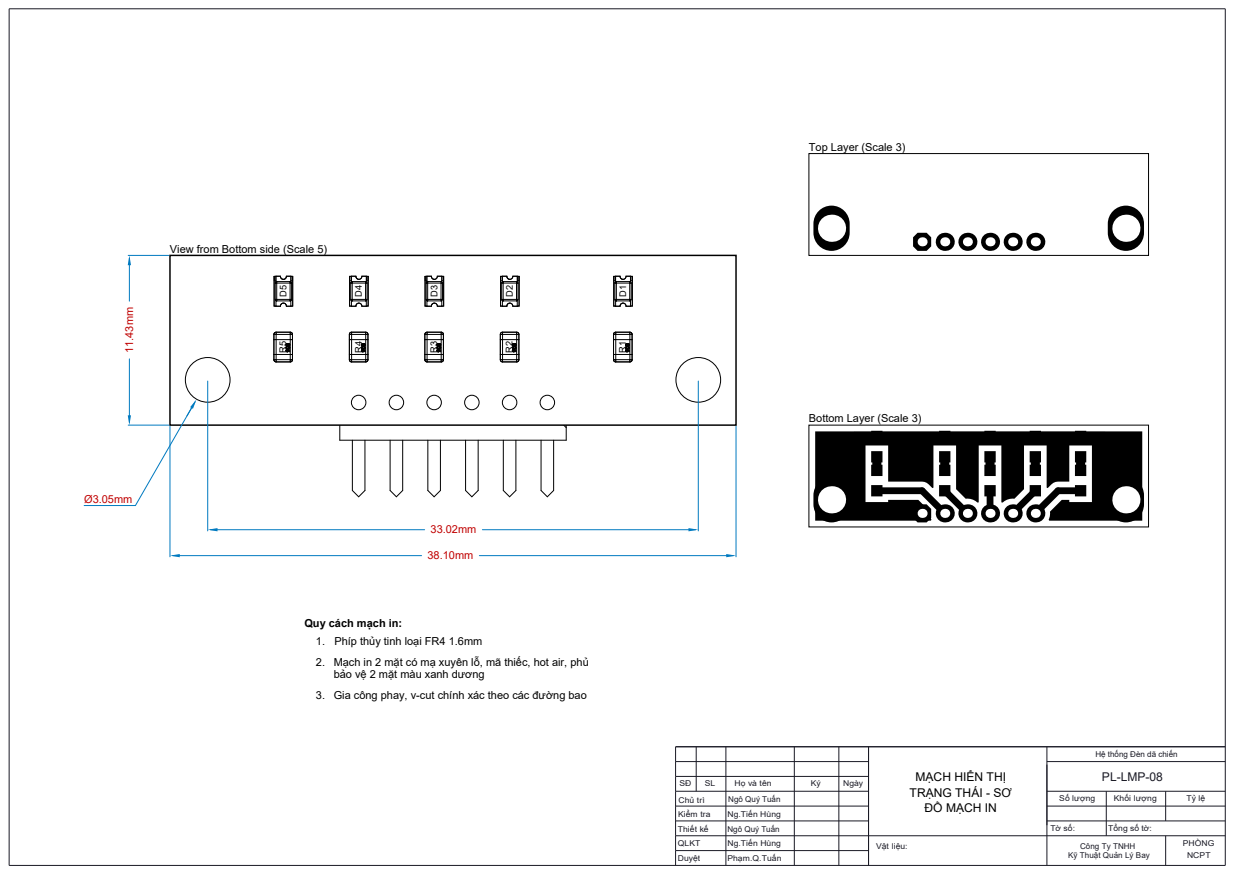
[picture p89: page 2]

View from Bottom side (Scale 5)

Quy cách mạch in:
1. Phíp thủy tinh loại FR4 1.6mm
Mạch in 2 mặt có mạ xuyên lỗ, mã thiếc, hot air, phủ
bảo vệ 2 mặt màu xanh dương
3. Gia công phay, v-cut chính xác theo các đường bao

Hệ thống Đèn dã chiến
PL-LMP-08

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

## Top Overlay (Scale 4)

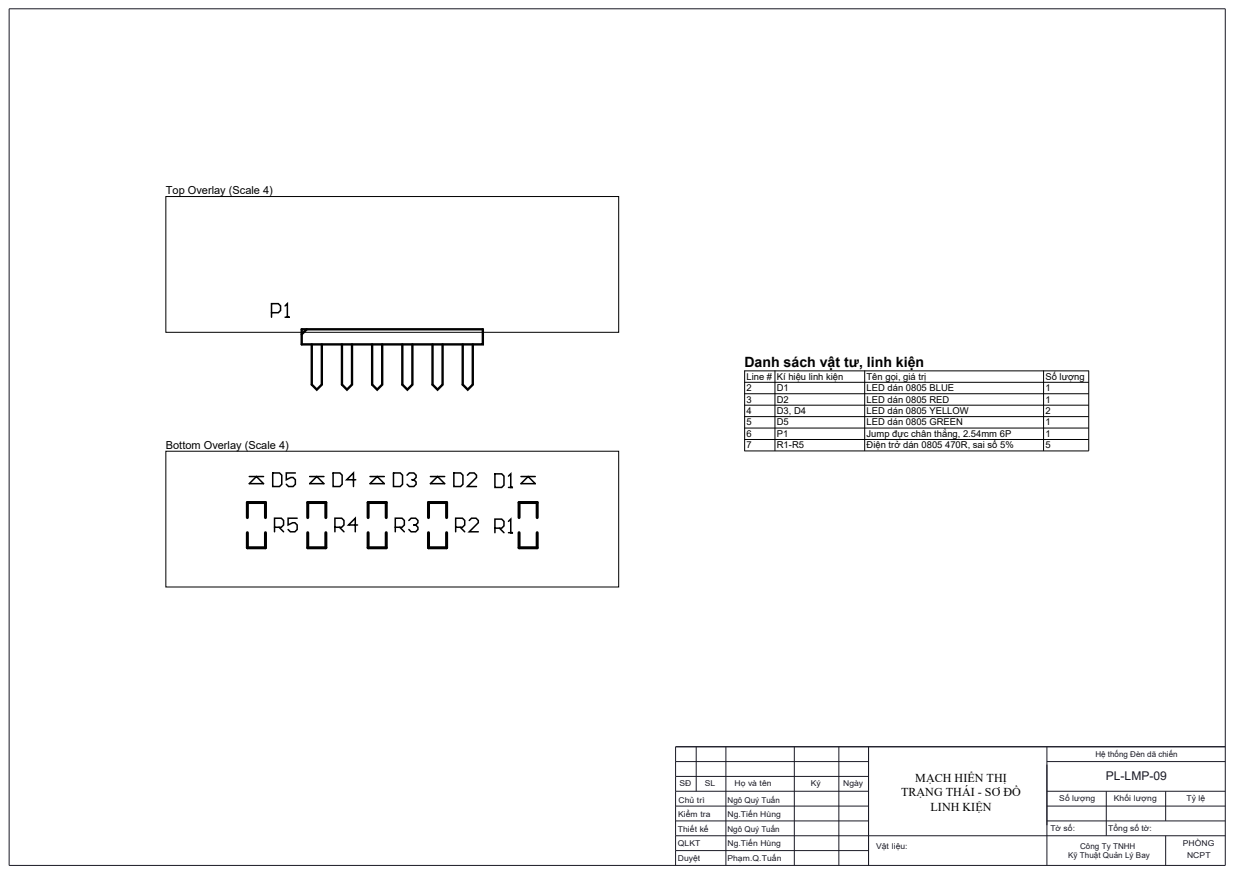
[picture p90: page 3]

Danh sách vật tư, linh kiện

Line # | Kí hiệu linh kiện | Tên gọi, giá trị | Số lượng
2 | D1 | LED dán 0805 BLUE | 1
3 | D2 | LED dán 0805 RED | 1
4 | D3, D4 | LED dán 0805 YELLOW | 2
5 | D5 | LED dán 0805 GREEN | 1
6 | P1 | Jump đực chân thẳng, 2.54mm 6P | 1
7 | R1-R5 | Điện trở dán 0805 470R, sai số 5% | 5

Bottom Overlay (Scale 4)

Hệ thống Đèn dã chiến
PL-LMP-09

MẠCH HIỂN THỊ
TRẠNG THÁI - SƠ ĐỒ
LINH KIỆN

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
