ngoquytuan/DenDaChien/2019/20May19/BanVeDenDaChien2019 27.03.2019/Dien tu/PL-LMP-10,11,12.pdf

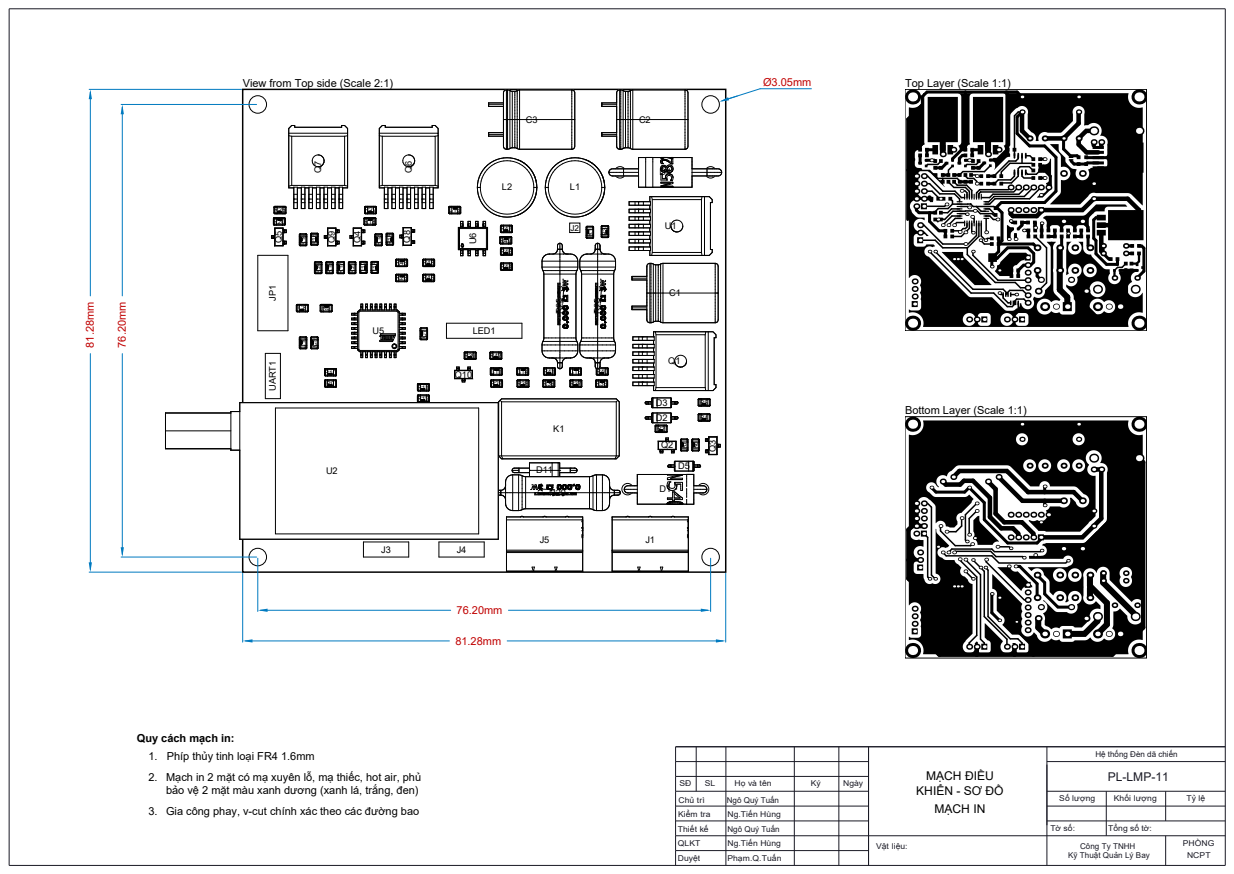
[picture p91: page 1]

View from Top side (Scale 2:1)

Quy cách mạch in:
1. Phíp thủy tinh loại FR4 1.6mm
Mạch in 2 mặt có mạ xuyên lỗ, mạ thiếc, hot air, phủ
bảo vệ 2 mặt màu xanh dương (xanh lá, trắng, đen)
3. Gia công phay, v-cut chính xác theo các đường bao

Hệ thống Đèn dã chiến
PL-LMP-11

Tổng số tờ:
Công Ty TNHH
Kỹ Thuật Quản Lý Bay

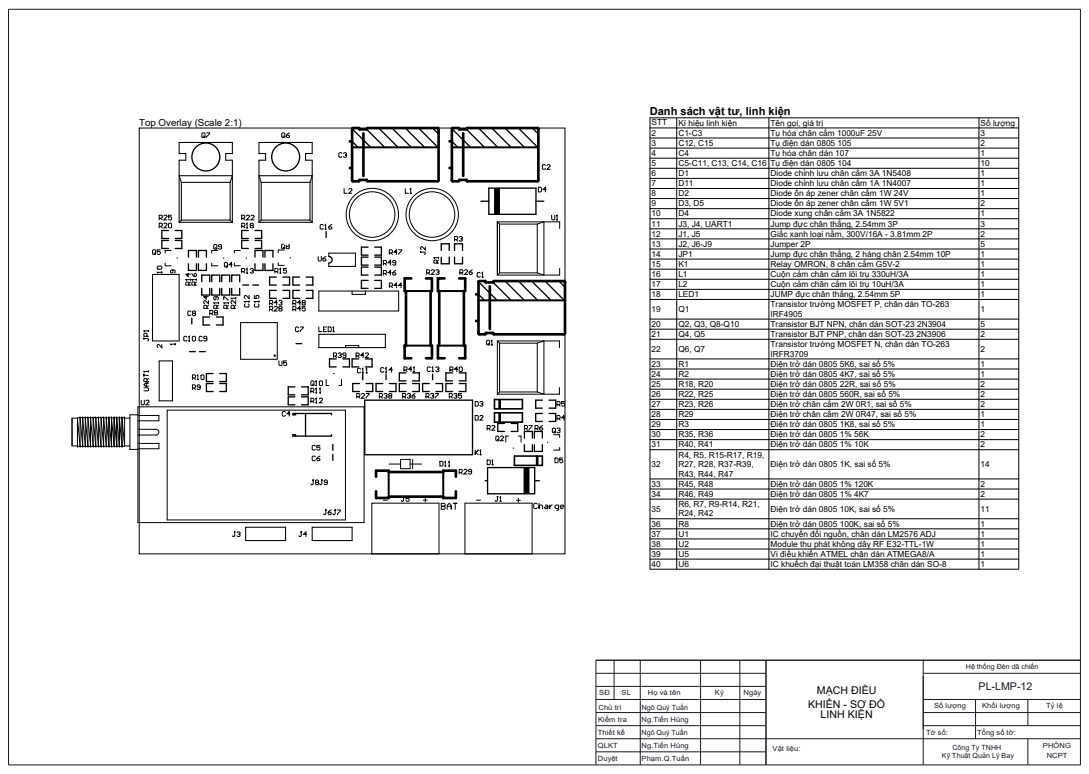
[picture p92: page 2]

Danh sách vật tư, linh kiện

Kí hiệu linh kiện | Tên gọi, giá trị
C1-C3 | Tụ hóa chân cắm 1000uF 25V | Số lượng 321
C12, C15 | Tụ điện dán 0805 105
C4 | Tụ hóa chân dán 107
C5-C11, C13, C14, C16 | Tụ điện dán 0805 104
14 | JP1 | Jump đực chân thẳng, 2 hàng chân 2.54mm 10P | 1011121325111111522112221122
D1 | Diode chỉnh lưu chân cắm 3A 1N5408
D11 | Diode chỉnh lưu chân cắm 1A 1N4007
D2 | Diode ổn áp zener chân cắm 1W 24V
D3, D5 | Diode ổn áp zener chân cắm 1W 5V1
10 | D4 | Diode xung chân cắm 3A 1N5822
11 | J3, J4, UART1 | Jump đực chân thẳng, 2.54mm 3P
12 | J1, J5 | Giắc xanh loại nằm, 300V/16A - 3.81mm 2P
13 | J2, J6-J9 | Jumper 2P
15 | K1 | Relay OMRON, 8 chân cắm G5V-2
16 | L1 | Cuộn cảm chân cắm lõi trụ 330uH/3A
17 | L2 | Cuộn cảm chân cắm lõi trụ 10uH/3A
18 | LED1 | JUMP đực chân thẳng, 2.54mm 5P
19 | Q1 | Transistor trường MOSFET P, chân dán TO-263 IRF4905
20 | Q2, Q3, Q8-Q10 | Transistor BJT NPN, chân dán SOT-23 2N3904
21 | Q4, Q5 | Transistor BJT PNP, chân dán SOT-23 2N3906
22 | Q6, Q7 | Transistor trường MOSFET N, chân dán TO-263 IRFR3709
23 | R1 | Điện trở dán 0805 5K6, sai số 5%
24 | R2 | Điện trở dán 0805 4K7, sai số 5%
25 | R18, R20 | Điện trở dán 0805 22R, sai số 5%
26 | R22, R25 | Điện trở dán 0805 560R, sai số 5%
27 | R23, R26 | Điện trở chân cắm 2W 0R1, sai số 5%
28 | R29 | Điện trở chân cắm 2W 0R47, sai số 5%
29 | R3 | Điện trở dán 0805 1K8, sai số 5%
30 | R35, R36 | Điện trở dán 0805 1% 56K
31 | R40, R41 | Điện trở dán 0805 1% 10K
32 | R4, R5, R15-R17, R19, R27, R28, R37-R39, R43, R44, R47 | Điện trở dán 0805 1K, sai số 5% | 1422

33 | R45, R48 | Điện trở dán 0805 1% 120K
34 | R46, R49 | Điện trở dán 0805 1% 4K7
35 | R6, R7, R9-R14, R21, R24, R42 | Điện trở dán 0805 10K, sai số 5%
36 | R8 | Điện trở dán 0805 100K, sai số 5% | 1111111

37 | U1 | IC chuyển đổi nguồn, chân dán LM2576 ADJ
38 | U2 | Module thu phát không dây RF E32-TTL-1W
39 | U5 | Vi điều khiển ATMEL chân dán ATMEGA8/A
40 | U6 | IC khuếch đại thuật toán LM358 chân dán SO-8

Hệ thống Đèn dã chiến
PL-LMP-12

SLSĐ | Họ và tên | Ký | Ngày
Chủ trì | Ngô Quý Tuấn | | | | Số lượng | Khối lượng | Tỷ lệ

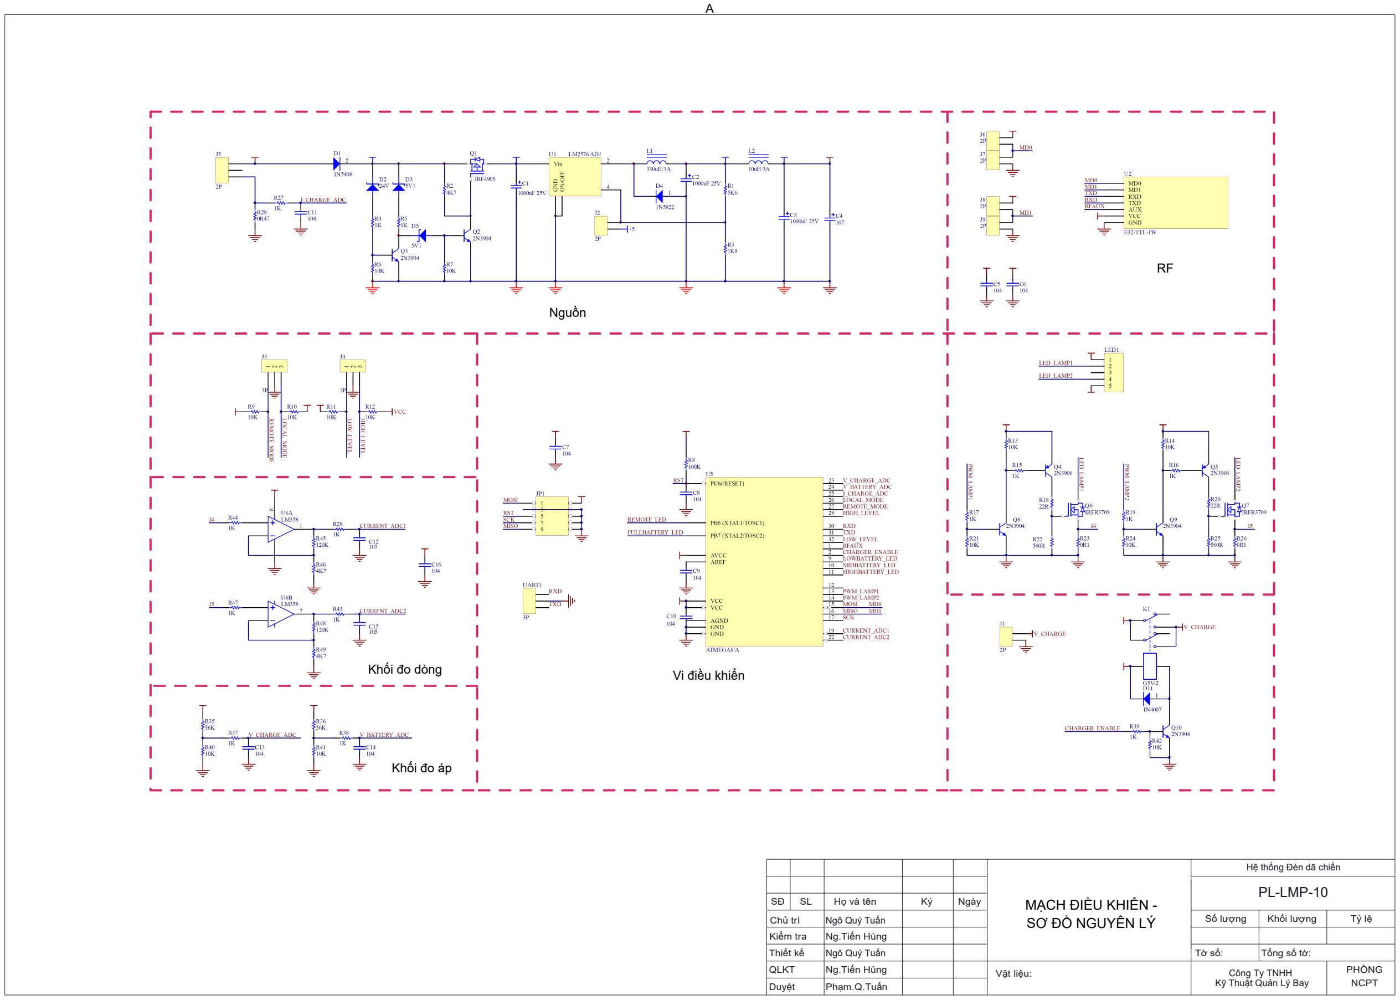
[picture p93: page 3]

A

### MẠCH ĐIỀU KHIỂN -

SƠ ĐỒ NGUYÊN LÝ

Nguồn

Vi ÿiều khiển

RF

Khối đo dòng

Khối đo áp

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

### PL-LMP-10

Hệ thống Đèn dã chiến
