ngoquytuan/DenDaChien/2019/20May19/BanVeDenDaChien2019 27.03.2019/Co khi/ban ve den da chien, Tien luong/10 PL-LMP-12-11 Cum LED.pdf

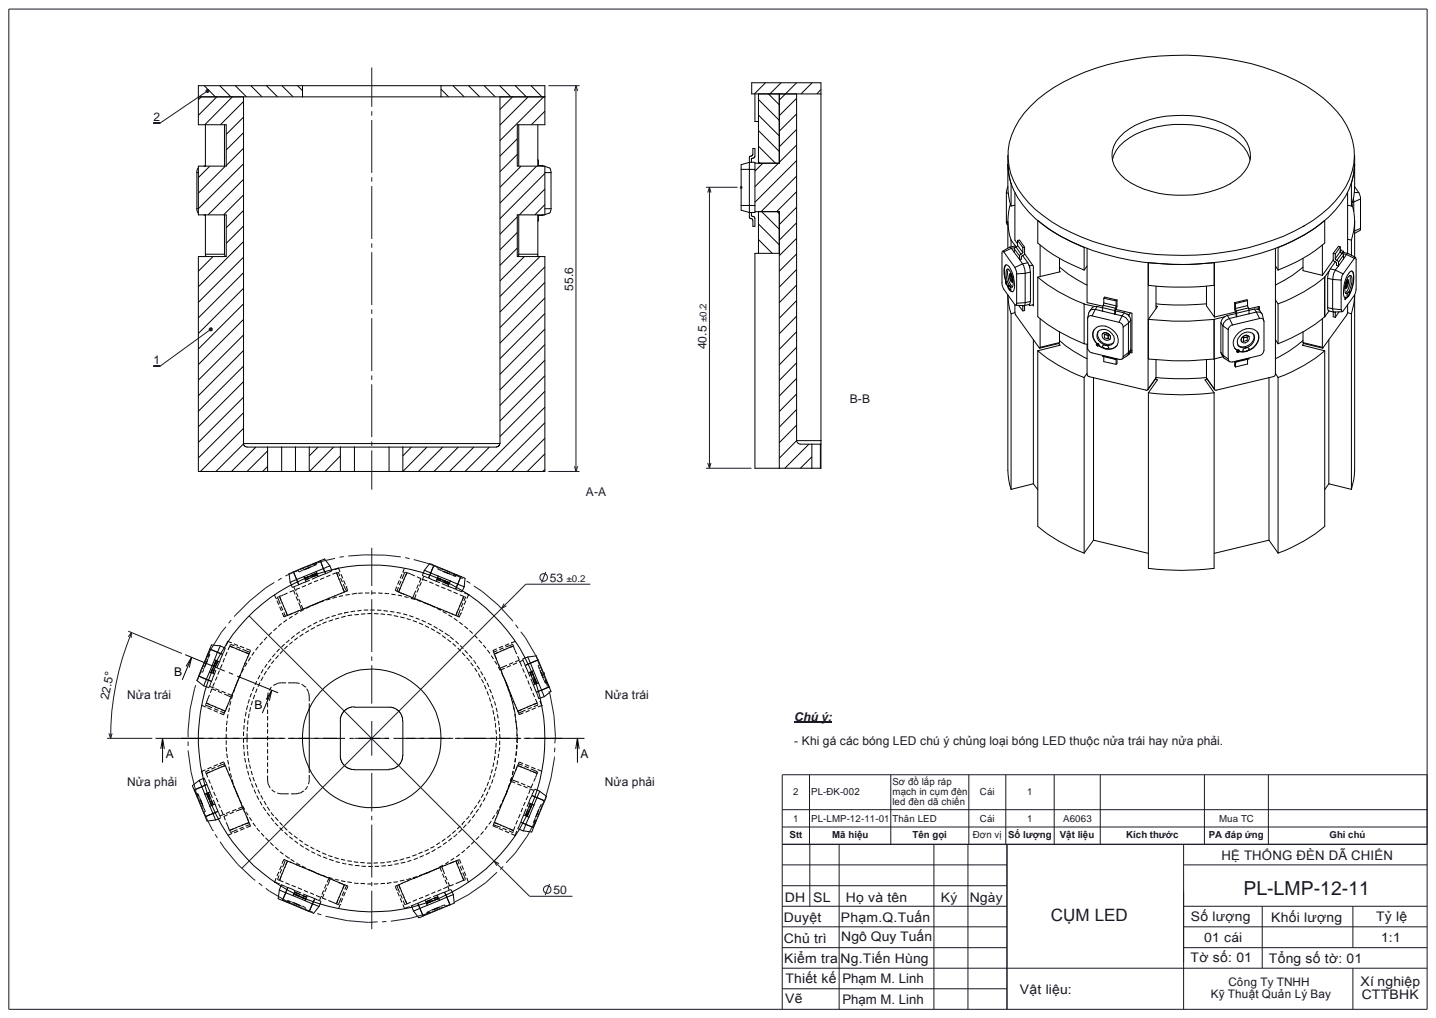
[picture p95: page 1]
Nửa phải; Chú ý:; Nửa trái; PL-LMP-12-11

- Khi gá các bóng LED chú ý chủng loại bóng LED thuộc nửa trái hay nửa phải.

2 | PL-ĐK-002 | Sơ đồ lắp ráp mạch in cụm đèn led đèn dã chiến | Cái | 1

1 | PL-LMP-12-11-01 | Thân LED | Cái | 1 | A6063 | | Mua TC
Stt | Mã hiệu | Tên gọi | Đơn vị | Số lượng | Vật liệu | Kích thước | PA đáp ứng | Ghi chú

CỤM LED | HỆ THỐNG ĐÈN DÃ CHIẾN

DH | SL | Họ và tên | Ký | Ngày
Duyệt | Phạm.Q.Tuấn | | | | Số lượng | Khối lượng | Tỷ lệ
Chủ trì | Ngô Quy Tuấn | | | | 01 cái | | 1:1
Kiểm tra | Ng.Tiến Hùng | | | | Tờ số: 01 | Tổng số tờ: 01
Thiết kế | Phạm M. Linh | | | Vật liệu: | Công Ty TNHH Kỹ Thuật Quản Lý Bay | | Xí nghiệp CTTBHK
Vẽ | Phạm M. Linh
