ngoquytuan/DenDaChien/2019/20May19/BanVeDenDaChien2019 27.03.2019/Co khi/Tem den da chien/DA CHIEN TT.pdf

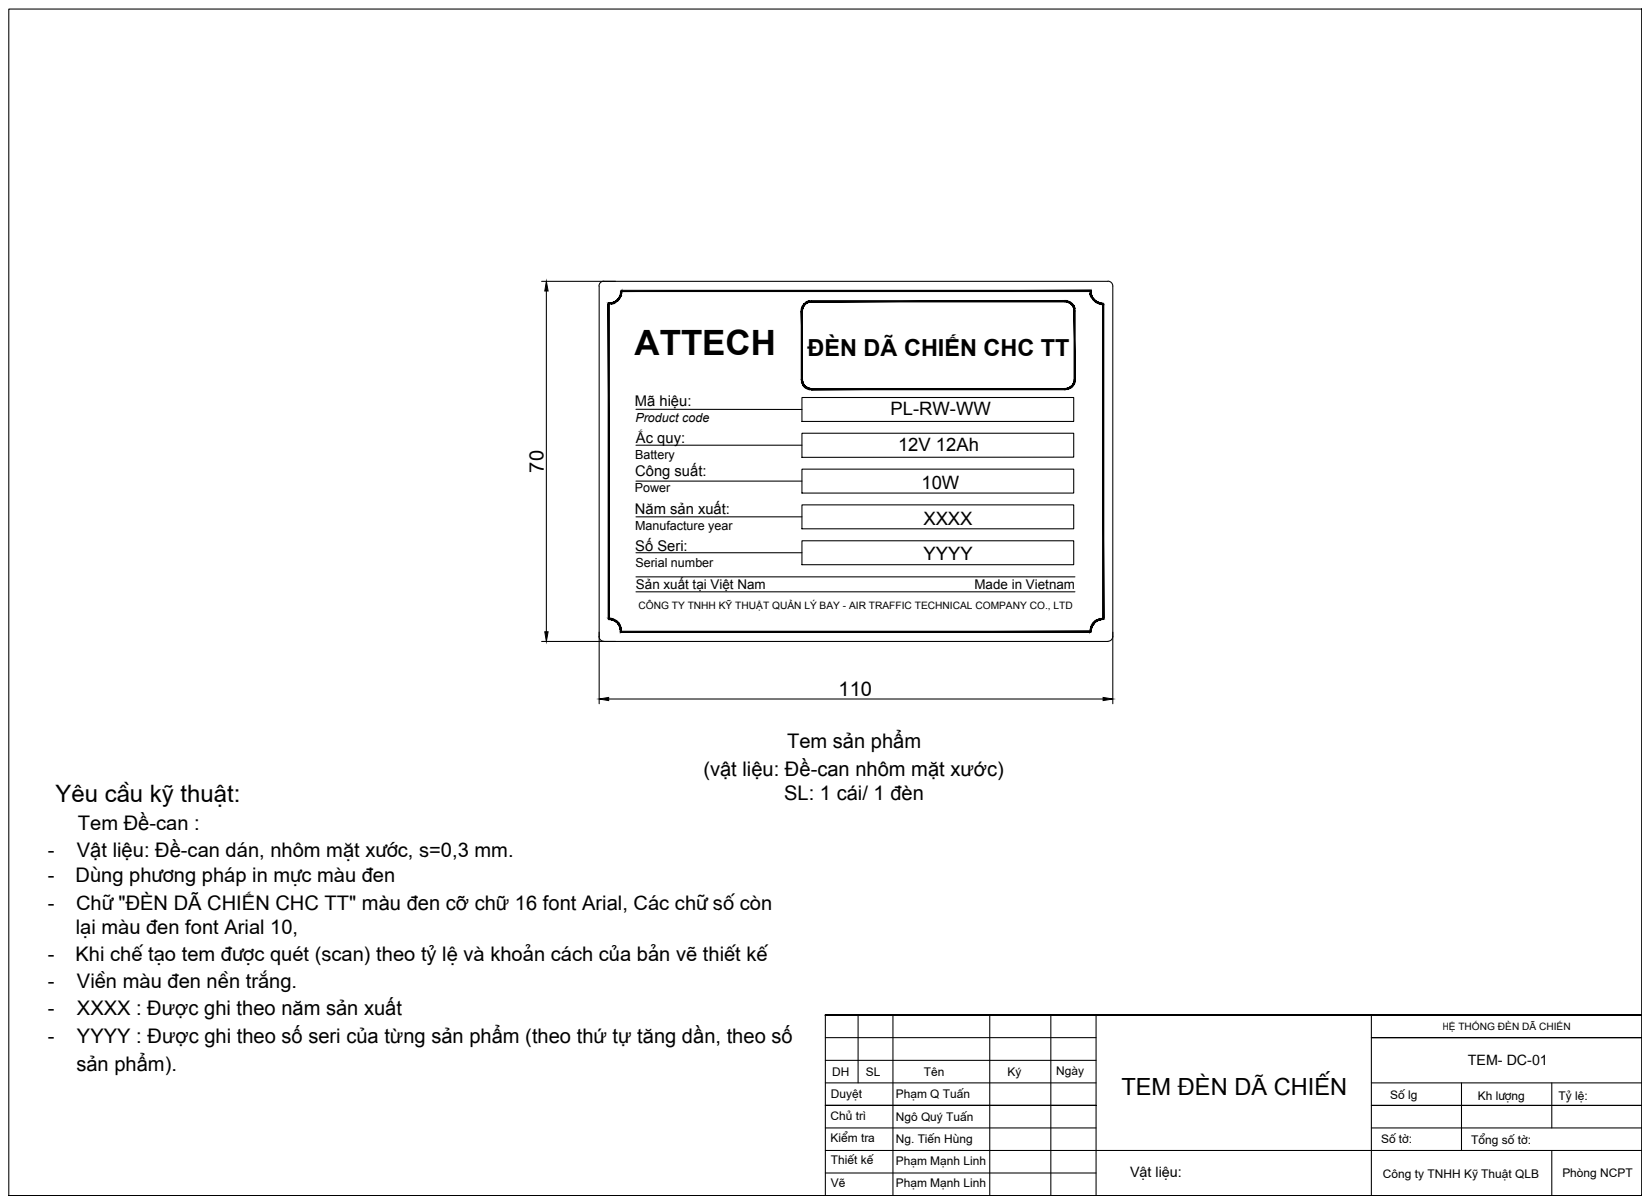
[picture p96: page 1]
VËt liÖu:; sản phẩm).; Mã hiệu: Product code; PL-RW-WW Công suất: Power; 10W Ắc quy: Battery; 12V 12Ah Năm sản xuất:; Manufacture year; XXXX Số Seri: Serial number; YYYY CÔNG TY TNHH KỸ THUẬT QUẢN LÝ BAY - AIR TRAFFIC TECHNICAL COMPANY CO., LTD Sản xuất tại Việt Nam; Made in Vietnam

70 110 Tem sản phẩm

(vật liệu: Đề-can nhôm mặt xước) SL: 1 cái/ 1 đèn - Vật liệu: Đề-can d¸n, nh«m mÆt xíc, s=0,3 mm. - Dïng ph¬ng ph¸p in mùc mµu ®en - Ch÷ "ĐÈN DÃ CHIẾN CHC TT" màu đen cỡ chữ 16 font Arial, C¸c ch÷ sè cßn

l¹i mµu ®en font Arial 10, - Khi chÕ t¹o tem ®îc quÐt (scan) theo tû lÖ vµ kho¶n c¸ch cña b¶n vÏ thiÕt kÕ - ViÒn mµu ®en nÒn tr¾ng. - XXXX : Được ghi theo năm sản xuất - YYYY : Được ghi theo số seri của từng sản phẩm (theo thứ tự tăng dần, theo số

DH | SL | Tªn | Ký | Ngµy

tem §ÌN D· CHIÕN

Sè lg | Kh lîng

Sè tê: | Tæng sè tê:

ThiÕt kÕ | Ph¹m M¹nh Linh

C«ng ty TNHH Kü ThuËt QLB
