ngoquytuan/DenDaChien/2019/20May19/BanVeDenDaChien2019 27.03.2019/Co khi/ban ve den da chien, Tien luong/03 PL-LMP-12-01_ 03_ 12_ 14.pdf

2.5 9.4
12.5 x 45 85

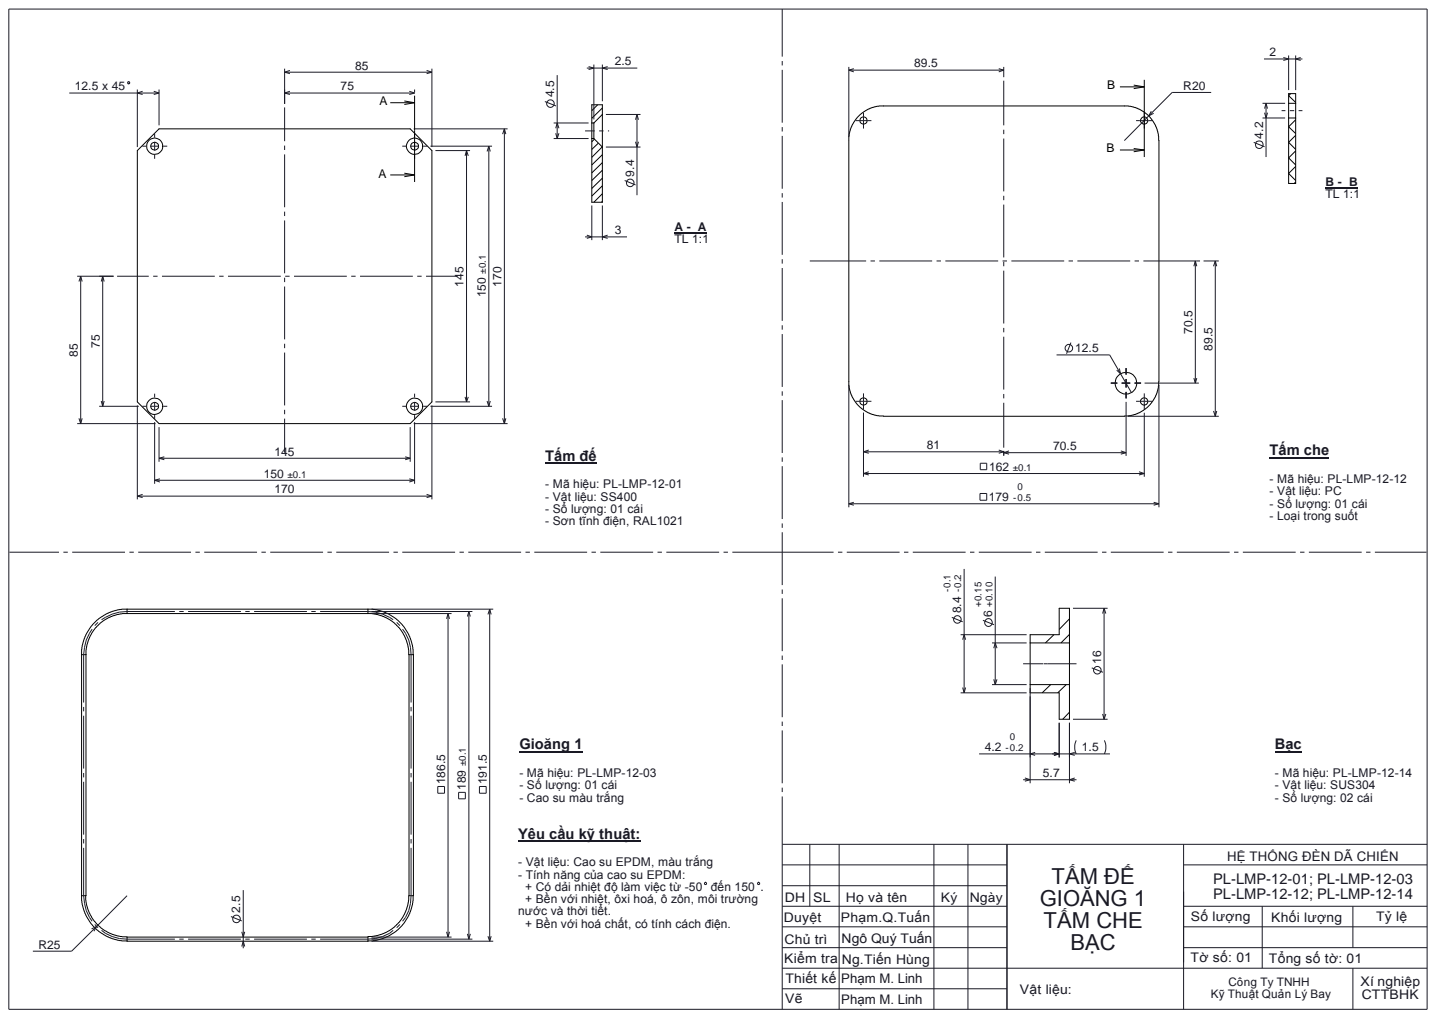
[picture p97: page 1]
Tấm che; Tấm đế; Gioăng 1; Bạc; BẠC; TẤM CHE; TẤM ĐẾ GIOĂNG 1

- Mã hiệu: PL-LMP-12-12
- Vật liệu: PC
- Số lượng: 01 cái
- Loại trong suốt

- Mã hiệu: PL-LMP-12-01
- Vật liệu: SS400
- Sơn tĩnh điện, RAL1021

- Mã hiệu: PL-LMP-12-03
- Cao su màu trắng

- Mã hiệu: PL-LMP-12-14
- Vật liệu: SUS304
- Số lượng: 02 cái

Yêu cầu kỹ thuật:

HỆ THỐNG ĐÈN DÃ CHIẾN
PL-LMP-12-01; PL-LMP-12-03
PL-LMP-12-12; PL-LMP-12-14

- Vật liệu: Cao su EPDM, màu trắng
- Tính năng của cao su EPDM:
+ Có dải nhiệt độ làm việc từ -50 đến 150
+ Bền với nhiệt, ôxi hoá, ô zôn, môi trường
nước và thời tiết.
+ Bền với hoá chất, có tính cách điện.

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
