ngoquytuan/DenDaChien/2019/20May19/BanVeDenDaChien2019 27.03.2019/Co khi/ban ve den da chien, Tien luong/04 PL-LMP-12-02 Than.pdf

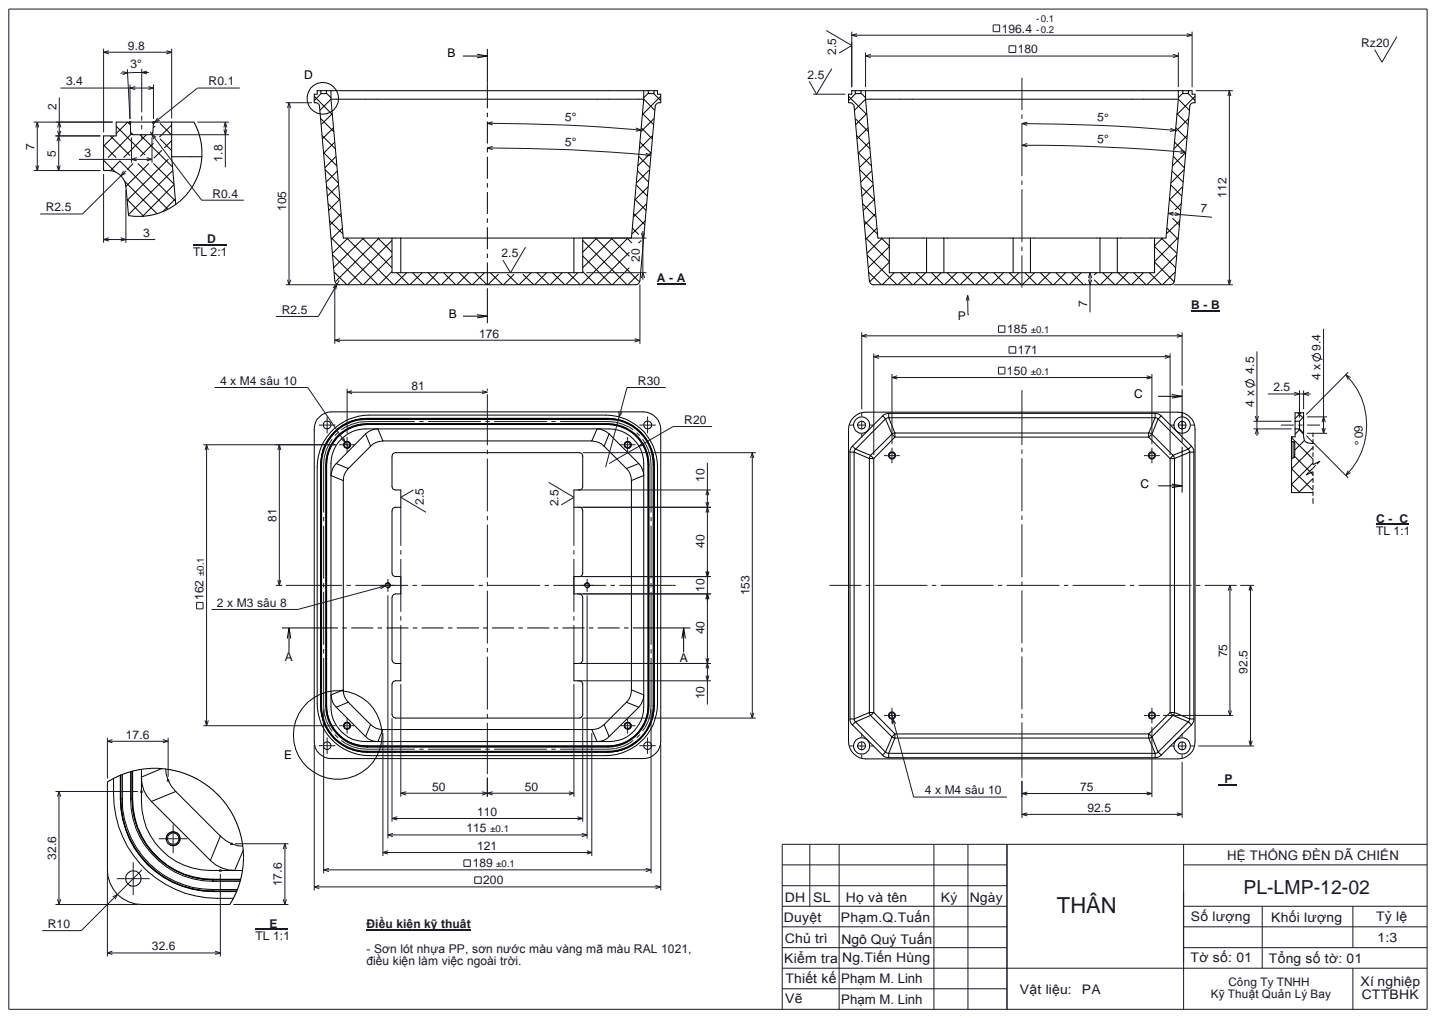
[picture p98: page 1]
4 x M4 sâu 10; 2 x M3 sâu 8; THÂN; Họ và tên; Ngày

HỆ THỐNG ĐÈN DÃ CHIẾN
PL-LMP-12-02

Duyệt | Phạm.Q.Tuấn | | Số lượng | Khối lượng | Tỷ lệ
Chủ trì | Ngô Quý Tuấn | | | | 1:3
Kiểm tra | Ng.Tiến Hùng | | Tờ số: 01 | Tổng số tờ: 01
Thiết kế | Phạm M. Linh | Vật liệu: PA | Công Ty TNHH Kỹ Thuật Quản Lý Bay | | Xí nghiệp CTTBHK
Vẽ | Phạm M. Linh

Điều kiện kỹ thuật

- Sơn lót nhựa PP, sơn nước màu vàng mã màu RAL 1021,
điều kiện làm việc ngoài trời.
