ngoquytuan/DenDaChien/2019/20May19/BanVeDenDaChien2019 27.03.2019/Co khi/ban ve den da chien, Tien luong/05 PL-LMP-12-04 Nap.pdf

12.416.5

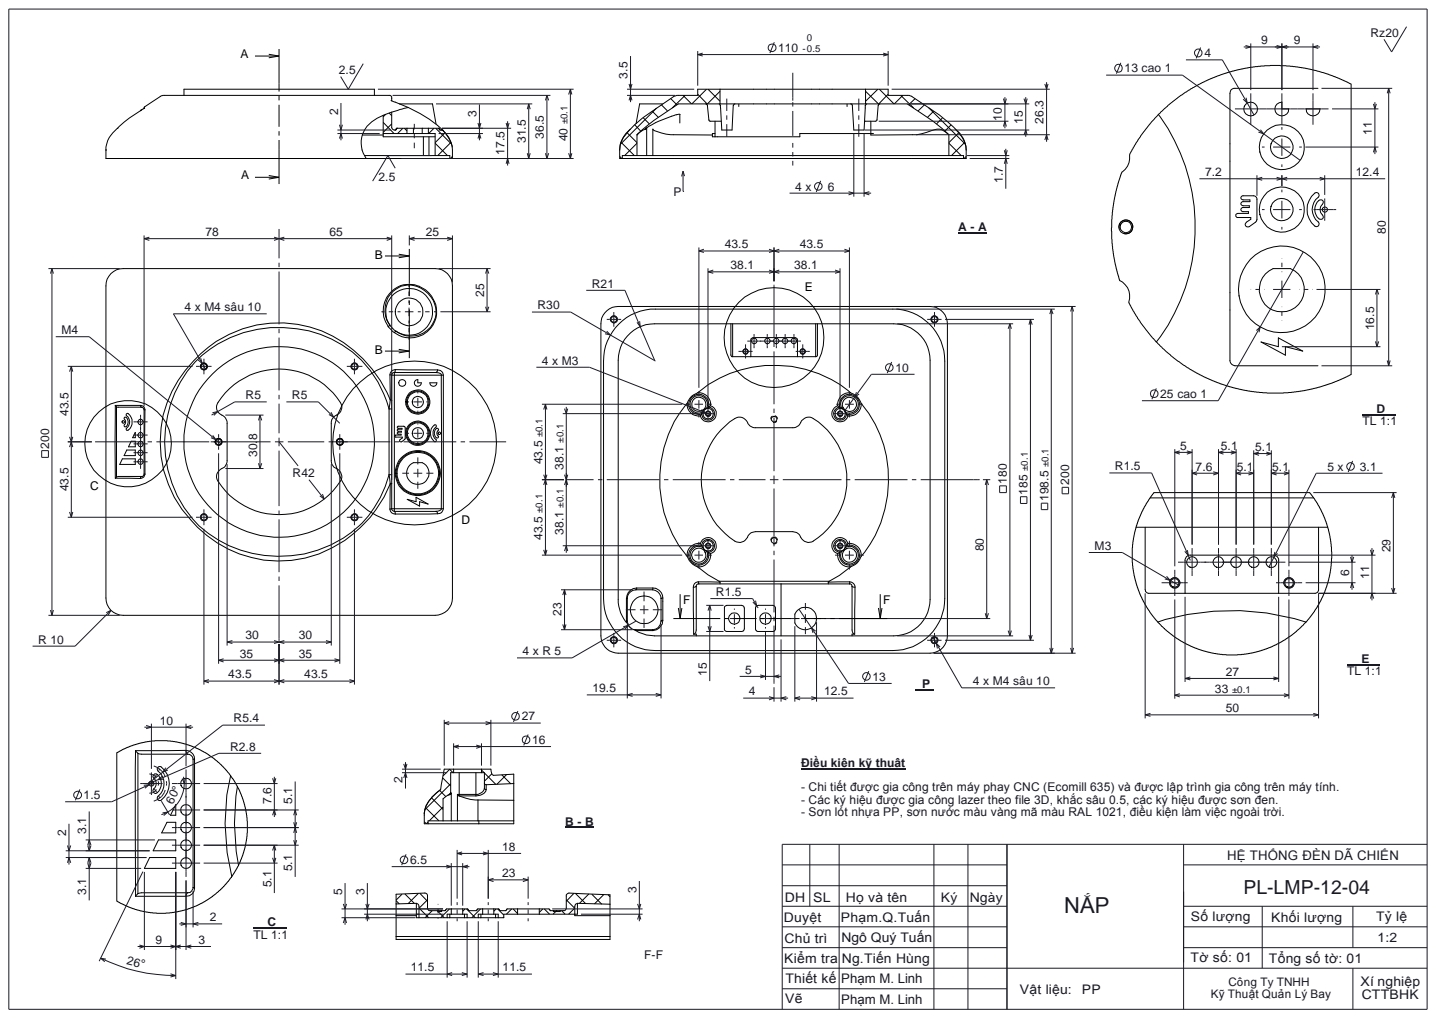
[picture p99: page 1]
4 x M4 sâu 10; NẮP; 13 cao 1; 25 cao 1

Điều kiện kỹ thuật

- Chi tiết được gia công trên máy phay CNC (Ecomill 635) và được lập trình gia công trên máy tính.
- Các ký hiệu được gia công lazer theo file 3D, khắc sâu 0.5, các ký hiệu được sơn đen.
- Sơn lót nhựa PP, sơn nước màu vàng mã màu RAL 1021, điều kiện làm việc ngoài trời.

HỆ THỐNG ĐÈN DÃ CHIẾN
PL-LMP-12-04

DH | SL | Họ và tên | Ký | Ngày
Duyệt | Phạm.Q.Tuấn | | | | Số lượng | Khối lượng | Tỷ lệ
Chủ trì | Ngô Quý Tuấn | | | | | | 1:2
Kiểm tra | Ng.Tiến Hùng | | | | Tờ số: 01 | Tổng số tờ: 01
Thiết kế | Phạm M. Linh | | | Vật liệu: PP | Công Ty TNHH Kỹ Thuật Quản Lý Bay | | Xí nghiệp CTTBHK
Vẽ | Phạm M. Linh
