ngoquytuan/DenDaChien/2019/20May19/BanVeDenDaChien2019 27.03.2019/Co khi/ban ve den da chien, Tien luong/06 PL-LMP-12-05_ 06_ 07_ 13 Boc tay cam.pdf

110 ±0.1 20

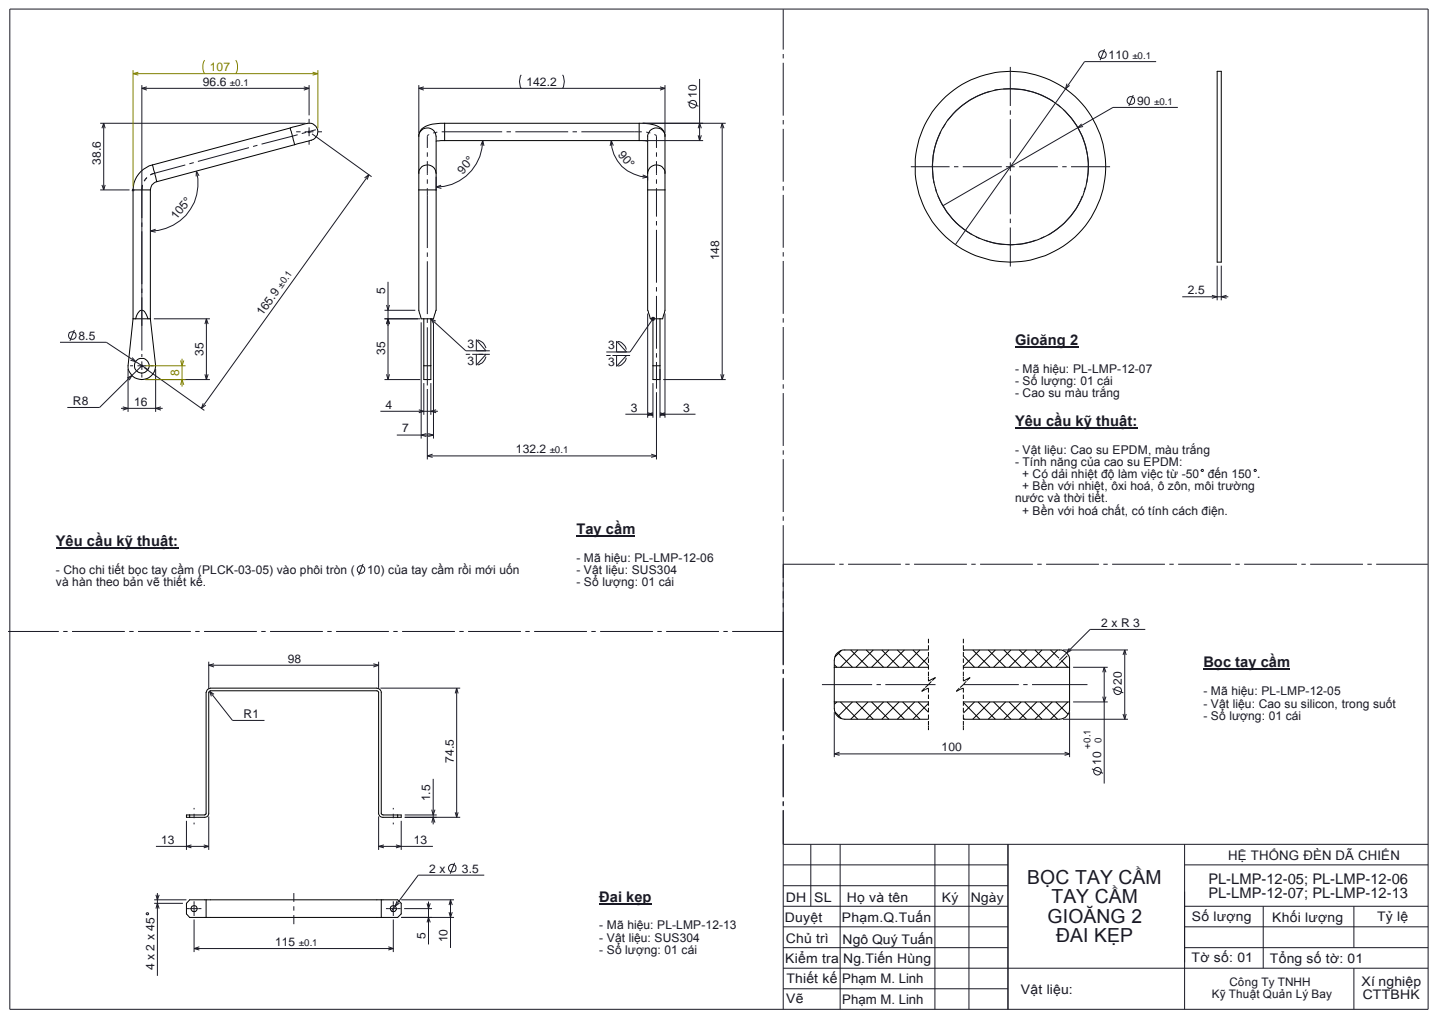
[picture p100: page 1]
đến 150; Tay cầm; Đai kẹp; Gioăng 2

- Mã hiệu: PL-LMP-12-07
- Số lượng: 01 cái
- Cao su màu trắng
Yêu cầu kỹ thuật:

- Vật liệu: Cao su EPDM, màu trắng
- Tính năng của cao su EPDM:
+ Có dải nhiệt độ làm việc từ -50
+ Bền với nhiệt, ôxi hoá, ô zôn, môi trường
nước và thời tiết.
+ Bền với hoá chất, có tính cách điện.

- Mã hiệu: PL-LMP-12-06
- Vật liệu: SUS304

- Cho chi tiết bọc tay cầm (PLCK-03-05) vào phôi tròn ( 10) của tay cầm rồi mới uốn
và hàn theo bản vẽ thiết kế.

Bọc tay cầm

- Mã hiệu: PL-LMP-12-05
- Vật liệu: Cao su silicon, trong suốt

HỆ THỐNG ĐÈN DÃ CHIẾN
PL-LMP-12-05; PL-LMP-12-06
PL-LMP-12-07; PL-LMP-12-13

BỌC TAY CẦM
TAY CẦM
GIOĂNG 2
ĐAI KẸP

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

- Mã hiệu: PL-LMP-12-13
