ngoquytuan/DenDaChien/2019/20May19/BanVeDenDaChien2019 27.03.2019/Co khi/ban ve den da chien, Tien luong/07 PL-LMP-12-08 Than tren.pdf

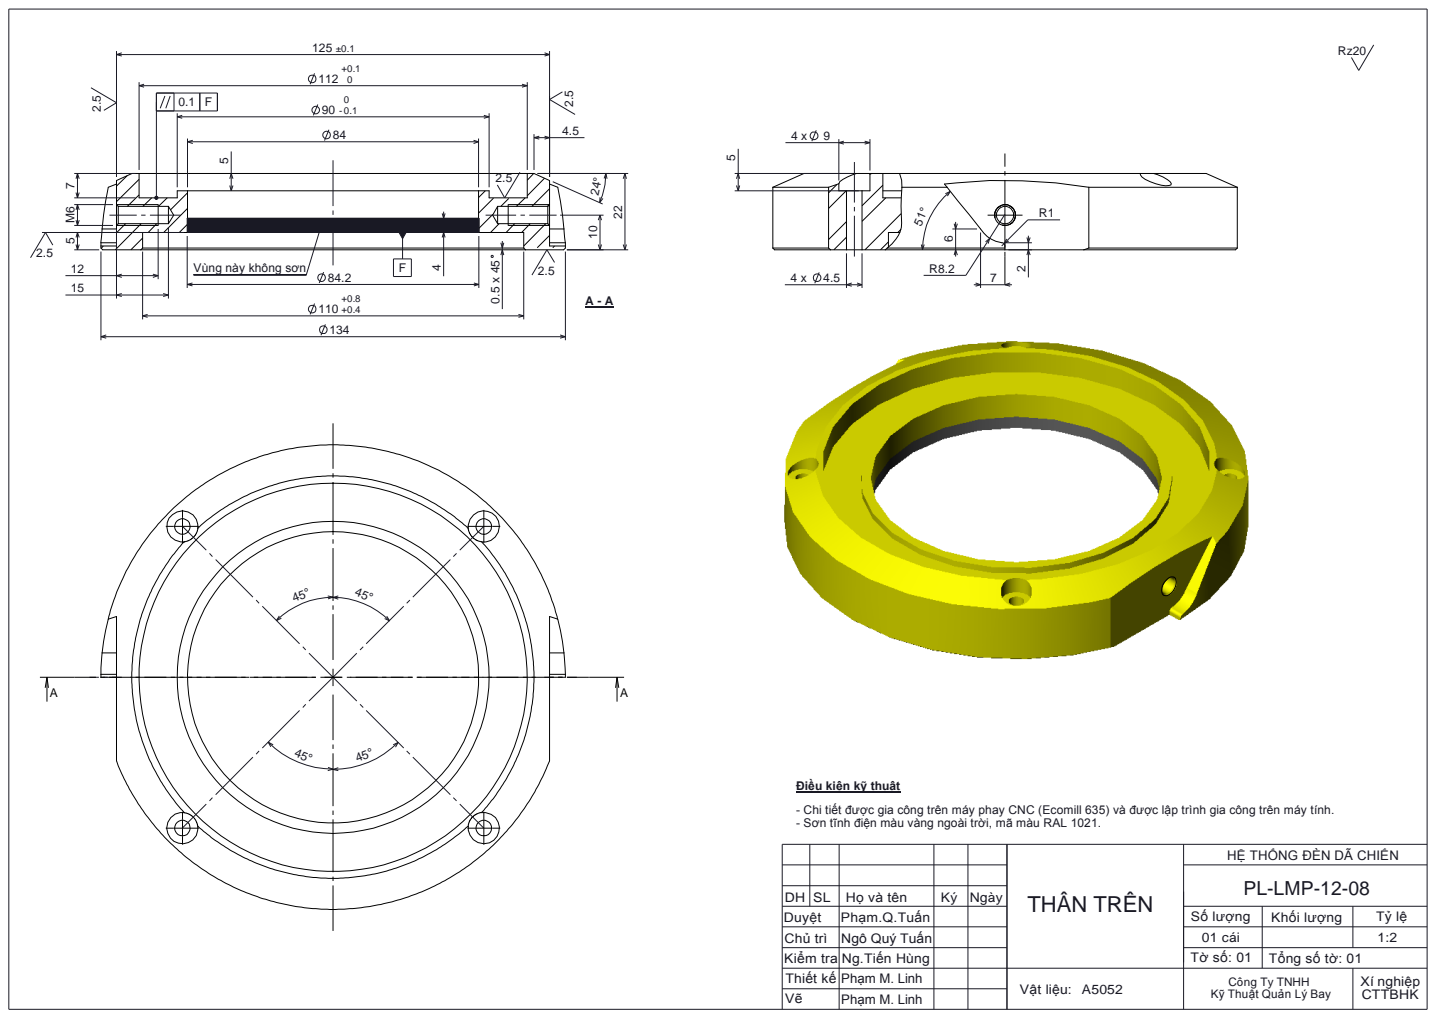
[picture p101: page 1]
THÂN TRÊN; Vùng này không sơn

Điều kiện kỹ thuật

- Chi tiết được gia công trên máy phay CNC (Ecomill 635) và được lập trình gia công trên máy tính.
- Sơn tĩnh điện màu vàng ngoài trời, mã màu RAL 1021.

HỆ THỐNG ĐÈN DÃ CHIẾN
PL-LMP-12-08

DH | SL | Họ và tên | Ký | Ngày
Duyệt | Phạm.Q.Tuấn | | | | Số lượng | Khối lượng | Tỷ lệ
Chủ trì | Ngô Quý Tuấn | | | | 01 cái | | 1:2
Kiểm tra | Ng.Tiến Hùng | | | | Tờ số: 01 | Tổng số tờ: 01
Thiết kế | Phạm M. Linh | | | Vật liệu: A5052 | Công Ty TNHH Kỹ Thuật Quản Lý Bay | | Xí nghiệp CTTBHK
Vẽ | Phạm M. Linh
