ngoquytuan/DenDaChien/2019/20May19/BanVeDenDaChien2019 27.03.2019/Co khi/ban ve dong goi/01 DG-PL-LMP-12-00 Den da chien.pdf

02

90

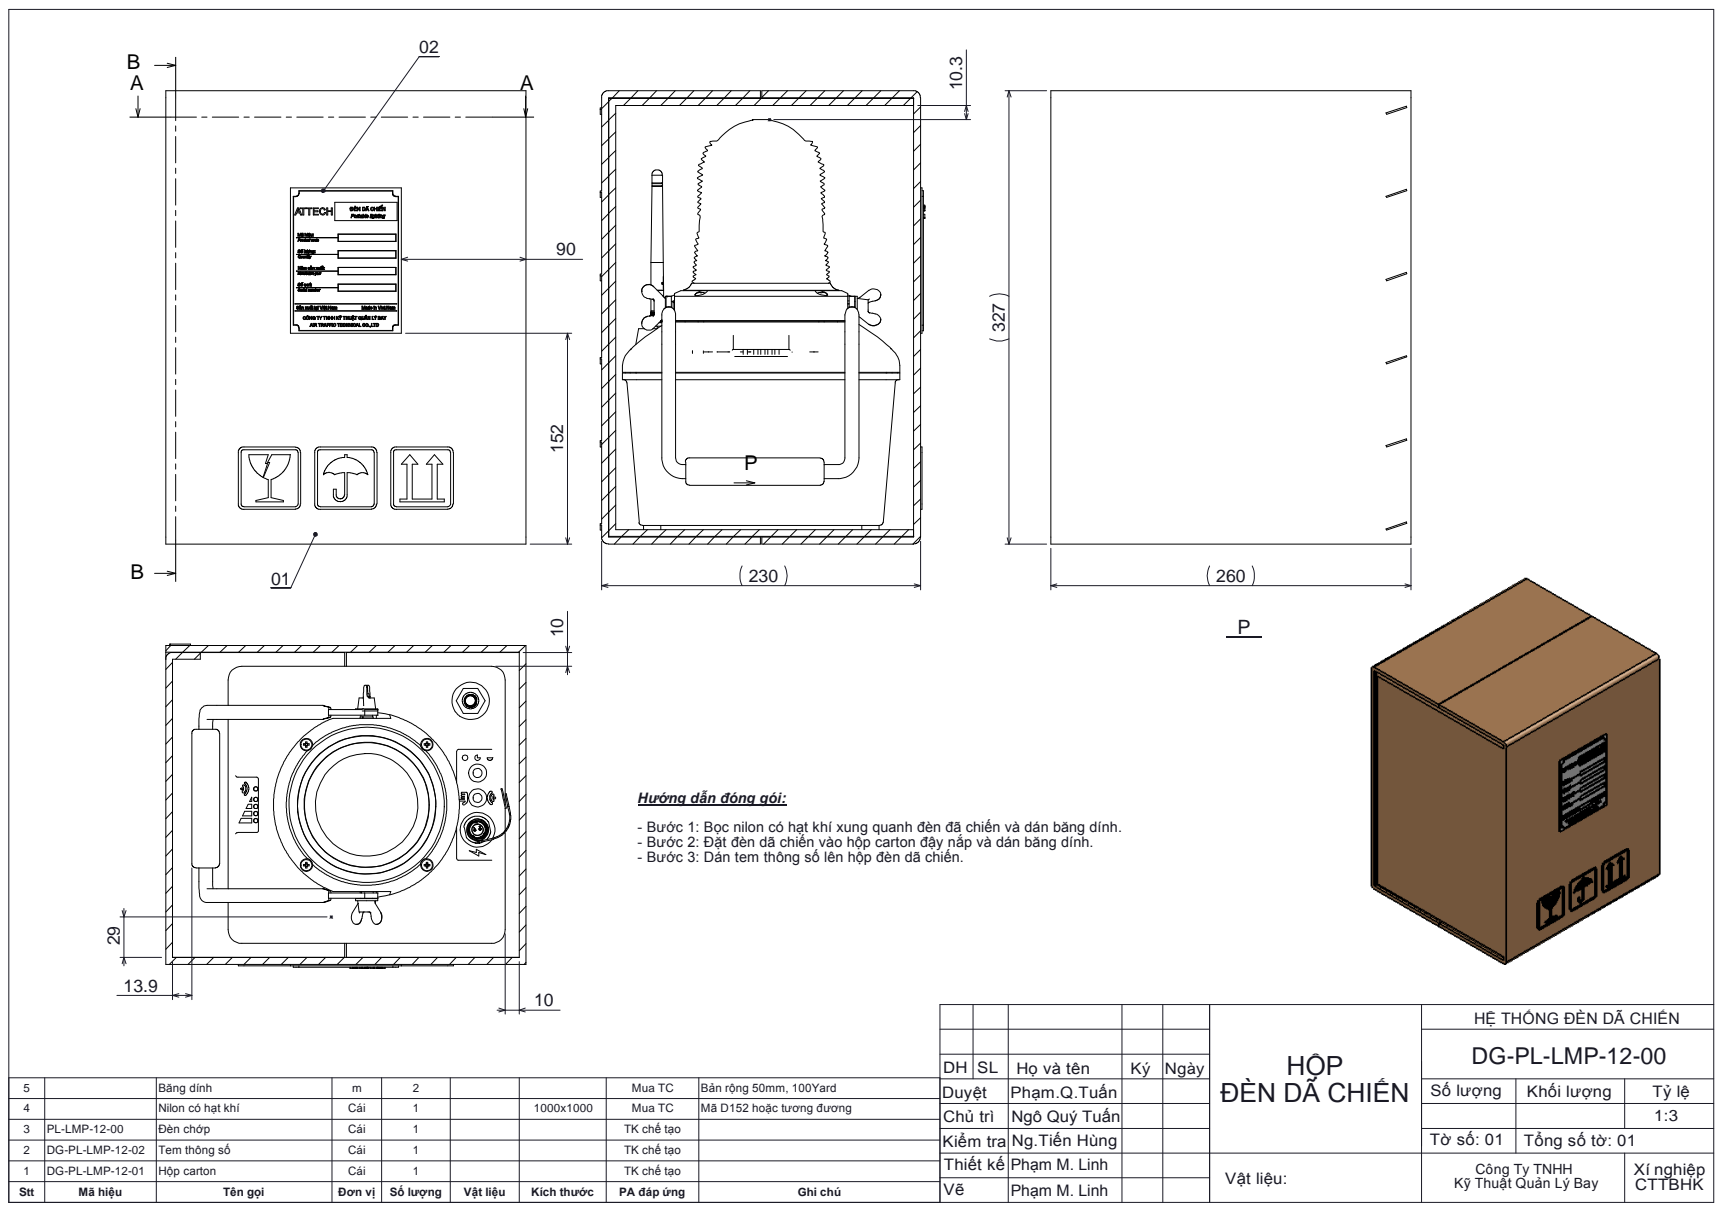
[picture p103: page 1]
Băng dính; Mua TC; Bản rộng 50mm, 100Yard; Nilon có hạt khí; Cái; Mã D152 hoặc tương đương; PL-LMP-12-00; Đèn chớp; TK chế tạo; DG-PL-LMP-12-02; Tem thông số; DG-PL-LMP-12-01; Hộp carton; Stt; Mã hiệu; Tên gọi; Đơn vị; Số lượng; Vật liệu; Kích thước; PA đáp ứng; Ghi chú

Hướng dẫn đóng gói:

- Bước 1: Bọc nilon có hạt khí xung quanh đèn đã chiến và dán băng dính.
- Bước 2: Đặt đèn dã chiến vào hộp carton đậy nắp và dán băng dính.
- Bước 3: Dán tem thông số lên hộp đèn dã chiến.

HỆ THỐNG ĐÈN DÃ CHIẾN
DG-PL-LMP-12-00

HỘP
ĐÈN DÃ CHIẾN

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
