ngoquytuan/DenDaChien/2019/20May19/BanVeDenDaChien2019 27.03.2019/Co khi/ban ve dong goi/02 DG-PL-LMP-12-01 Hop carton.pdf

A

A

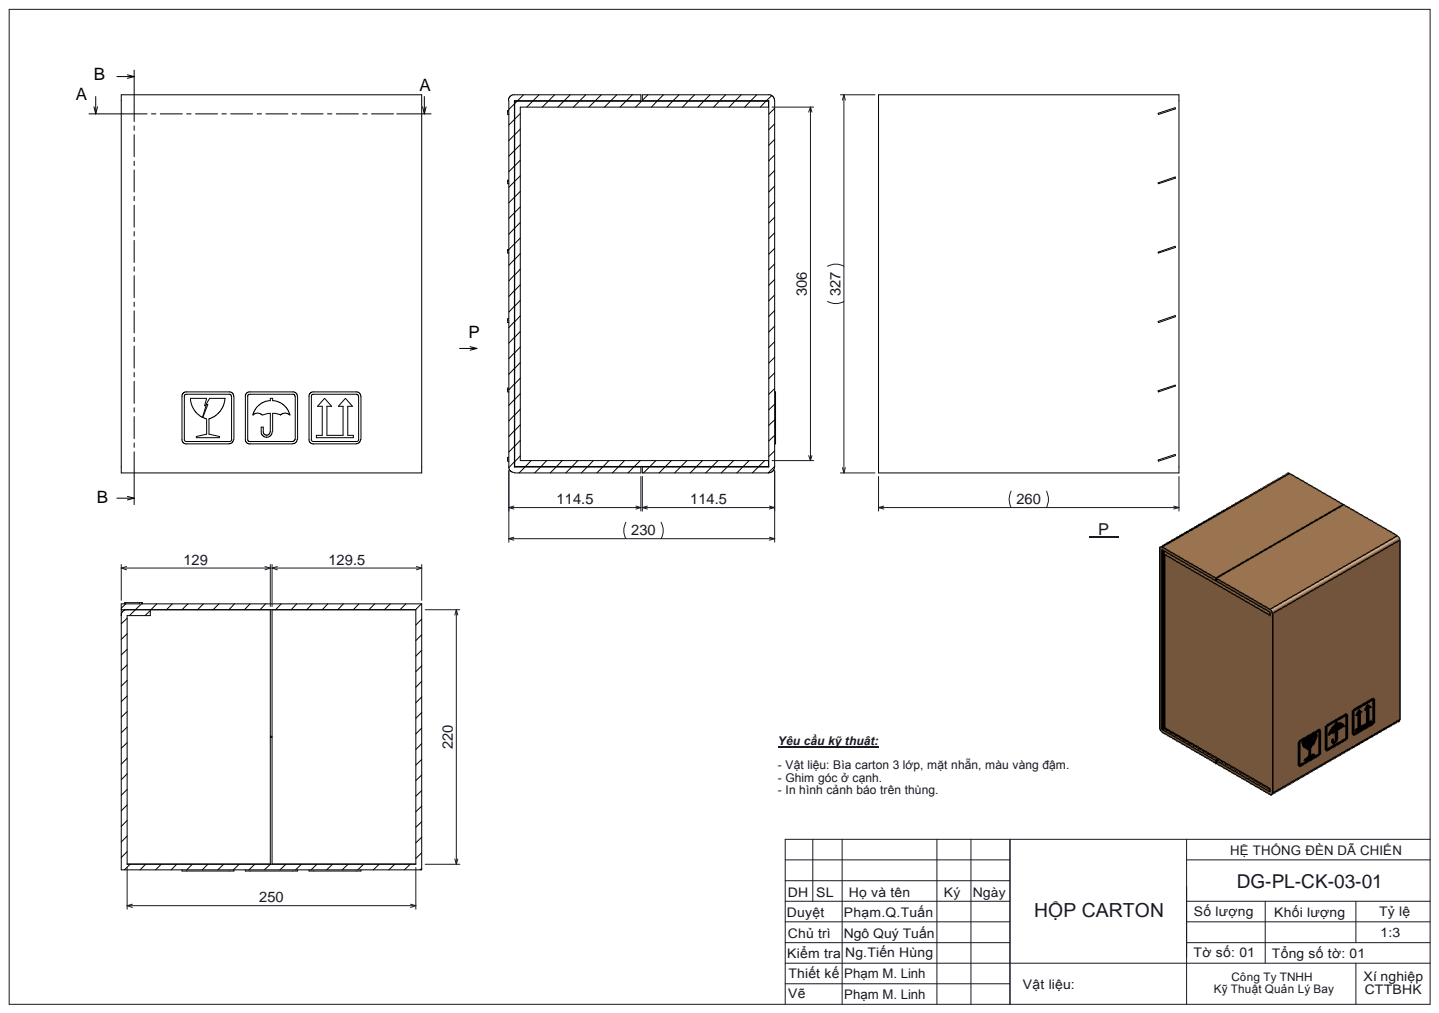
[picture p104: page 1]
HỘP CARTON

Yêu cầu kỹ thuật:

- Vật liệu: Bìa carton 3 lớp, mặt nhẵn, màu vàng đậm.
- Ghim góc ở cạnh.
- In hình cảnh báo trên thùng.

HỆ THỐNG ĐÈN DÃ CHIẾN

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
