ngoquytuan/DenDaChien/2019/20May19/BanVeDenDaChien2019 27.03.2019/Co khi/ban ve xe nguon/PL-XN....pdf

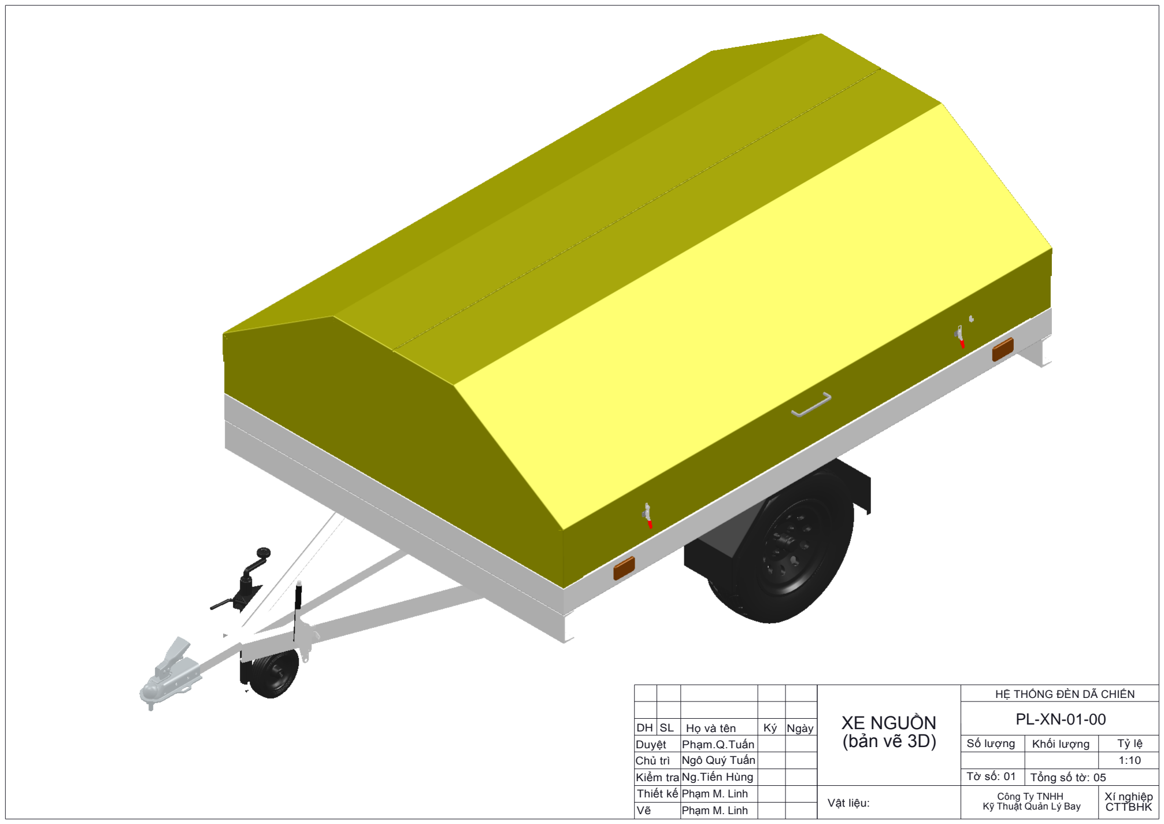
[picture p105: page 1]

# (bản vẽ 3D)

# PL-XN-01-00

DH | SL | Họ và tên | Ký | Ngày
Duyệt | Phạm.Q.Tuấn | | | | Số lượng | Khối lượng | Tỷ lệ
Chủ trì | Ngô Quý Tuấn
Kiểm tra | Ng.Tiến Hùng | | | | Tờ số: 01 | Tổng số tờ: 05
Thiết kế | Phạm M. Linh | | | Vật liệu: | Công Ty TNHH Kỹ Thuật Quản Lý Bay | | Xí nghiệp CTTBHK
Vẽ | Phạm M. Linh

## HỆ THỐNG ĐÈN DÃ CHIẾN

# XE NGUỒN

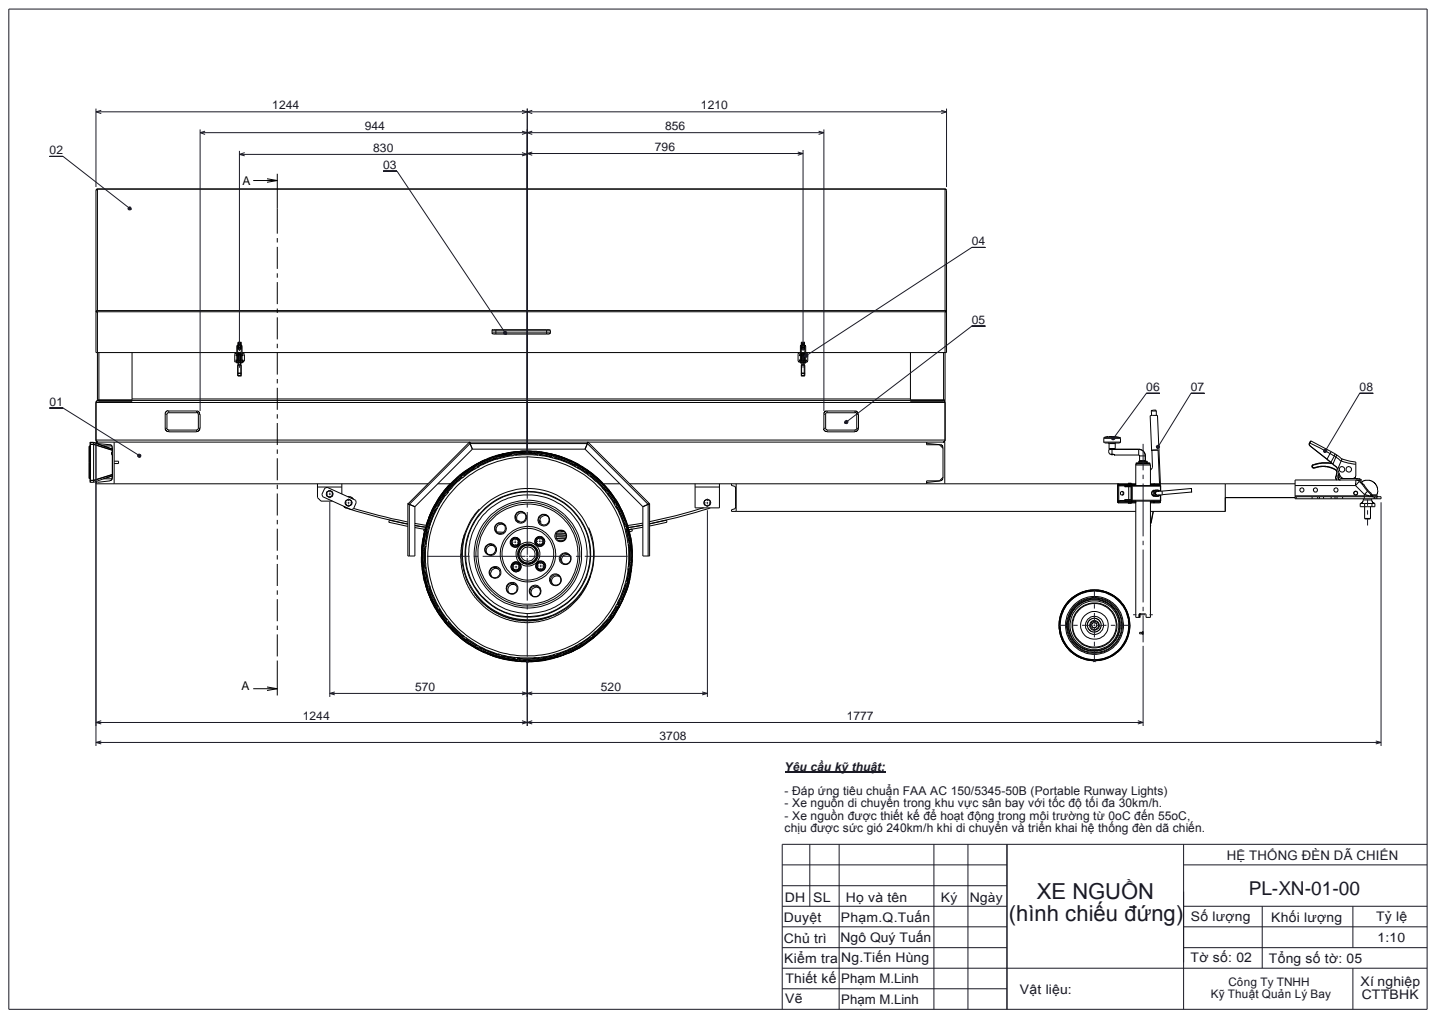
[picture p106: page 2]

944 | 856
830 | 796

Yêu cầu kỹ thuật:

- Đáp ứng tiêu chuẩn FAA AC 150/5345-50B (Portable Runway Lights)
- Xe nguồn di chuyển trong khu vực sân bay với tốc độ tối đa 30km/h.
- Xe nguồn được thiết kế để hoạt động trong môi trường từ 0oC đến 55oC,
chịu được sức gió 240km/h khi di chuyển và triển khai hệ thống đèn dã chiến.

HỆ THỐNG ĐÈN DÃ CHIẾN

XE NGUỒN
(hình chiếu đứng)

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

Ngô Quý Tuấn

Tờ số: 02 | Tổng số tờ: 05

Phạm M.Linh | | | | | | Xí nghiệp
Phạm M.Linh

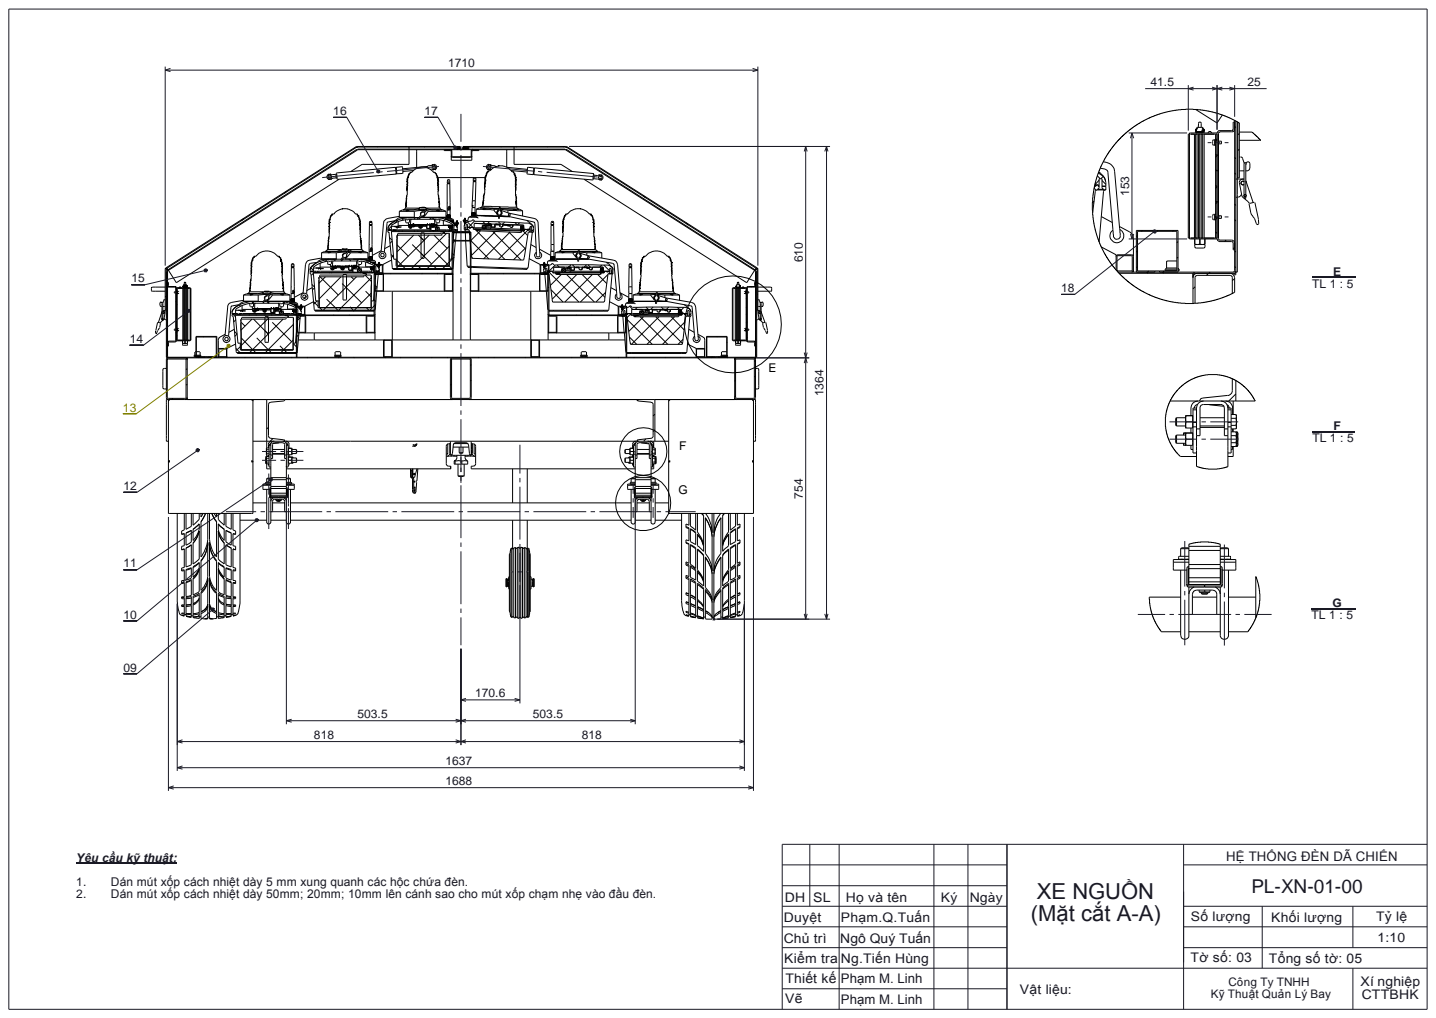
[picture p107: page 3]
(Mặt cắt A-A); XE NGUỒN

HỆ THỐNG ĐÈN DÃ CHIẾN

Yêu cầu kỹ thuật:

1. Dán mút xốp cách nhiệt dày 5 mm xung quanh các hộc chứa đèn.
2. Dán mút xốp cách nhiệt dày 50mm; 20mm; 10mm lên cánh sao cho mút xốp chạm nhẹ vào đầu đèn.

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

Ngô Quý Tuấn

Tờ số: 03 | Tổng số tờ: 05

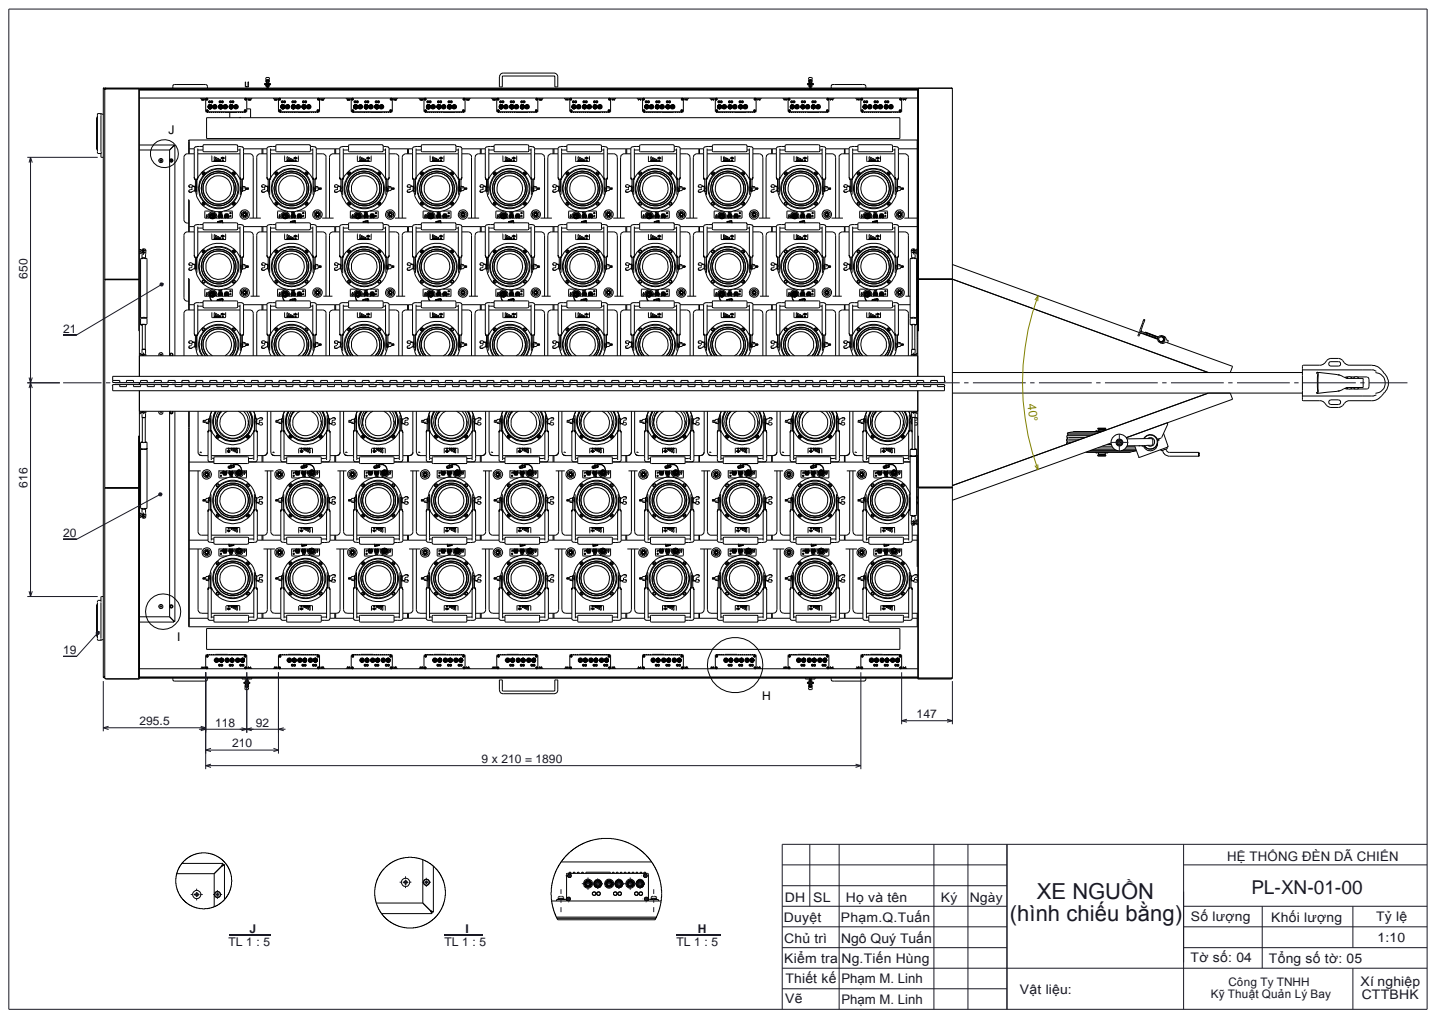
[picture p108: page 4]

HỆ THỐNG ĐÈN DÃ CHIẾN

XE NGUỒN
(hình chiếu bằng)

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

Ngô Quý Tuấn

Tờ số: 04 | Tổng số tờ: 05

21 | PL-XN-01-06 | Tủ đựng cáp | Cái | 1 | | | TK chế tạo | Sơn tĩnh điện mã màu RAL1021
20 | PL-XN-01-05 | Tủ nguồn | Cái | 1 | | | TK chế tạo | Sơn tĩnh điện mã màu RAL1021
19 | | Đèn sau | Cái | 2 | | | Mua TC
18 | | Máng nhựa W60xH60 | m | 6 | | | Mua TC | Màu xám, mã HVDR6060 theo thế giới điện hoặc tương đương
17 | | Bản lề pianô | Bộ | 2 | | | Mua TC
16 | | Pittông đẩy | Bộ | 4 | | | Mua TC
15 | PL-XN-01-04 | Thùng xe | Cái | 1 | | | TK chế tạo | Sơn tĩnh điện mã màu RAL1021
14 | PL-XN-01-07 | Bộ sạc | Bộ | 20 | | | Mua TC
13 | | Đèn dã chiến | Bộ | 60 | | | TK chế tạo
12 | PL-XN-01-03 | Chắn bùn | Cái | 2 | | | TK chế tạo | Sơn tĩnh điện mã màu RAL1021
11 | | Nhíp xe (tải trọng 750kg) | Bộ | 2 | | | Mua TC | Mã: 1 225 345 công ty AL-KO Kober hoặc tương đương
10 | | Trục xe (trục + may ơ + tang phanh); tải trọng 1500kg. Mã RIGID GBR PLUS BS 1500; OHF=1600mm hoặc tương đương. | Bộ | 1 | | | Mua TC | Mã: 200 583 08 công ty AL-KO Kober hoặc tương đương
9 | | Bánh xe | Bộ | 2 | | | Mua TC | Bánh xe 5.00-13 (đường kính 596mm; chiều rộng lốp 157mm) + Vành xe 4.00BX13; Mã: SRC 5.00 - 13 - 12PR hoặc tương đương
8 | | Khóa khớp | Bộ | 1 | | | Mua TC | Mã: 1 224 106 công ty AL-KO Kober hoặc tương đương
7 | | Hệ thống phanh cơ kéo tay kiểu tang trống | Bộ | 1 | | | Mua TC | Mã: 249 775 cho tay phanh; Mã: 1 730 026 cho tang trống; Mã: 200 581 09 cho Đây phanh công ty AL-KO Kober hoặc tương đương.
6 | | Hệ thống bánh dẫn hướng | Bộ | 1 | | | Mua TC | Mã: 242 061 công ty AL-KO Kober hoặc tương đương
5 | | Đèn hồi | Cái | 4 | | | Mua TC
4 | | Khóa | Cái | 4 | | | Mua TC
3 | | Tay cầm | Cái | 2 | | | Mua TC | mã USAN160 hoặc tương đương
2 | PL-XN-01-02 | Cánh | Cái | 2 | | | TK chế tạo | Sơn tĩnh điện mã màu RAL1021
1 | PL-XN-01-01 | Khung | Cái | 1 | | | TK chế tạo | Mạ kẽm nhúng nóng ASTM123A
Stt | Mã hiệu | Tên gọi | Đ.Vị | Số lượng | Vật liệu | Kích thước | PA đáp ứng | Ghi chú
| | | | | XE NGUỒN (bảng kê) | HỆ THỐNG ĐÈN DÃ CHIẾN
SĐ | SL | Họ và tên | Ký | Ngày
Chủ trì | Ngô Quý Tuấn | | | | Số lượng | Khối lượng | Tỷ lệ
| Trần Đức
| | | | | Tờ số: 05 | Tổng số tờ: 05
QLKT | | | | | | | PHÒNG NCPT
Duyệt | Phạm.Q.Tuấn

## PL-XN-01-00

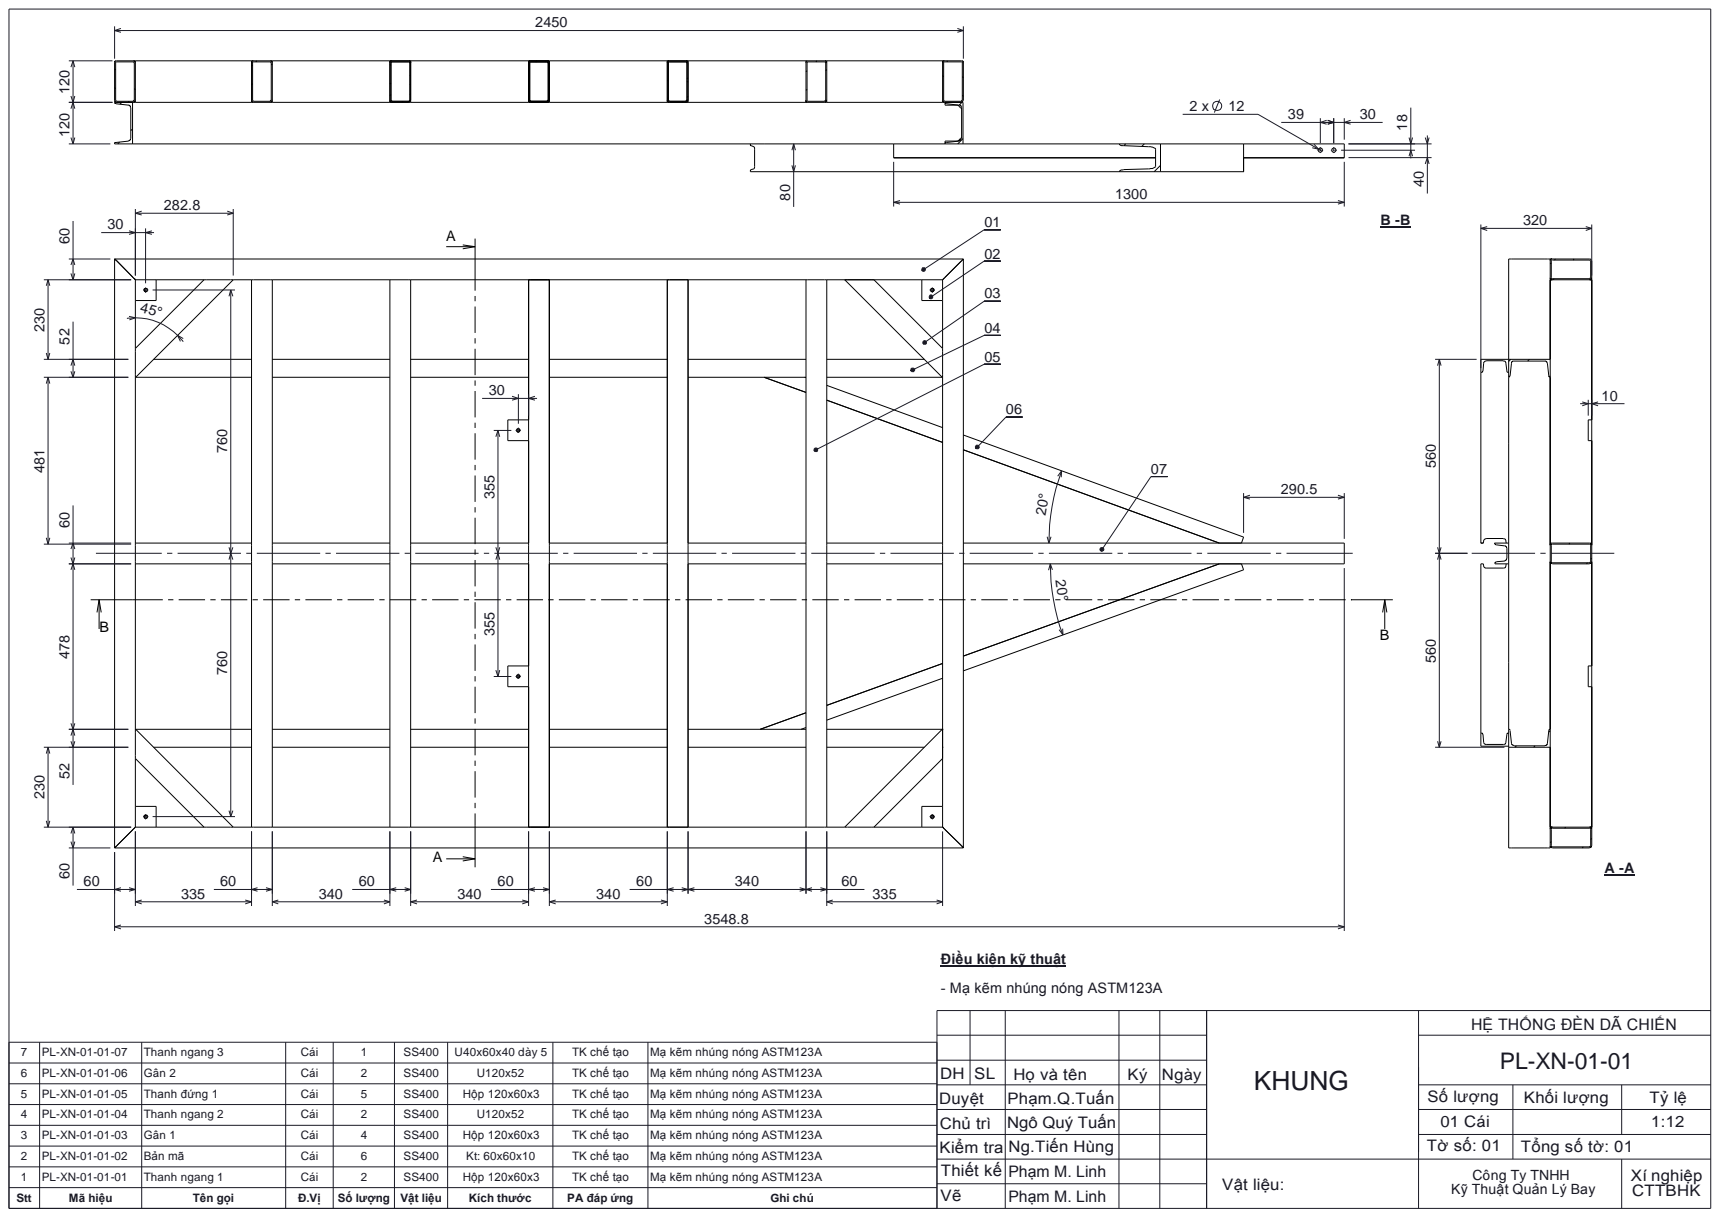
[picture p109: page 6]
KHUNG; Chủ trì; 01 Cái

Điều kiện kỹ thuật

- Mạ kẽm nhúng nóng ASTM123A

HỆ THỐNG ĐÈN DÃ CHIẾN

7 | PL-XN-01-01-07 | Thanh ngang 3 | Cái | 1 | SS400 | U40x60x40 dày 5 | TK chế tạo | Mạ kẽm nhúng nóng ASTM123A
6 | PL-XN-01-01-06 | Gân 2 | Cái | 2 | SS400 | U120x52 | TK chế tạo | Mạ kẽm nhúng nóng ASTM123A | DH | SL | Họ và tên | Ký | Ngày
5 | PL-XN-01-01-05 | Thanh đứng 1 | Cái | 5 | SS400 | Hộp 120x60x3 | TK chế tạo | Mạ kẽm nhúng nóng ASTM123A | Duyệt | Phạm.Q.Tuấn | | | | Số lượng | Khối lượng | Tỷ lệ
4 | PL-XN-01-01-04 | Thanh ngang 2 | Cái | 2 | SS400 | U120x52 | TK chế tạo | Mạ kẽm nhúng nóng ASTM123A
3 | PL-XN-01-01-03 | Gân 1 | Cái | 4 | SS400 | Hộp 120x60x3 | TK chế tạo | Mạ kẽm nhúng nóng ASTM123A
2 | PL-XN-01-01-02 | Bản mã | Cái | 6 | SS400 | Kt: 60x60x10 | TK chế tạo | Mạ kẽm nhúng nóng ASTM123A
1 | PL-XN-01-01-01 | Thanh ngang 1 | Cái | 2 | SS400 | Hộp 120x60x3 | TK chế tạo | Mạ kẽm nhúng nóng ASTM123A

Ngô Quý Tuấn

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

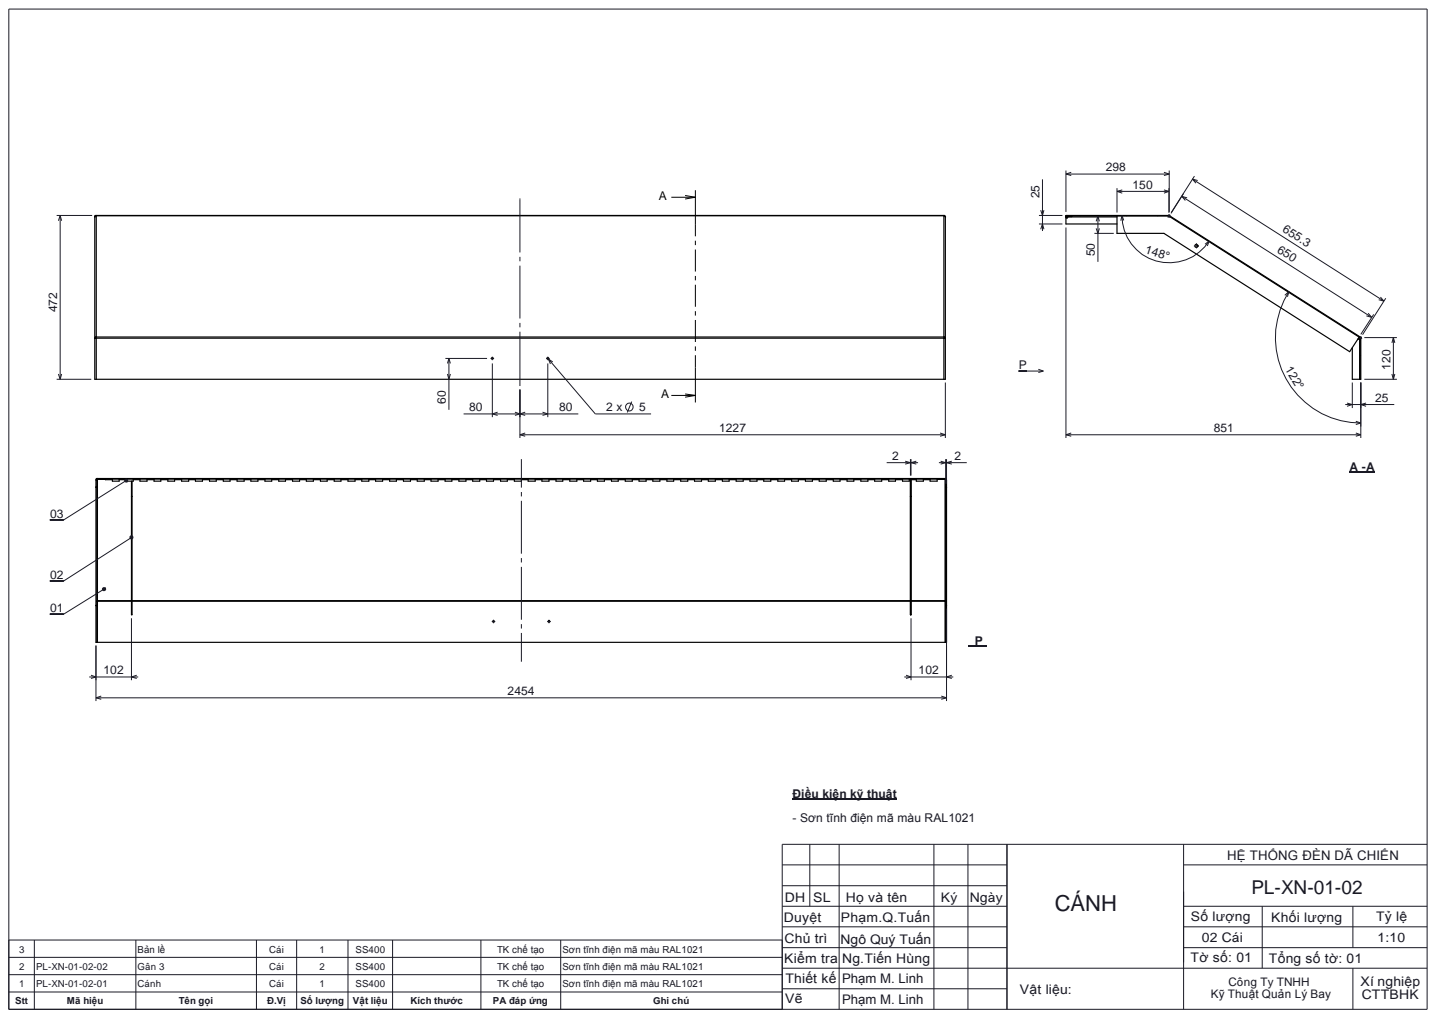
[picture p110: page 7]
CÁNH

Điều kiện kỹ thuật

- Sơn tĩnh điện mã màu RAL1021

HỆ THỐNG ĐÈN DÃ CHIẾN

DH | SL | Họ và tên | Ký | Ngày
Duyệt | Phạm.Q.Tuấn | | | | Số lượng | Khối lượng | Tỷ lệ
Chủ trì | Ngô Quý Tuấn | | | | 02 Cái

3 | | Bản lề | Cái | 1 | SS400 | | TK chế tạo | Sơn tĩnh điện mã màu RAL1021
2 | PL-XN-01-02-02 | Gân 3 | Cái | 2 | SS400 | | TK chế tạo | Sơn tĩnh điện mã màu RAL1021
1 | PL-XN-01-02-01 | Cánh | Cái | 1 | SS400 | | TK chế tạo | Sơn tĩnh điện mã màu RAL1021
Stt | Mã hiệu | Tên gọi | Đ.Vị | Số lượng | Vật liệu | Kích thước | PA đáp ứng | Ghi chú

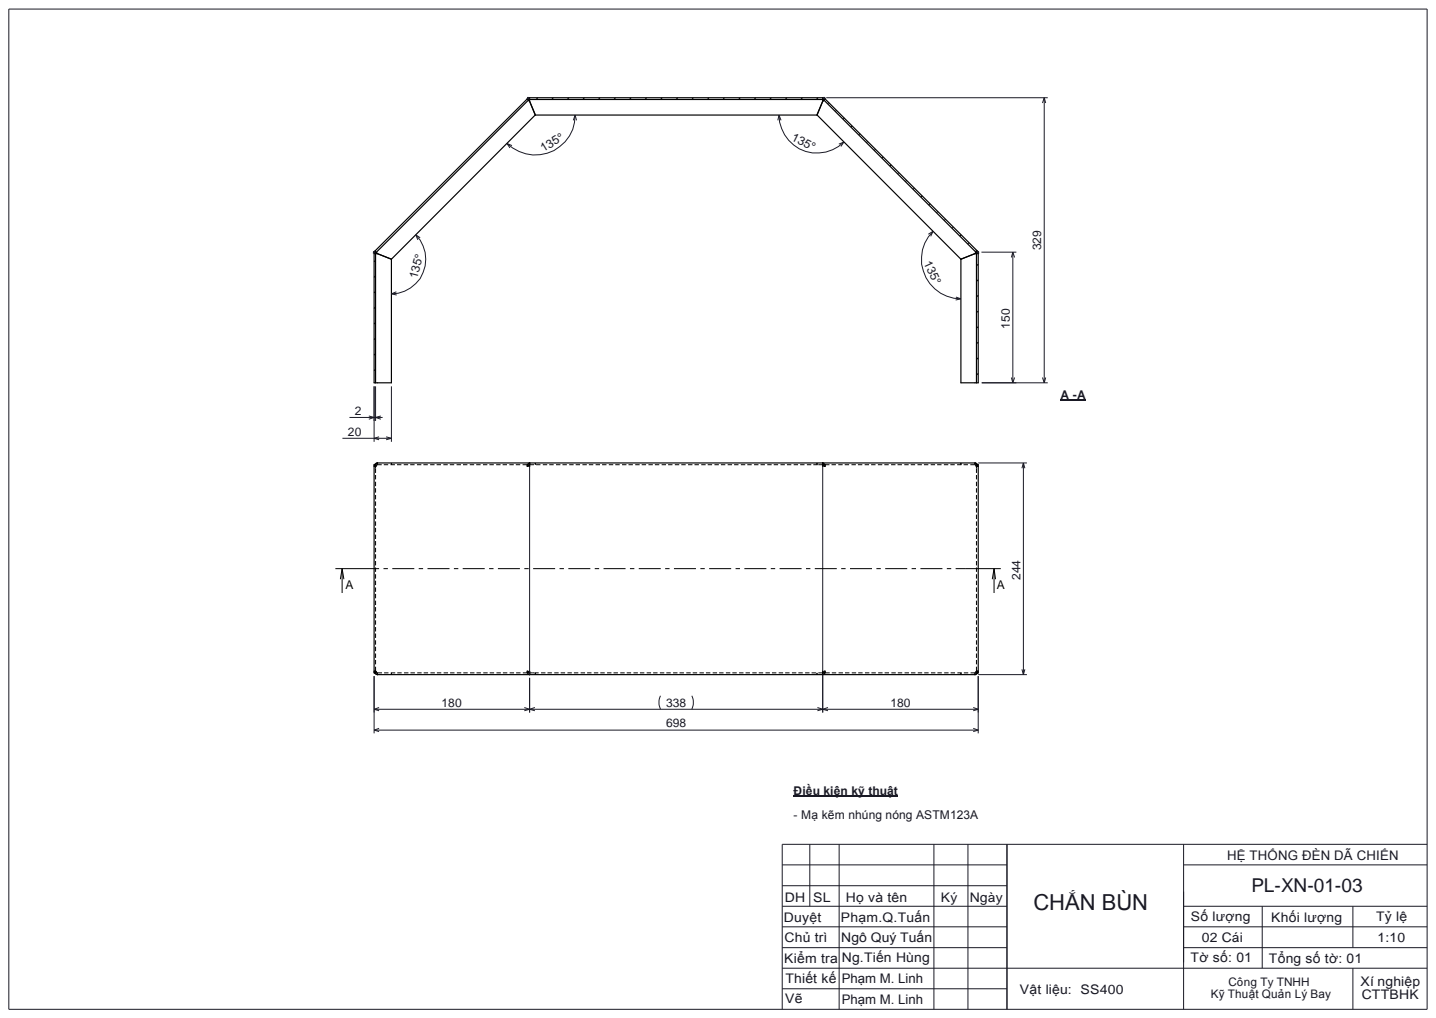
[picture p111: page 8]
CHẮN BÙN

Điều kiện kỹ thuật

- Mạ kẽm nhúng nóng ASTM123A

HỆ THỐNG ĐÈN DÃ CHIẾN

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

Ngô Quý Tuấn | | | | 02 Cái

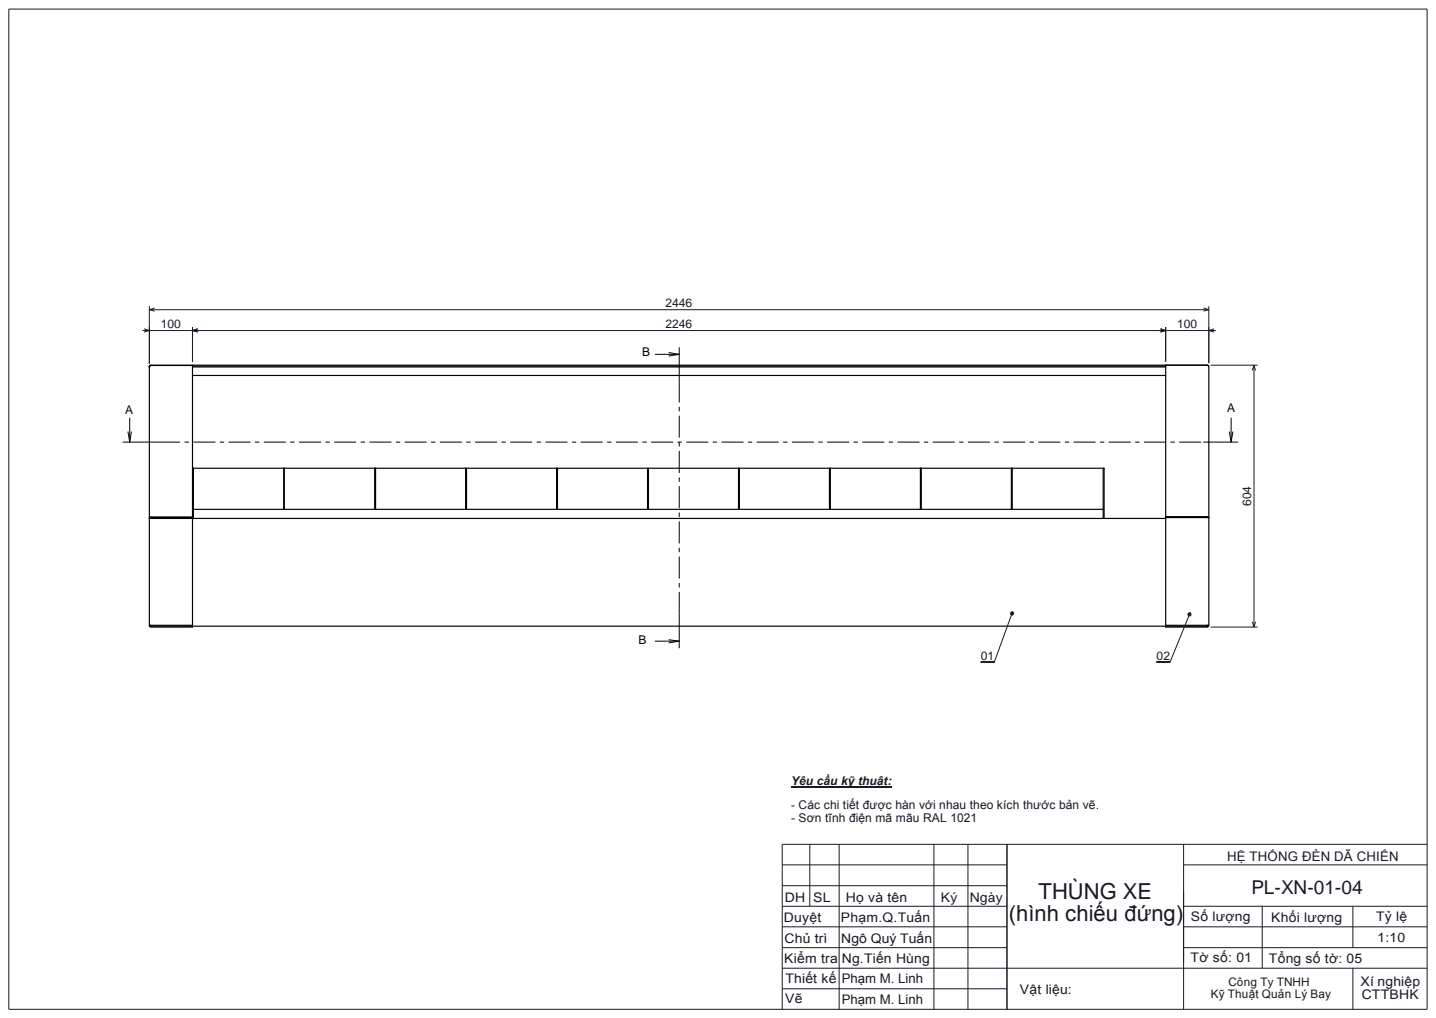
[picture p112: page 9]

Yêu cầu kỹ thuật:

- Các chi tiết được hàn với nhau theo kích thước bản vẽ.
- Sơn tĩnh điện mã mãu RAL 1021

HỆ THỐNG ĐÈN DÃ CHIẾN

THÙNG XE
(hình chiếu đứng)

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

Ngô Quý Tuấn

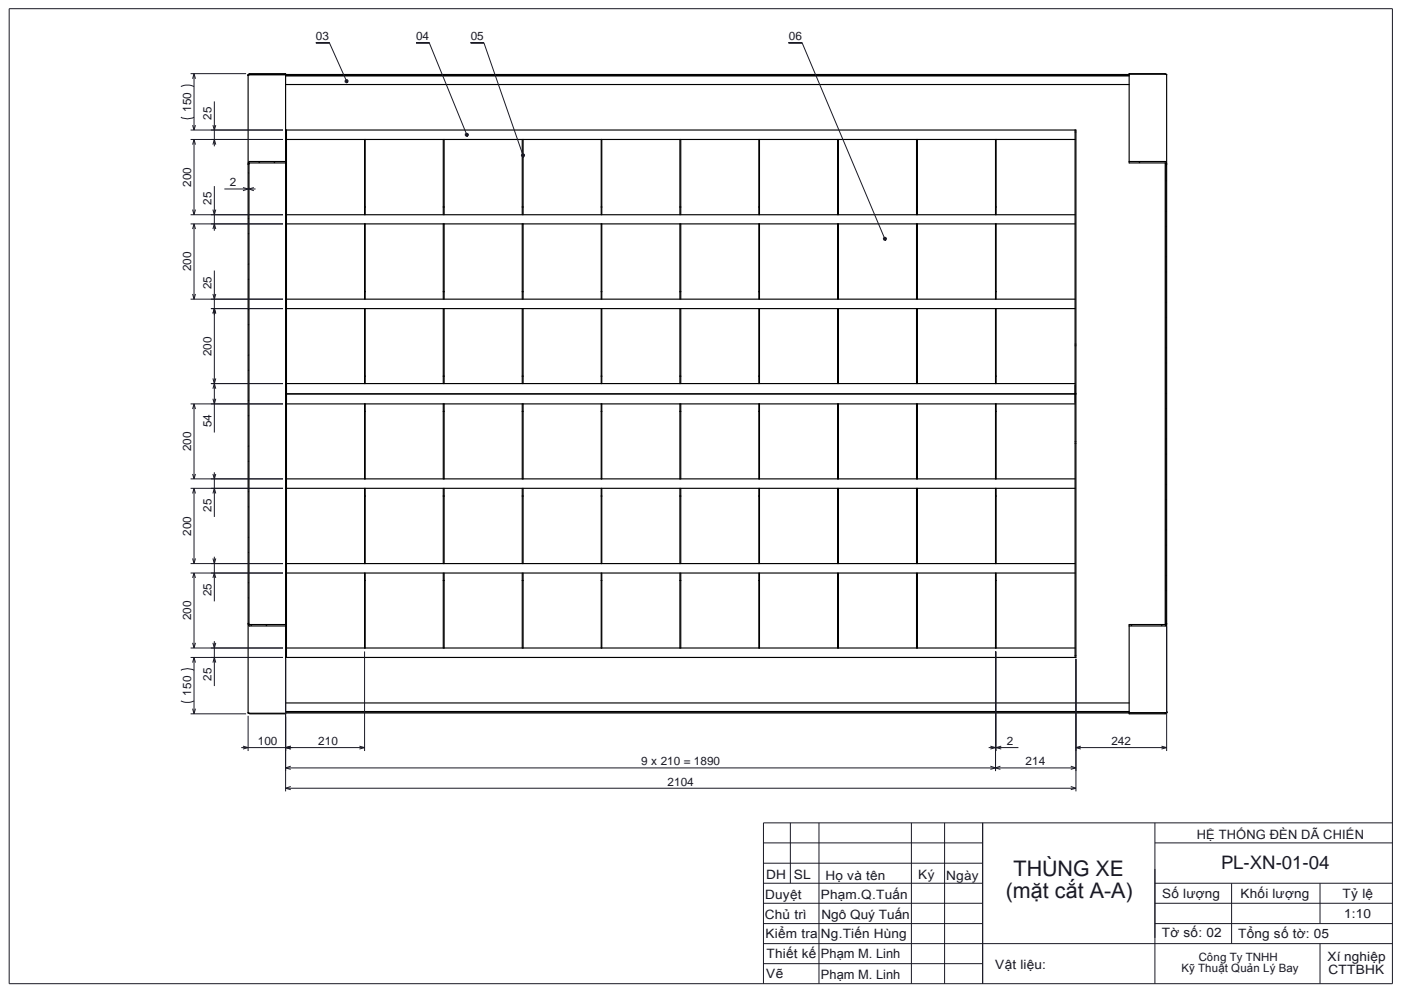
[picture p113: page 10]
(mặt cắt A-A); THÙNG XE

HỆ THỐNG ĐÈN DÃ CHIẾN

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

Ngô Quý Tuấn

Tờ số: 02 | Tổng số tờ: 05

C

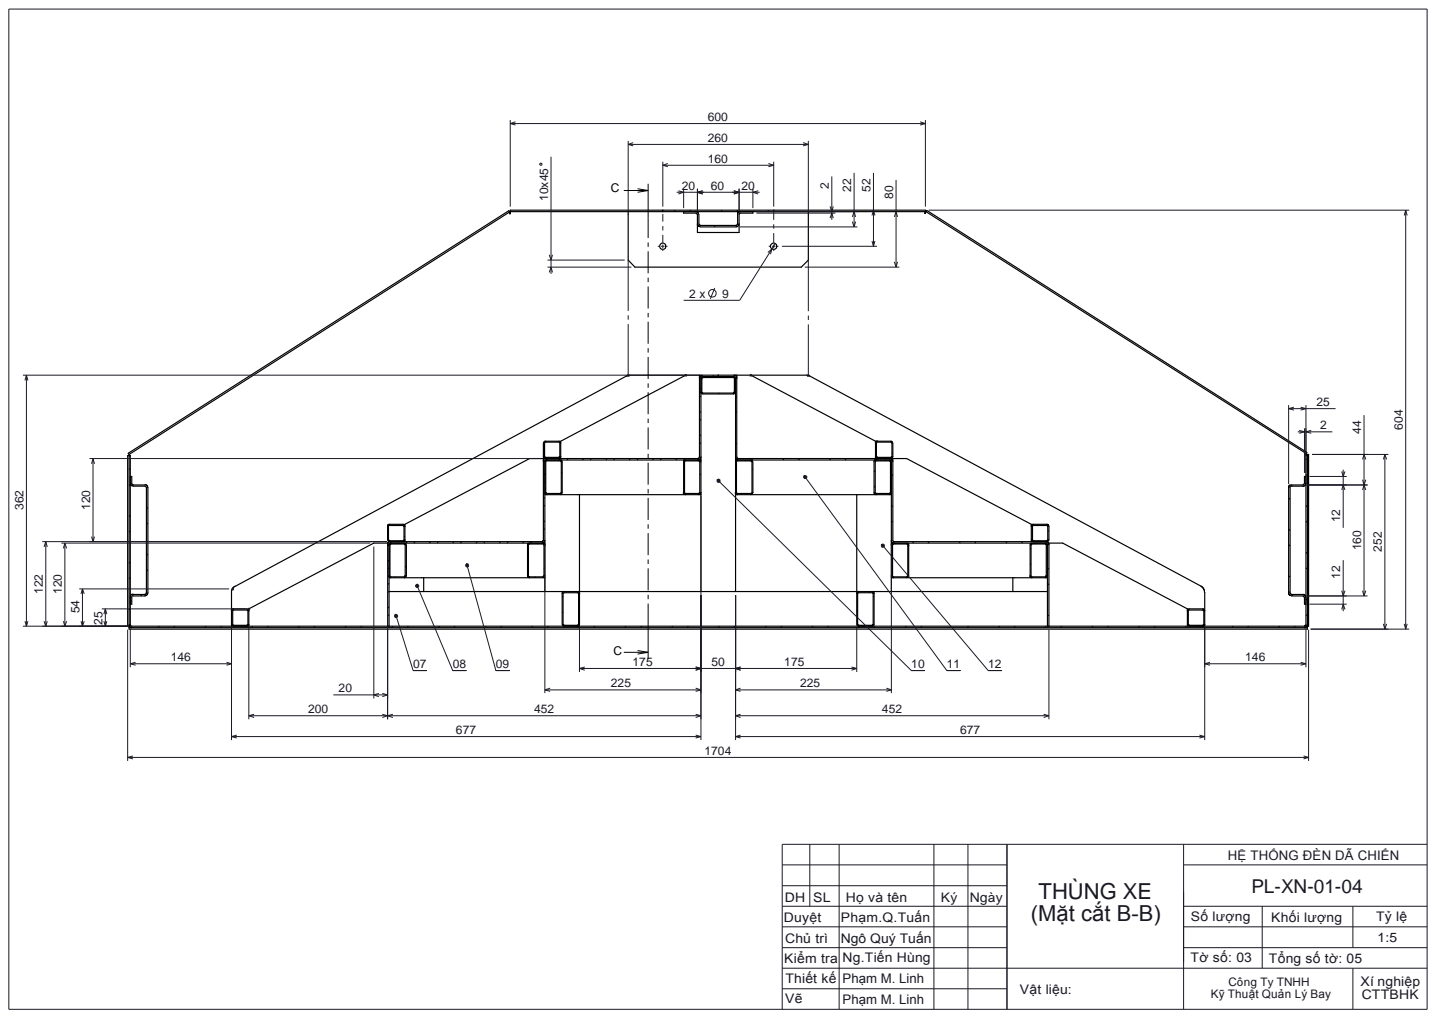
[picture p114: page 11]
452 ¹⁰x45; (Mặt cắt B-B); THÙNG XE

HỆ THỐNG ĐÈN DÃ CHIẾN

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

Ngô Quý Tuấn

Tờ số: 03 | Tổng số tờ: 05

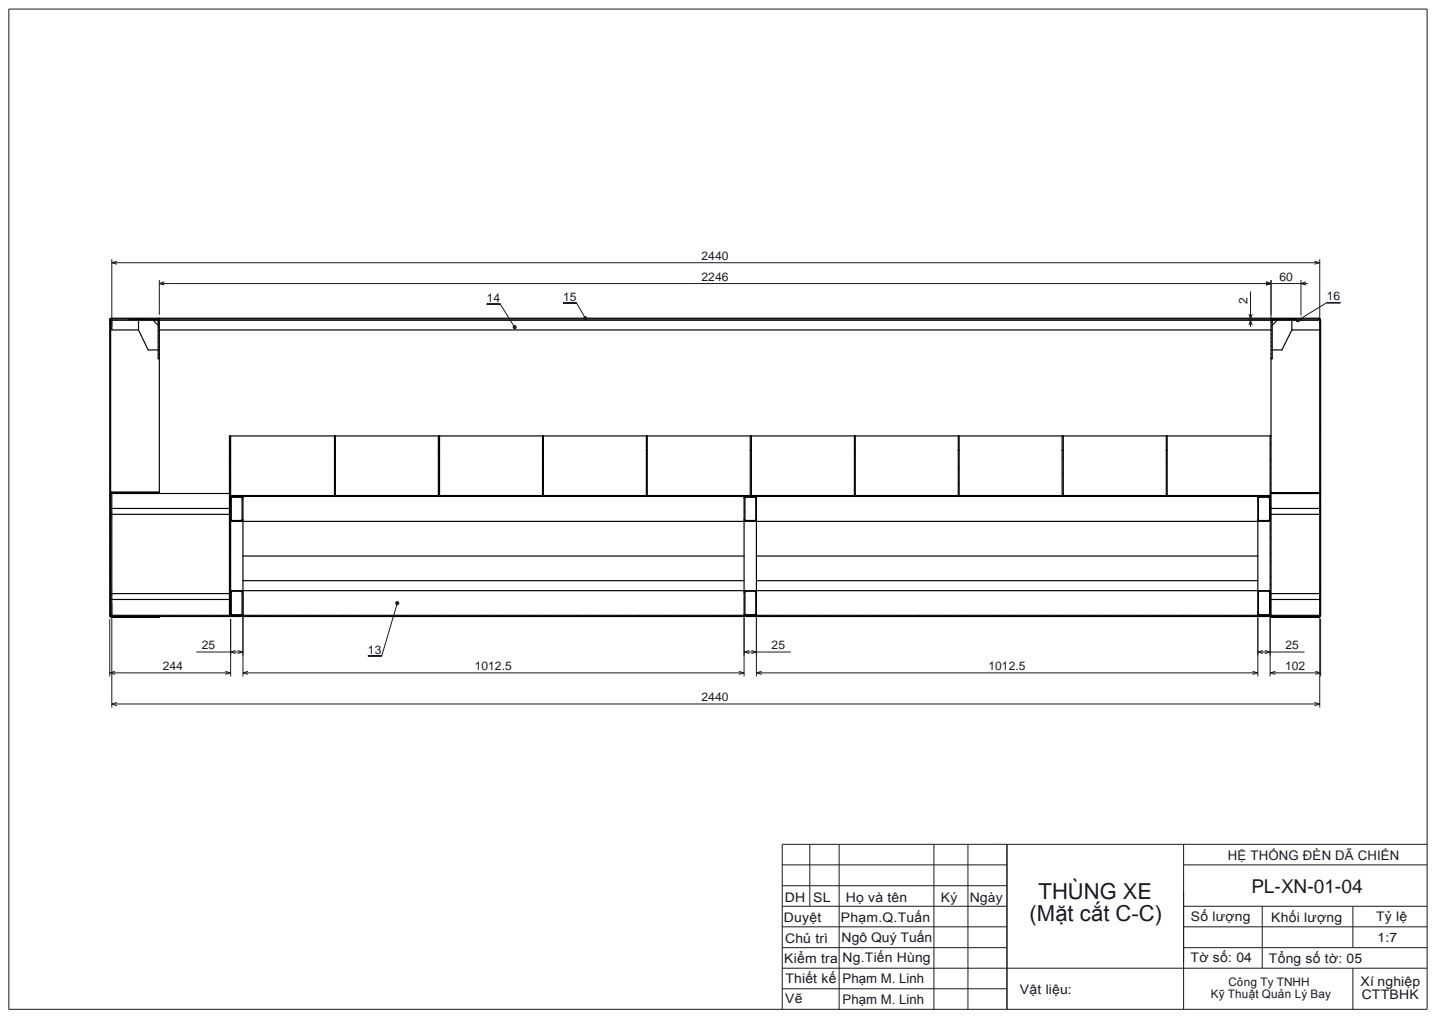
[picture p115: page 12]
(Mặt cắt C-C); THÙNG XE

HỆ THỐNG ĐÈN DÃ CHIẾN

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

Ngô Quý Tuấn

Tờ số: 04 | Tổng số tờ: 05

16 | PL-XN-01-04-16 | Thanh gá 2 | Cái | 2 | SS400 | Kt: 260x140, s=2 | TK chế tạo | Sơn tĩnh điện mã màu RAL1021
15 | PL-XN-01-04-15 | Bịt nóc | Cái | 1 | SS400 | Kt: 2246x160, s=2 | TK chế tạo | Sơn tĩnh điện mã màu RAL1021
14 | PL-XN-01-04-14 | Gân nóc | Cái | 1 | SS400 | Kt: 2440x144, s=2 | TK chế tạo | Sơn tĩnh điện mã màu RAL1021
13 | PL-XN-01-04-13 | Thanh ngang 5 | Cái | 33 | SS400 | Hộp mã kẽm 50x25x1.4 dài 1013 | TK chế tạo | Sơn tĩnh điện mã màu RAL1021
12 | PL-XN-01-04-12 | Thanh đứng 3 | Cái | 6 | SS400 | Hộp mã kẽm 50x25x1.4 dài 140 | TK chế tạo | Sơn tĩnh điện mã màu RAL1021
11 | PL-XN-01-04-11 | Thanh ngang 4 | Cái | 6 | SS400 | Hộp mã kẽm 50x25x1.4 dài 225 | TK chế tạo | Sơn tĩnh điện mã màu RAL1021
10 | PL-XN-01-04-10 | Thanh đứng 2 | Cái | 3 | SS400 | Hộp mã kẽm 50x25x1.4 dài 310 | TK chế tạo | Sơn tĩnh điện mã màu RAL1021
9 | PL-XN-01-04-09 | Thanh ngang 3 | Cái | 6 | SS400 | Hộp mã kẽm 50x25x1.4 dài 225 | TK chế tạo | Sơn tĩnh điện mã màu RAL1021
8 | PL-XN-01-04-08 | Thanh đứng 1 | Cái | 6 | SS400 | Hộp mã kẽm 50x25x1.4 dài 20 | TK chế tạo | Sơn tĩnh điện mã màu RAL1021
7 | PL-XN-01-04-07 | Thanh ngang 2 | Cái | 3 | SS400 | Hộp mã kẽm 50x25x1.4 dài 950 | TK chế tạo | Sơn tĩnh điện mã màu RAL1021
6 | PL-XN-01-04-06 | Tấm đỡ đèn | Cái | 2 | SS400 | Kt: 2100x839, s=2 | TK chế tạo | Sơn tĩnh điện mã màu RAL1021 | DH | SL | Họ và tên | Ký | Ngày
5 | PL-XN-01-04-05 | Ngăn | Cái | 54 | SS400 | Kt: 200x120, s=2 | TK chế tạo | Sơn tĩnh điện mã màu RAL1021 | Duyệt | Phạm.Q.Tuấn | | | | Số lượng | Khối lượng | Tỷ lệ
4 | PL-XN-01-04-04 | Thanh ngang 1 | Cái | 6 | SS400 | Hộp mã kẽm 50x25x1.4 dài 2100 | TK chế tạo | Sơn tĩnh điện mã màu RAL1021
3 | PL-XN-01-04-03 | Thanh gá 1 | Cái | 2 | SS400 | Kt: 2440x234, s=2 | TK chế tạo | Sơn tĩnh điện mã màu RAL1021
2 | PL-XN-01-04-02 | Tấm hồi | Cái | 2 | SS400 | Kt: 1904x804, s=2 | TK chế tạo | Sơn tĩnh điện mã màu RAL1021
1 | PL-XN-01-04-01 | Tấm đáy | Cái | 1 | SS400 | Kt: 2440x2208, s=2 | TK chế tạo | Sơn tĩnh điện mã màu RAL1021
Stt | Mã hiệu | Tên gọi | Đ.Vị | Số lượng | Vật liệu | Kích thước | PA đáp ứng | Ghi chú

# (Bảng kê)

# PL-XN-01-04

# THÙNG XE

Tờ số: 05 | Tổng số tờ: 05

## HỆ THỐNG ĐÈN DÃ CHIẾN

# Ngô Quý Tuấn

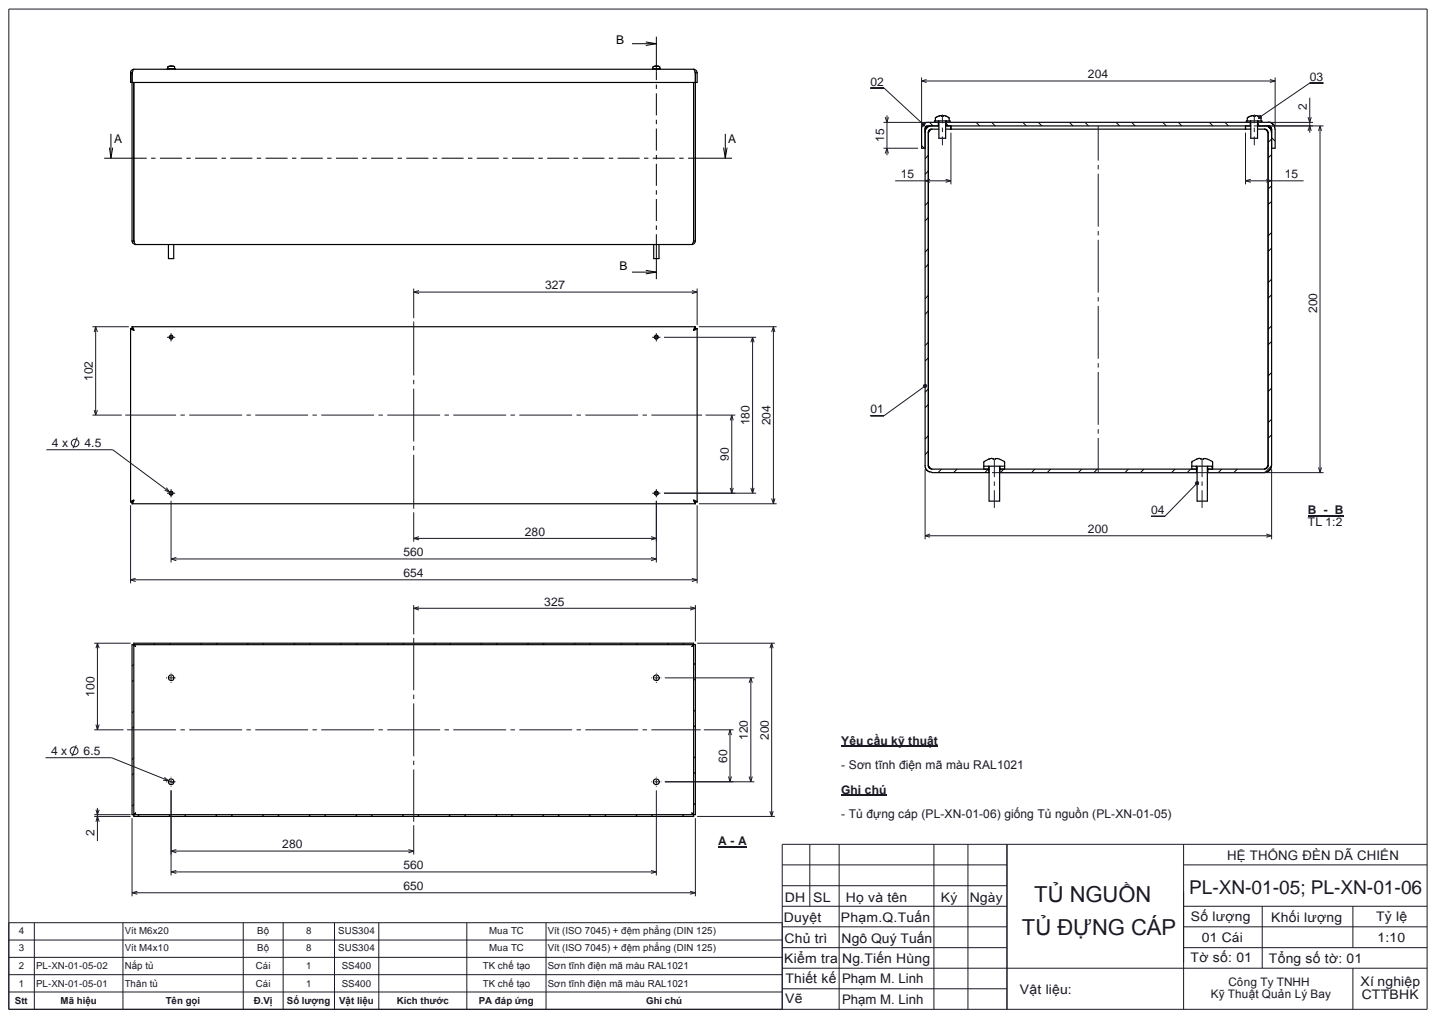
[picture p116: page 14]
Ghi chú; TỦ NGUỒN

Yêu cầu kỹ thuật

- Sơn tĩnh điện mã màu RAL1021

- Tủ đựng cáp (PL-XN-01-06) giống Tủ nguồn (PL-XN-01-05)

HỆ THỐNG ĐÈN DÃ CHIẾN

TỦ ĐỰNG CÁP

DH | SL | Họ và tên | Ký | Ngày
Duyệt | Phạm.Q.Tuấn | | | | Số lượng | Khối lượng | Tỷ lệ
Chủ trì | Ngô Quý Tuấn | | | | 01 Cái

4 | | Vít M6x20 | Bộ | 8 | SUS304 | | Mua TC | Vít (ISO 7045) + đệm phẳng (DIN 125)
3 | | Vít M4x10 | Bộ | 8 | SUS304 | | Mua TC | Vít (ISO 7045) + đệm phẳng (DIN 125)
2 | PL-XN-01-05-02 | Nắp tủ | Cái | 1 | SS400 | | TK chế tạo | Sơn tĩnh điện mã màu RAL1021

Phạm M. Linh | Xí nghiệp

1 | PL-XN-01-05-01 | Thân tủ | Cái | 1 | SS400 | | TK chế tạo | Sơn tĩnh điện mã màu RAL1021
Stt | Mã hiệu | Tên gọi | Đ.Vị | Số lượng | Vật liệu | Kích thước | PA đáp ứng | Ghi chú

A A 25

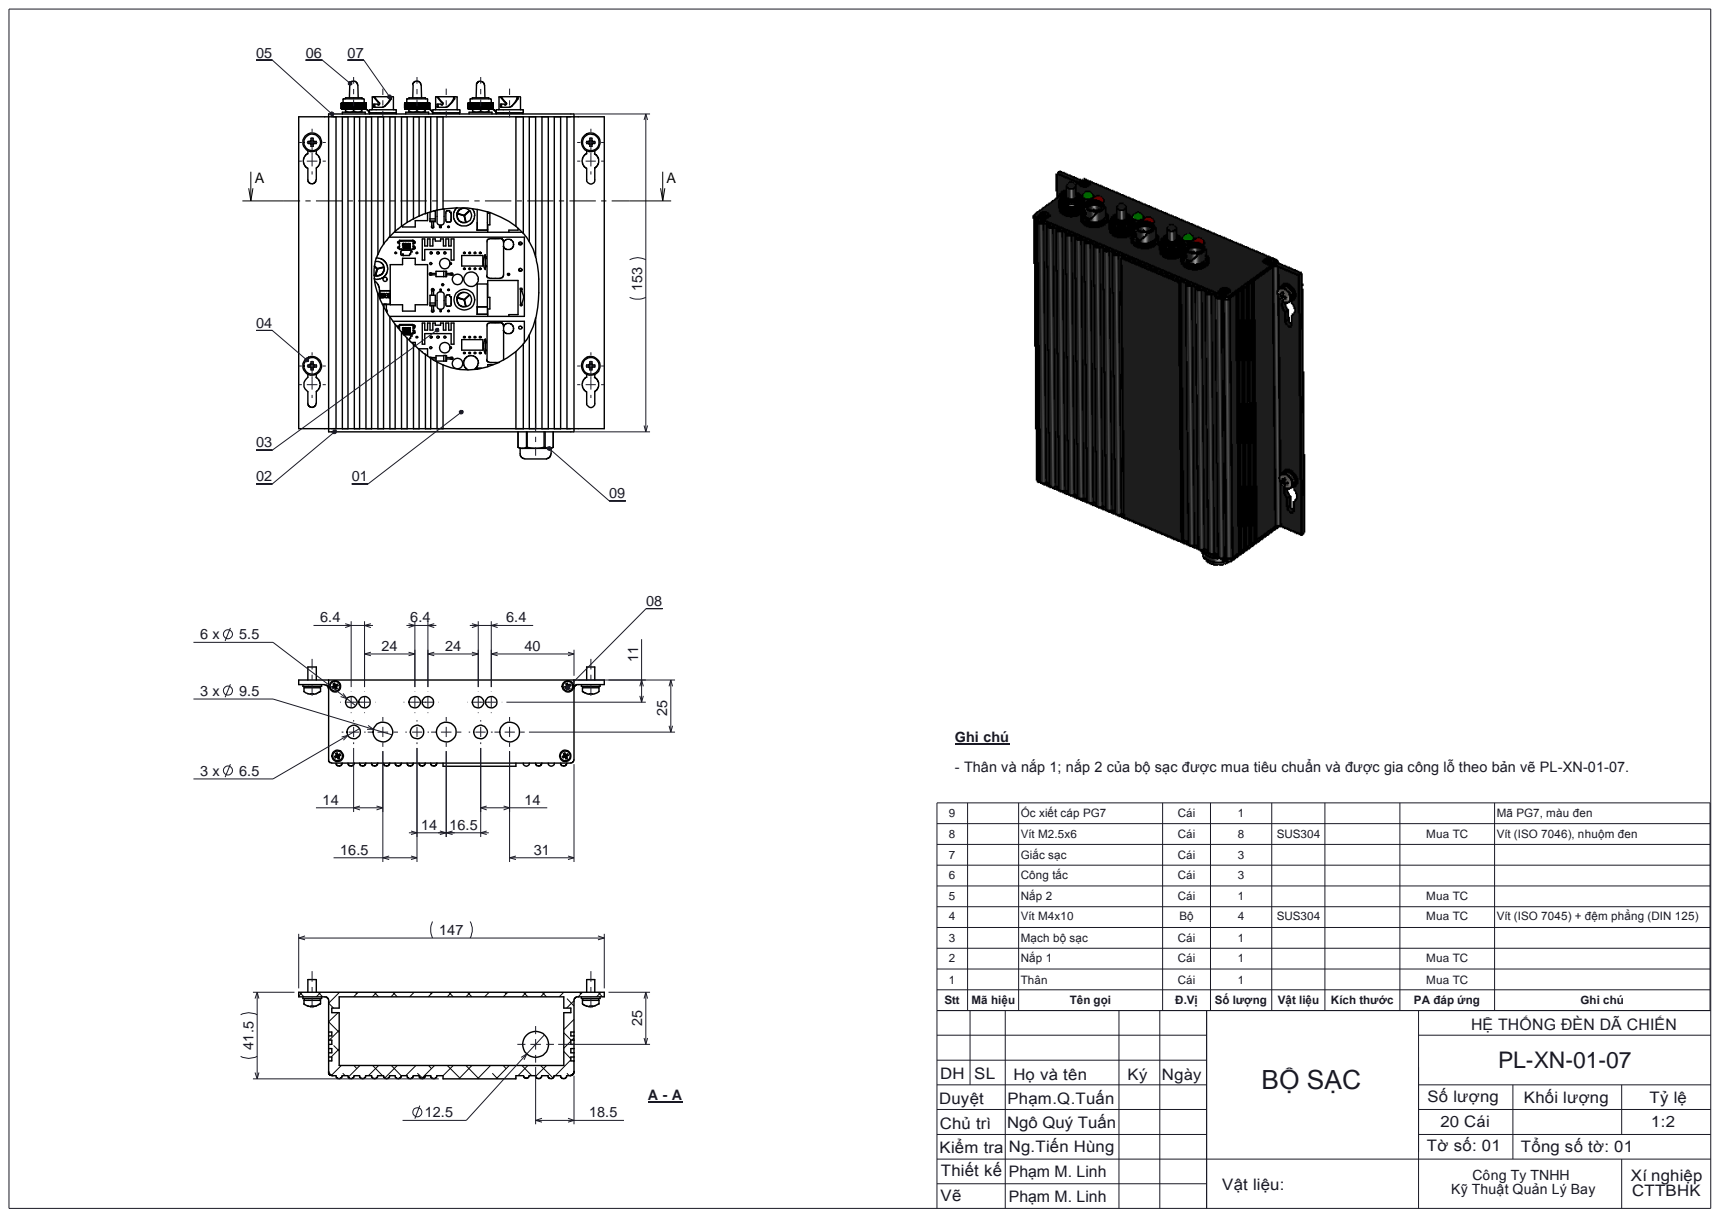
[picture p117: page 15]
BỘ SẠC; Ghi chú; Ốc xiết cáp PG7; Cái; Mã PG7, màu đen; Vít M2.5x6; SUS304; Mua TC; Vít (ISO 7046), nhuộm đen; Giắc sạc; Công tắc; Nắp 2; Vít M4x10; Vít (ISO 7045) + đệm phẳng (DIN 125); Mạch bộ sạc; Nắp 1; Thân; Stt Mã hiệu; Tên gọi; Số lượng Vật liệu Kích thước; PA đáp ứng; Ngô Quý Tuấn

- Thân và nắp 1; nắp 2 của bộ sạc được mua tiêu chuẩn và được gia công lỗ theo bản vẽ PL-XN-01-07.

HỆ THỐNG ĐÈN DÃ CHIẾN

DH | SL | Họ và tên | Ký | Ngày
Duyệt | Phạm.Q.Tuấn | | | | Số lượng | Khối lượng | Tỷ lệ
Chủ trì | | | | | 20 Cái
