ngoquytuan/DenDaChien/2019/20May19/BanVeDenDaChien2019 27.03.2019/Co khi/Tem den da chien/DA CHIEN GH CHC.pdf

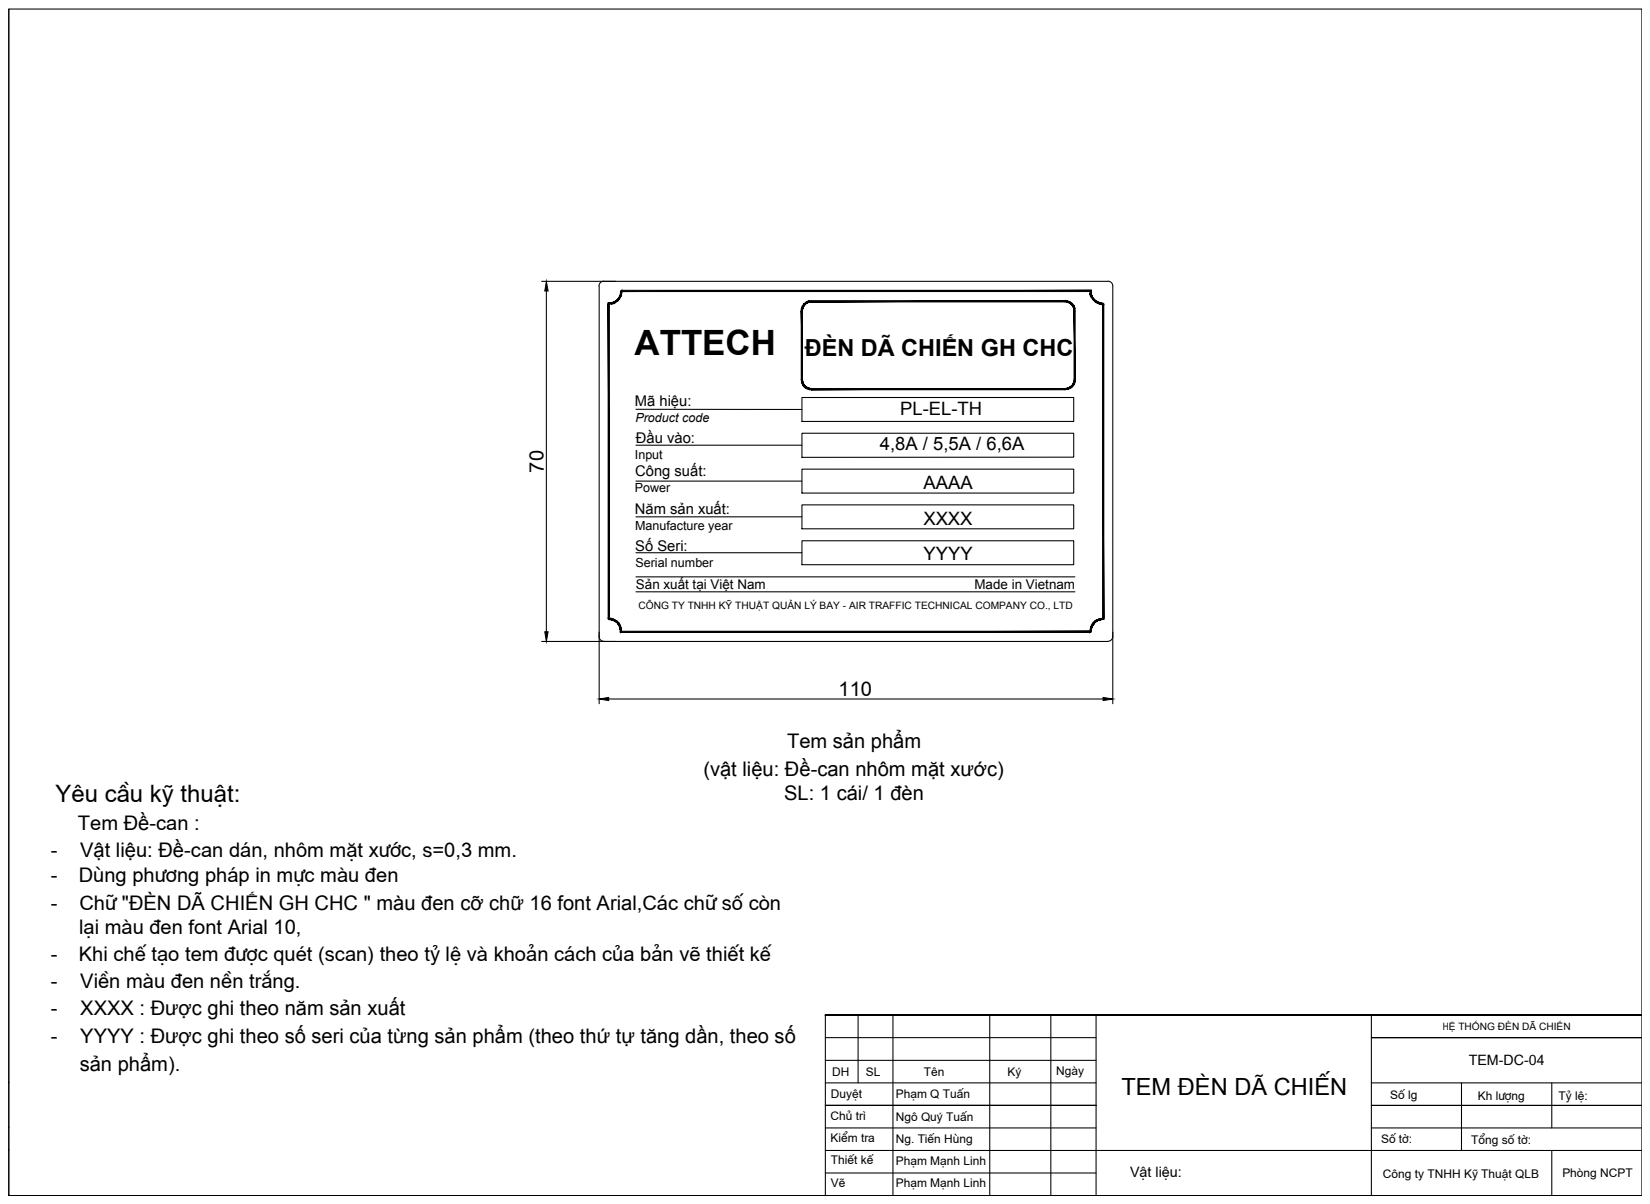
[picture p118: page 1]
Kh lîng; VËt liÖu:; (vật liệu: Đề-can nhôm mặt xước) SL: 1 cái/ 1 đèn Mã hiệu: Product code; PL-EL-TH Công suất: Power; AAAA Đầu vào: Input; 4,8A / 5,5A / 6,6A Năm sản xuất: Manufacture year; XXXX Số Seri: Serial number; YYYY CÔNG TY TNHH KỸ THUẬT QUẢN LÝ BAY - AIR TRAFFIC TECHNICAL COMPANY CO., LTD Sản xuất tại Việt Nam; Made in Vietnam; ThiÕt kÕ; Ph¹m M¹nh Linh -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

70 110 Tem sản phẩm

tem §ÌN D· CHIÕN

Tæng sè tê:

C«ng ty TNHH Kü ThuËt QLB
