ngoquytuan/DenDaChien/2019/20May19/BanVeDenDaChien2019 27.03.2019/Co khi/Tem den da chien/DA CHIEN REMOTE.pdf

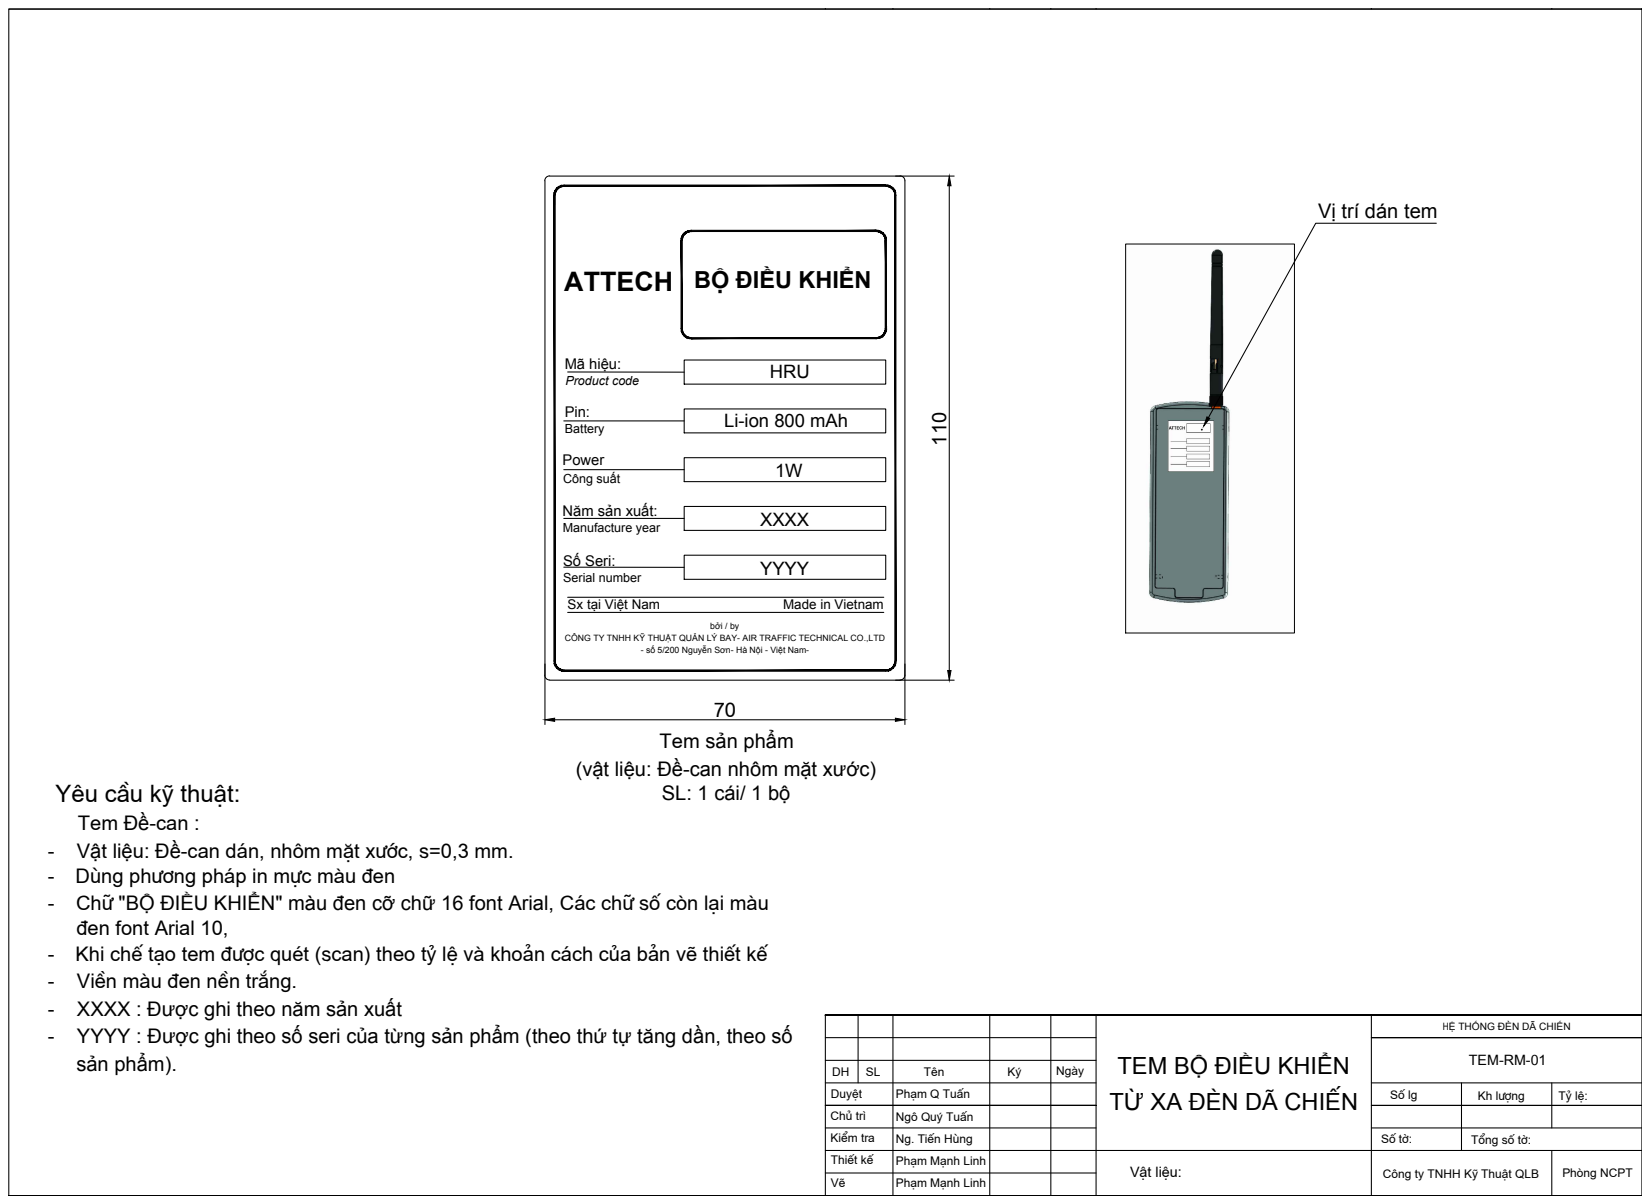
[picture p119: page 1]
Kh lîng; VËt liÖu:; Tû lÖ: tem-rm-01; Phßng NCPT HỆ THỐNG ĐÈN DÃ CHIẾN VÏKiÓm tra DuyÖt Chñ tr×; Ph¹m Q TuÊn Ph¹m M¹nh Linh Ng. TiÕn Hïng Ng« Quý TuÊn; Yªu cÇu kü thuËt: Tem Đề-can :; Tem sản phẩm (vật liệu: Đề-can nhôm mặt xước) SL: 1 cái/ 1 bộ; ThiÕt kÕ; Ph¹m M¹nh Linh; Vị trí dán tem Mã hiệu: Product code; bởi / by CÔNG TY TNHH KỸ THUẬT QUẢN LÝ BAY- AIR TRAFFIC TECHNICAL CO.,LTD - số 5/200 Nguyễn Sơn- Hà Nội - Việt Nam- Sx tại Việt Nam; Made in Vietnam ATTECH; HRU Power Công suất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

Năm sản xuất:

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

Tæng sè tê: tem bỘ ĐIỀU KHIỂN TỪ XA §ÌN D· CHIÕN

C«ng ty TNHH Kü ThuËt QLB
