ngoquytuan/DenDaChien/2019/20May19/BanVeDenDaChien2019 27.03.2019/Co khi/Cac hop dieu khien/Hop DK DDC/Mach KN HTDH/PL-RU-05-00.pdf

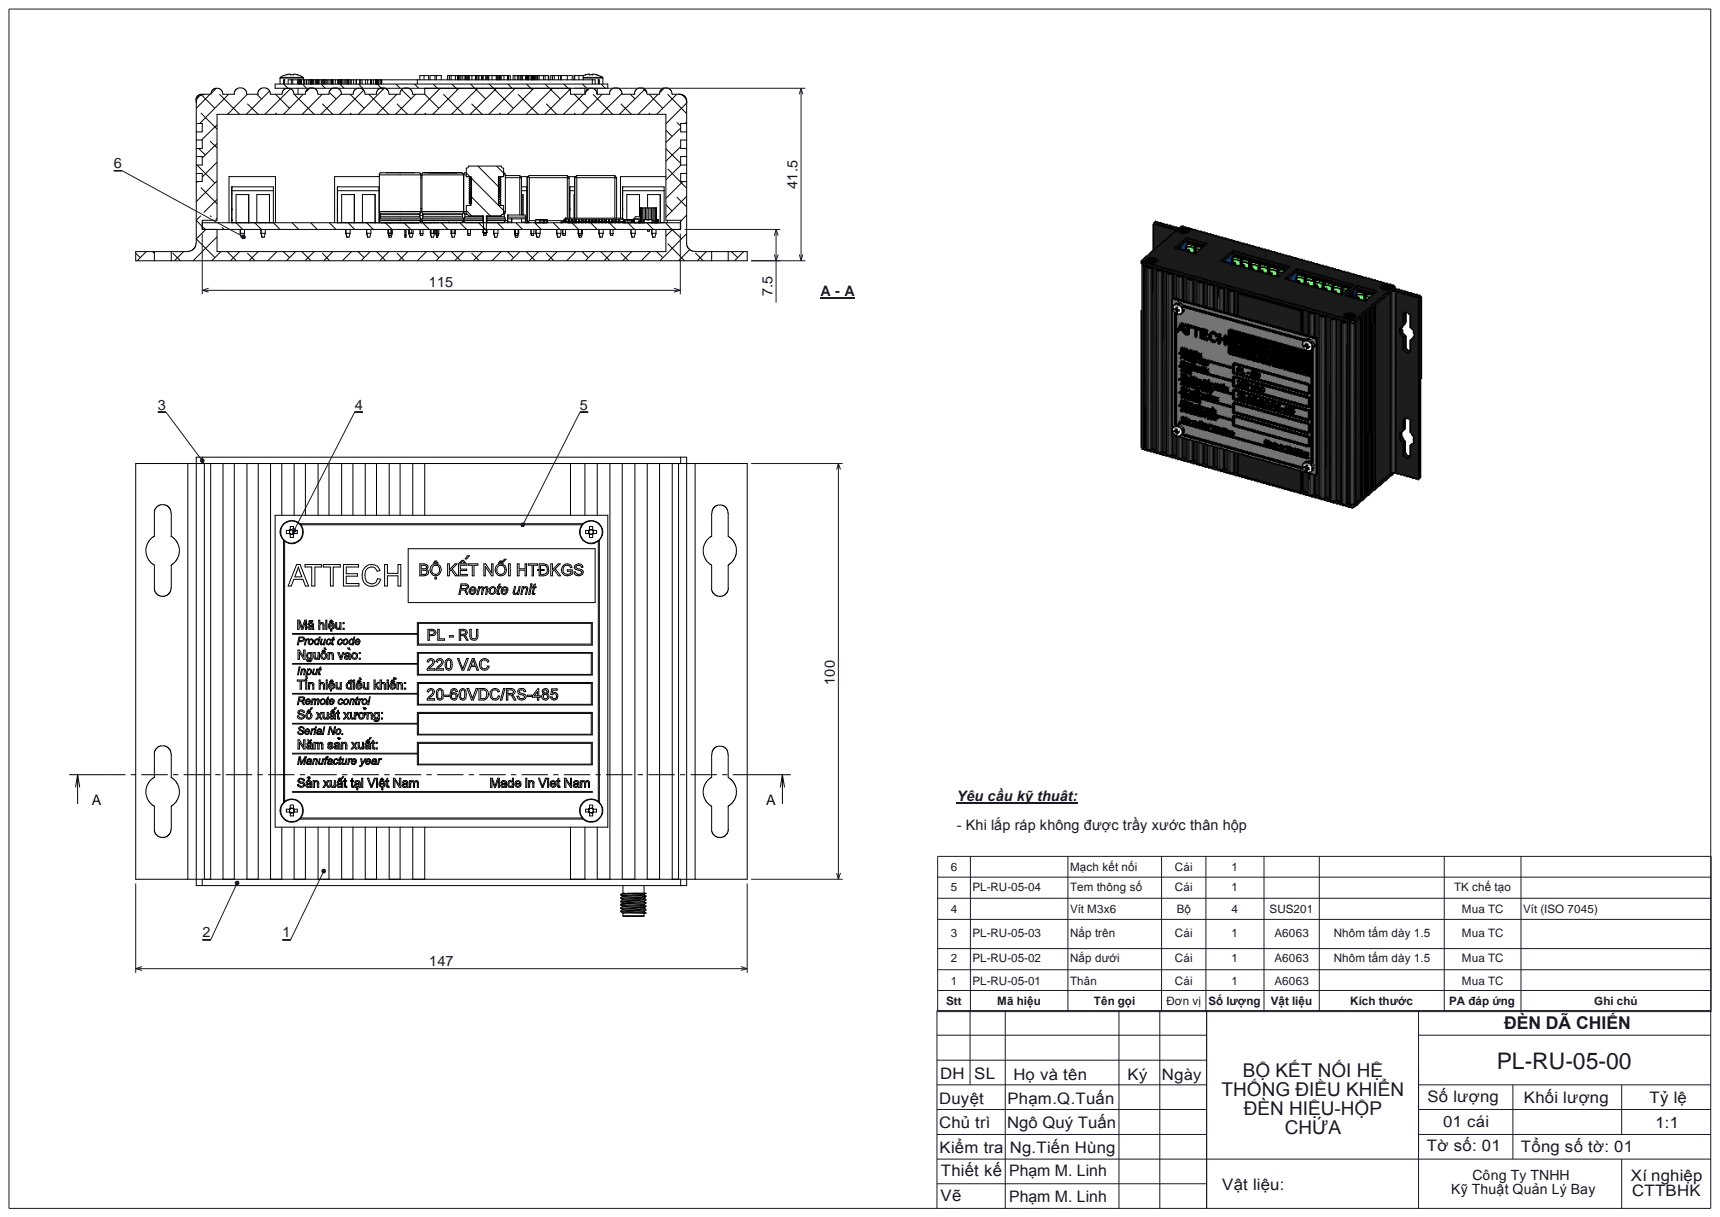
[picture p120: page 1]
Mạch kết nối; Cái; Tem thông số; TK chế tạo; Vít M3x6; SUS201; Mua TC; Vít (ISO 7045); Nắp trên; Nhôm tấm dày 1.5; Nắp dưới; Thân; Stt; Mã hiệu; Tên gọi; Đơn vị Số lượng Vật liệu; Kích thước; PA đáp ứng; Ghi chú

Yêu cầu kỹ thuật:

- Khi lắp ráp không được trầy xước thân hộp

ĐÈN DÃ CHIẾN

BỘ KẾT NỐI HỆ
THỐNG ĐIỀU KHIỂN
ĐÈN HIỆU-HỘP
CHỨA

DH | SL | Họ và tên | Ký | Ngày
Duyệt | Phạm.Q.Tuấn | | | | Số lượng | Khối lượng | Tỷ lệ
Chủ trì | Ngô Quý Tuấn | | | | 01 cái | | 1:1
Kiểm tra | Ng.Tiến Hùng | | | | Tờ số: 01 | Tổng số tờ: 01
Thiết kế | Phạm M. Linh | | | Vật liệu: | Công Ty TNHH Kỹ Thuật Quản Lý Bay | | Xí nghiệp CTTBHK
Vẽ | Phạm M. Linh
