ngoquytuan/DenDaChien/2019/20May19/BanVeDenDaChien2019 27.03.2019/Co khi/Cac hop dieu khien/Hop DK DDC/Mach KN HTDH/PL-RU-05-02; 03.pdf

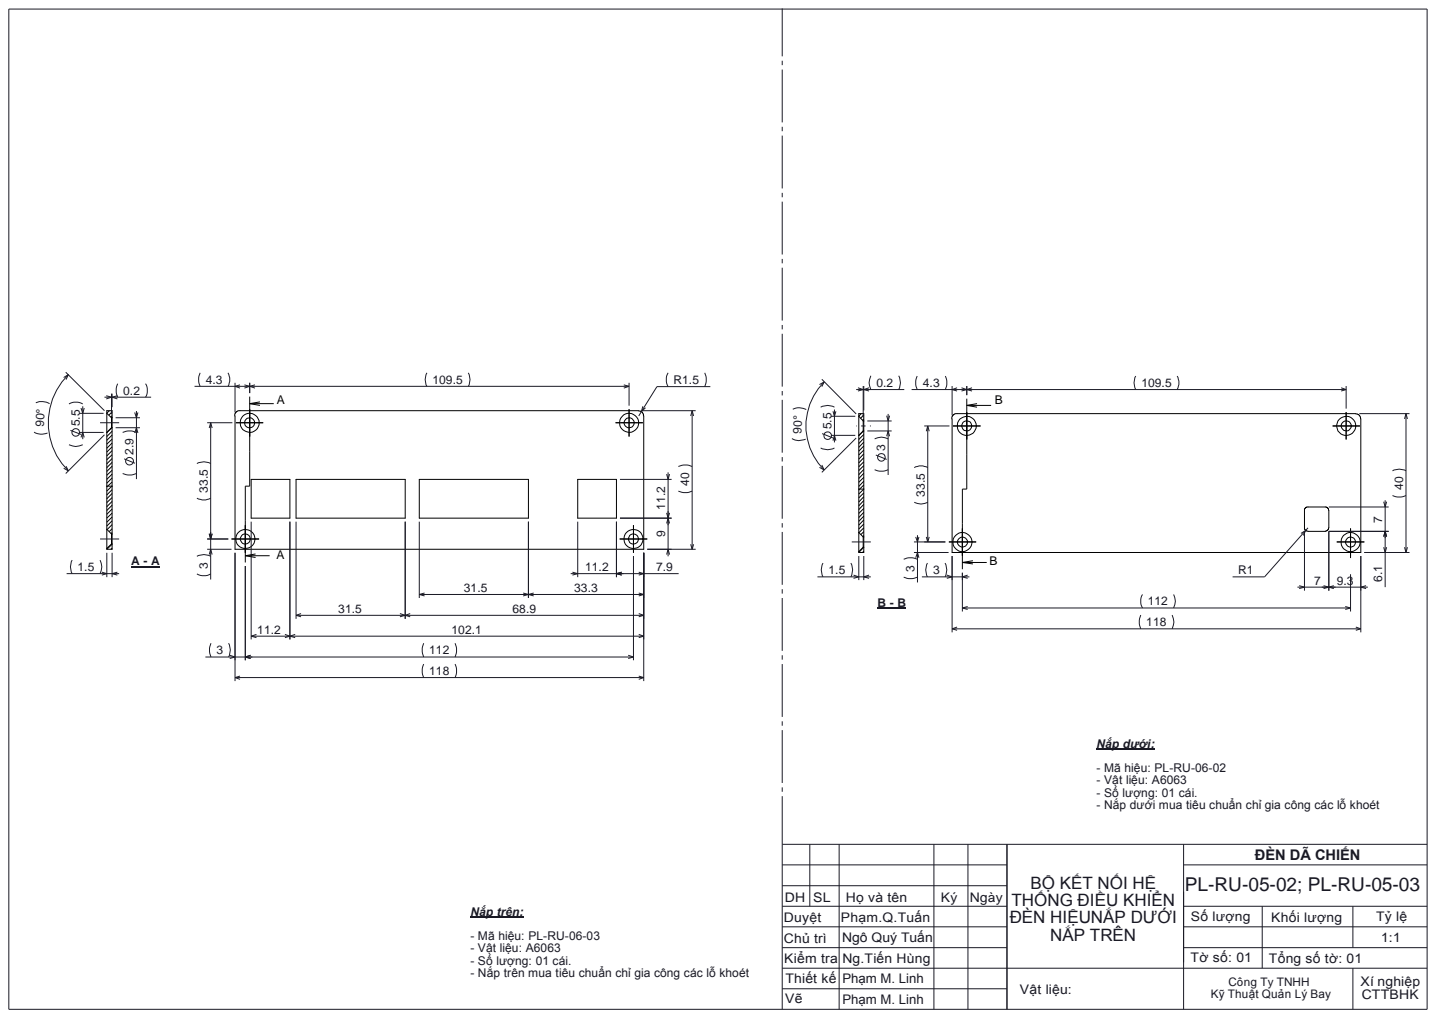
[picture p121: page 1]
Nắp trên:; Nắp dưới:

- Mã hiệu: PL-RU-06-02
- Vật liệu: A6063
- Số lượng: 01 cái.
- Nắp dưới mua tiêu chuẩn chỉ gia công các lỗ khoét

ĐÈN DÃ CHIẾN

BỘ KẾT NỐI HỆ
THỐNG ĐIỀU KHIỂN
ĐÈN HIỆUNẮP DƯỚI
NẮP TRÊN

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

Ngô Quý Tuấn | | | | | | 1:1

Chủ trì - Mã hiệu: PL-RU-06-03
- Nắp trên mua tiêu chuẩn chỉ gia công các lỗ khoét

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
