ngoquytuan/DenDaChien/2019/20May19/BanVeDenDaChien2019 27.03.2019/Co khi/Cac hop dieu khien/Hop DK DDC/mach remote/PL-HRU-05-00.pdf

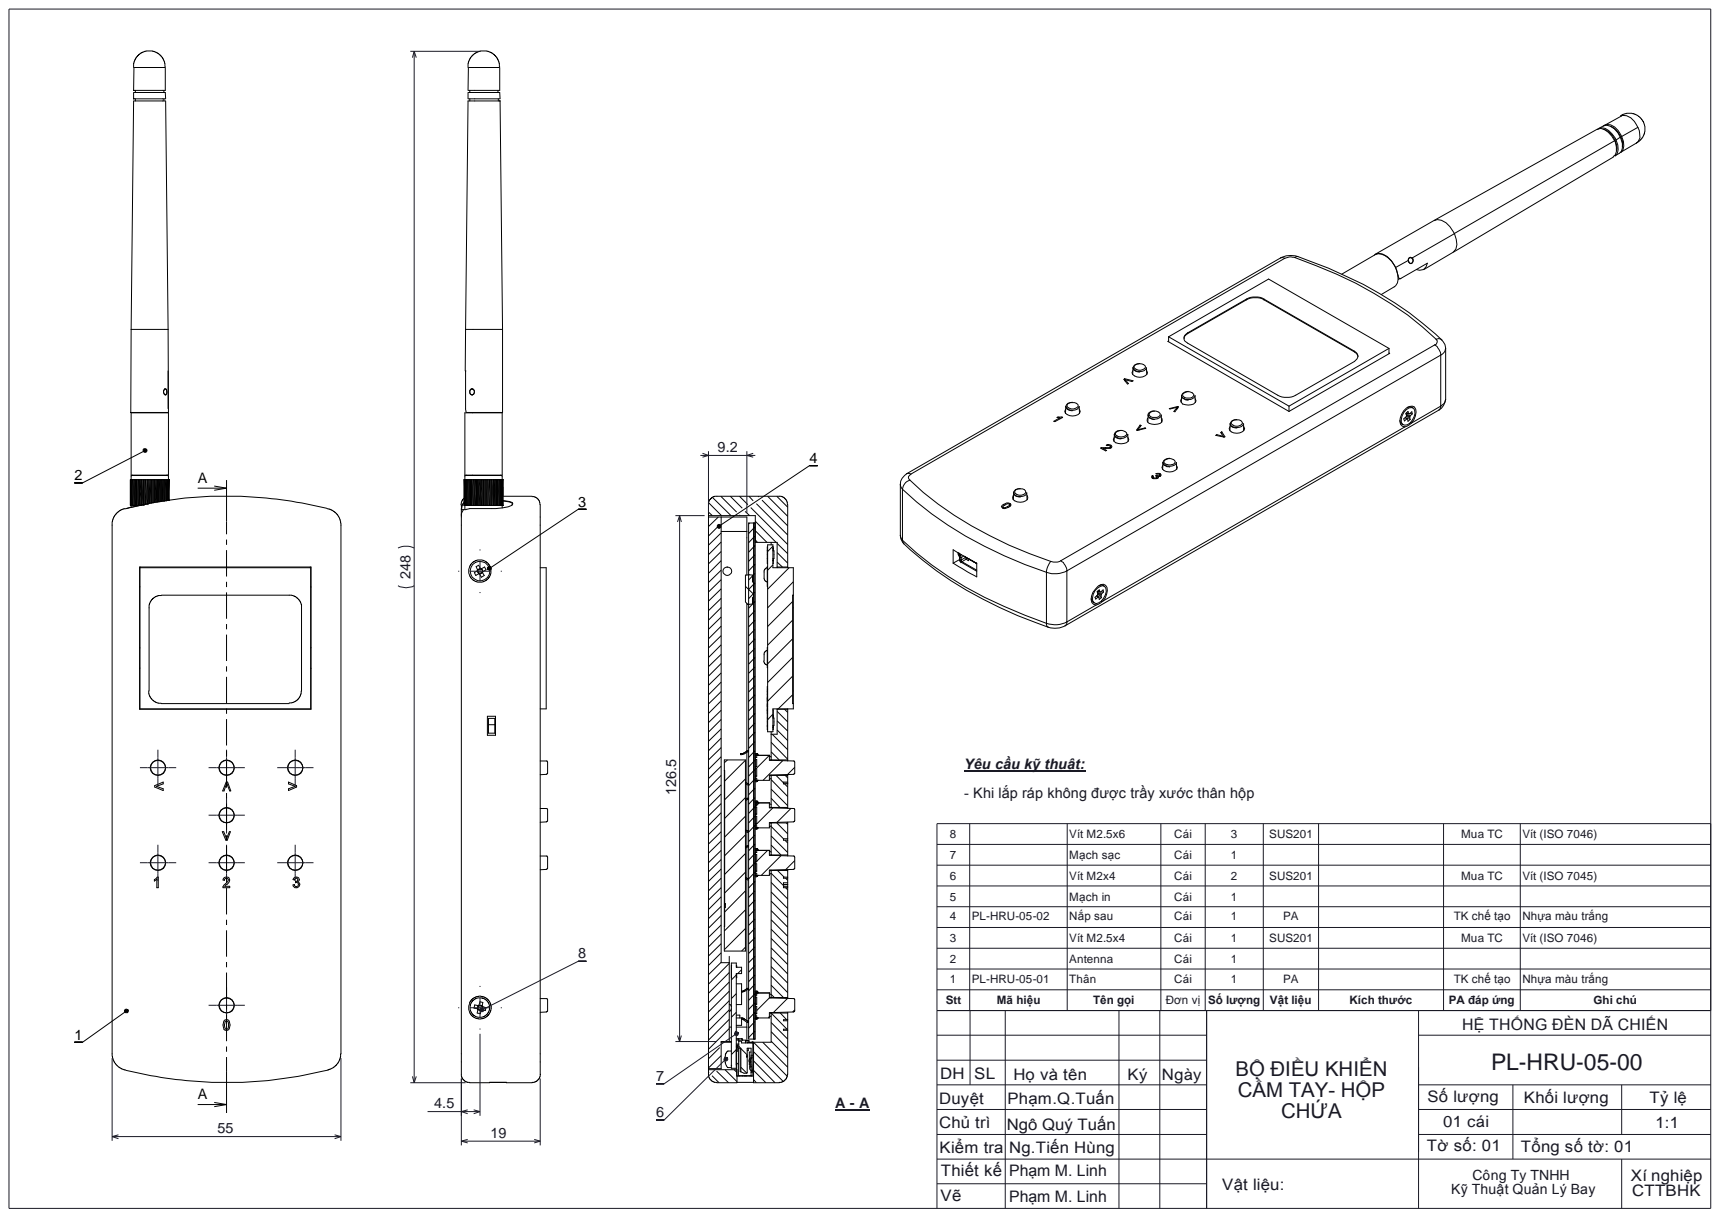
[picture p122: page 1]
PL-HRU-05-00

Yêu cầu kỹ thuật:

- Khi lắp ráp không được trầy xước thân hộp

8 | | Vít M2.5x6 | Cái | 3 | SUS201 | | Mua TC | Vít (ISO 7046)
7 | | Mạch sạc | Cái | 1
6 | | Vít M2x4 | Cái | 2 | SUS201 | | Mua TC | Vít (ISO 7045)
5 | | Mạch in | Cái | 1
4 | PL-HRU-05-02 | Nắp sau | Cái | 1 | PA | | TK chế tạo | Nhựa màu trắng

3 | | Vít M2.5x4 | Cái | 1 | SUS201 | | Mua TC | Vít (ISO 7046)
2 | | Antenna | Cái | 1
1 | PL-HRU-05-01 | Thân | Cái | 1 | PA | | TK chế tạo | Nhựa màu trắng
Stt | Mã hiệu | Tên gọi | Đơn vị | Số lượng | Vật liệu | Kích thước | PA đáp ứng | Ghi chú

BỘ ĐIỀU KHIỂN CẦM TAY- HỘP CHỨA | HỆ THỐNG ĐÈN DÃ CHIẾN

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
