ngoquytuan/DenDaChien/2019/20May19/BanVeDenDaChien2019 27.03.2019/Co khi/Cac hop dieu khien/Hop DK DDC/mach remote/PL-HRU-05-01.pdf

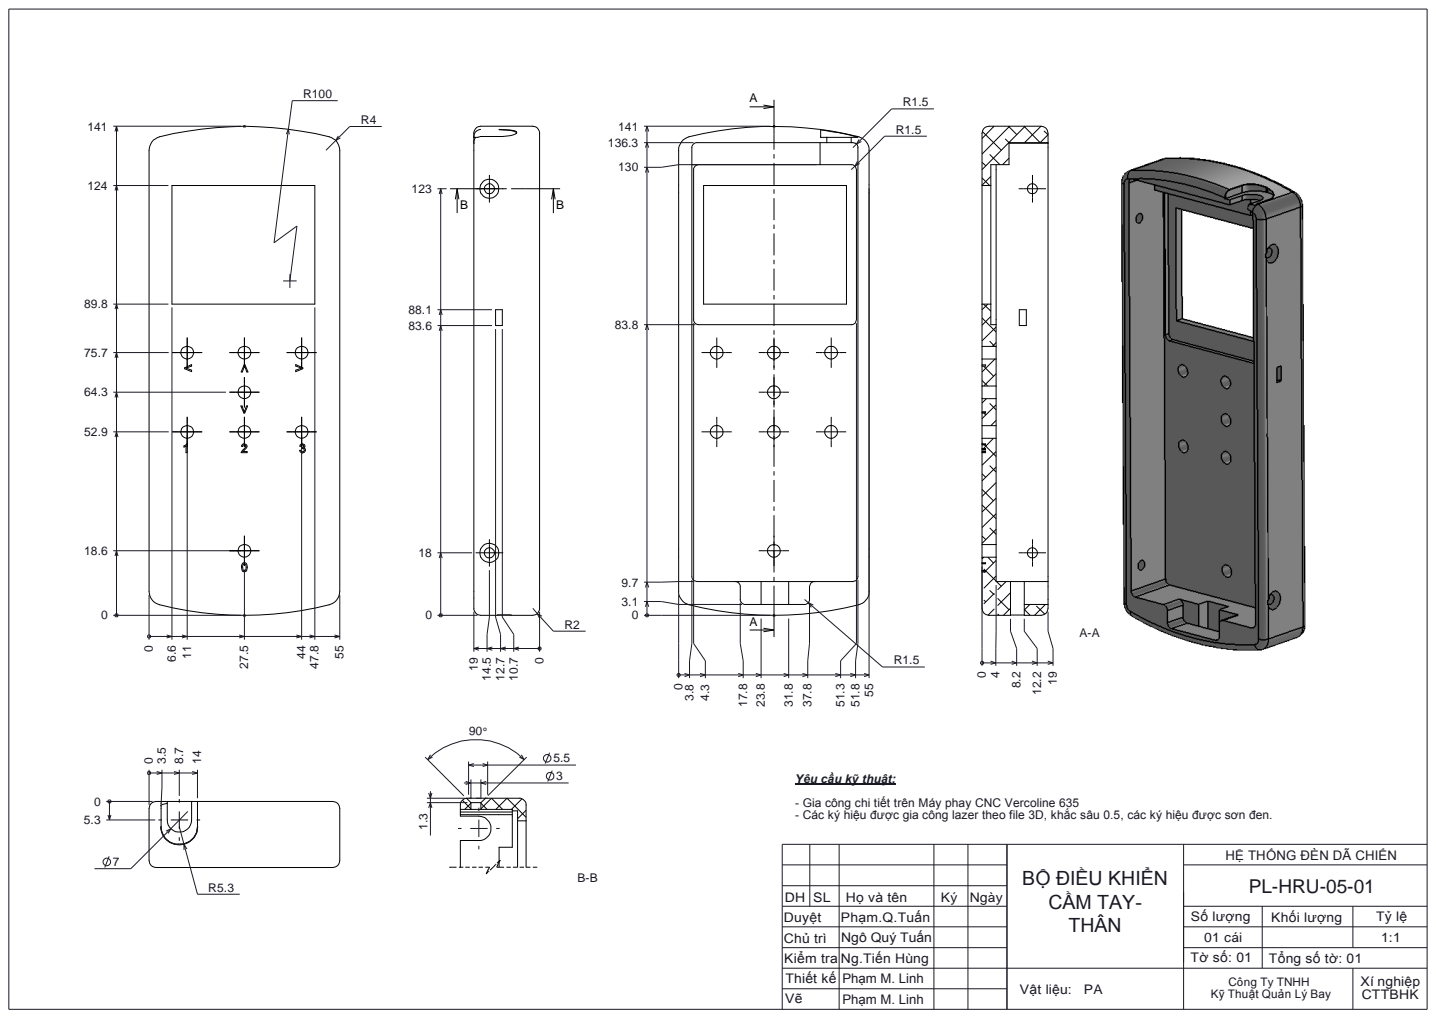
[picture p123: page 1]

Yêu cầu kỹ thuật:

- Gia công chi tiết trên Máy phay CNC Vercoline 635
- Các ký hiệu được gia công lazer theo file 3D, khắc sâu 0.5, các ký hiệu được sơn đen.

HỆ THỐNG ĐÈN DÃ CHIẾN
PL-HRU-05-01

BỘ ĐIỀU KHIỂN
CẦM TAY-
THÂN

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
