ngoquytuan/DenDaChien/2019/20May19/BanVeDenDaChien2019 27.03.2019/Co khi/Cac hop dieu khien/Hop DK DDC/mach remote/PL-HRU-05-02.pdf

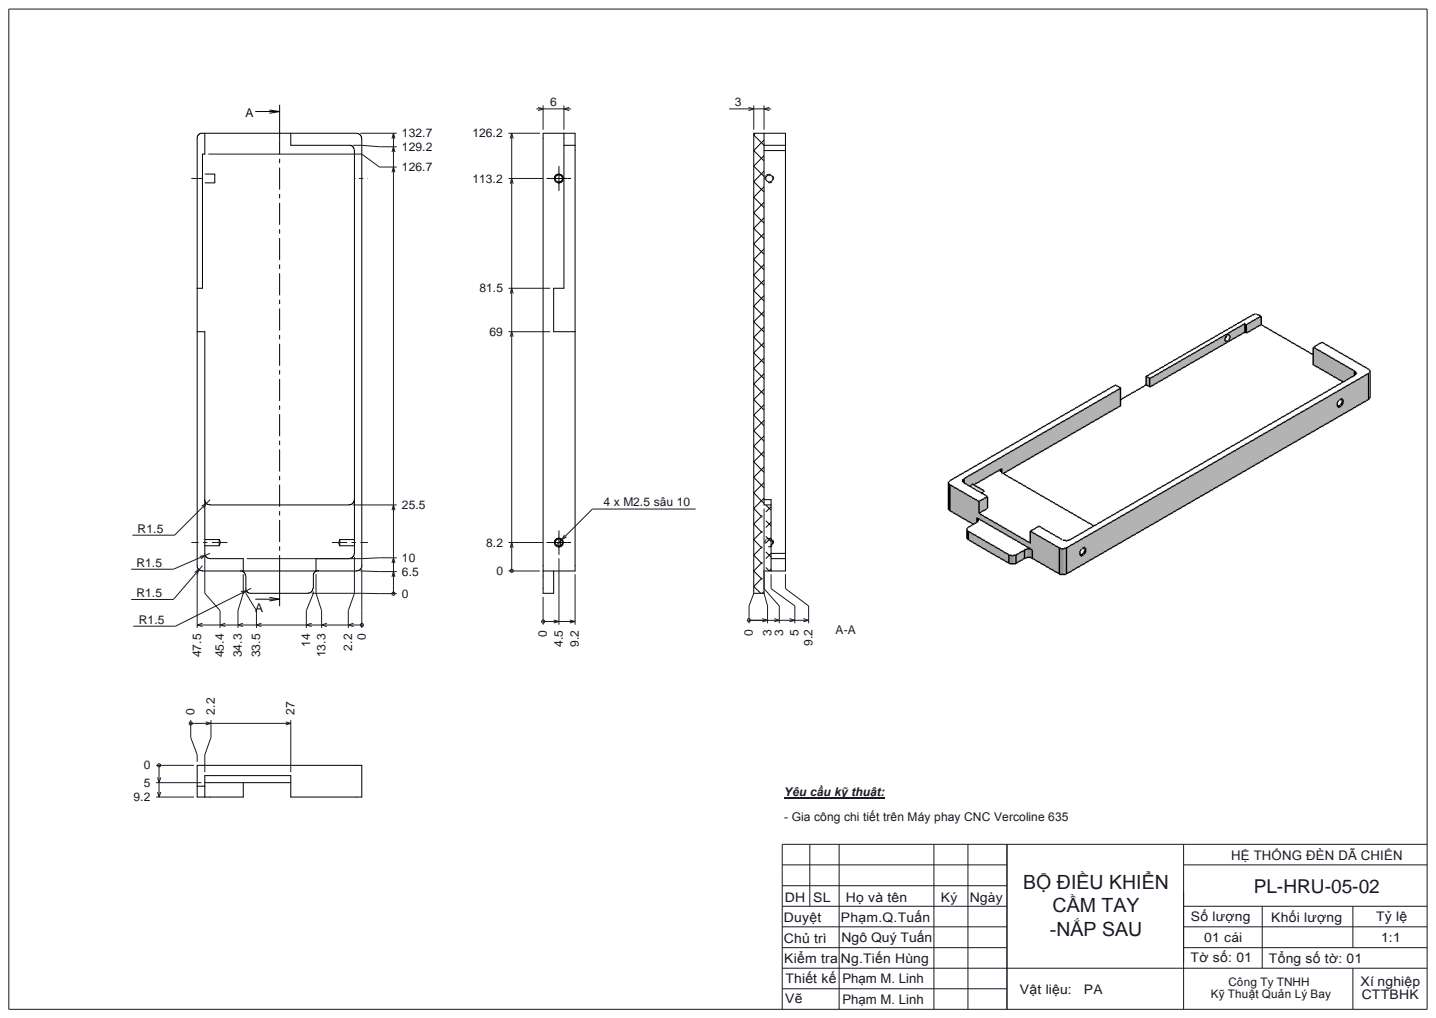
[picture p124: page 1]
4 x M2.5 sâu 10

Yêu cầu kỹ thuật:

- Gia công chi tiết trên Máy phay CNC Vercoline 635

HỆ THỐNG ĐÈN DÃ CHIẾN
PL-HRU-05-02

BỘ ĐIỀU KHIỂN
CẦM TAY
-NẮP SAU

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
