ngoquytuan/DenDaChien/(list of files, drawings)

Other design files:
CGCN PortableLighting/ALCS/ALCS.PcbDoc
CGCN PortableLighting/ALCS/ALCS.PrjPcb
CGCN PortableLighting/ALCS/ALCS.SchDoc
CGCN PortableLighting/LED Group/LED_GROUP.PcbDoc
CGCN PortableLighting/LED Group/LED_GROUP.PcbLib
CGCN PortableLighting/LED Group/LED_GROUP.PrjPcb
CGCN PortableLighting/LED Group/LED_GROUP.SchDoc
CGCN PortableLighting/LED Indicate/LED_Indi.PcbDoc
CGCN PortableLighting/LED Indicate/LED_Indi.PrjPcb
CGCN PortableLighting/LED Indicate/LED_Indi.SchDoc
CGCN PortableLighting/LED mainb/LEDmainb.PrjPcb
CGCN PortableLighting/LED mainb/LEDmainb.SchDoc
CGCN PortableLighting/LED OSRAM/LED OSRAM.PcbDoc
CGCN PortableLighting/LED OSRAM/LED OSRAM.PcbLib
CGCN PortableLighting/LED OSRAM/LED OSRAM.PrjPcb
CGCN PortableLighting/LED OSRAM/LED OSRAM.SchDoc
CGCN PortableLighting/LED remote/LEDremote.PcbDoc
CGCN PortableLighting/LED remote/LEDremote.PrjPcb
CGCN PortableLighting/LED remote/LEDremote.SchDoc
CGCN PortableLighting/Sac_14V/14V2A.PcbDoc
CGCN PortableLighting/Sac_14V/14V2A.PrjPcb
CGCN PortableLighting/Sac_14V/14V2A.SchDoc
CGCN PortableLighting/Sac_14V/Box.pcbdoc
CGCN PortableLighting/Sac_14V/Box.PrjPcb
CGCN PortableLighting/Sac_14V/Box.SchDoc
CGCN PortableLighting/SDK xe nguon/xenguon.PrjPcb
CGCN PortableLighting/SDK xe nguon/xenguon.SchDoc
