ngoquytuan/DenDaChien/Code/ALCS Remote/ALCS Remote/MBSlave.c

/*************************************************************************
Title:    Yet another (small) modbus implementation for the avr.
Author:   Max Brueggemann
Hardware: any AVR with hardware UART, tested on Atmega 88/168 at 20Mhz
License:  GNU General Public License 
          
DESCRIPTION:
    Refer to the header file yaMBSiavr.h.
    
USAGE:
    Refer to the header file yaMBSiavr.h.
                    
LICENSE:
    Copyright (C) 2016 Max Brueggemann

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
*************************************************************************/


#include "MBSlave.h"

volatile unsigned char BusState = 0;
volatile uint16_t modbusTimer = 0;
volatile unsigned char rxbuffer[MaxFrameIndex+1];
volatile uint16_t DataPos = 0;
volatile unsigned char PacketTopIndex = 7;
volatile unsigned char modBusStaMaStates = 0;

//MODBUS
//Input 0: Chon mach + muc sang
//Holding 0: M?c sáng
//
volatile uint8_t instate = 0;
volatile uint8_t outstate = 0;
volatile uint16_t inputRegisters[3]={0x0001, 0x0002, 0x0000};
volatile uint16_t holdingRegisters[10]={0x0001, 0x0002, 0x0003, 0x0004, 0x0005, 0x0006, 0x0007, 0x0008, 0x0009, 0x000A};
	
extern unsigned char TypeOfLamp, BrightnessLevel, Multiwire_MODBUS_Mode, BrightnessLevelOld, TypeOfLampOld;	

uint8_t modbusGetBusState(void) {
	return BusState;
}

#if ADDRESS_MODE == SINGLE_ADR
volatile unsigned char Address = 0x00;
uint8_t modbusGetAddress(void) {
	return Address;
}

void modbusSetAddress(unsigned char newadr) {
	Address = newadr;
}
#endif

#if PHYSICAL_TYPE == 485
 void transceiver_txen(void) {
	TRANSCEIVER_ENABLE_PORT|=(1<<TRANSCEIVER_ENABLE_PIN);
 }

 void transceiver_rxen(void) {
	TRANSCEIVER_ENABLE_PORT&=~(1<<TRANSCEIVER_ENABLE_PIN);
 }
#endif

/* A fairly simple Modbus compliant 16 Bit CRC algorithm.
*  Returns 1 if the crc check is positive, returns 0 if it fails.
*  Appends
*/
uint16_t crc16(volatile uint8_t *ptrToArray,uint8_t inputSize) //A standard CRC algorithm
{
	uint16_t out=0xffff;
	uint16_t carry;
	unsigned char n;
	inputSize++;
	for (int l=0; l<inputSize; l++) {
		out ^= ptrToArray[l];
		for (n = 0; n < 8; n++) {
			carry = out & 1;
			out >>= 1;
			if (carry) out ^= 0xA001;
		}
	}
	//out=0x1234;
	if ((ptrToArray[inputSize]==out%256) && (ptrToArray[inputSize+1]==out/256)) //check
	{
		return 1;
	} else { 
		ptrToArray[inputSize]=out%256; //append Lo
		ptrToArray[inputSize+1]=out/256; //append Hi
		return 0;	
	}
}

/* @brief: copies a single or multiple words from one array of bytes to another array of bytes
*          amount must not be bigger than 255...
*
*/
void listRegisterCopy(volatile uint8_t *source, volatile uint8_t *target, uint8_t amount) {
	for (uint8_t c=0; c<amount; c++)
	{
		*(target+c)=*(source+c);
	}
}

/* @brief: copies a single bit from one char to another char (or arrays thereof)
*
*
*/
void listBitCopy(volatile uint8_t *source, uint16_t sourceNr,volatile uint8_t *target, uint16_t targetNr) {
	if(*(source+(sourceNr/8))&(1<<(sourceNr-((sourceNr/8)*8))))
	{
		*(target+(targetNr/8))|=(1<<(targetNr-((targetNr/8)*8)));
	} else *(target+(targetNr/8))&=~(1<<(targetNr-((targetNr/8)*8)));
}

void modbusReset(void) {
	BusState=(1<<TimerActive); //stop receiving (error)
	modbusTimer=0;
}

void modbusTickTimer(void) {
	if (BusState&(1<<TimerActive)) {
		modbusTimer++;
		if (BusState&(1<<Receiving)) //we are in receiving mode
		{
			if ((modbusTimer==modbusInterCharTimeout)) {
				BusState|=(1<<GapDetected);
			} else if ((modbusTimer==modbusInterFrameDelayReceiveEnd)) { //end of message
				#if ADDRESS_MODE == MULTIPLE_ADR
                if (crc16(rxbuffer,DataPos-3)) { //perform crc check only. This is for multiple/all address mode.
	                BusState=(1<<ReceiveCompleted);
                } else modbusReset();
				#endif
				#if ADDRESS_MODE == SINGLE_ADR
				if (rxbuffer[0]==Address && crc16(rxbuffer,DataPos-3)) { //is the message for us? => perform crc check
					BusState=(1<<ReceiveCompleted);
				} else modbusReset();
				#endif
				
			}	
		} else if (modbusTimer==modbusInterFrameDelayReceiveStart) BusState|=(1<<BusTimedOut);
	}
}
#ifdef USE_MODBUS
ISR(UART_RECEIVE_INTERRUPT) {
	unsigned char data;
	data = UART_DATA;
	modbusTimer=0; //reset timer
	if (!(BusState & (1<<ReceiveCompleted)) && !(BusState & (1<<TransmitRequested)) && !(BusState & (1<<Transmitting)) && (BusState & (1<<Receiving)) && !(BusState & (1<<BusTimedOut))) { // // 
		if (DataPos>MaxFrameIndex) modbusReset();
	    else {
			rxbuffer[DataPos]=data;
			DataPos++; //TODO: maybe prevent this from exceeding 255?
		}	    
    } else if (!(BusState & (1<<ReceiveCompleted)) && !(BusState & (1<<TransmitRequested)) && !(BusState & (1<<Transmitting)) && !(BusState & (1<<Receiving)) && (BusState & (1<<BusTimedOut))) { //) {
			 rxbuffer[0]=data;
			 BusState=((1<<Receiving)|(1<<TimerActive));
			 DataPos=1;
    }
}

ISR(UART_TRANSMIT_INTERRUPT) {
	BusState&=~(1<<TransmitRequested);
	BusState|=(1<<Transmitting);
	UART_DATA=rxbuffer[DataPos];
	DataPos++;
	if (DataPos==(PacketTopIndex+1)) {
		UART_CONTROL&=~(1<<UART_UDRIE);
	}
}

ISR(UART_TRANSMIT_COMPLETE_INTERRUPT) { //Sobald Stopbit übertragen wurde RS485-Transceiver wieder auf empfangen umstellen
	#if PHYSICAL_TYPE == 485
	transceiver_rxen();
	#endif
	modbusReset();
}
#endif
void modbusInit(void)
{
	//UBRRH = (unsigned char)(Baud>>8);
	//UBRRL = (unsigned char)Baud;
	//UART_CONTROL = (1<<RXCIE)|(1<<RXEN)|(1<<TXEN); // USART receiver and transmitter and receive complete interrupt
	//UART_STATUS |= (1<<U2X); //double speed mode. 
	//UCSRC = (3<<UCSZ0); //Frame Size
	//UART_CONTROL|=(1<<TXCIE); //Transmit Complete Interrupt an
	#if PHYSICAL_TYPE == 485
	TRANSCEIVER_ENABLE_PORT_DDR|=(1<<TRANSCEIVER_ENABLE_PIN);
	transceiver_rxen();
	#endif
	BusState=(1<<TimerActive);
}

/* @brief: Sends a response.
*
*         Arguments: - packtop: Position of the last byte containing data.
*                               modbusSendException is a good usage example.
*/
void modbusSendMessage(unsigned char packtop) {
	PacketTopIndex=packtop+2; //diff: +2
	crc16(rxbuffer,packtop); //diff: alt: -1, neu +1
	BusState|=(1<<TransmitRequested);
	DataPos=0;
	#if PHYSICAL_TYPE == 485
	transceiver_txen();
	#endif
	UART_CONTROL|=(1<<UART_UDRIE);
	BusState&=~(1<<ReceiveCompleted);
}

void modbusSendException(unsigned char exceptionCode) {
	rxbuffer[1]|=(1<<7); //setting MSB of the function code (the exception flag)
	rxbuffer[2]=exceptionCode; //Exceptioncode. Also the last byte containing data
	modbusSendMessage(2);
}

uint16_t modbusRequestedAmount(void) {
	return (rxbuffer[5]|(rxbuffer[4]<<8));
}

uint16_t modbusRequestedAddress(void) {
	return (rxbuffer[3]|(rxbuffer[2]<<8));
}

/* @brief: copies a single or multiple bytes from one array of bytes to an array of 16-bit-words
*          
*
*/
void intToModbusRegister(volatile uint16_t *inreg, volatile uint8_t *outreg, uint8_t amount) {
	for (uint8_t c=0; c<amount; c++)
	{	
			*(outreg+c*2) = (uint8_t)(*(inreg+c) >> 8);
			*(outreg+1+c*2) = (uint8_t)(*(inreg+c));
	}
}

/* @brief: copies a single or multiple 16-bit-words from one array of integers to an array of bytes
*
*
*/
void modbusRegisterToInt(volatile uint8_t *inreg, volatile uint16_t *outreg, uint8_t amount) {
	for (uint8_t c=0; c<amount; c++)
	{
		*(outreg+c) = (*(inreg+c*2) << 8) + *(inreg+1+c*2);
	}
}

/* @brief: Handles single/multiple register reading and single/multiple register writing.
*
*         Arguments: - ptrToInArray: pointer to the user's data array containing registers
*                    - startAddress: address of the first register in the supplied array
*                    - size: input array size in the requested format (16bit-registers)
*
*/
uint8_t modbusExchangeRegisters(volatile uint16_t *ptrToInArray, uint16_t startAddress, uint16_t size) {
	uint16_t requestedAmount = modbusRequestedAmount();
	uint16_t requestedAdr = modbusRequestedAddress();
	if (rxbuffer[1]==fcPresetSingleRegister) requestedAmount=1;
	if ((requestedAdr>=startAddress) && ((startAddress+size)>=(requestedAmount+requestedAdr))) {
		
		if ((rxbuffer[1]==fcReadHoldingRegisters) || (rxbuffer[1]==fcReadInputRegisters) )
		{
			if ((requestedAmount*2)<=(MaxFrameIndex-4)) //message buffer big enough?
			{
				rxbuffer[2]=(unsigned char)(requestedAmount*2);
				intToModbusRegister(ptrToInArray+(unsigned char)(requestedAdr-startAddress),rxbuffer+3,rxbuffer[2]);
				modbusSendMessage(2+rxbuffer[2]);
				return 1;
			} else modbusSendException(ecIllegalDataValue);
		}
		else if (rxbuffer[1]==fcPresetMultipleRegisters)
		{
			if (((rxbuffer[6]*2)>=requestedAmount) && ((DataPos-9)==rxbuffer[6])) //enough data received?
			{
				modbusRegisterToInt(rxbuffer+7,ptrToInArray+(unsigned char)(requestedAdr-startAddress),(unsigned char)(requestedAmount));
				modbusSendMessage(5);
				return 1;
			} else modbusSendException(ecIllegalDataValue);//too few data bytes received
		}
		else if (rxbuffer[1]==fcPresetSingleRegister)
		{
			modbusRegisterToInt(rxbuffer+4,ptrToInArray+(unsigned char)(requestedAdr-startAddress),1);
			modbusSendMessage(5);
			return 1;
		} 
		//modbusSendException(ecSlaveDeviceFailure); //inanpropriate call of modbusExchangeRegisters
		return 0;
		} else {
		modbusSendException(ecIllegalDataValue);
		return 0;
	}
}

/* @brief: Handles single/multiple input/coil reading and single/multiple coil writing.
*
*         Arguments: - ptrToInArray: pointer to the user's data array containing bits
*                    - startAddress: address of the first bit in the supplied array
*                    - size: input array size in the requested format (bits)
*
*/
uint8_t modbusExchangeBits(volatile uint8_t *ptrToInArray, uint16_t startAddress, uint16_t size) {
	uint16_t requestedAmount = modbusRequestedAmount();
	uint16_t requestedAdr = modbusRequestedAddress();
	if (rxbuffer[1]==fcForceSingleCoil) requestedAmount=1;
	if ((requestedAdr>=startAddress) && ((startAddress+size)>=(requestedAmount+requestedAdr))) {
		if ((rxbuffer[1]==fcReadInputStatus) || (rxbuffer[1]==fcReadCoilStatus))
		{
			if (requestedAmount<=((MaxFrameIndex-4)*8)) //message buffer big enough?
			{
				rxbuffer[2]=(requestedAmount/8);
				if (requestedAmount%8>0)
				{
					rxbuffer[(uint8_t)(requestedAmount/8)+3]=0x00; //fill last data byte with zeros
					rxbuffer[2]++;
				}
				for (uint16_t c = 0; c<requestedAmount; c++)
				{
					listBitCopy(ptrToInArray,requestedAdr-startAddress+c,rxbuffer+3,c);
				}
				modbusSendMessage(rxbuffer[2]+2);
				return 1;
			} else modbusSendException(ecIllegalDataValue); //too many bits requested within single request
		}
		else if (rxbuffer[1]==fcForceMultipleCoils)
		{
			if (((rxbuffer[6]*8)>=requestedAmount) && ((DataPos-9)==rxbuffer[6])) //enough data received?
			{
				for (uint16_t c = 0; c<requestedAmount; c++)
				{
					listBitCopy(rxbuffer+7,c,ptrToInArray,requestedAdr-startAddress+c);
				}
				modbusSendMessage(5);
				return 1;
			} else modbusSendException(ecIllegalDataValue);//exception too few data bytes received
		}
		else if (rxbuffer[1]==fcForceSingleCoil) {
			listBitCopy(rxbuffer+4,0,ptrToInArray,requestedAdr-startAddress);
			modbusSendMessage(5); 
			return 1;
		}
		//modbusSendException(ecSlaveDeviceFailure); //inanpropriate call of modbusExchangeBits
		return 0;
	} else {
		modbusSendException(ecIllegalDataValue);
		return 0;
	}
}

void modbusGet(void) {
	if (modbusGetBusState() & (1<<ReceiveCompleted))
	{
		switch(rxbuffer[1])
		{
			case fcReadCoilStatus:
			modbusExchangeBits(&outstate,0,8);
			break;
			case fcReadInputStatus:
			//volatile uint8_t inps = 0x69;
			modbusExchangeBits(&instate,0,8);
			break;
			case fcReadHoldingRegisters:
			modbusExchangeRegisters(holdingRegisters,(rxbuffer[2]>>8)+rxbuffer[3],(rxbuffer[4]>>8)+rxbuffer[5]);
			break;
			case fcReadInputRegisters:
			modbusExchangeRegisters(inputRegisters,(rxbuffer[2]>>8)+rxbuffer[3],(rxbuffer[4]>>8)+rxbuffer[5]);
			break;
			case fcForceSingleCoil:
			modbusExchangeBits(&outstate,0,8);
			//SetOuts(outstate);
			break;
			case fcPresetSingleRegister:
			modbusExchangeRegisters(inputRegisters,(rxbuffer[2]>>8)+rxbuffer[3],(rxbuffer[4]>>8)+rxbuffer[5]);
			// 				jbus_remote_signal = inputRegisters[0] & 0x0007;
			
			Multiwire_MODBUS_Mode = (inputRegisters[2] & 0x0007);
			if (Multiwire_MODBUS_Mode==MODBUSMODE)
			{
				BrightnessLevel = (inputRegisters[0] & 0x0007);
				TypeOfLamp = (inputRegisters[1] & 0x0007);
			}
			
			// 				jbus_remote_circuit_select = inputRegisters[0] >>3;
			break;
			case fcForceMultipleCoils:
			modbusExchangeBits(&outstate,0,8);
			//SetOuts(outstate);
			break;
			case fcPresetMultipleRegisters:
			modbusExchangeRegisters(inputRegisters,(rxbuffer[2]>>8)+rxbuffer[3],(rxbuffer[4]>>8)+rxbuffer[5]);
			// 				jbus_remote_signal = inputRegisters[0] & 0x0007;
			
			Multiwire_MODBUS_Mode = (inputRegisters[2] & 0x0007);
			if (Multiwire_MODBUS_Mode==MODBUSMODE)
			{
				BrightnessLevel = (inputRegisters[0] & 0x0007);
				TypeOfLamp = (inputRegisters[1] & 0x0007);
			}
			
			// 				jbus_remote_circuit_select = inputRegisters[0] >>3;
			break;
			default:
			modbusSendException(ecIllegalFunction);
			break;
		}
	}
}
