ngoquytuan/DenDaChien/Code/PL_REMOTE/PL_REMOTE/Timming.h

#ifndef _TIMMING_H_
#define _TIMMING_H_

#include <avr/io.h>
#include <avr/interrupt.h>
#include <avr/wdt.h>

#include "Const.h"

extern volatile unsigned char flag_1Hz, flag_1kHz, flag_10Hz, flag_100Hz;
extern volatile unsigned char button_pressed;
extern volatile unsigned char screen_timeout;

void initTimer0(void);
// void initTimer1(void);
void initTimer2(void);
// void initInterrupt(void);

#endif 
