ngoquytuan/DenDaChien/(commit log)

2018-11-05 Tai lieu goc tu a Son
    Tai len lan dau
    [15V2A.PCB, 15V2A_Old.PCB, ALCS_REMOTE v2.PcbDoc, ALCS_REMOTE v2.SchDoc, Battery Chager x3.PrjPcb, Battery Chager x3.SchDoc, BlockDiagram.SchDoc, Calib.xlsx]
2019-09-18 Bo ho so den da chien cuoi
    [15V2A.PCB, 15V2A_Old.PCB, 20181106 TL den da chien.xlsx, 20190214 TL Xe nguon.xls, ALCS_REMOTE v2.PcbDoc, ALCS_REMOTE v2.SchDoc, Battery Chager x3.PrjPcb, Battery Chager x3.SchDoc]
